PyCubed-Mini/OpenMV_Camera/Software/images/Calibration/Calibrated Pics/Space Shuttle.jpg

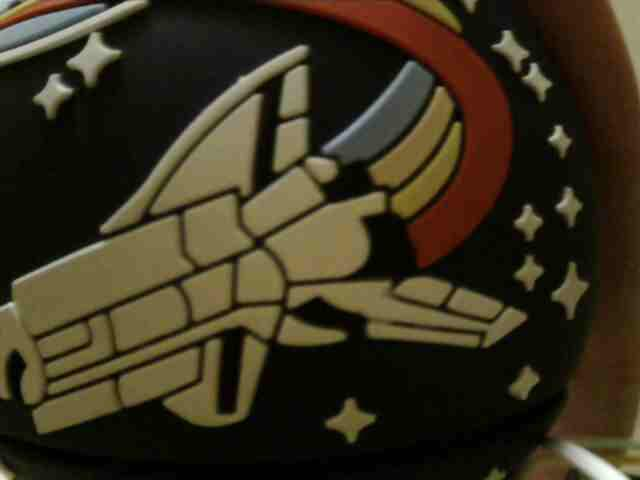
Software/images/Calibration/Calibrated Pics/Space Shuttle.jpg
