PyCubed-Mini/OpenMV_Camera/Software/images/Calibration/VGA Snapshots/True Calibration/+3.jpg

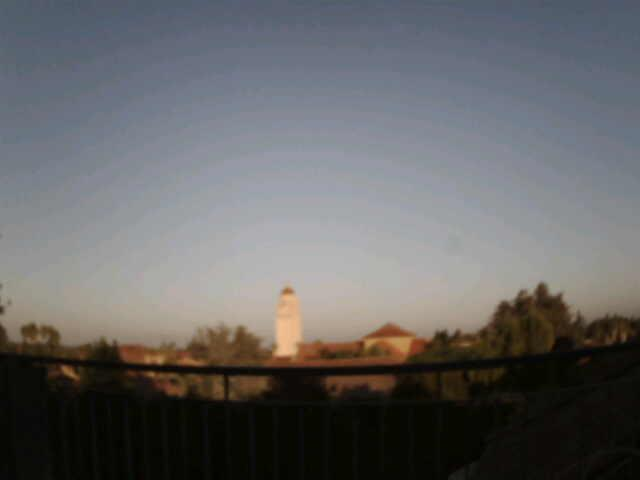
Software/images/Calibration/VGA Snapshots/True Calibration/+3.jpg
