PyCubed-Mini/OpenMV_Camera/README.md

# OpenMV_Camera
Modified version of the OpenMV camera module

The most recent board files are in [!OpenMV_Master_Design/openmv4_cam_v3](https://github.com/PyCubed-Mini/OpenMV_Camera/tree/master/!OpenMV_Master_Design/openmv4_cam_v3)
