PyCubed-Mini/OpenMV_Camera/Software/Electrical Configuration/README.txt

This folder contains images that should be helpful for replicating the electrical configuration used to connect the OpenMV camera, the Feather M4 Express MCU, and the mSD card breakout board.
