PyCubed-Mini/OpenMV_Camera/Software/trinket_m0_backup/README.txt

This is a backup of the default Trinket M0 software package,
to be used if the board needs to be reset.
