PyCubed-Mini/OpenMV_Camera/Software/images/Time Delay Trade/README.txt

The camera is one of the most power-hungry elements of the Qube.  In that regard, it would be ideal to minimize the amount of time for which it is active.  However, the camera requires time to prepare to take an image ("open its eyes") and to process the image.  Several trade studies must be conducted to find the optimal amount of time the camera should be on while still being able to take and process high-quality images.
