PyCubed-Mini/OpenMV_Camera/Software/images/Less Important Studies/Focus Play/README.txt

This folder contains some preliminary focus experiments.  In these, the camera focus is adjusted manually to extreme and average positions to help the user acquire a "feel" for the camera focus.
