PyCubed-Mini/OpenMV_Camera/MV3 vs MV4/MV3_diff.PNG

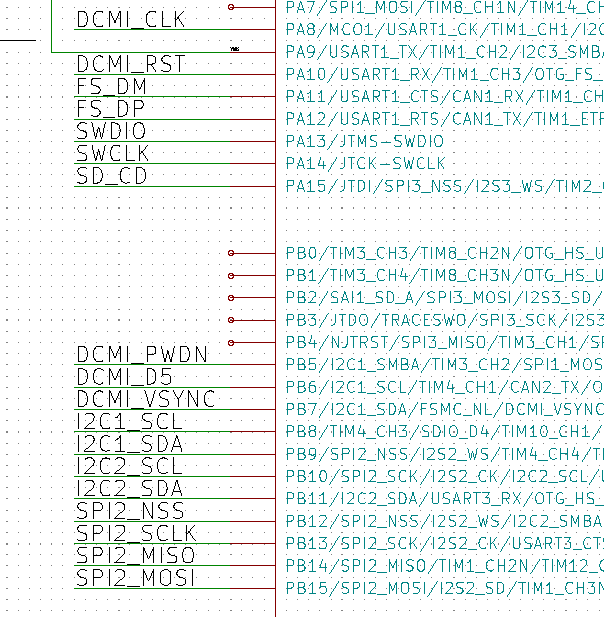
MV3 vs MV4/MV3_diff.PNG
