PyCubed-Mini/OpenMV_Camera/MV3 vs MV4/MV3_sensor_schem.PNG

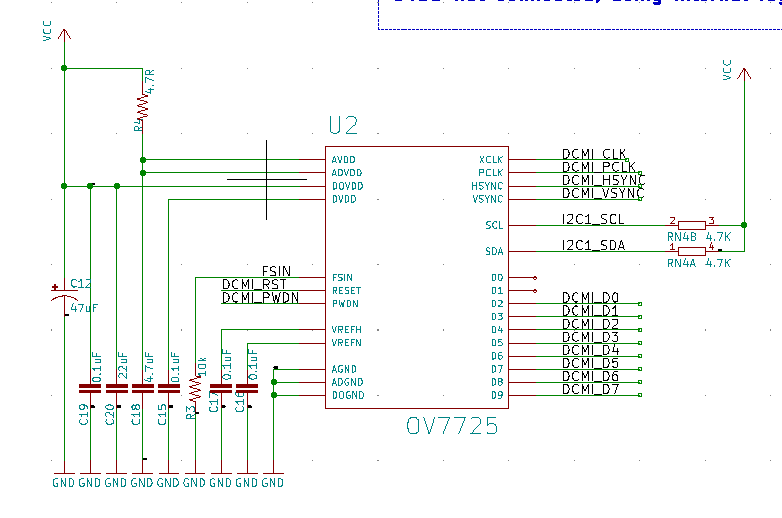
MV3 vs MV4/MV3_sensor_schem.PNG
