PyCubed-Mini/OpenMV_Camera/MV3 vs MV4/MV4_sensor_connector.PNG

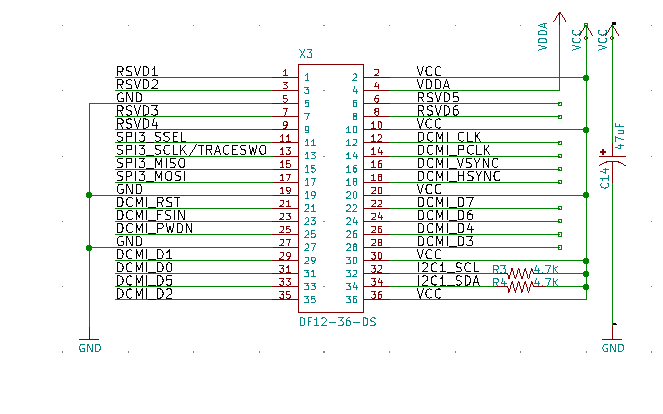
MV3 vs MV4/MV4_sensor_connector.PNG
