PyCubed-Mini/OpenMV_Camera/Software/Electrical Configuration/20191205_142945.jpg

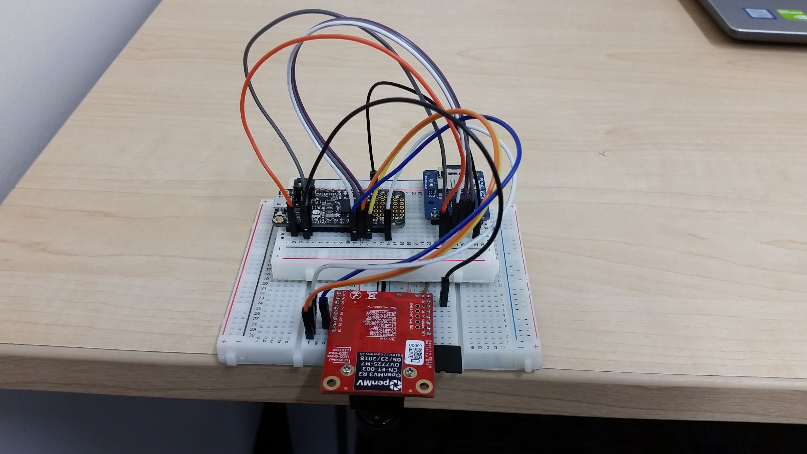
Software/Electrical Configuration/20191205_142945.jpg
