PyCubed-Mini/OpenMV_Camera/Software/Electrical Configuration/20191205_143001.jpg

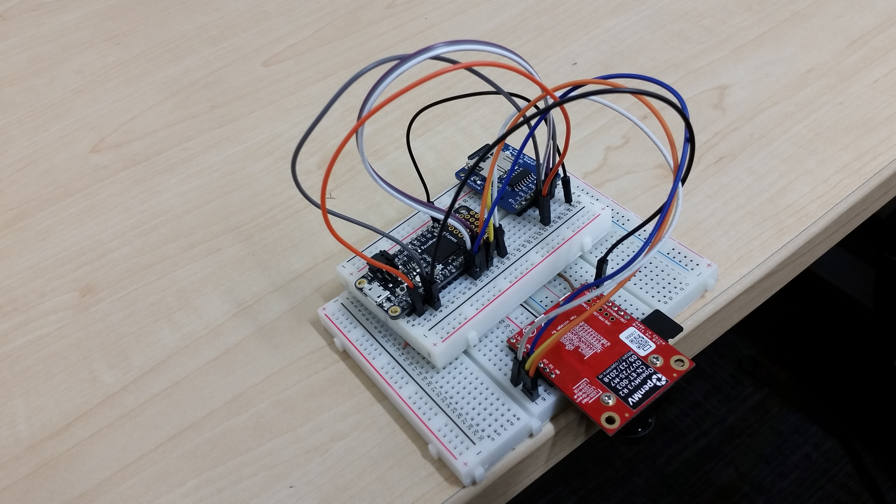
Software/Electrical Configuration/20191205_143001.jpg
