PyCubed-Mini/OpenMV_Camera/Software/Electrical Configuration/20191205_143034.jpg

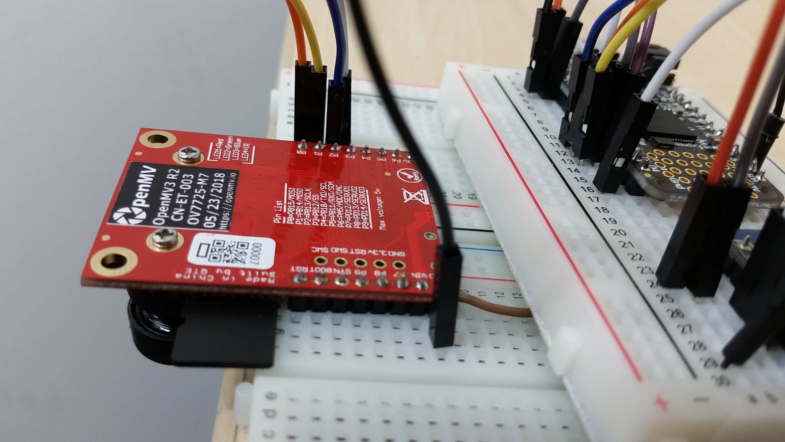
Software/Electrical Configuration/20191205_143034.jpg
