PyCubed-Mini/OpenMV_Camera/Software/Electrical Configuration/20191205_143103.jpg

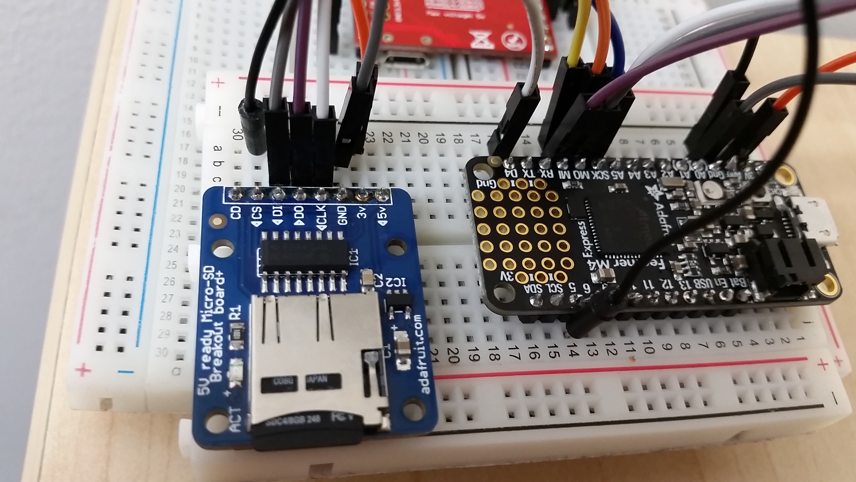
Software/Electrical Configuration/20191205_143103.jpg
