PyCubed-Mini/OpenMV_Camera/Software/image_compression_svd/picture_out_compression30_telephoto_1.jpeg

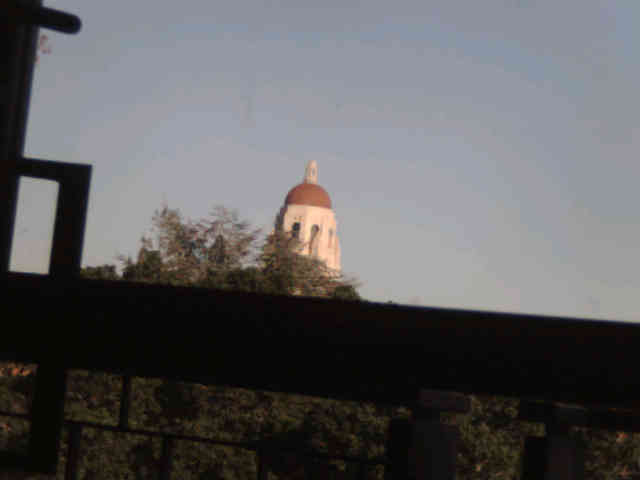
Software/image_compression_svd/picture_out_compression30_telephoto_1.jpeg
