PyCubed-Mini/OpenMV_Camera/Software/images/camera_lens_comparison/standard_lens/picture_out_compression30_standard_1.png

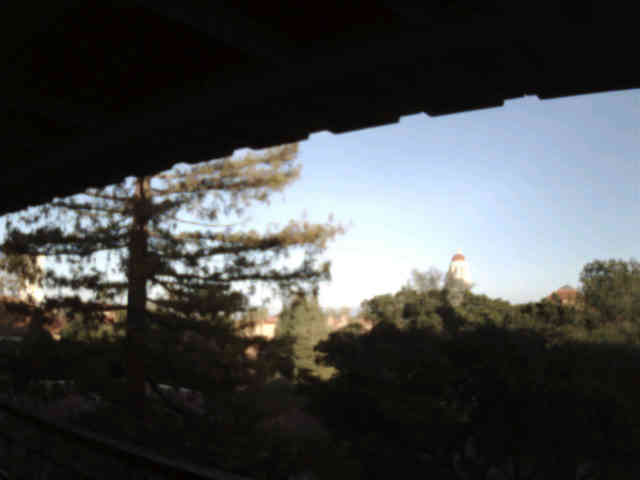
Software/images/camera_lens_comparison/standard_lens/picture_out_compression30_standard_1.png
