PyCubed-Mini/OpenMV_Camera/Software/images/camera_lens_comparison/telephoto_lens/picture_out_compression70_telephoto_2.png

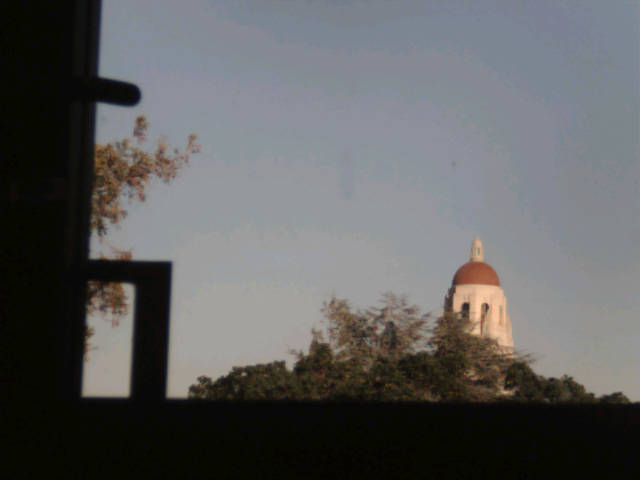
Software/images/camera_lens_comparison/telephoto_lens/picture_out_compression70_telephoto_2.png
