PyCubed-Mini/OpenMV_Camera/Software/images/Compression Trade/Compression Trade 3 (Main)/quality_90.jpg

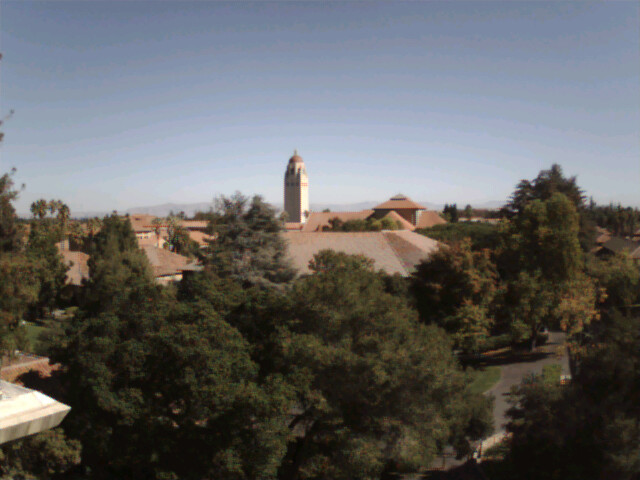
Software/images/Compression Trade/Compression Trade 3 (Main)/quality_90.jpg
