PyCubed-Mini/OpenMV_Camera/Software/images/Compression Trade/Compression Trade 4/quality_25.jpg

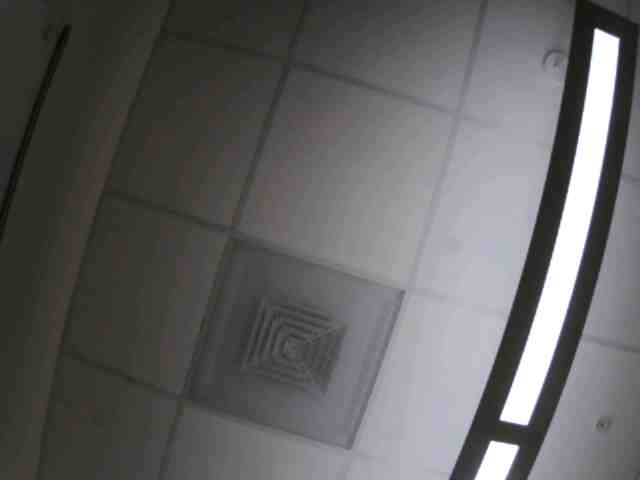
Software/images/Compression Trade/Compression Trade 4/quality_25.jpg
