PyCubed-Mini/OpenMV_Camera/Software/images/focustesting/picture_2.png

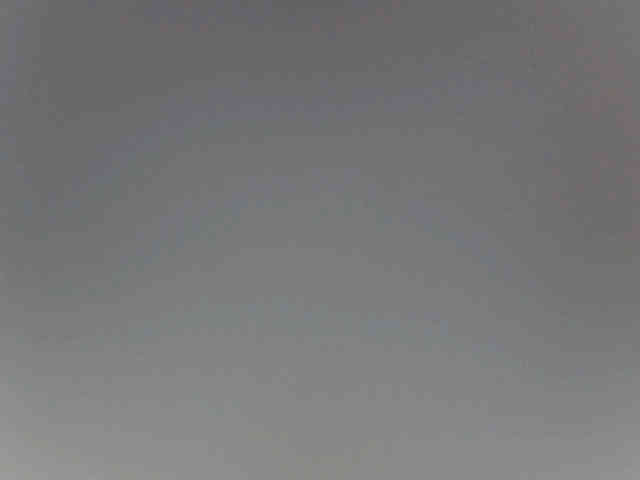
Software/images/focustesting/picture_2.png
