PyCubed-Mini/OpenMV_Camera/Software/images/focustesting/picture_3.png

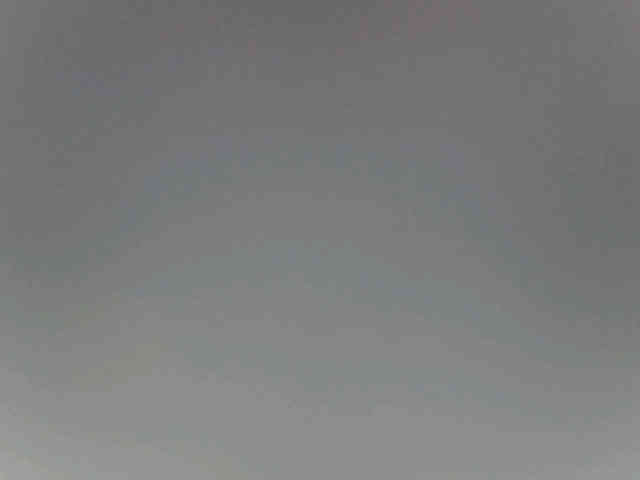
Software/images/focustesting/picture_3.png
