PyCubed-Mini/OpenMV_Camera/Software/images/focustesting/picture_4.png

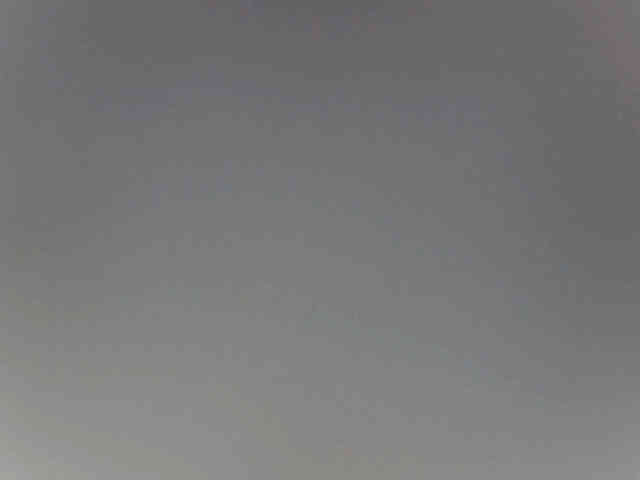
Software/images/focustesting/picture_4.png
