PyCubed-Mini/OpenMV_Camera/Software/images/focustesting/picture_5.png

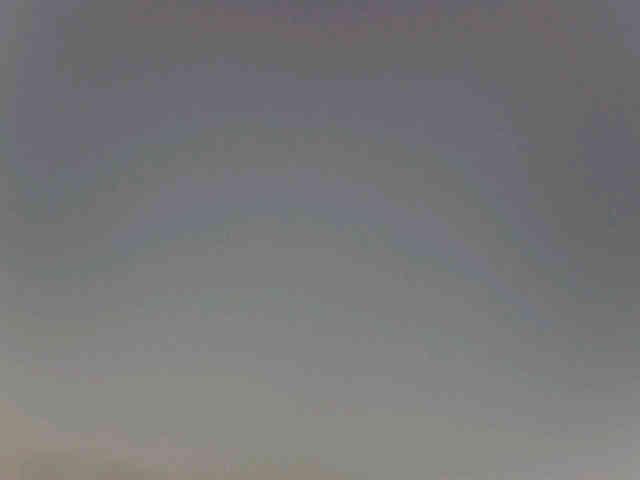
Software/images/focustesting/picture_5.png
