PyCubed-Mini/OpenMV_Camera/Software/images/focustesting/picture_6.png

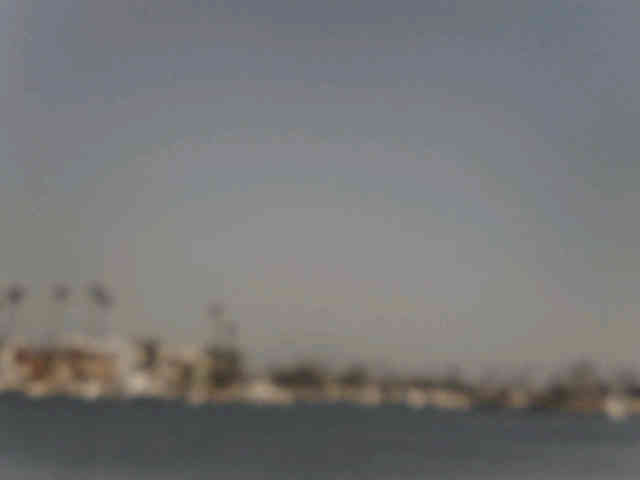
Software/images/focustesting/picture_6.png
