PyCubed-Mini/OpenMV_Camera/Software/images/focustesting/picture_7.png

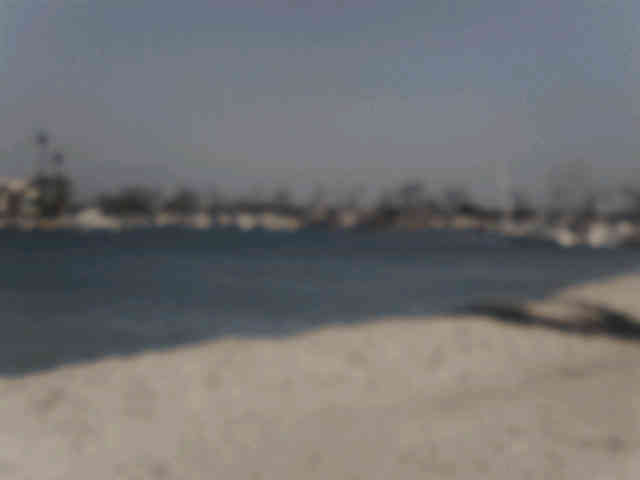
Software/images/focustesting/picture_7.png
