PyCubed-Mini/OpenMV_Camera/Software/images/focustesting/picture_9.png

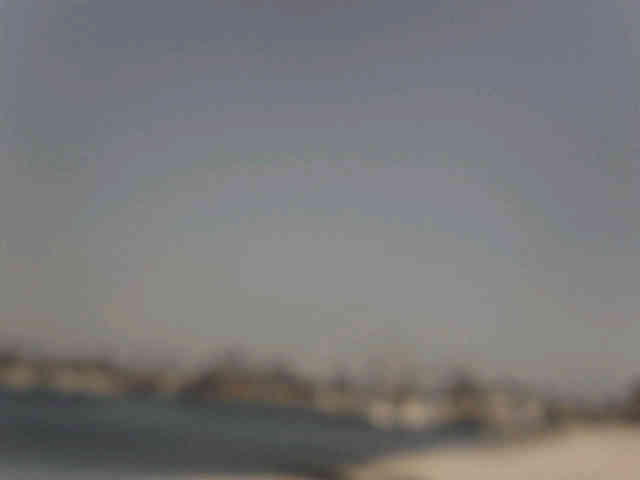
Software/images/focustesting/picture_9.png
