PyCubed-Mini/OpenMV_Camera/Software/images/focustesting/picture_10.png

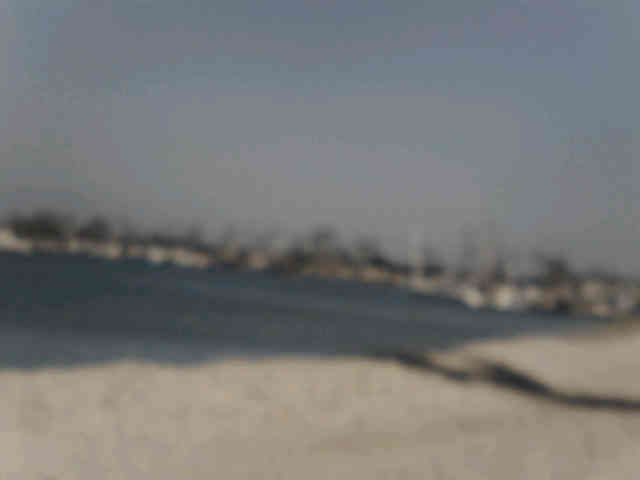
Software/images/focustesting/picture_10.png
