PyCubed-Mini/OpenMV_Camera/Software/images/focustesting/picture_11.png

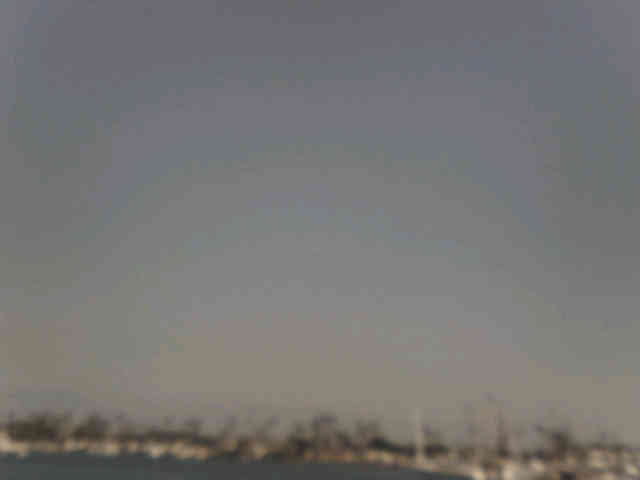
Software/images/focustesting/picture_11.png
