PyCubed-Mini/OpenMV_Camera/Software/images/focustesting/picture_13.png

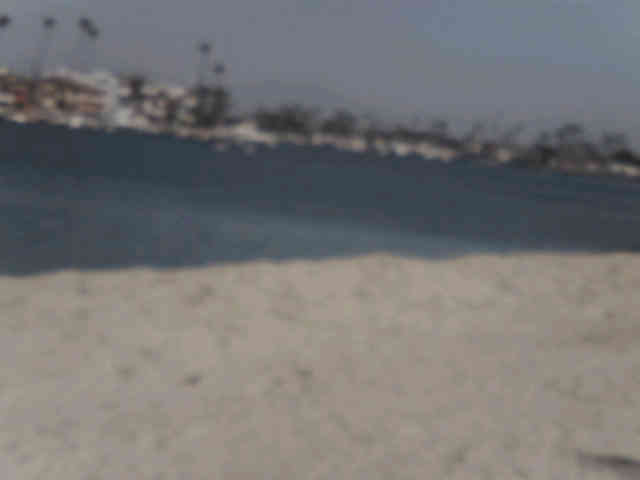
Software/images/focustesting/picture_13.png
