PyCubed-Mini/OpenMV_Camera/Software/images/focustesting/picture_14.png

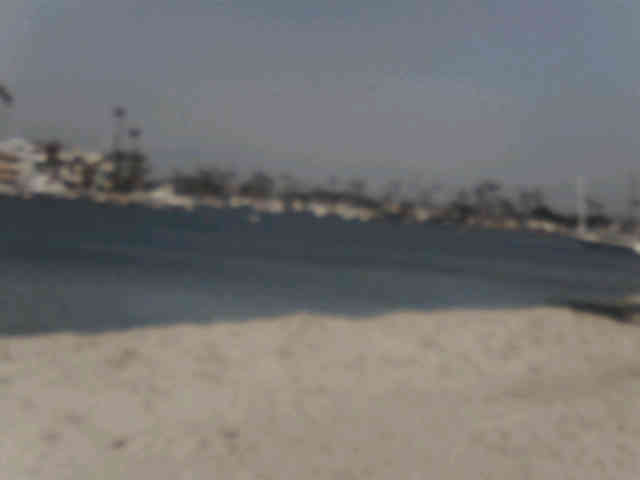
Software/images/focustesting/picture_14.png
