PyCubed-Mini/OpenMV_Camera/Software/images/focustesting/picture_15.png

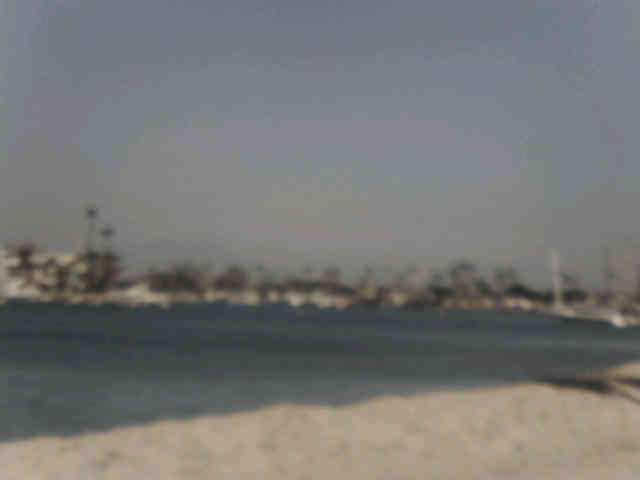
Software/images/focustesting/picture_15.png
