PyCubed-Mini/OpenMV_Camera/Software/images/focustesting/picture_16.png

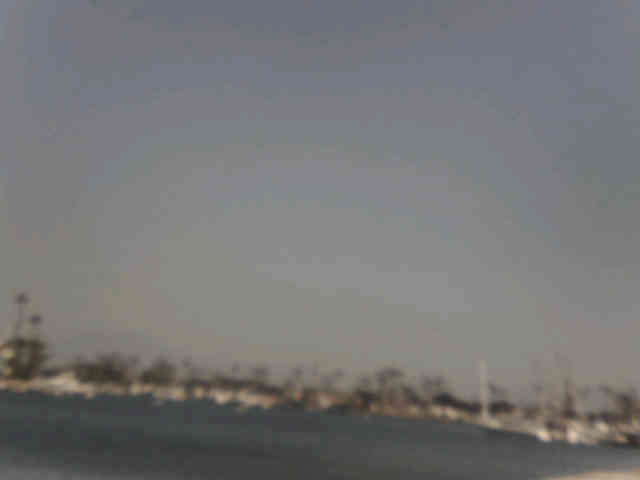
Software/images/focustesting/picture_16.png
