PyCubed-Mini/OpenMV_Camera/Software/images/focustesting/picture_17.png

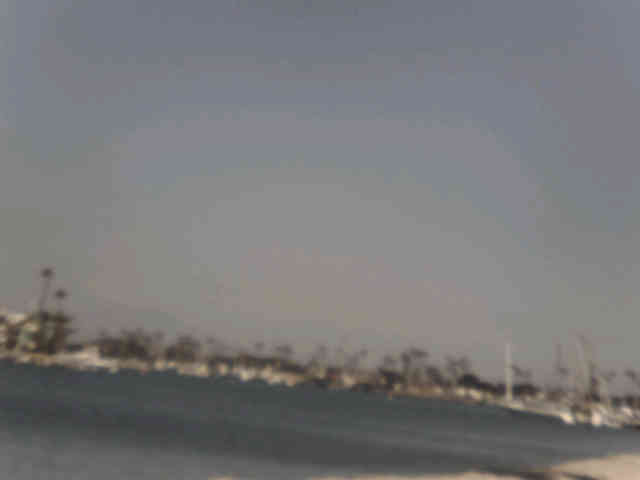
Software/images/focustesting/picture_17.png
