PyCubed-Mini/OpenMV_Camera/Software/images/focustesting/picture_18.png

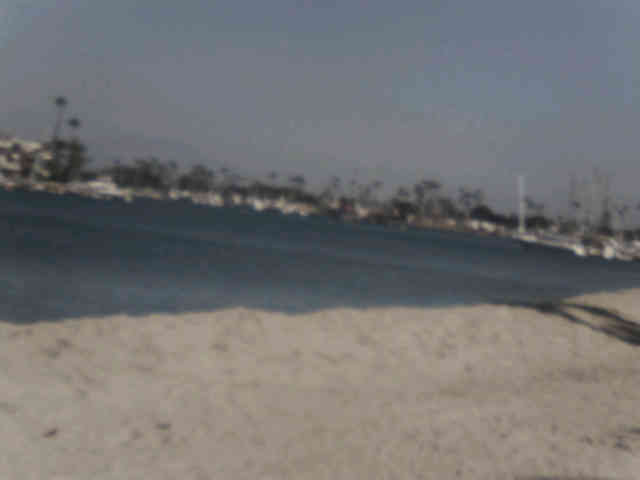
Software/images/focustesting/picture_18.png
