PyCubed-Mini/OpenMV_Camera/Software/images/focustesting/picture_19.png

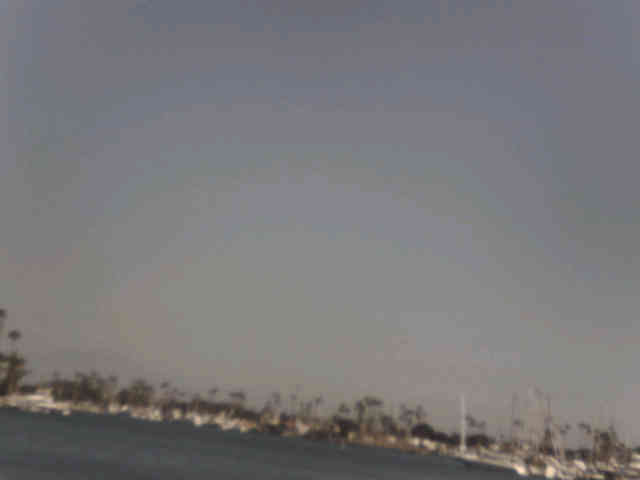
Software/images/focustesting/picture_19.png
