PyCubed-Mini/OpenMV_Camera/Software/images/focustesting/picture_20.png

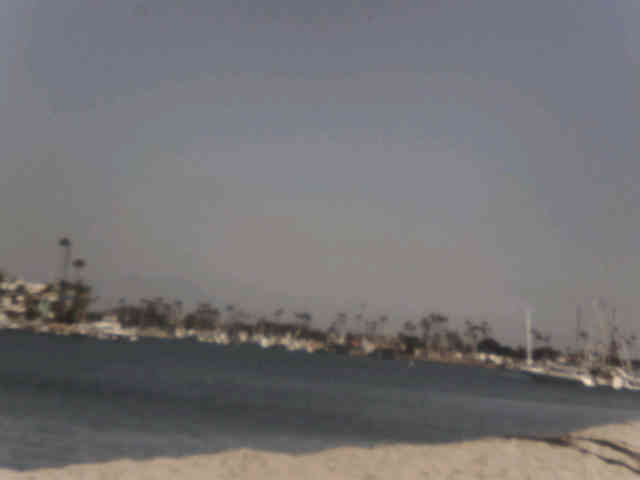
Software/images/focustesting/picture_20.png
