PyCubed-Mini/OpenMV_Camera/Software/images/focustesting/picture_21.png

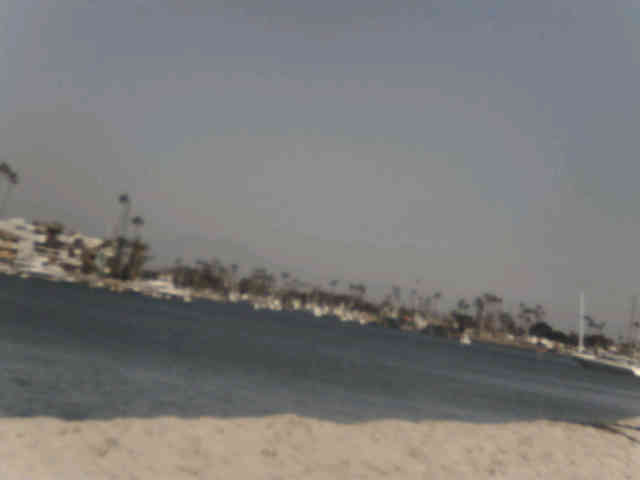
Software/images/focustesting/picture_21.png
