PyCubed-Mini/OpenMV_Camera/Software/images/focustesting/picture_22.png

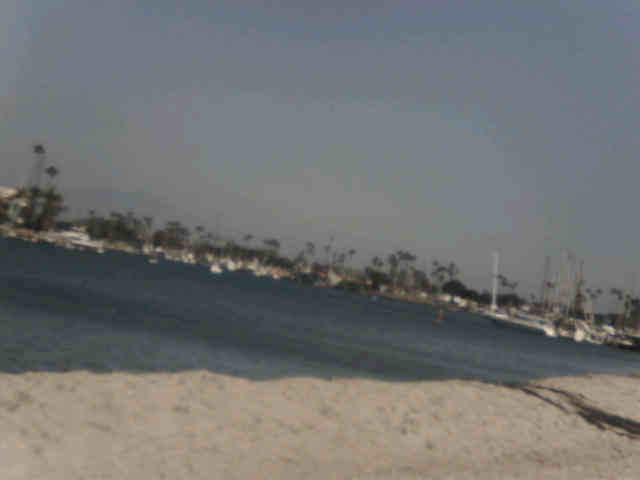
Software/images/focustesting/picture_22.png
