PyCubed-Mini/OpenMV_Camera/Software/images/focustesting/picture_23.png

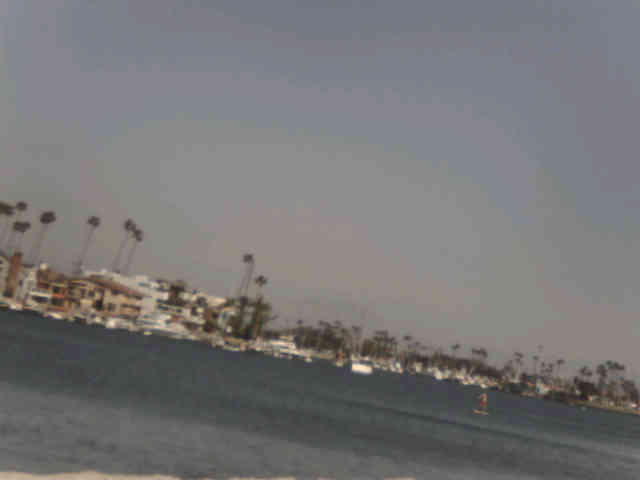
Software/images/focustesting/picture_23.png
