PyCubed-Mini/OpenMV_Camera/Software/images/focustesting/picture_24.png

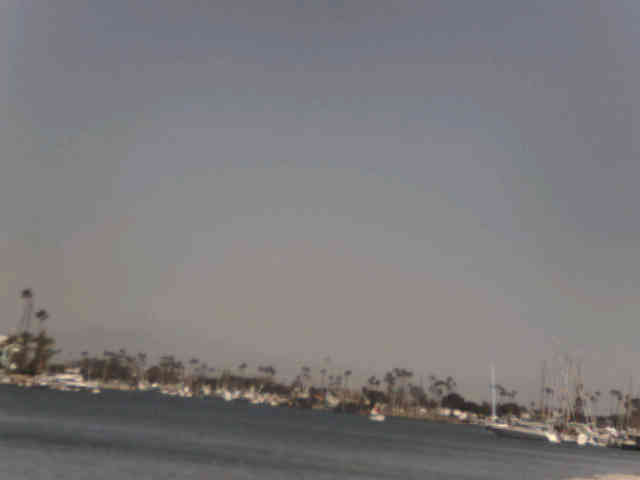
Software/images/focustesting/picture_24.png
