PyCubed-Mini/OpenMV_Camera/Software/images/focustesting/picture_25.png

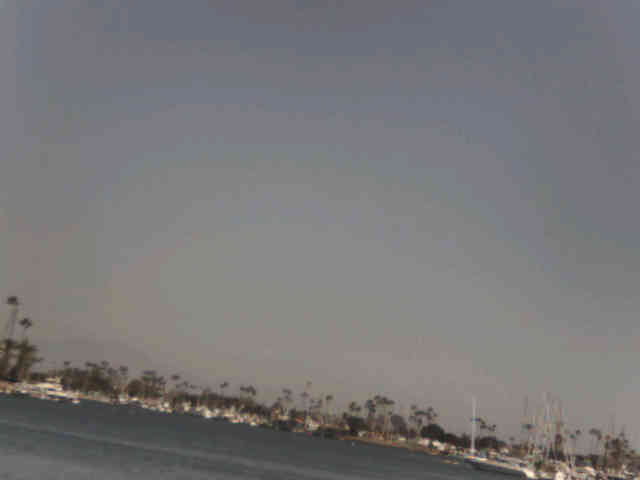
Software/images/focustesting/picture_25.png
