PyCubed-Mini/OpenMV_Camera/Software/images/focustesting/picture_26.png

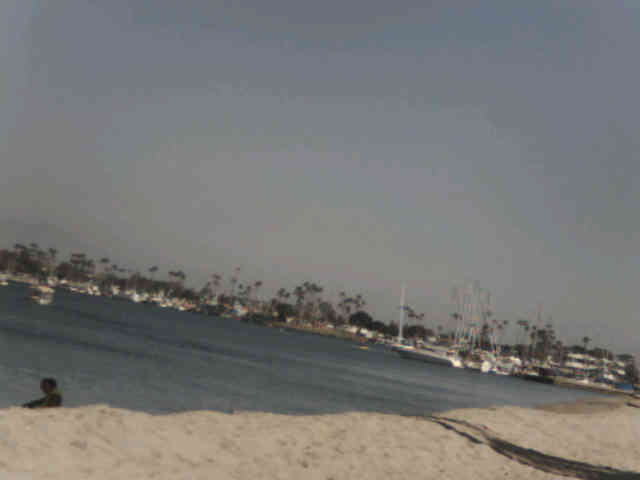
Software/images/focustesting/picture_26.png
