PyCubed-Mini/OpenMV_Camera/Software/images/focustesting/picture_27.png

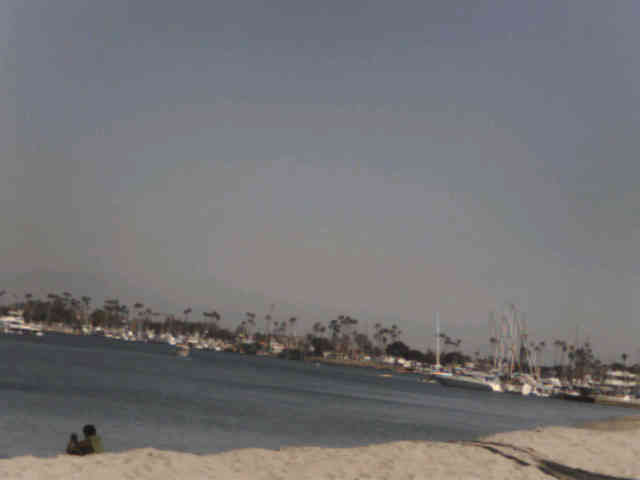
Software/images/focustesting/picture_27.png
