PyCubed-Mini/OpenMV_Camera/Software/images/focustesting/picture_28.png

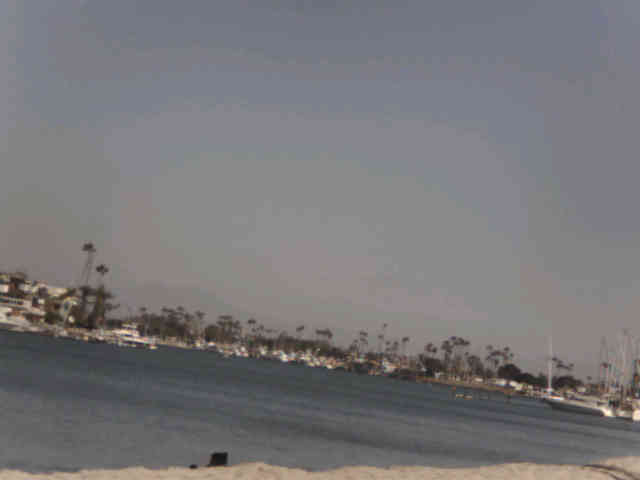
Software/images/focustesting/picture_28.png
