PyCubed-Mini/OpenMV_Camera/Software/images/focustesting/picture_29.png

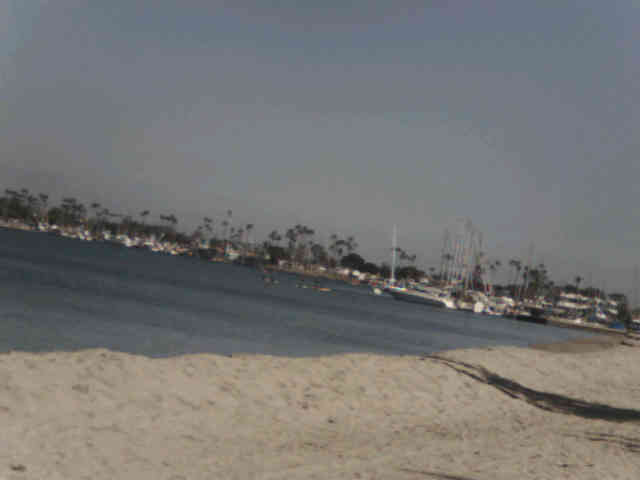
Software/images/focustesting/picture_29.png
