PyCubed-Mini/OpenMV_Camera/Software/images/focustesting/picture_30.png

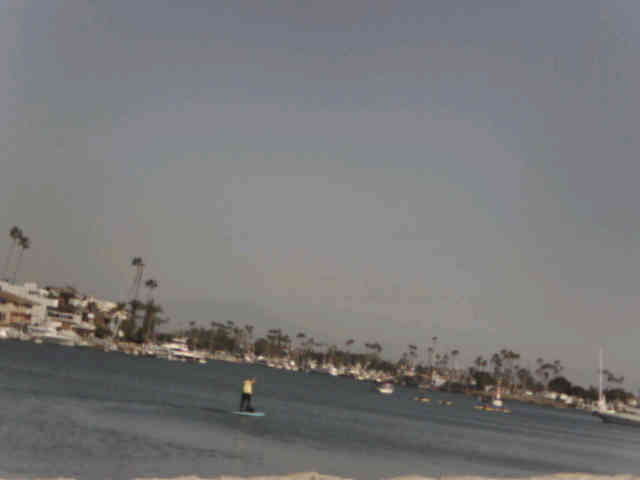
Software/images/focustesting/picture_30.png
