PyCubed-Mini/OpenMV_Camera/Software/images/focustesting/picture_31.png

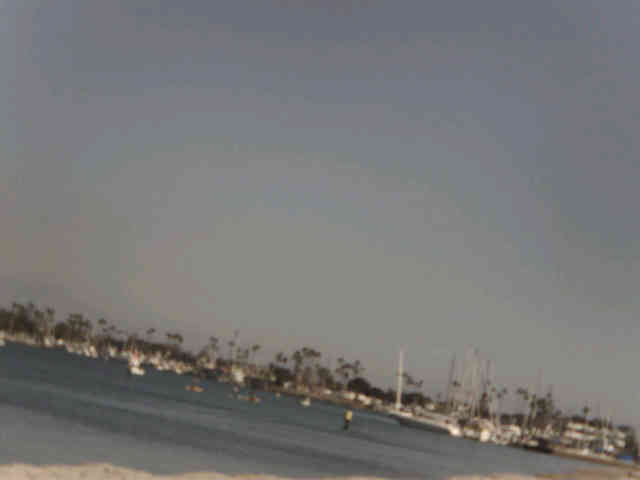
Software/images/focustesting/picture_31.png
