PyCubed-Mini/OpenMV_Camera/Software/images/Less Important Studies/Focus Play/All the way back.jpg

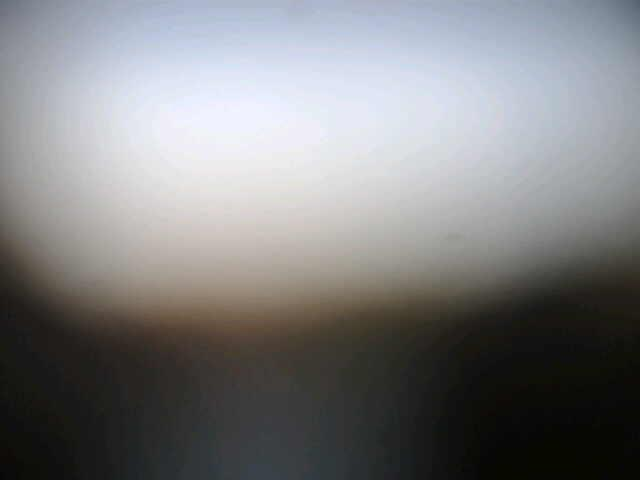
Software/images/Less Important Studies/Focus Play/All the way back.jpg
