PyCubed-Mini/OpenMV_Camera/Software/images/Less Important Studies/Focus Play/Max Focus.jpg

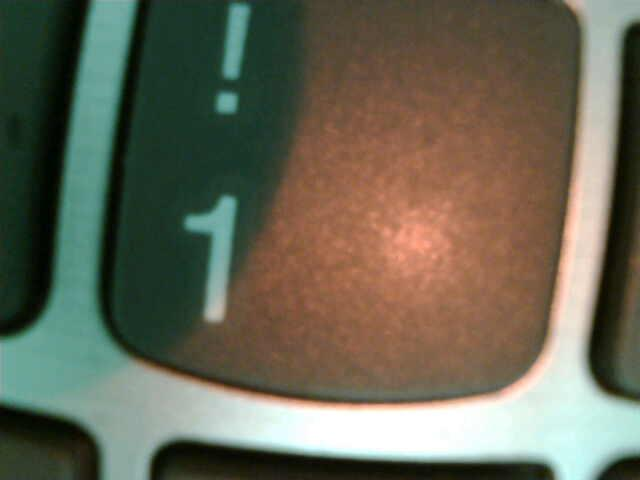
Software/images/Less Important Studies/Focus Play/Max Focus.jpg
