PyCubed-Mini/OpenMV_Camera/Software/images/Less Important Studies/Focus Play/Mid Focus.jpg

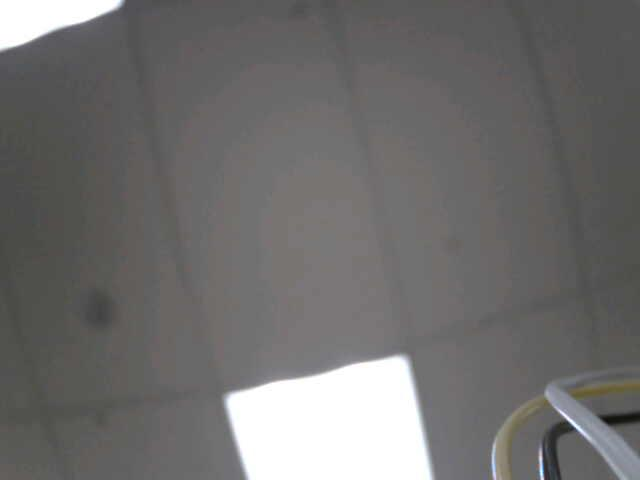
Software/images/Less Important Studies/Focus Play/Mid Focus.jpg
