PyCubed-Mini/OpenMV_Camera/Software/images/Less Important Studies/Focus Play/Min Focus.jpg

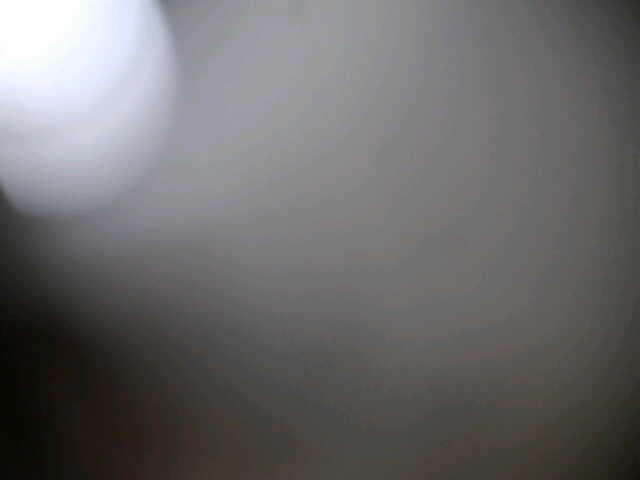
Software/images/Less Important Studies/Focus Play/Min Focus.jpg
