PyCubed-Mini/OpenMV_Camera/Software/images/Less Important Studies/QVGA Suffix Trade Study/QVGA_suffix.bmp

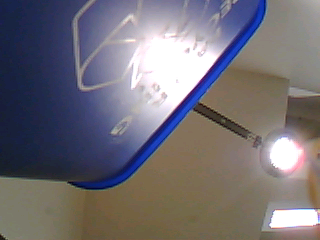
Software/images/Less Important Studies/QVGA Suffix Trade Study/QVGA_suffix.bmp
