PyCubed-Mini/OpenMV_Camera/Software/images/Time Delay Trade/Preparation Delay Trade/delay_0500_ms.jpg

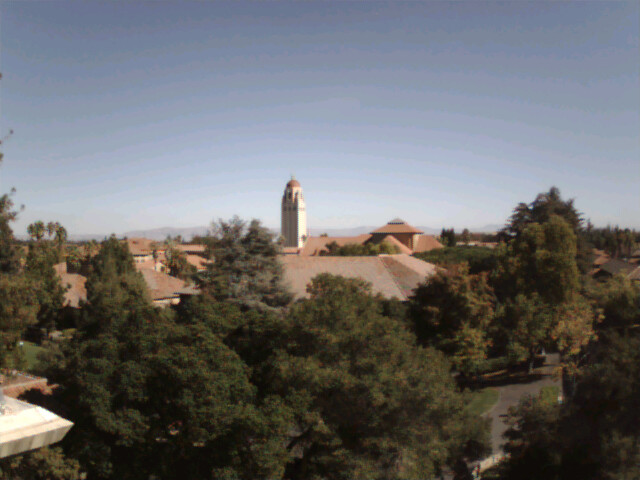
Software/images/Time Delay Trade/Preparation Delay Trade/delay_0500_ms.jpg
