PyCubed-Mini/OpenMV_Camera/Software/images/Time Delay Trade/Preparation Delay Trade/delay_3000_ms.jpg

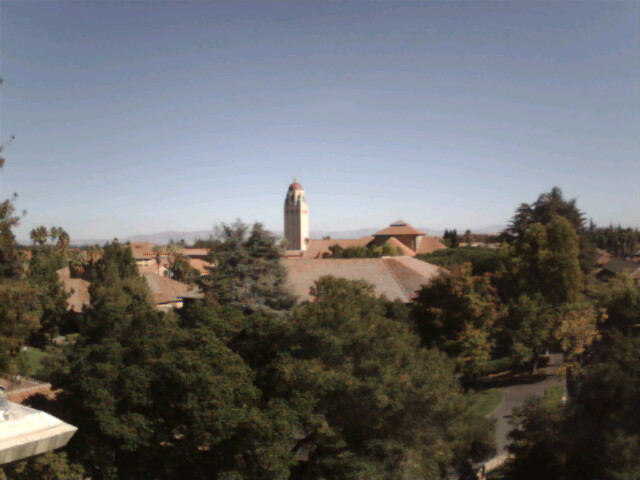
Software/images/Time Delay Trade/Preparation Delay Trade/delay_3000_ms.jpg
