PyCubed-Mini/OpenMV_Camera/Software/images/Time Delay Trade/Processing Delay Trade/process_0010_ms.jpg

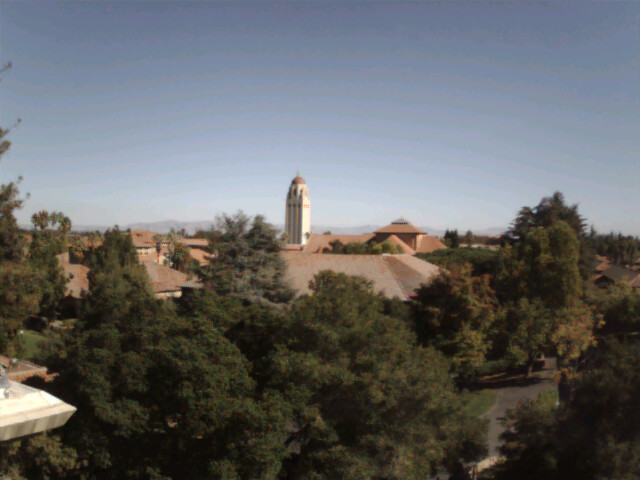
Software/images/Time Delay Trade/Processing Delay Trade/process_0010_ms.jpg
