PyCubed-Mini/OpenMV_Camera/Software/images/Time Delay Trade/Processing Delay Trade/process_4000_ms.jpg

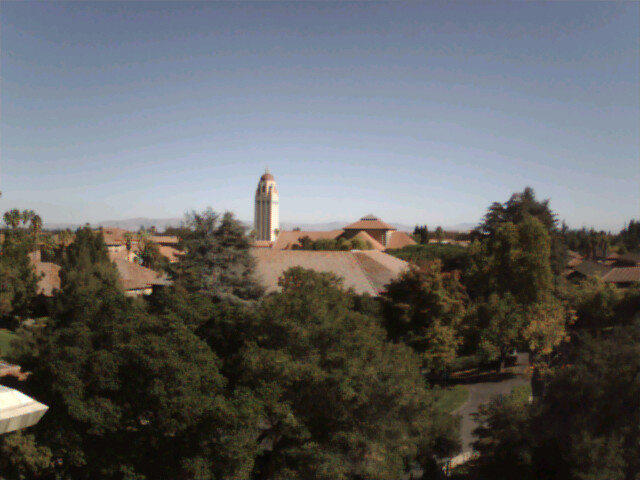
Software/images/Time Delay Trade/Processing Delay Trade/process_4000_ms.jpg
