PyCubed-Mini/OpenMV_Camera/openmv-official-repo-for-reference/openmv2/BOM.ods

Sheet: OMV
BOM
Part | Qty | PartNo | Notes/URLs
PCB | 1 | MacroFab
CAP CER 12PF 10V 5% 0603 | 2 | 1276-1254-1-ND
CAP CER 0.1UF 10V 10% X7R 0603 | 12 | 1276-1946-1-ND
CAP CER 1UF 10V 10% X7R 0603 | 1
CAP CER 2.2UF 10V 10% X5R 0603 | 2 | 311-1451-1-ND
CAP CER 4.7UF 10V 10% X5R 0603 | 5 | 311-1455-1-ND
CAP CER 22UF 10V 20% X7R 0805 | 2 | 1276-2910-2-ND | uSD cap 22uF-47uF
CAP TANT 47UF 6.3V 20% 1206 | 1 | 478-9046-1-ND | 10uF-47uF 60 mOhms to 1.5 Ohms
RES 10 OHM 1/10W 1% 0603 SMD | 1 | 311-10.0HRCT-ND
RES 10K OHM 1/10W 5% 0603 SMD | 2 | 311-10KGRCT-ND
RES ARRAY 10K OHM 4 RES 1206 | 2 | YC164J-10KCT-ND
RES ARRAY 10K OHM 2 RES 0606 | 1 | 742C043103JPCT-ND
RES ARRAY 220 OHM 4 RES 1206 | 1 | TC164J-220CT-ND | 220R-330R
FERRITE BEAD 180 OHM@100MHz 0603 | 3 | 445-5220-1-ND
DIODE SCHOTTKY 20V 500mA Dual | 1 | 568-6500-1-ND
USD W/DETECT | 1 | WM9731CT-ND
IC REG LDO 3.3V 500mA | 1 | BD33IA5WEFJ-E2CT-ND
IC REG LDO 2.8V 150mA TSOT23-5 | 1 | ADP121-AUJZ28R7CT-ND | MIN: 2.5v TYP: 2.8v
IC ARM 180MHz 1MB FLASH | 1 | 511-STM32F427VGT6 | STM32F427VIT6 (2MB Flash)
CONN USB MICRO B | 1 | 609-4613-1-ND
CRYSTAL 12MHz 12PF SMD 2.5x2.0 | 1 | 887-1831-1-ND | Load Cap CL1/CL2 10pF-15PF
LED RGB 4-PLCC | 1 | CLVBA-FKA-CAEDH8BBB7A363TR-ND
LED EMITTER IR 940NM | 2 | 475-2870-ND
MOSFET N-CH 50V 220MA SOT-23 | 1 | BSS138CT-ND
OV2640 BGA CSP2 | 1
LENS + MOUNT M12/20MM 16x16 | 1
Long 8-pin Headers | 2

Sheet: LCD
BOM
Part | Qty | PartNo | Notes/URLs
PCB | 1 | MacroFab
CAP CER 0.1UF 10V 10% X7R 0603 | 1 | 1276-1946-1-ND
RES 10K OHM 1/10W 5% 0603 SMD | 2 | 311-10KGRCT-ND
RES 2.2K OHM 1/10W 5% 0603 SMD | 1 | CRCW06032K20JNEA
RES 10 OHM 1/10W 1% 0603 SMD | 1 | 311-10.0HRCT-ND
CAP CER 10UF 10V 10% X7R 0805 | 1 | 445-6857-1-ND
MOSFET N-CH 50V 220MA SOT-23 | 1 | BSS138CT-ND
CONN FMALE 8POS .1" SMD GOLD | 2 | S5639-ND
FERRITE BEAD 180 OHM@100MHz 0603 | 1 | 445-5220-1-ND
LCD 1.8" Serial TFT (128x160) | 1 | JD-T1800 (http://www.ebay.com/itm/400815279295?_trksid=p2055119.m1438.l2649&ssPageName=STRK%3AMEBIDX%3AIT)
Long 8-pin Headers | 2

Sheet: Thermal
BOM
Part | Qty | PartNo | Notes/URLs
PCB | 1 | MacroFab
CAP CER 0.1UF 10V 10% X7R 0603 | 1 | 1276-1946-1-ND
RES 10K OHM 1/10W 5% 0603 SMD | 2 | 311-10KGRCT-ND
CAP CER 4.7UF 10V 10% X5R 0603 | 2 | 587-3416-1-ND
IC REG LDO 2.5V 150mA TSOT23-5 | 1 | ADP121-AUJZ25R7CT-ND | MIN: 2.5v TYP: 2.6v MAX:2.7v
IC IR ARRAY TEMP SENS TO-39 | 1 | MLX90621ESF-BAB-000-TU-ND
Long 8-pin Headers | 2
