PyCubed-Mini/OpenMV_Camera/!OpenMV_Master_Design/Board Outline.dxf

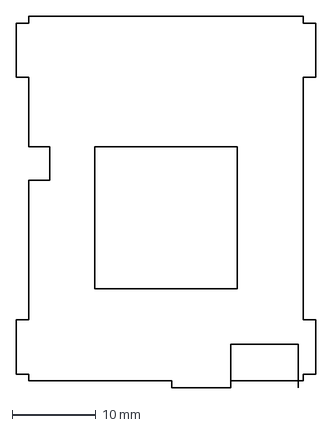
[picture p71: CAD file, 2019-11-17]
!OpenMV_Master_Design/Board Outline.dxf
35.8 x 44.4 mm
