PyCubed-Mini/OpenMV_Camera/!OpenMV_Master_Design/openmv4_cam_v3/base.step

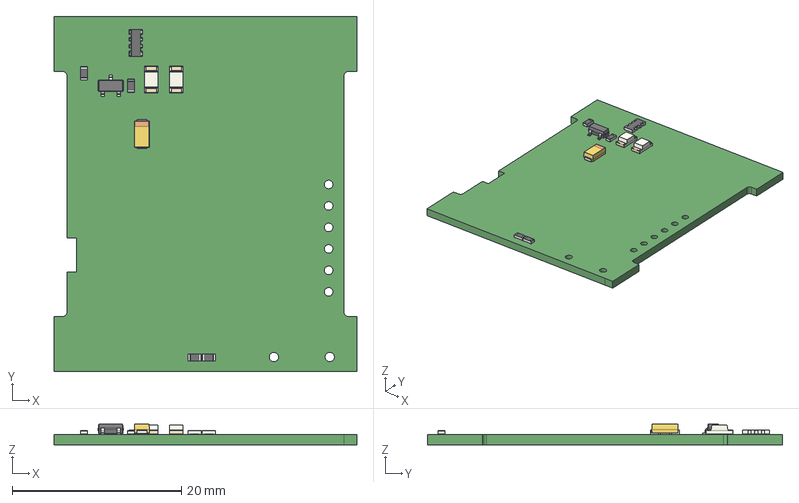
[picture p72: CAD file, 2019-12-12]
!OpenMV_Master_Design/openmv4_cam_v3/base.step
35.8 x 42.0 x 2.45 mm
