PyCubed-Mini/OpenMV_Camera/openmv-official-repo-for-reference/cad/case-r2.stl

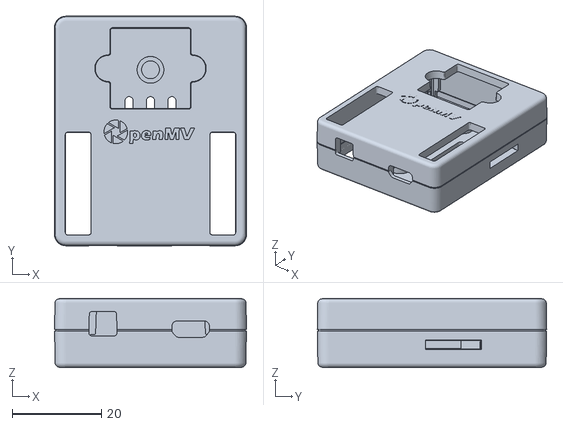
[picture p73: CAD file, 2019-10-06]
openmv-official-repo-for-reference/cad/case-r2.stl
43.0 x 51.4 x 15.5
