PyCubed-Mini/OpenMV_Camera/openmv-official-repo-for-reference/cad/case-r1.stl

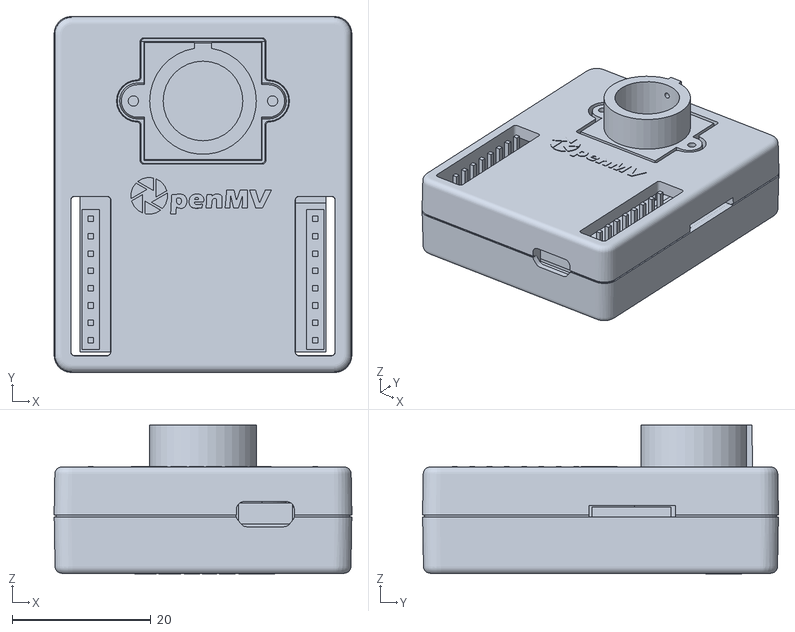
[picture p74: CAD file, 2019-10-06]
openmv-official-repo-for-reference/cad/case-r1.stl
43.0 x 51.4 x 21.5
