PyCubed-Mini/OpenMV_Camera/!OpenMV_Master_Design/Custom_CAD_Components/473521001_microSD.stp

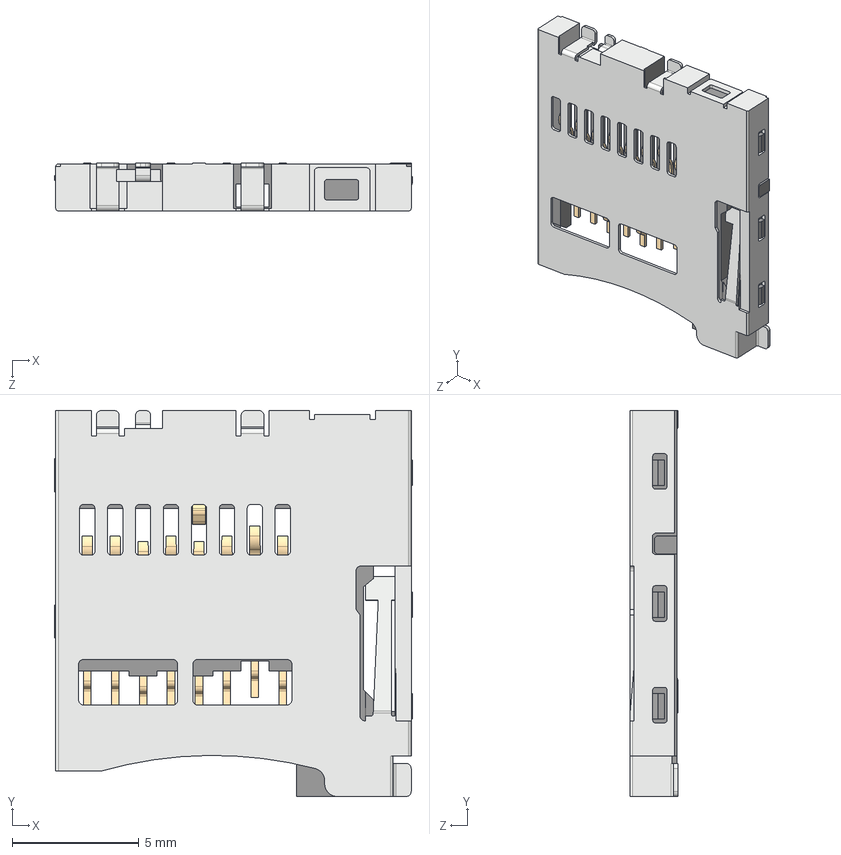
[picture p75: CAD file, 2019-11-01]
!OpenMV_Master_Design/Custom_CAD_Components/473521001_microSD.stp
14.1 x 15.2 x 1.88 mm
