PyCubed-Mini/OpenMV_Camera/Software/images/Time Delay Trade/Manual Blindness Trade/blindness_2500_ms.jpg

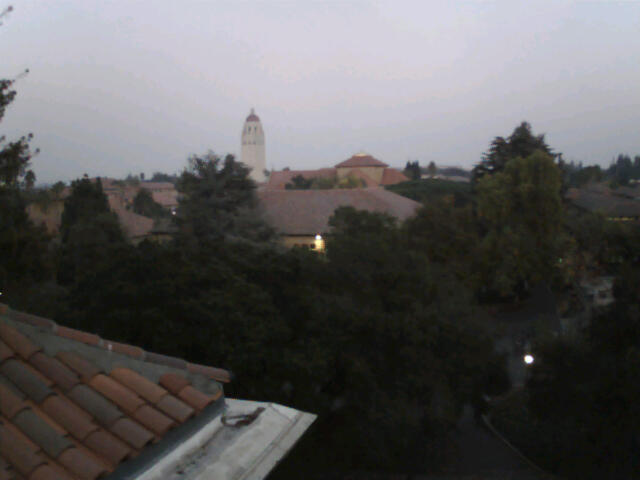
Software/images/Time Delay Trade/Manual Blindness Trade/blindness_2500_ms.jpg
