PyCubed-Mini/OpenMV_Camera/Software/images/Less Important Studies/Save to SD Experiments/README.txt

This chronicles each stage of the suffering process involved in getting the camera to take a picture and send it to the MCU so that the MCU could save it to the SD card.  Provided for reference.
