PyCubed-Mini/OpenMV_Camera/Software/images/Calibration/Calibrated Pics/Birds.jpg

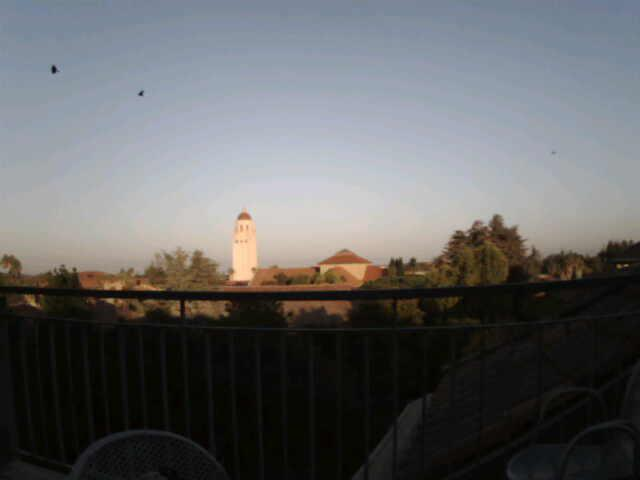
Software/images/Calibration/Calibrated Pics/Birds.jpg
