PyCubed-Mini/OpenMV_Camera/Software/images/Calibration/Calibrated Pics/Calibrated.jpg

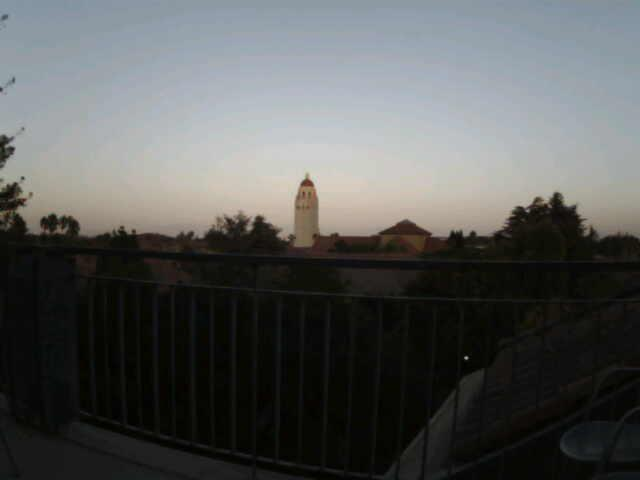
Software/images/Calibration/Calibrated Pics/Calibrated.jpg
