PyCubed-Mini/OpenMV_Camera/Software/images/Calibration/Calibrated Pics/Compare Against.jpg

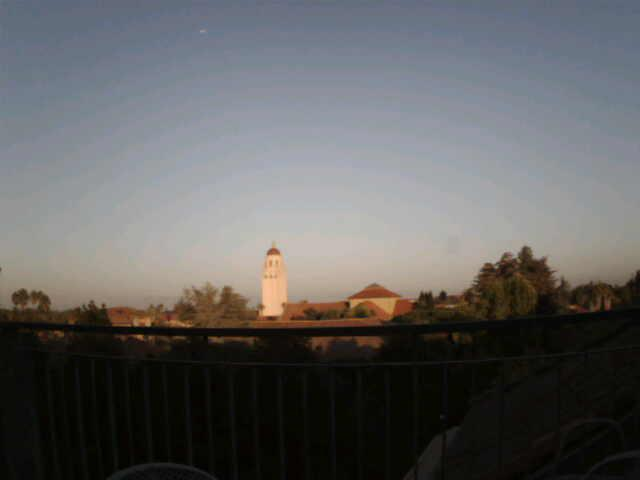
Software/images/Calibration/Calibrated Pics/Compare Against.jpg
