PyCubed-Mini/OpenMV_Camera/Software/images/Calibration/Calibrated Pics/Excellente.jpg

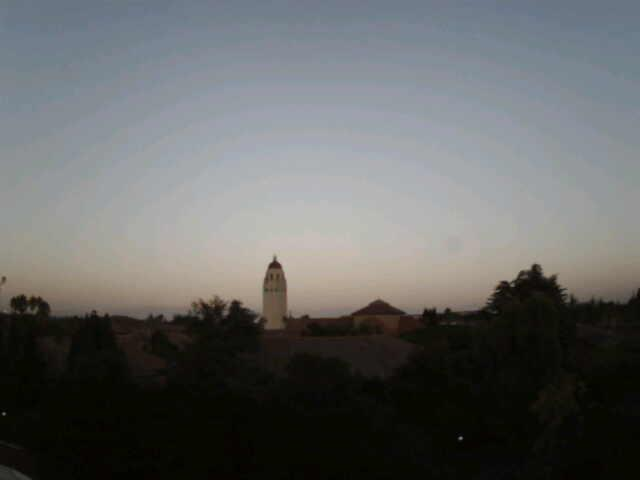
Software/images/Calibration/Calibrated Pics/Excellente.jpg
