PyCubed-Mini/OpenMV_Camera/Software/images/Calibration/Calibrated Pics/Good.jpg

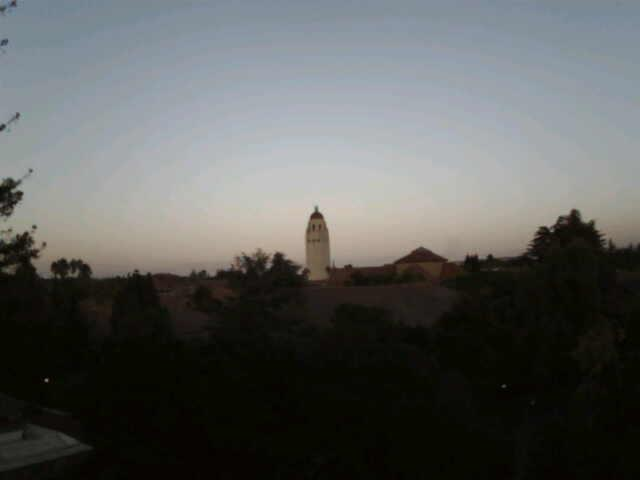
Software/images/Calibration/Calibrated Pics/Good.jpg
