PyCubed-Mini/OpenMV_Camera/Software/images/Calibration/Calibrated Pics/Great.jpg

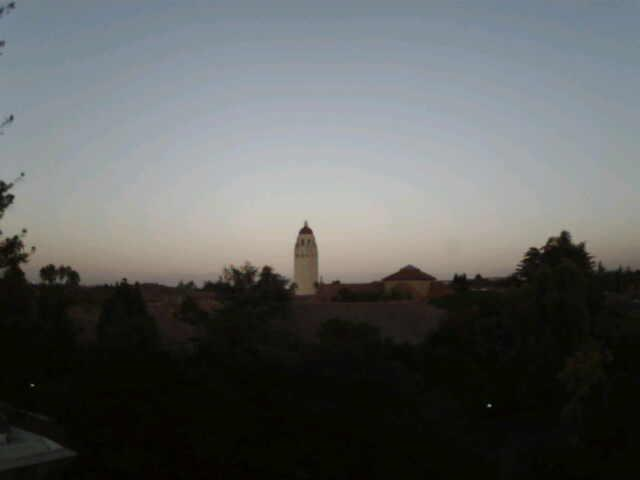
Software/images/Calibration/Calibrated Pics/Great.jpg
