PyCubed-Mini/OpenMV_Camera/Software/images/Calibration/Calibrated Pics/Picturesque.jpg

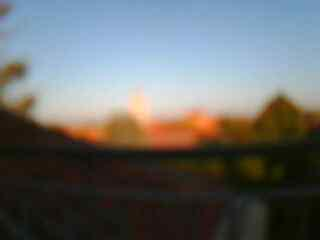
Software/images/Calibration/Calibrated Pics/Picturesque.jpg
