PyCubed-Mini/OpenMV_Camera/Software/images/Calibration/QVGA Video Stills/QVGA Video Still.jpg

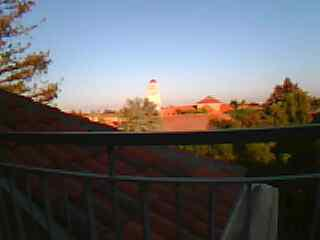
Software/images/Calibration/QVGA Video Stills/QVGA Video Still.jpg
