PyCubed-Mini/OpenMV_Camera/Software/images/Calibration/VGA Snapshots/Early Snapshots/VGA 1.jpg

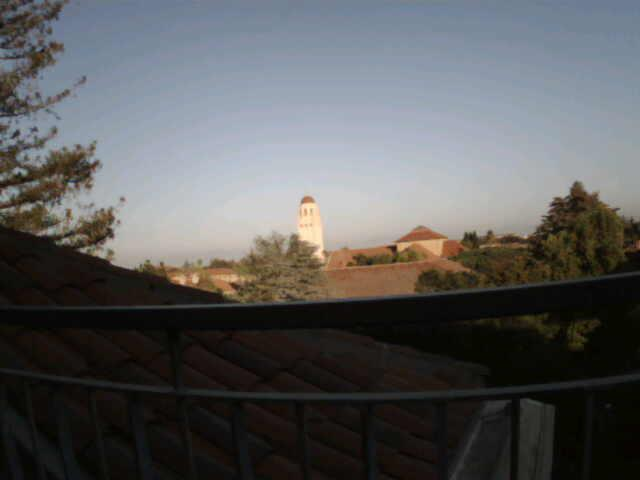
Software/images/Calibration/VGA Snapshots/Early Snapshots/VGA 1.jpg
