PyCubed-Mini/OpenMV_Camera/Software/images/Calibration/VGA Snapshots/True Calibration/+0.jpg

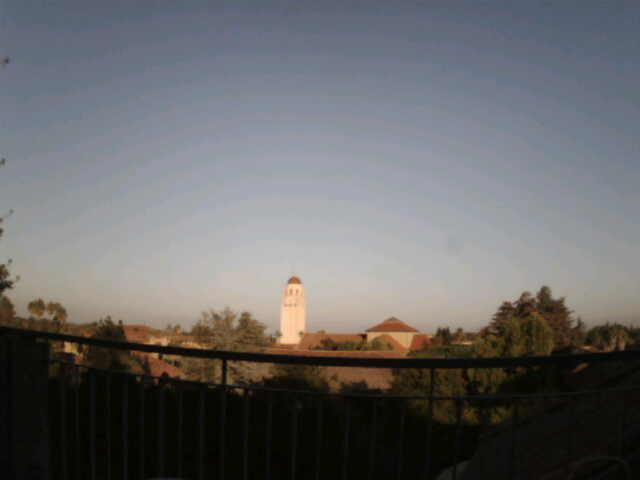
Software/images/Calibration/VGA Snapshots/True Calibration/+0.jpg
