PyCubed-Mini/OpenMV_Camera/Software/images/Calibration/VGA Snapshots/True Calibration/+2.jpg

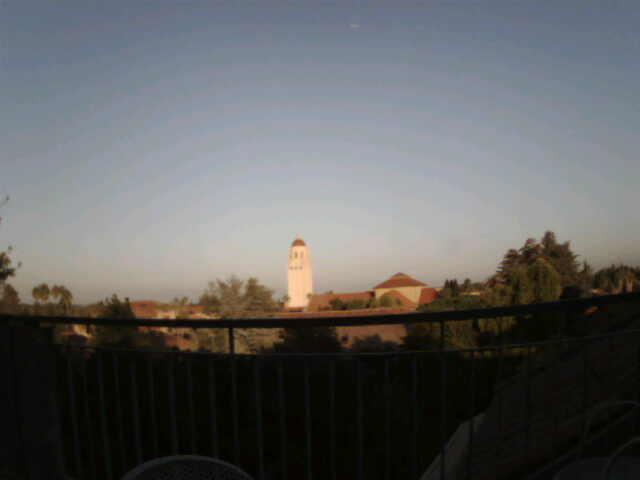
Software/images/Calibration/VGA Snapshots/True Calibration/+2.jpg
