PyCubed-Mini/OpenMV_Camera/Software/images/Calibration/VGA Snapshots/True Calibration/-1.jpg

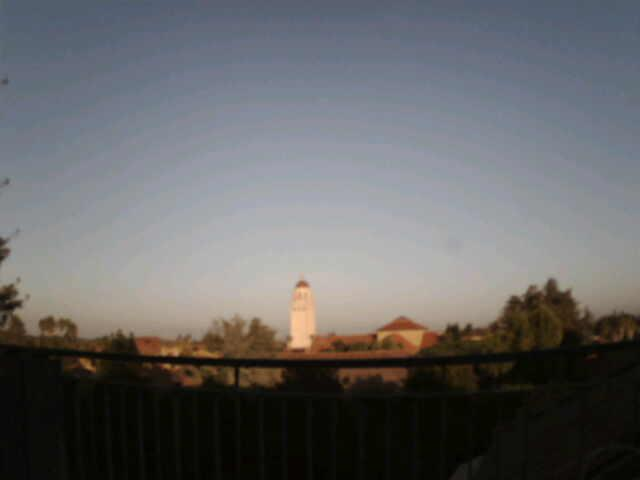
Software/images/Calibration/VGA Snapshots/True Calibration/-1.jpg
