PyCubed-Mini/OpenMV_Camera/Software/images/Calibration/VGA Video Stills/VGA Video Still 2 (Best, Used for Snapshot Calibration).jpg

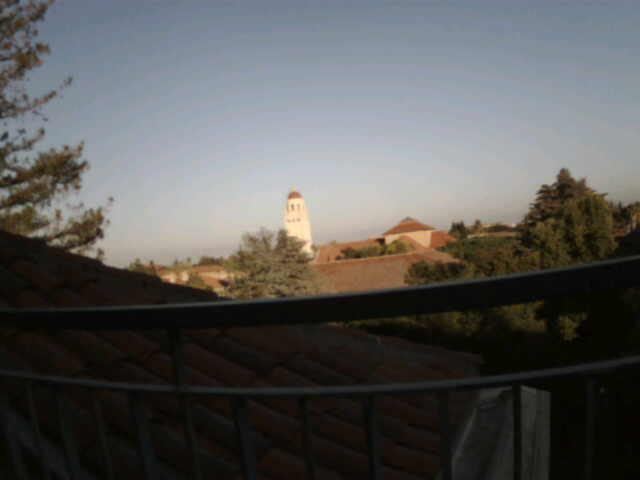
Software/images/Calibration/VGA Video Stills/VGA Video Still 2 (Best, Used for Snapshot Calibration).jpg
