PyCubed-Mini/OpenMV_Camera/Software/images/Calibration/VGA Video Stills/VGA Video Still 3.jpg

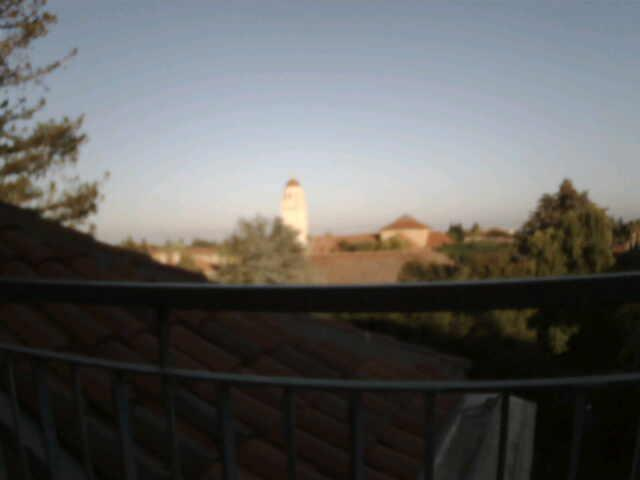
Software/images/Calibration/VGA Video Stills/VGA Video Still 3.jpg
