PyCubed-Mini/OpenMV_Camera/Software/images/Calibration/VGA Video Stills/VGA Video Still 4.jpg

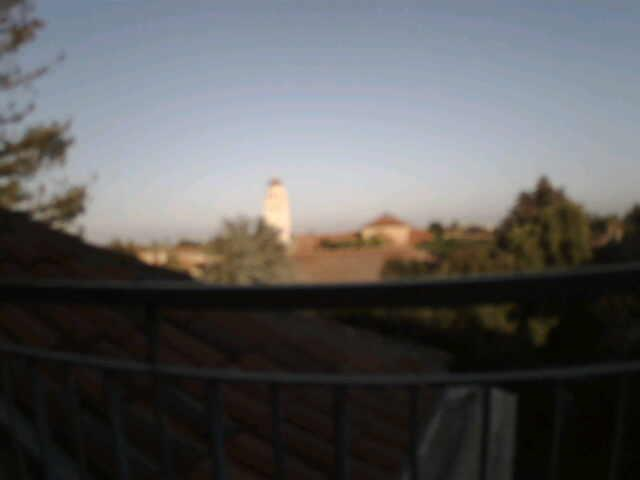
Software/images/Calibration/VGA Video Stills/VGA Video Still 4.jpg
