PyCubed-Mini/OpenMV_Camera/Software/images/Calibration/VGA Video Stills/VGA Video Still 5.jpg

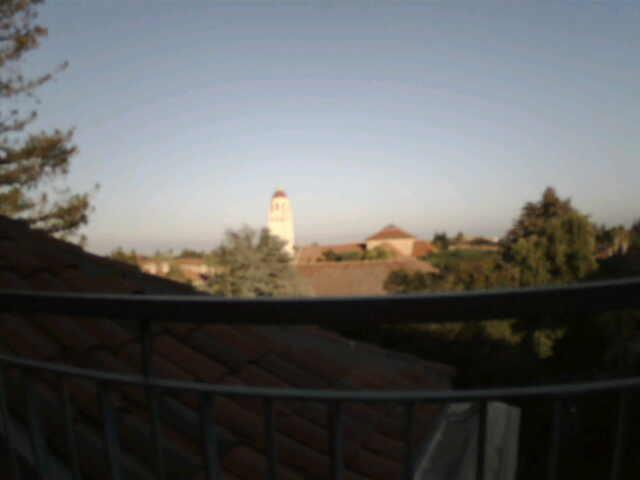
Software/images/Calibration/VGA Video Stills/VGA Video Still 5.jpg
