PyCubed-Mini/OpenMV_Camera/Software/images/Less Important Studies/Initial Compression Testing/Initial Compression Testing 1 (Chaotic)/default_compression_2.jpg

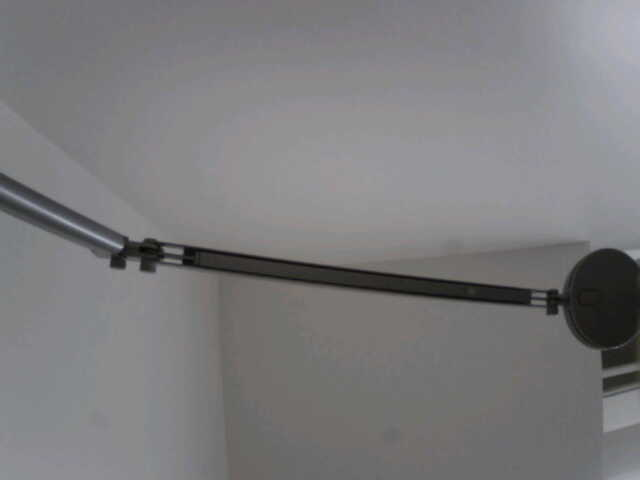
Software/images/Less Important Studies/Initial Compression Testing/Initial Compression Testing 1 (Chaotic)/default_compression_2.jpg
