PyCubed-Mini/OpenMV_Camera/Software/images/Less Important Studies/Initial Compression Testing/Initial Compression Testing 1 (Chaotic)/fully_compressed_1.jpg

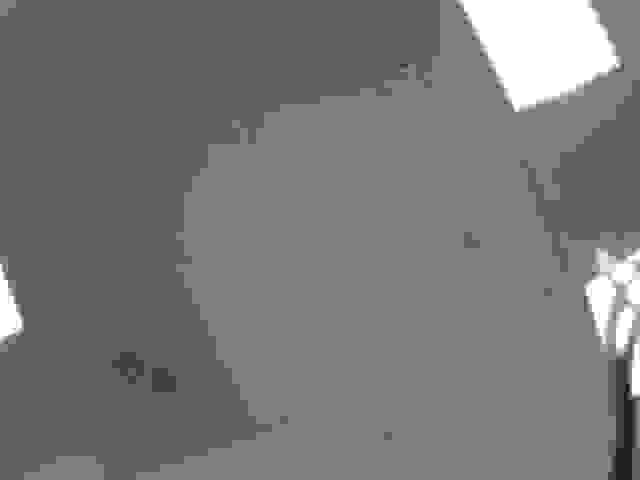
Software/images/Less Important Studies/Initial Compression Testing/Initial Compression Testing 1 (Chaotic)/fully_compressed_1.jpg
