PyCubed-Mini/OpenMV_Camera/Software/images/Less Important Studies/Initial Compression Testing/Initial Compression Testing 2 (Blue Light On)/quality_01.jpg

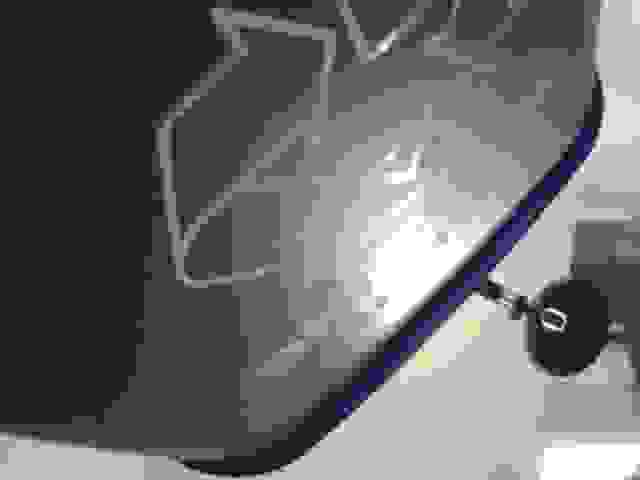
Software/images/Less Important Studies/Initial Compression Testing/Initial Compression Testing 2 (Blue Light On)/quality_01.jpg
