PyCubed-Mini/OpenMV_Camera/Software/images/Less Important Studies/Initial Compression Testing/Initial Compression Testing 3 (Blue light off)/default_quality_(50).jpg

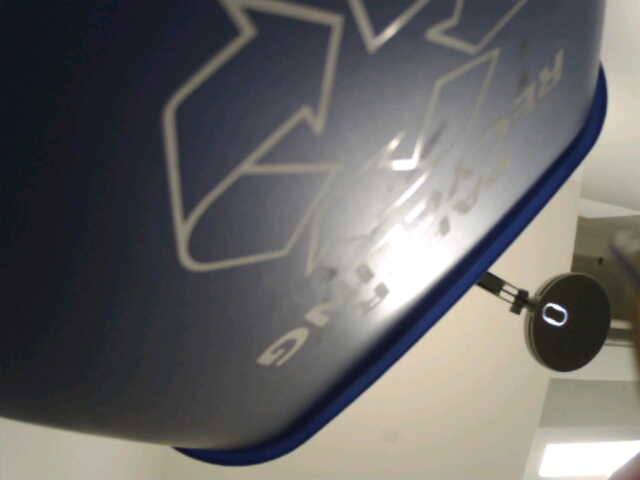
Software/images/Less Important Studies/Initial Compression Testing/Initial Compression Testing 3 (Blue light off)/default_quality_(50).jpg
