PyCubed-Mini/OpenMV_Camera/Software/images/Less Important Studies/Initial Compression Testing/Initial Compression Testing 3 (Blue light off)/quality_25.jpg

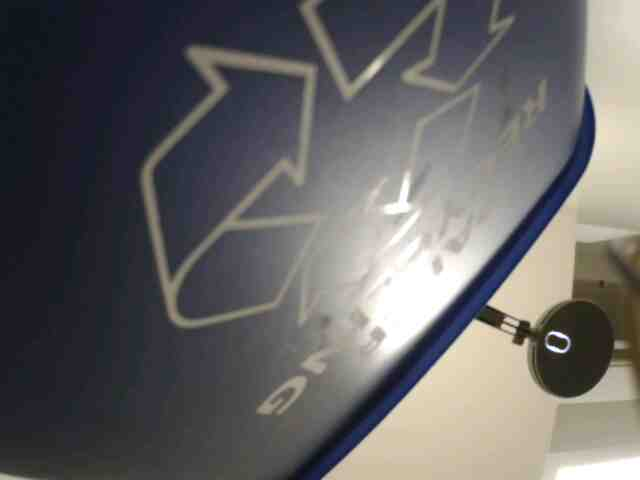
Software/images/Less Important Studies/Initial Compression Testing/Initial Compression Testing 3 (Blue light off)/quality_25.jpg
