PyCubed-Mini/OpenMV_Camera/Software/images/Less Important Studies/Initial Compression Testing/Initial Compression Testing 4 (Delay Added)/default_quality_(50).jpg

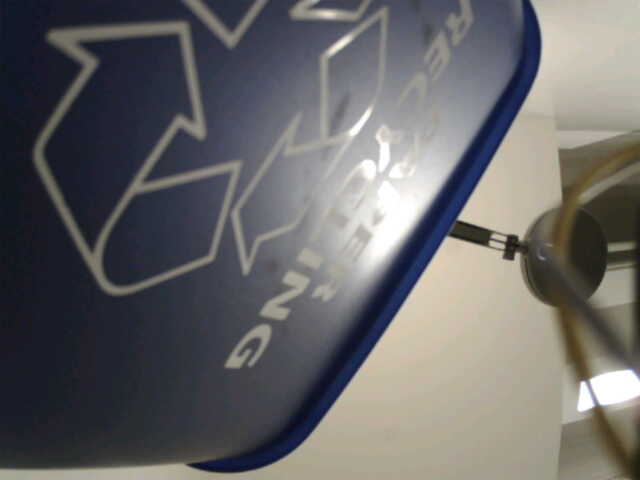
Software/images/Less Important Studies/Initial Compression Testing/Initial Compression Testing 4 (Delay Added)/default_quality_(50).jpg
