PyCubed-Mini/OpenMV_Camera/Software/images/Less Important Studies/Save to SD Experiments/Data Directly Extracted from Camera/img_bytestream.png

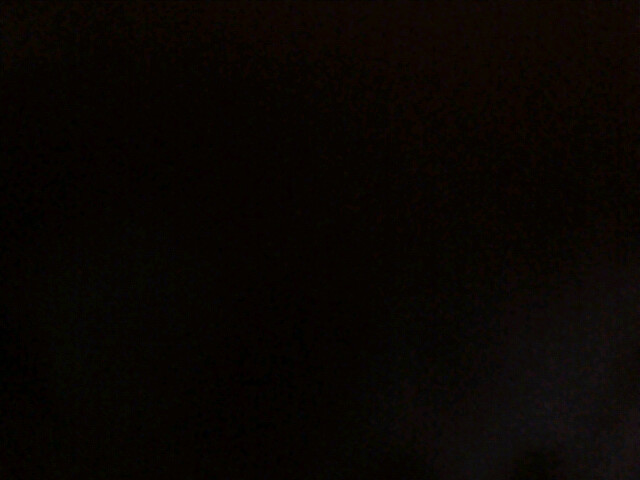
Software/images/Less Important Studies/Save to SD Experiments/Data Directly Extracted from Camera/img_bytestream.png
