PyCubed-Mini/OpenMV_Camera/Software/images/Less Important Studies/Save to SD Experiments/Data Directly Extracted from Camera/picture_write.png

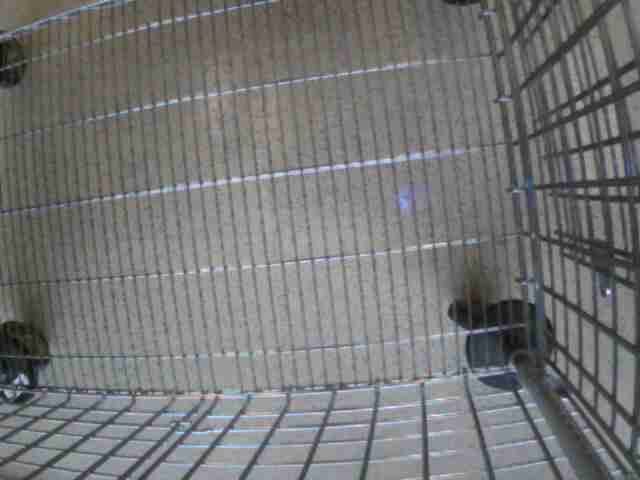
Software/images/Less Important Studies/Save to SD Experiments/Data Directly Extracted from Camera/picture_write.png
