PyCubed-Mini/OpenMV_Camera/Software/images/Less Important Studies/Save to SD Experiments/Data Saved To SD Card from MCU/successful_text2pic_conversion.png

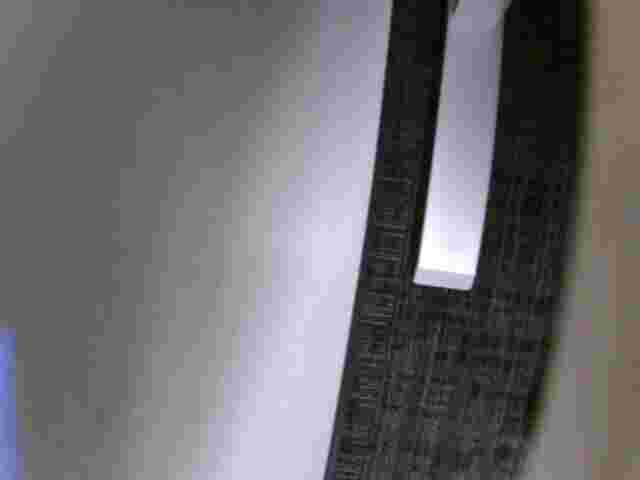
Software/images/Less Important Studies/Save to SD Experiments/Data Saved To SD Card from MCU/successful_text2pic_conversion.png
