PyCubed-Mini/OpenMV_Camera/Software/images/Less Important Studies/Save to SD Experiments/Manual Save to SD Tests/Bytes Copied/byte_w_test.png

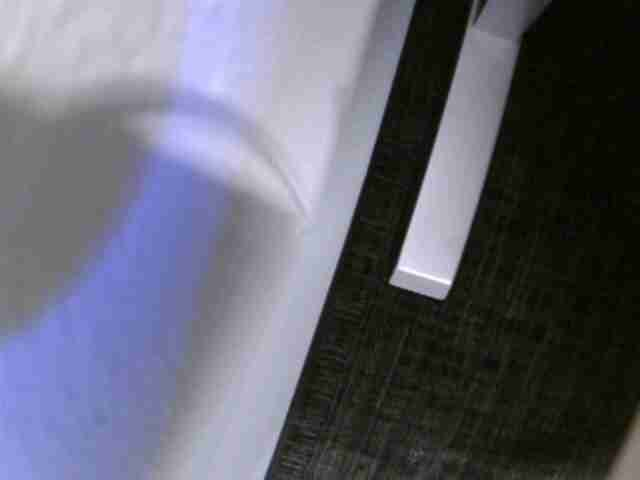
Software/images/Less Important Studies/Save to SD Experiments/Manual Save to SD Tests/Bytes Copied/byte_w_test.png
