PyCubed-Mini/OpenMV_Camera/Software/images/Less Important Studies/Save to SD Experiments/Successfully Saved Images/Read File, Write Image.jpg

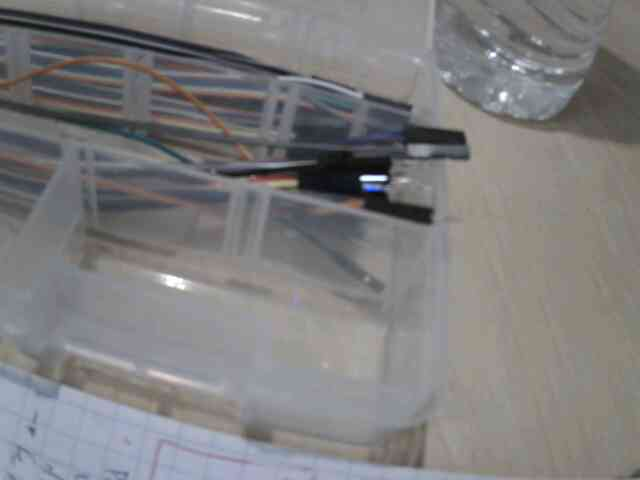
Software/images/Less Important Studies/Save to SD Experiments/Successfully Saved Images/Read File, Write Image.jpg
