PyCubed-Mini/OpenMV_Camera/Software/images/Less Important Studies/Save to SD Experiments/Successfully Saved Images/Taken with Camera NOT Plugged into Computer.jpg

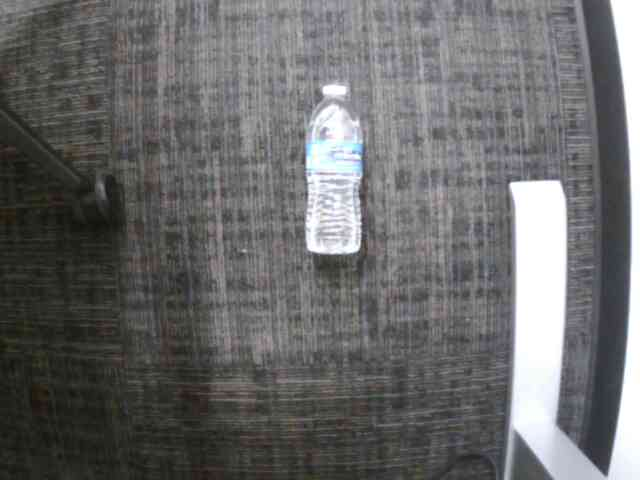
Software/images/Less Important Studies/Save to SD Experiments/Successfully Saved Images/Taken with Camera NOT Plugged into Computer.jpg
