PyCubed-Mini/OpenMV_Camera/(threads)

Thread 1 (2022-02-22):

Shift USB location to line up with hole in Z board

jbwillis, 2022-02-22:
USB connector location needs to be moved to line up with the access hole in the Z board. The USB connector also needs to protrude through the hole in order to properly attach a cable to it.

- [ ] Determine location of Z board hole with respect to camera board
- [ ] Move the connector to line up with the Z board hole horizontally
- [ ] Move the connector to protrude through the Z board hole
- [ ] Update 3D model and check clearances.

NeilKhera, 2022-02-28:
It is okay to change the board outline of the camera board to be exactly the same as the mainboard? This would ensure that the usb port is at exactly the same spot. At the moment the camera board is slightly shorter than the main board which places the connector further back from the Z board

jbwillis, 2022-02-28:
Yes, but I’d restrict the change to be only in the area around the USB port
to avoid potential interference with the Z Board.

On Mon, Feb 28, 2022 at 10:54 AM Neil Khera ***@***.***>
wrote:

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

Thread 2 (2022-02-22):

Exchange flat flex connector for stacking 1.25mm 2x5 header

jbwillis, 2022-02-22:
Connection between camera and mainboard will be a 1.25mm stacking header [](https://www.digikey.com/en/products/detail/amphenol-icc-fci/20021121-00010C1LF/4243096)

- [ ] Update footprint on Camera board
- [ ] Update footprint on main board
- [ ] ensure algnment between camera and main board is sufficient.
- [ ] update 3D model to match board-board spacing between mainboard and camera board
