PyCubed-Mini/OpenMV_Camera/(list of files, drawings)

Other design files:
openmv-official-repo-for-reference/shields/d1mini/d1mini-openmv.fz
