PyCubed-Mini/OpenMV_Camera/openmv3 - KiCAD/openmv3.kicad_pcb

## KiCad design openmv3 - KiCAD/openmv3.kicad_pcb (2019-11-17)

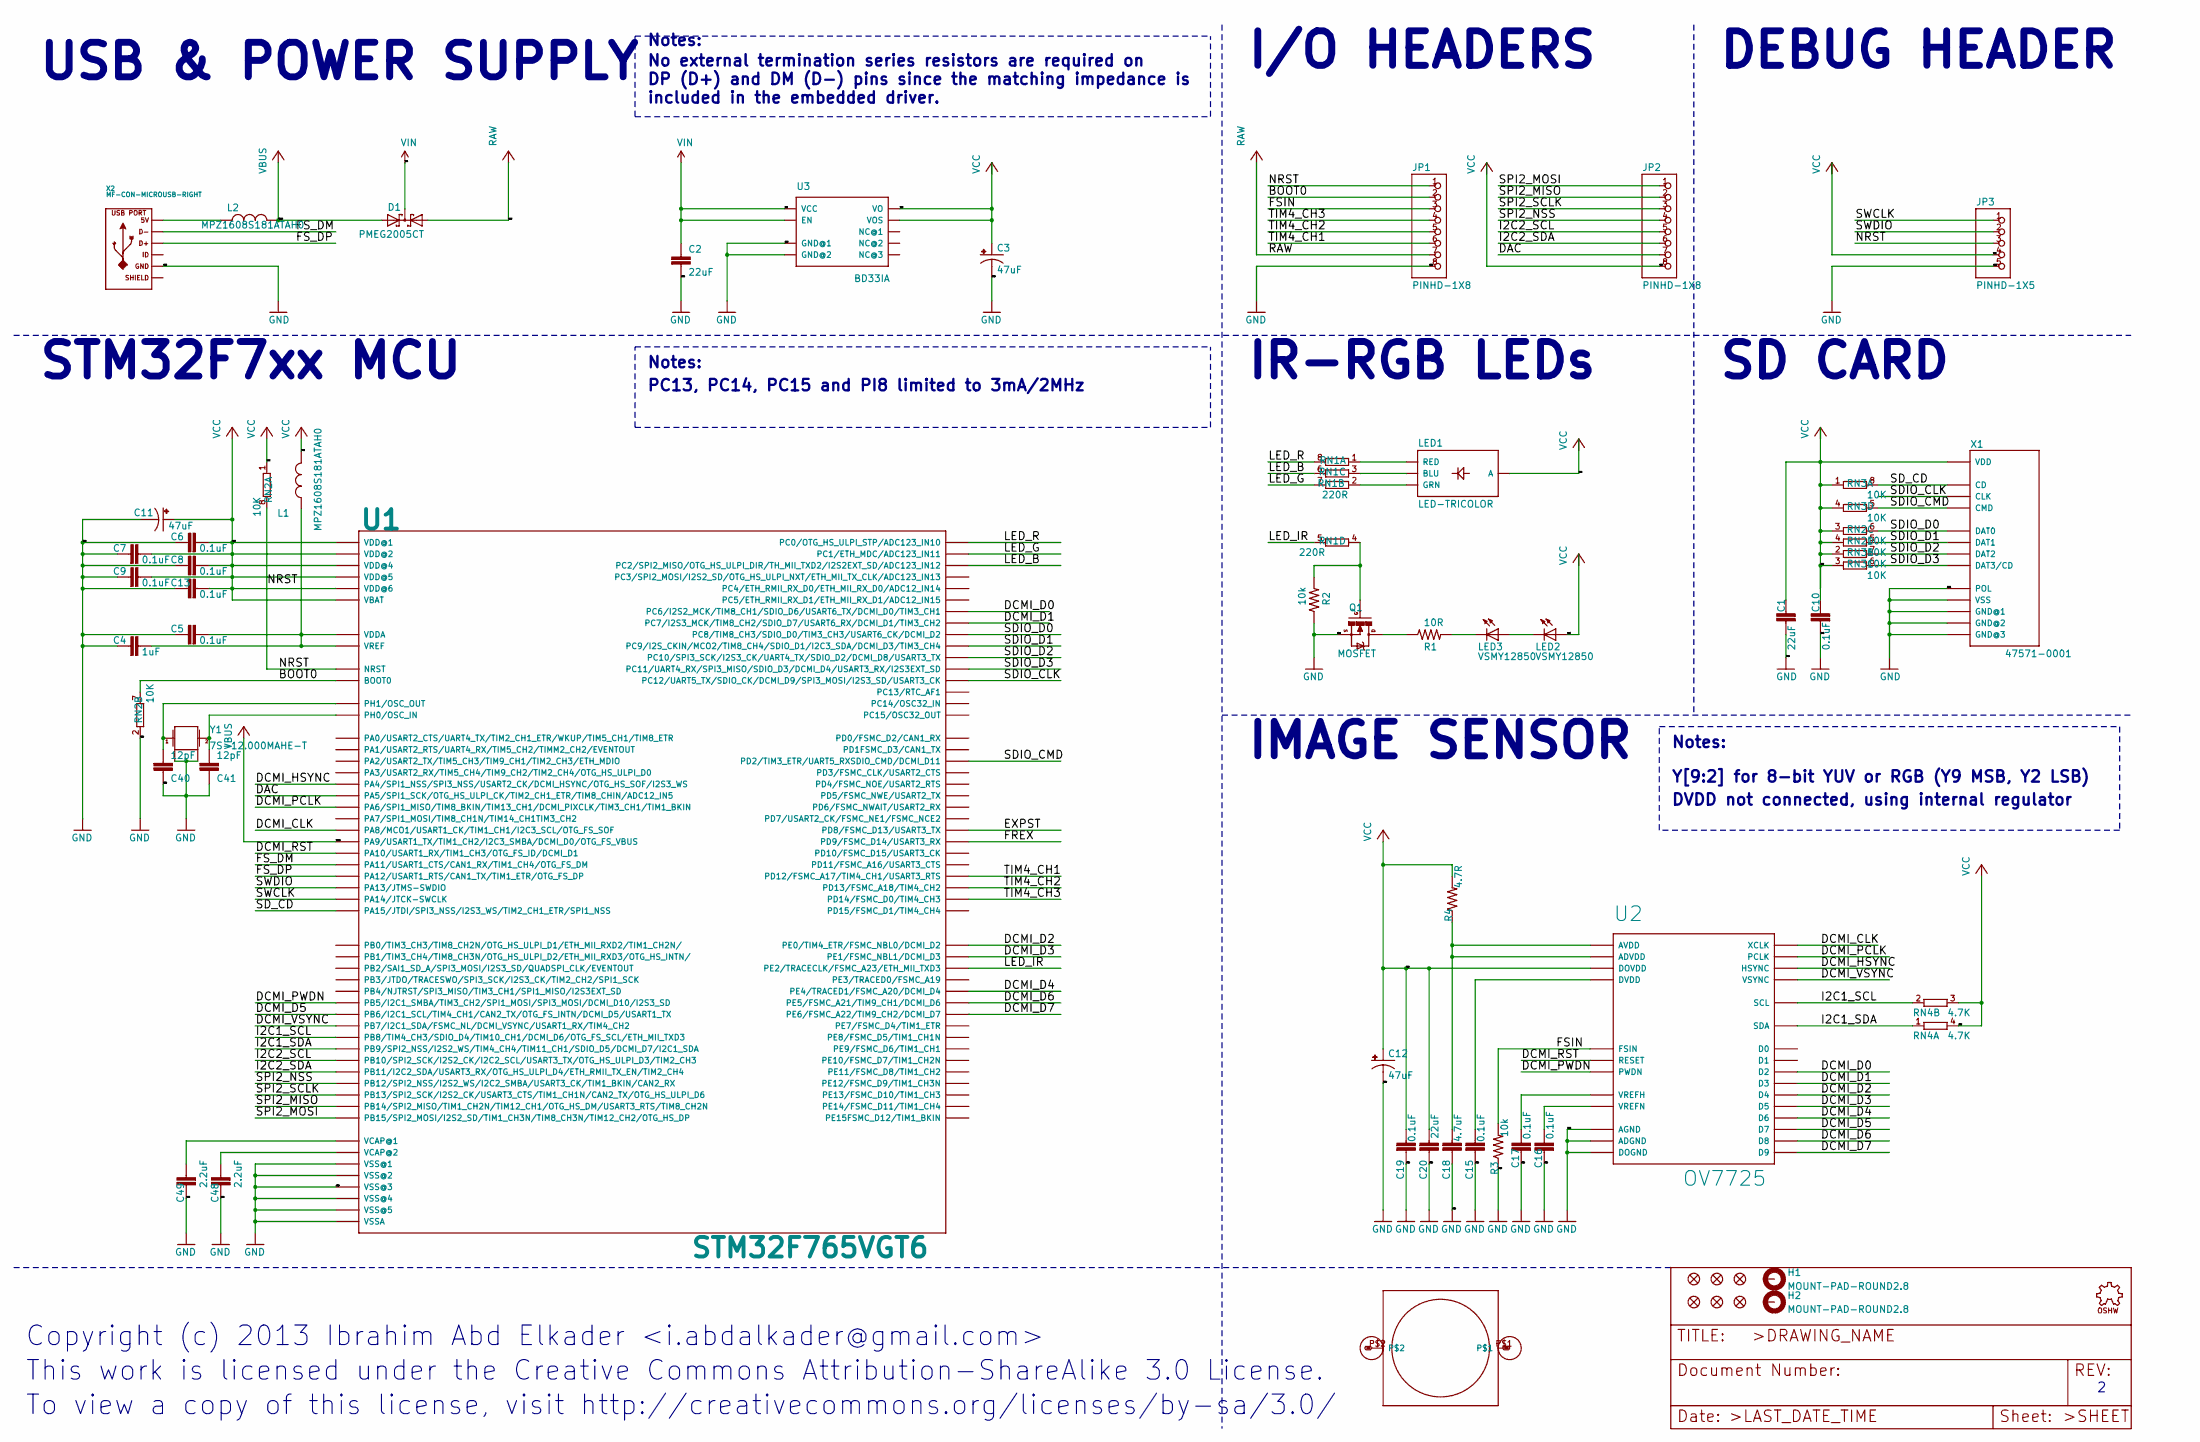
[picture p118: schematic openmv3.sch]

Parts:
C1, C2, C20: 22uF; 0805
C3, C11, C12: 47uF; EIA3216
C4: 1uF; 0603-CAP
C5, C6, C7, C8, C9, C10, C13, C15, C16, C17, C19: 0.1uF; 0603-CAP
C18: 4.7uF; 0603-CAP
C40, C41: 12pF; 0603-CAP
C48, C49: 2.2uF; 0603-CAP
D1: PMEG2005CT; SOT23
F1, F2, F3, F4, F5, F6: FIDUCIAL1X2; FIDUCIAL-1X2
H1, H2: MOUNT-PAD-ROUND2.8; 2,8-PAD
JP1, JP2: PINHD-1X8; 1X08
JP3: PINHD-1X5; 1X05
L1, L2: MPZ1608S181ATAH0; 0603
LED1: LED-TRICOLOR; LED-TRICOLOR-SMD-MF
LED2, LED3: VSMY12850; LED-1206
LM1: LENSMOUNT20MM; LENSMOUNT-20MM
LOGO1: OSHW_LOGO_FILLX0100-NT; OSHW_FILLX100_NOTEXT
Q1: MOSFET; SOT23-3
R1: 10R; 0603-RES
R2, R3: 10k; 0603-RES
R4: 4.7R; 0603-RES
RN1: 220R; EXBV8V
RN2, RN3: 10K; EXBV8V
RN4: 4.7K; EXBV4V
U1: STM32F765VGT6; LQFP100
U2: OV7725; CSP2-28
U3: BD33IA; HTSOP-J8
X1: 47571-0001; USD-47571
X2: MF-CON-MICROUSB-RIGHT; MICROUSB-RIGHT
Y1: 7S-12.000MAHE-T; CRYSTAL-2.5X2.0

Connections:
/BOOT0: JP1.2, RN2.7 (2), U1.94 (BOOT0)
/DAC: JP2.7, U1.29 (PA5/SPI1_SCK/OTG_HS_ULPI_CK/TIM2_CH1_ET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)
/DCMI_CLK: U1.67 (PA8/MCO1/USART1_CK/TIM1_CH1/I2C3_SCL/OT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), U2.F3 (XCLK)
/DCMI_D0: U1.63 (PC6/I2S2_MCK/TIM8_CH1/SDIO_D6/USART6_TX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), U2.F5 (D2)
/DCMI_D1: U1.64 (PC7/I2S3_MCK/TIM8_CH2/SDIO_D7/USART6_RX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), U2.F2 (D3)
/DCMI_D2: U1.97 (PE0/TIM4_ETR/FSMC_NBL0/DCMI_D2), U2.D6 (D4)
/DCMI_D3: U1.98 (PE1/FSMC_NBL1/DCMI_D3), U2.D1 (D5)
/DCMI_D4: U1.3 (PE4/TRACED1/FSMC_A20/DCMI_D4), U2.E6 (D6)
/DCMI_D5: U1.92 (PB6/I2C1_SCL/TIM4_CH1/CAN2_TX/OTG_FS_IN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), U2.E1 (D7)
/DCMI_D6: U1.4 (PE5/FSMC_A21/TIM9_CH1/DCMI_D6), U2.F6 (D8)
/DCMI_D7: U1.5 (PE6/FSMC_A22/TIM9_CH2/DCMI_D7), U2.F1 (D9)
/DCMI_HSYNC: U1.28 (PA4/SPI1_NSS/SPI3_NSS/USART2_CK/DCMI_HS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), U2.B6 (HSYNC)
/DCMI_PCLK: U1.30 (PA6/SPI1_MISO/TIM8_BKIN/TIM13_CH1/DCMI_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), U2.E4 (PCLK)
/DCMI_PWDN: U1.91 (PB5/I2C1_SMBA/TIM3_CH2/SPI1_MOSI/SPI3_M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), U2.C1 (PWDN)
/DCMI_RST: U1.69 (PA10/USART1_RX/TIM1_CH3/OTG_FS_ID/DCMI_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), U2.A2 (RESET)
/DCMI_VSYNC: U1.93 (PB7/I2C1_SDA/FSMC_NL/DCMI_VSYNC/USART1_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), U2.C6 (VSYNC)
/EXPST: U1.55 (PD8/FSMC_D13/USART3_TX)
/FREX: U1.56 (PD9/FSMC_D14/USART3_RX)
/FSIN: JP1.3, R3.2, U2.A4 (FSIN)
/FS_DM: U1.70 (PA11/USART1_CTS/CAN1_RX/TIM1_CH4/OTG_FS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), X2.2 (D-)
/FS_DP: U1.71 (PA12/USART1_RTS/CAN1_TX/TIM1_ETR/OTG_FS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), X2.3 (D+)
/I2C1_SCL: RN4.2 (1), U1.95 (PB8/TIM4_CH3/SDIO_D4/TIM10_CH1/DCMI_D6/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), U2.A5 (SCL)
/I2C1_SDA: RN4.1, U1.96 (PB9/SPI2_NSS/I2S2_WS/TIM4_CH4/TIM11_CH1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), U2.B5 (SDA)
/I2C2_SCL: JP2.5, U1.46 (PB10/SPI2_SCK/I2S2_CK/I2C2_SCL/USART3_T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)
/I2C2_SDA: JP2.6, U1.47 (PB11/I2C2_SDA/USART3_RX/OTG_HS_ULPI_D4/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)
/LED_B: RN1.6 (2), U1.17 (PC2/SPI2_MISO/OTG_HS_ULPI_DIR/TH_MII_TX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)
/LED_G: RN1.7 (2), U1.16 (PC1/ETH_MDC/ADC123_IN11)
/LED_IR: RN1.5 (2), U1.1 (PE2/TRACECLK/FSMC_A23/ETH_MII_TXD3)
/LED_R: RN1.8 (2), U1.15 (PC0/OTG_HS_ULPI_STP/ADC123_IN10)
/NRST: JP1.1, JP3.3, RN2.8 (2), U1.14 (NRST)
/SDIO_CLK: U1.80 (PC12/UART5_TX/SDIO_CK/DCMI_D9/SPI3_MOSI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), X1.P$5 (CLK)
/SDIO_CMD: RN3.5 (2), U1.83 (PD2/TIM3_ETR/UART5_RXSDIO_CMD/DCMI_D11), X1.P$3 (CMD)
/SDIO_D0: RN2.6 (2), U1.65 (PC8/TIM8_CH3/SDIO_D0/TIM3_CH3/USART6_CK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), X1.P$7 (DAT0)
/SDIO_D1: RN2.5 (2), U1.66 (PC9/I2S_CKIN/MCO2/TIM8_CH4/SDIO_D1/I2C3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), X1.P$8 (DAT1)
/SDIO_D2: RN3.7 (2), U1.78 (PC10/SPI3_SCK/I2S3_CK/UART4_TX/SDIO_D2/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), X1.P$1 (DAT2)
/SDIO_D3: RN3.6 (2), U1.79 (PC11/UART4_RX/SPI3_MISO/SDIO_D3/DCMI_D4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), X1.P$2 (DAT3/CD)
/SD_CD: RN3.8 (2), U1.77 (PA15/JTDI/SPI3_NSS/I2S3_WS/TIM2_CH1_ETR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), X1.G$5 (CD)
/SPI2_MISO: JP2.2, U1.53 (PB14/SPI2_MISO/TIM1_CH2N/TIM12_CH1/OTG_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)
/SPI2_MOSI: JP2.1, U1.54 (PB15/SPI2_MOSI/I2S2_SD/TIM1_CH3N/TIM8_C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)
/SPI2_NSS: JP2.4, U1.51 (PB12/SPI2_NSS/I2S2_WS/I2C2_SMBA/USART3_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)
/SPI2_SCLK: JP2.3, U1.52 (PB13/SPI2_SCK/I2S2_CK/USART3_CTS/TIM1_C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)
/SWCLK: JP3.1, U1.76 (PA14/JTCK-SWCLK)
/SWDIO: JP3.2, U1.72 (PA13/JTMS-SWDIO)
/TIM4_CH1: JP1.6, U1.59 (PD12/FSMC_A17/TIM4_CH1/USART3_RTS)
/TIM4_CH2: JP1.5, U1.60 (PD13/FSMC_A18/TIM4_CH2)
/TIM4_CH3: JP1.4, U1.61 (PD14/FSMC_D0/TIM4_CH3)
GND: C1.2, C2.2, C3.C (-), C4.2, C5.2, C6.2, C7.2, C8.2, C9.2, C10.2, C11.C (-), C12.C (-), C13.2, C15.2, C16.2, C17.2, C18.2, C19.2, C20.2, C40.1, C41.1, C48.2, C49.2, JP1.8, JP3.5, Q1.2 (S), R2.1, R3.1, RN2.2 (1), U1.10 (VSS@1), U1.19 (VSSA), U1.26 (VSS@2), U1.49 (VSS@5), U1.74 (VSS@3), U1.99 (VSS@4), U2.B1 (ADGND), U2.B4 (AGND), U2.F4 (DOGND), U3.3 (GND@1), U3.P$1 (GND@2), X1.G$1 (GND@3), X1.G$2 (GND@2), X1.G$3 (GND@1), X1.G$4 (POL), X1.P$6 (VSS), X2.5 (GND), Y1.2, Y1.4
unnamed: C4.1, C5.1, L1.1, U1.20 (VREF), U1.21 (VDDA)
unnamed: C15.1, U2.E3 (DVDD)
unnamed: C16.1, U2.B2 (VREFN)
unnamed: C17.1, U2.A3 (VREFH)
unnamed: C18.1, R4.1, U2.A1 (ADVDD), U2.B3 (AVDD)
unnamed: C40.2, U1.13 (PH1/OSC_OUT), Y1.3 (2)
unnamed: C41.2, U1.12 (PH0/OSC_IN), Y1.1
unnamed: C48.1, U1.73 (VCAP@2)
unnamed: C49.1, U1.48 (VCAP@1)
unnamed: L2.1, X2.1 (5V)
unnamed: LED1.B (BLU), RN1.3 (1)
unnamed: LED1.G (GRN), RN1.2 (1)
unnamed: LED1.R (RED), RN1.1
unnamed: LED2.C, LED3.A
unnamed: LED3.C, R1.2
unnamed: Q1.1 (G), R2.2, RN1.4 (1)
unnamed: Q1.3 (D), R1.1
unnamed: X2.S1 (SLD), X2.S2 (SLD), X2.S3 (SLD), X2.S4 (SLD), X2.S5 (SLD), X2.S6 (SLD)
P$1: LM1.P$1
P$2: LM1.P$2
RAW: D1.1 (A1), JP1.7
VBUS: D1.2 (A2), L2.2, U1.68 (PA9/USART1_TX/TIM1_CH2/I2C3_SMBA/DCMI_D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)
VCC: C1.1, C3.A (+), C6.1, C7.1, C8.1, C9.1, C10.1, C11.A (+), C12.A (+), C13.1, C19.1, C20.1, JP2.8, JP3.4, L1.2, LED1.A, LED2.A, R4.2, RN2.1, RN2.3 (1), RN2.4 (1), RN3.1, RN3.2 (1), RN3.3 (1), RN3.4 (1), RN4.3 (2), RN4.4 (2), U1.6 (VBAT), U1.11 (VDD@1), U1.27 (VDD@2), U1.50 (VDD@4), U1.75 (VDD@5), U1.100 (VDD@6), U2.E5 (DOVDD), U3.1 (VO), U3.2 (VOS), X1.P$4 (VDD)
VIN: C2.1, D1.3 (CC), U3.5 (EN), U3.8 (VCC)

Notes on the sheet:
PC13, PC14, PC15 and PI8 limited to 3mA/2MHz
Copyright (c) 2013 Ibrahim Abd Elkader <i.abdalkader@gmail.com>
This work is licensed under the Creative Commons Attribution-ShareAlike 3.0 License.
To view a copy of this license, visit http://creativecommons.org/licenses/by-sa/3.0/
SD CARD
Y[9:2] for 8-bit YUV or RGB (Y9 MSB, Y2 LSB)
Notes:
IMAGE SENSOR
STM32F7xx MCU
IR-RGB LEDs
USB & POWER SUPPLY
DEBUG HEADER
I/O HEADERS
No external termination series resistors are required on DP (D+) and DM (D-) pins since the matching impedance is included in the embedded driver.
DVDD not connected, using internal regulator

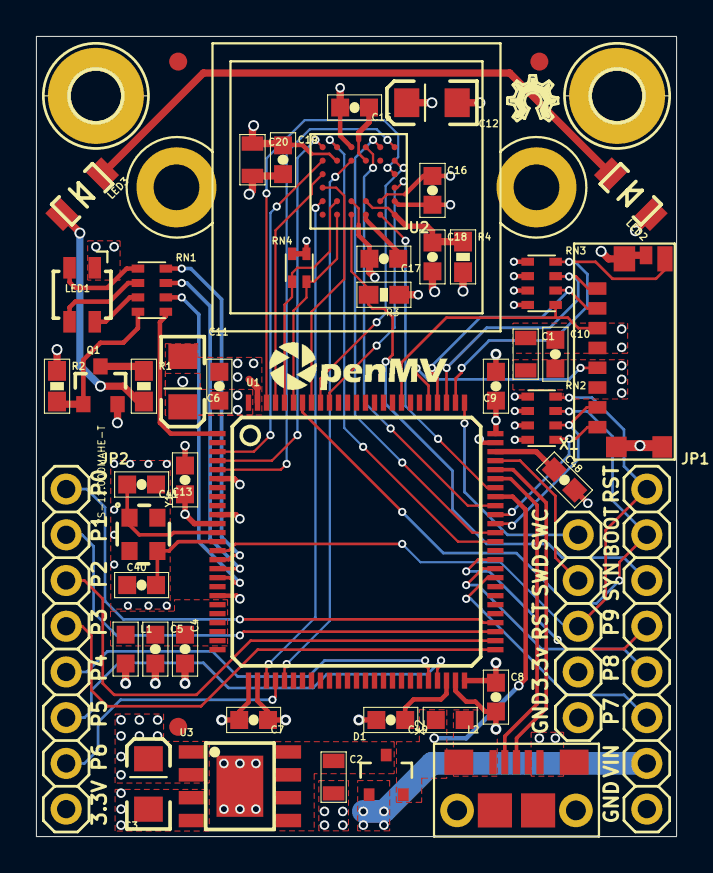
[picture p119: board openmv3.kicad_pcb from above]

Board: 4 copper layers, 35.6 x 44.5 mm, 61 parts (0 on the bottom side), 67 nets.

Other parts of the board:
U$1: WEEE
U$2: ROHS
U$3: OMV-LOGO
U$4: OMV-LOGO-SMALL
