PyCubed-Mini/OpenMV_Camera/openmv-official-repo-for-reference/openmv4/base/base.brd

## EAGLE design openmv-official-repo-for-reference/openmv4/base/base.brd (2019-10-06)

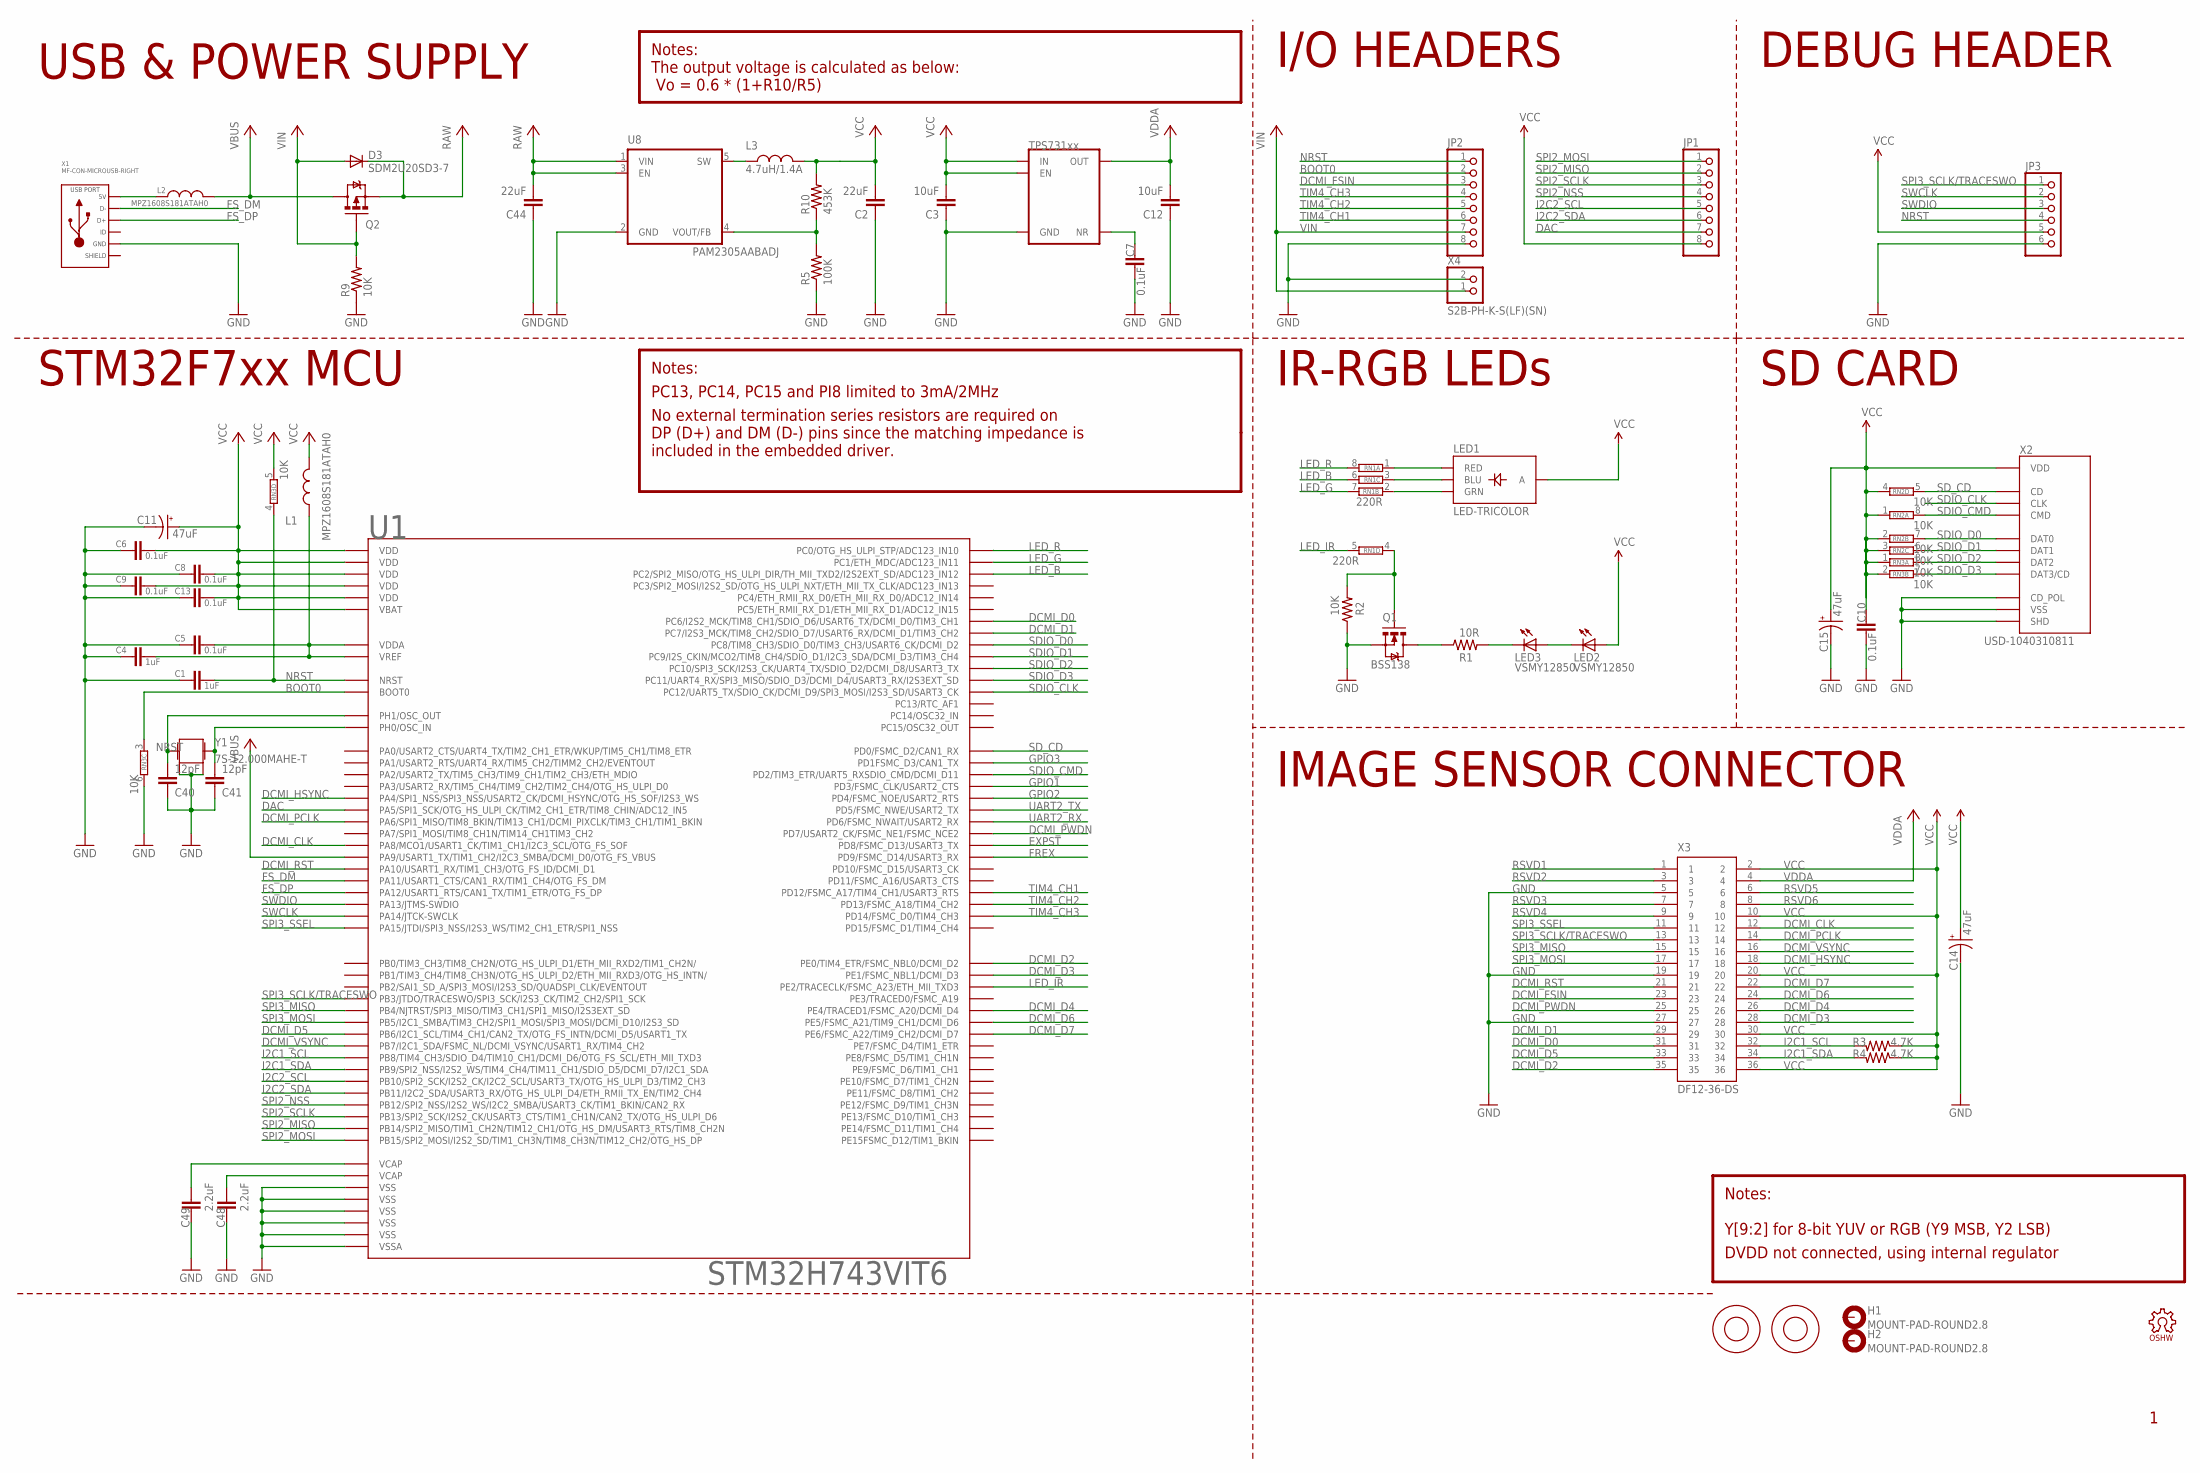
[picture p120: schematic base.sch]

Parts:
C1, C4: 1uF; 0603-CAP
C2, C44: 22uF; 0805
C3, C12: 10uF; 0805
C5, C6, C7, C8, C9, C10, C13: 0.1uF; 0603-CAP
C11, C14, C15: 47uF; EIA3216
C40, C41: 12pF; 0603-CAP
C48, C49: 2.2uF; 0603-CAP
D3: SDM2U20SD3-7; SOD-323
H1, H2: MOUNT-PAD-ROUND2.8; 2,8-PAD
JP1, JP2: PINHD-1X8; 1X08
JP3: PINHD-1X6; 1X06
L1, L2: MPZ1608S181ATAH0; 0603
L3: 4.7uH/1.4A; 1007
LED1: LED-TRICOLOR; LED-TRICOLOR-SMD-MF
LED2, LED3: VSMY12850; LED-1206
LOGO1: OSHW_LOGO_FILLX0100-NT; OSHW_FILLX100_NOTEXT
M1, M2: 9774030243R; 9774030151R
Q1: BSS138; SOT23-3
Q2: Si2301BDS; SOT23-3
R1: 10R; 0603-RES
R2, R9: 10K; 0603-RES
R3, R4: 4.7K; 0603-RES
R5: 100K; 0603-RES
R10: 453K; 0603-RES
RN1: 220R; EXBV8V
RN2, RN3: 10K; EXBV8V
U1: STM32H743VIT6; LQFP100
U5: TPS731XX; SOT23-5
U8: PAM2305AABADJ; TSOT25
X1: MF-CON-MICROUSB-RIGHT; MICROUSB-RIGHT
X2: USD-1040310811; 1040310811
X3: DF12-36-DS
X4: S2B-PH-K-S(LF)(SN); JST-PH-2-THM-RA
Y1: 7S-12.000MAHE-T; CRYSTAL-2.5X2.0

Connections:
BOOT0: JP2.2, RN3.3 (1), U1.94 (BOOT0)
DAC: JP1.7, U1.29 (PA5/SPI1_SCK/OTG_HS_ULPI_CK/TIM2_CH1_ET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)
DCMI_CLK: U1.67 (PA8/MCO1/USART1_CK/TIM1_CH1/I2C3_SCL/OT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), X3.12
DCMI_D0: U1.63 (PC6/I2S2_MCK/TIM8_CH1/SDIO_D6/USART6_TX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), X3.31
DCMI_D1: U1.64 (PC7/I2S3_MCK/TIM8_CH2/SDIO_D7/USART6_RX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), X3.29
DCMI_D2: U1.97 (PE0/TIM4_ETR/FSMC_NBL0/DCMI_D2), X3.35
DCMI_D3: U1.98 (PE1/FSMC_NBL1/DCMI_D3), X3.28
DCMI_D4: U1.3 (PE4/TRACED1/FSMC_A20/DCMI_D4), X3.26
DCMI_D5: U1.92 (PB6/I2C1_SCL/TIM4_CH1/CAN2_TX/OTG_FS_IN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), X3.33
DCMI_D6: U1.4 (PE5/FSMC_A21/TIM9_CH1/DCMI_D6), X3.24
DCMI_D7: U1.5 (PE6/FSMC_A22/TIM9_CH2/DCMI_D7), X3.22
DCMI_FSIN: JP2.3, X3.23
DCMI_HSYNC: U1.28 (PA4/SPI1_NSS/SPI3_NSS/USART2_CK/DCMI_HS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), X3.18
DCMI_PCLK: U1.30 (PA6/SPI1_MISO/TIM8_BKIN/TIM13_CH1/DCMI_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), X3.14
DCMI_PWDN: U1.88 (PD7/USART2_CK/FSMC_NE1/FSMC_NCE2), X3.25
DCMI_RST: U1.69 (PA10/USART1_RX/TIM1_CH3/OTG_FS_ID/DCMI_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), X3.21
DCMI_VSYNC: U1.93 (PB7/I2C1_SDA/FSMC_NL/DCMI_VSYNC/USART1_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), X3.16
EXPST: U1.55 (PD8/FSMC_D13/USART3_TX)
FREX: U1.56 (PD9/FSMC_D14/USART3_RX)
FS_DM: U1.70 (PA11/USART1_CTS/CAN1_RX/TIM1_CH4/OTG_FS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), X1.2 (D-)
FS_DP: U1.71 (PA12/USART1_RTS/CAN1_TX/TIM1_ETR/OTG_FS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), X1.3 (D+)
GND: C1.2, C2.1, C3.1, C4.2, C5.2, C6.2, C7.2, C8.2, C9.2, C10.2, C11.C (-), C12.1, C13.2, C14.C (-), C15.C (-), C40.1, C41.1, C44.1, C48.2, C49.2, JP2.8, JP3.6, Q1.2 (S), R2.1, R5.1, R9.1, RN3.6 (2), U1.10 (VSS), U1.19 (VSSA), U1.26 (VSS), U1.49 (VSS), U1.74 (VSS), U1.99 (VSS), U5.2 (GND), U8.2 (GND), X1.5 (GND), X2.CD$2 (CD_POL), X2.G$1 (SHD), X2.G$2 (SHD), X2.G$3 (SHD), X2.G$4 (SHD), X2.P$6 (VSS), X3.5, X3.19, X3.27, X4.2 (1), Y1.2, Y1.4
GPIO1: U1.84 (PD3/FSMC_CLK/USART2_CTS)
GPIO2: U1.85 (PD4/FSMC_NOE/USART2_RTS)
GPIO3: U1.82 (PD1FSMC_D3/CAN1_TX)
I2C1_SCL: R3.2, U1.95 (PB8/TIM4_CH3/SDIO_D4/TIM10_CH1/DCMI_D6/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), X3.32
I2C1_SDA: R4.2, U1.96 (PB9/SPI2_NSS/I2S2_WS/TIM4_CH4/TIM11_CH1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), X3.34
I2C2_SCL: JP1.5, U1.46 (PB10/SPI2_SCK/I2S2_CK/I2C2_SCL/USART3_T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)
I2C2_SDA: JP1.6, U1.47 (PB11/I2C2_SDA/USART3_RX/OTG_HS_ULPI_D4/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)
LED_B: RN1.6 (2), U1.17 (PC2/SPI2_MISO/OTG_HS_ULPI_DIR/TH_MII_TX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)
LED_G: RN1.7 (2), U1.16 (PC1/ETH_MDC/ADC123_IN11)
LED_IR: RN1.5 (2), U1.1 (PE2/TRACECLK/FSMC_A23/ETH_MII_TXD3)
LED_R: RN1.8 (2), U1.15 (PC0/OTG_HS_ULPI_STP/ADC123_IN10)
unnamed: C40.2, U1.13 (PH1/OSC_OUT), Y1.3 (2)
unnamed: C41.2, U1.12 (PH0/OSC_IN), Y1.1
unnamed: Q1.1 (G), R2.2, RN1.4 (1)
unnamed: LED1.B (BLU), RN1.3 (1)
unnamed: L2.1, X1.1 (5V)
unnamed: LED1.R (RED), RN1.1
unnamed: LED1.G (GRN), RN1.2 (1)
unnamed: LED3.C, R1.2
unnamed: C7.1, U5.4 (NR)
unnamed: C4.1, C5.1, L1.1, U1.20 (VREF), U1.21 (VDDA)
unnamed: R5.2, R10.1, U8.4 (VOUT/FB)
unnamed: Q1.3 (D), R1.1
unnamed: LED2.C, LED3.A
NRST: C1.1, JP2.1, JP3.4, RN3.4 (1), U1.14 (NRST)
RAW: C44.2, D3.1 (C), Q2.2 (S), U8.1 (VIN), U8.3 (EN)
RSVD1: X3.1
RSVD2: X3.3
RSVD3: X3.7
RSVD4: X3.9
RSVD5: X3.6
RSVD6: X3.8
SDIO_CLK: U1.80 (PC12/UART5_TX/SDIO_CK/DCMI_D9/SPI3_MOSI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), X2.P$5 (CLK)
SDIO_CMD: RN2.8 (2), U1.83 (PD2/TIM3_ETR/UART5_RXSDIO_CMD/DCMI_D11), X2.P$3 (CMD)
SDIO_D0: RN2.7 (2), U1.65 (PC8/TIM8_CH3/SDIO_D0/TIM3_CH3/USART6_CK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), X2.P$7 (DAT0)
SDIO_D1: RN2.6 (2), U1.66 (PC9/I2S_CKIN/MCO2/TIM8_CH4/SDIO_D1/I2C3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), X2.P$8 (DAT1)
SDIO_D2: RN3.8 (2), U1.78 (PC10/SPI3_SCK/I2S3_CK/UART4_TX/SDIO_D2/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), X2.P$1 (DAT2)
SDIO_D3: RN3.7 (2), U1.79 (PC11/UART4_RX/SPI3_MISO/SDIO_D3/DCMI_D4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), X2.P$2 (DAT3/CD)
SD_CD: RN2.5 (2), U1.81 (PD0/FSMC_D2/CAN1_RX), X2.CD$1 (CD)
SPI2_MISO: JP1.2, U1.53 (PB14/SPI2_MISO/TIM1_CH2N/TIM12_CH1/OTG_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)
SPI2_MOSI: JP1.1, U1.54 (PB15/SPI2_MOSI/I2S2_SD/TIM1_CH3N/TIM8_C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)
SPI2_NSS: JP1.4, U1.51 (PB12/SPI2_NSS/I2S2_WS/I2C2_SMBA/USART3_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)
SPI2_SCLK: JP1.3, U1.52 (PB13/SPI2_SCK/I2S2_CK/USART3_CTS/TIM1_C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)
SPI3_MISO: U1.90 (PB4/NJTRST/SPI3_MISO/TIM3_CH1/SPI1_MISO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), X3.15
SPI3_MOSI: U1.91 (PB5/I2C1_SMBA/TIM3_CH2/SPI1_MOSI/SPI3_M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), X3.17
SPI3_SCLK/TRACESWO: JP3.1, U1.89 (PB3/JTDO/TRACESWO/SPI3_SCK/I2S3_CK/TIM2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), X3.13
SPI3_SSEL: U1.77 (PA15/JTDI/SPI3_NSS/I2S3_WS/TIM2_CH1_ETR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), X3.11
SW: L3.1, U8.5 (SW)
SWCLK: JP3.2, U1.76 (PA14/JTCK-SWCLK)
SWDIO: JP3.3, U1.72 (PA13/JTMS-SWDIO)
TIM4_CH1: JP2.6, U1.59 (PD12/FSMC_A17/TIM4_CH1/USART3_RTS)
TIM4_CH2: JP2.5, U1.60 (PD13/FSMC_A18/TIM4_CH2)
TIM4_CH3: JP2.4, U1.61 (PD14/FSMC_D0/TIM4_CH3)
UART2_RX: U1.87 (PD6/FSMC_NWAIT/USART2_RX)
UART2_TX: U1.86 (PD5/FSMC_NWE/USART2_TX)
VBUS: L2.2, Q2.3 (D), U1.68 (PA9/USART1_TX/TIM1_CH2/I2C3_SMBA/DCMI_D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)
VCAP1: C49.1, U1.48 (VCAP)
VCAP2: C48.1, U1.73 (VCAP)
VCC: C2.2, C3.2, C6.1, C8.1, C9.1, C10.1, C11.A (+), C13.1, C14.A (+), C15.A (+), JP1.8, JP3.5, L1.2, L3.2, LED1.A, LED2.A, R3.1, R4.1, R10.2, RN2.1, RN2.2 (1), RN2.3 (1), RN2.4 (1), RN3.1, RN3.2 (1), RN3.5 (2), U1.6 (VBAT), U1.11 (VDD), U1.27 (VDD), U1.50 (VDD), U1.75 (VDD), U1.100 (VDD), U5.1 (IN), U5.3 (EN), X2.P$4 (VDD), X3.2, X3.10, X3.20, X3.30, X3.36
VDDA: C12.2, U5.5 (OUT), X3.4
VIN: D3.2 (A), JP2.7, Q2.1 (G), R9.2, X4.1 (2)

Notes on the sheet:
PC13, PC14, PC15 and PI8 limited to 3mA/2MHz
SD CARD
Y[9:2] for 8-bit YUV or RGB (Y9 MSB, Y2 LSB)
DVDD not connected, using internal regulator
Notes:
IMAGE SENSOR CONNECTOR
STM32F7xx MCU
IR-RGB LEDs
USB & POWER SUPPLY
DEBUG HEADER
I/O HEADERS
No external termination series resistors are required on DP (D+) and DM (D-) pins since the matching impedance is included in the embedded driver.
The output voltage is calculated as below: Vo = 0.6 * (1+R10/R5)

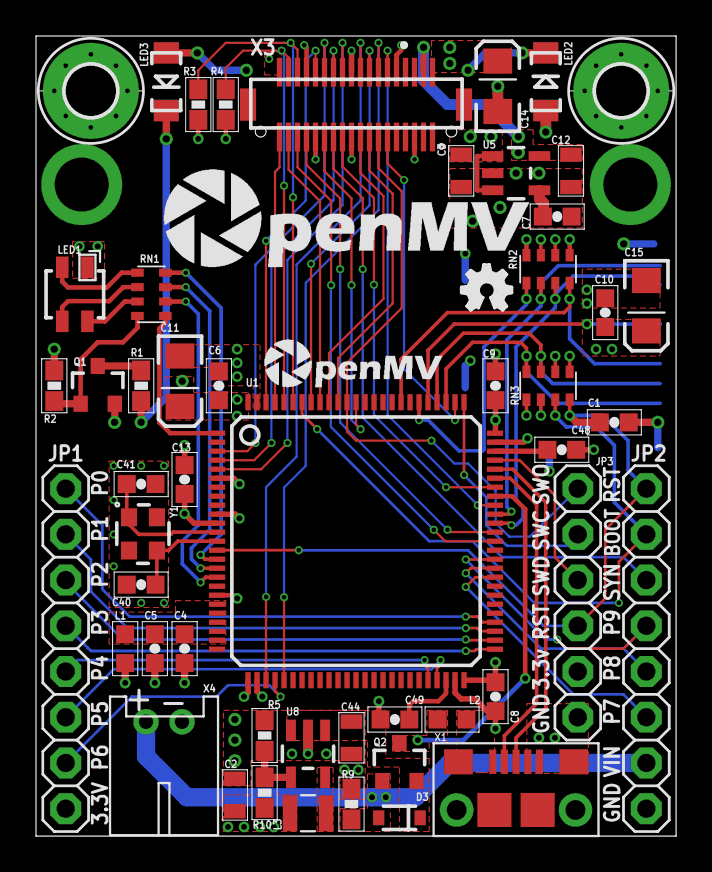
[picture p121: board base.brd from above]

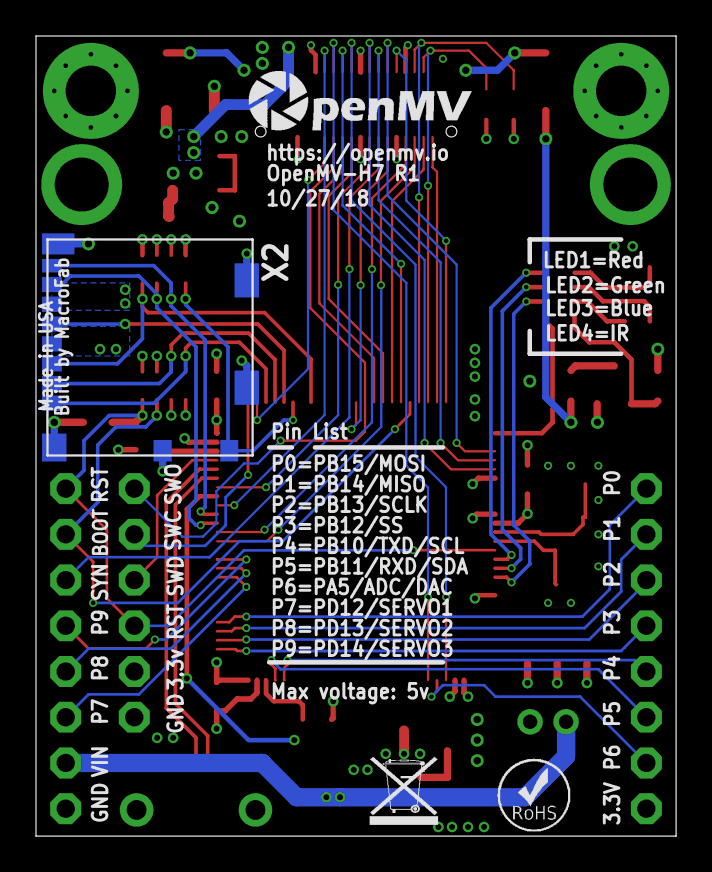
[picture p122: board base.brd from below]

Board: 4 copper layers, 35.6 x 44.5 mm, 60 parts (4 on the bottom side), 70 nets.

Other parts of the board:
U$1: WEEE
U$2: ROHS
U$3: OMV-LOGO
U$4: OMV-LOGO-SMALL
U$6: OMV-LOGO-BIG
