PyCubed-Mini/OpenMV_Camera/openmv-official-repo-for-reference/shields/tv/tv.brd

## EAGLE design openmv-official-repo-for-reference/shields/tv/tv.brd (2019-10-06)

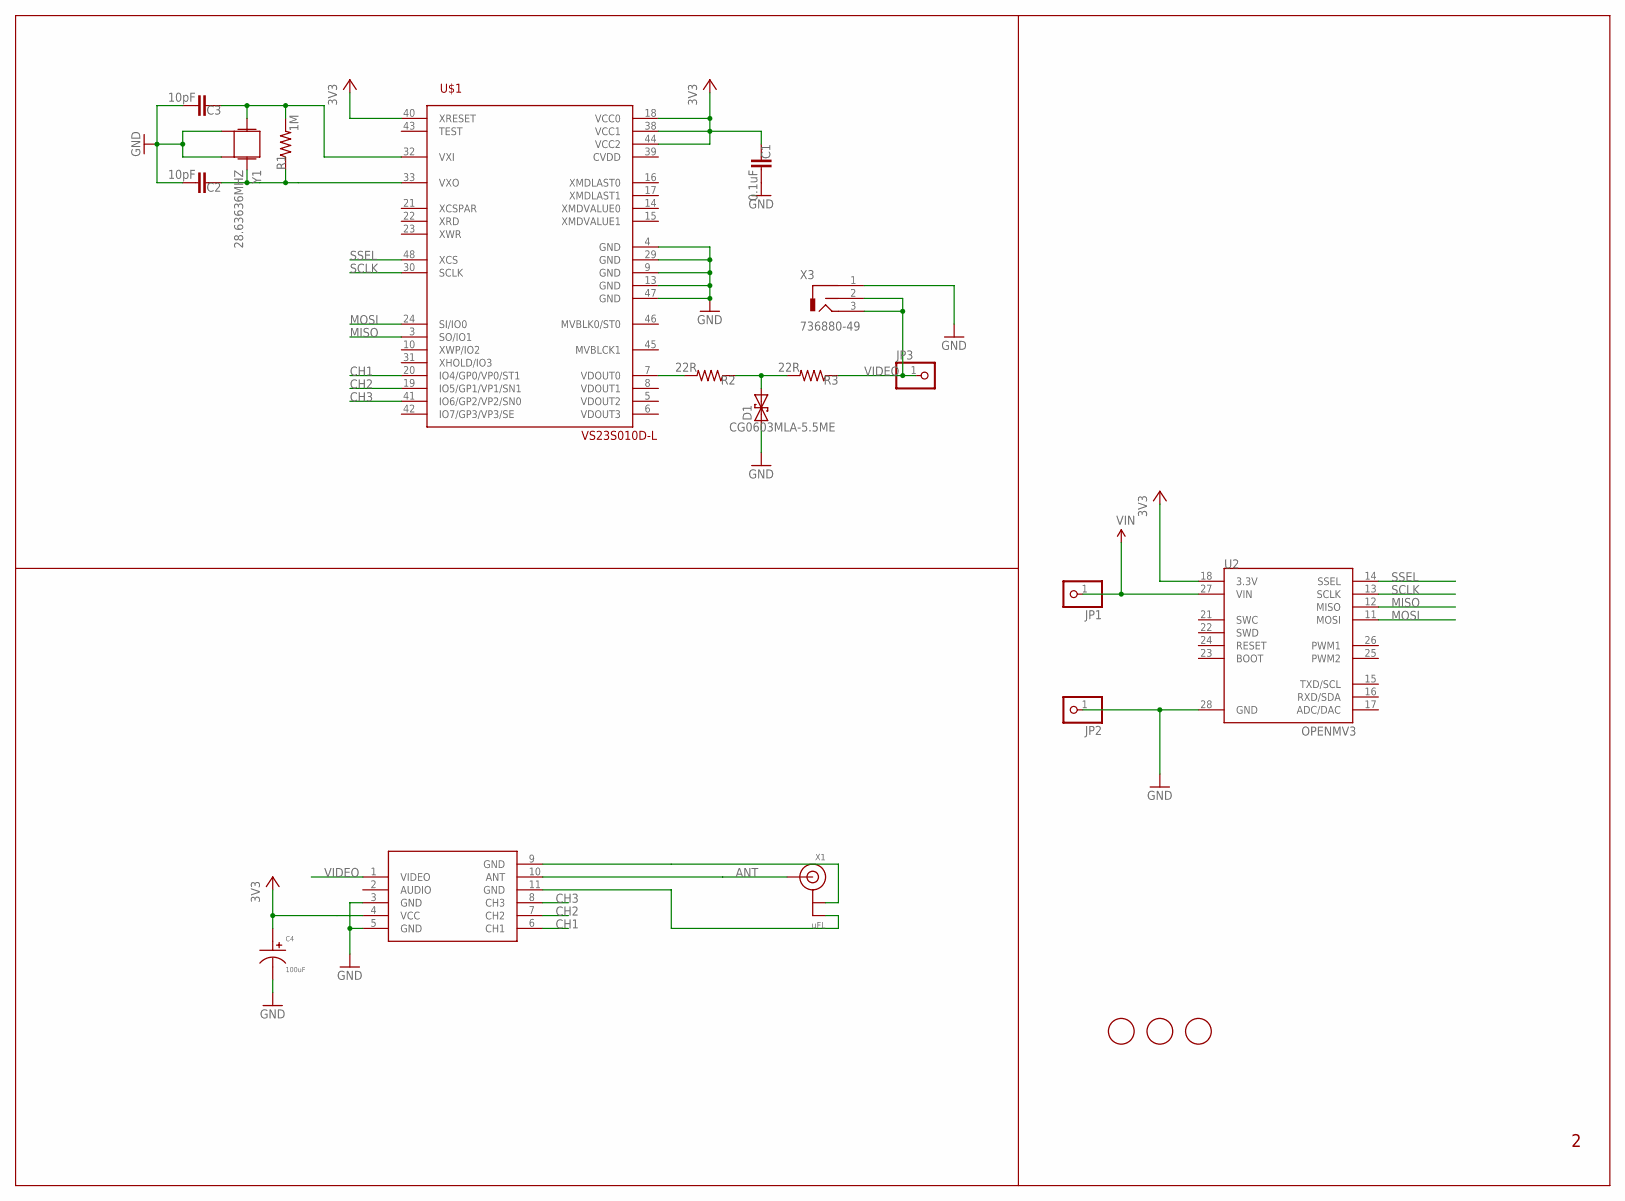
[picture p123: schematic tv.sch]

Parts:
C1: 0.1uF; 0603-CAP
C2, C3: 10pF; 0603-CAP
C4: 100uF; CP6.3MM
D1: CG0603MLA-5.5ME; C0603K
JP1, JP2, JP3: PINHD-1X1; 1X01
R1: 1M; 0603-RES
R2, R3: 22R; 0603-RES
U1: VS23S010D-L; LQFP48
U2: OPENMV3
U3: TX5813
U$1, U$2, U$4: FIDUCIAL; FIDUCIAL_1MM
X1: uFL; U.FL
X3: 736880-49
Y1: 28.63636MHZ; CRYSTAL-3.2X2.5-CTX851CT

Connections:
3V3: C1.1, C4.P$1, U1.18 (VCC0), U1.38 (VCC1), U1.40 (XRESET), U1.44 (VCC2), U2.18 (3.3V), U3.4 (VCC)
ANT: U3.10 (ANT), X1.3 (SIGNAL)
CH1: U1.20 (IO4/GP0/VP0/ST1), U3.6 (CH1)
CH2: U1.19 (IO5/GP1/VP1/SN1), U3.7 (CH2)
CH3: U1.41 (IO6/GP2/VP2/SN0), U3.8 (CH3)
GND: C1.2, C2.2, C3.2, C4.P$2, D1.1, JP2.1, U1.4 (GND), U1.9 (GND), U1.13 (GND), U1.29 (GND), U1.47 (GND), U2.28 (GND), U3.3 (GND), U3.5 (GND), X3.1 (GND), Y1.2, Y1.4
MISO: U1.3 (SO/IO1), U2.12 (MISO)
MOSI: U1.24 (SI/IO0), U2.11 (MOSI)
unnamed: D1.2, R2.1, R3.2
unnamed: R2.2, U1.7 (VDOUT0)
unnamed: U3.11 (GND), X1.2 (GND)
unnamed: U3.9 (GND), X1.1 (GND)
unnamed: C3.1, R1.2, U1.32 (VXI), Y1.3 (2)
unnamed: C2.1, R1.1, U1.33 (VXO), Y1.1
SCLK: U1.30 (SCLK), U2.13 (SCLK)
SSEL: U1.48 (XCS), U2.14 (SSEL)
VIDEO: JP3.1, R3.1, U3.1 (VIDEO), X3.2 (COT), X3.3 (SIGNAL)
VIN: JP1.1, U2.27 (VIN)

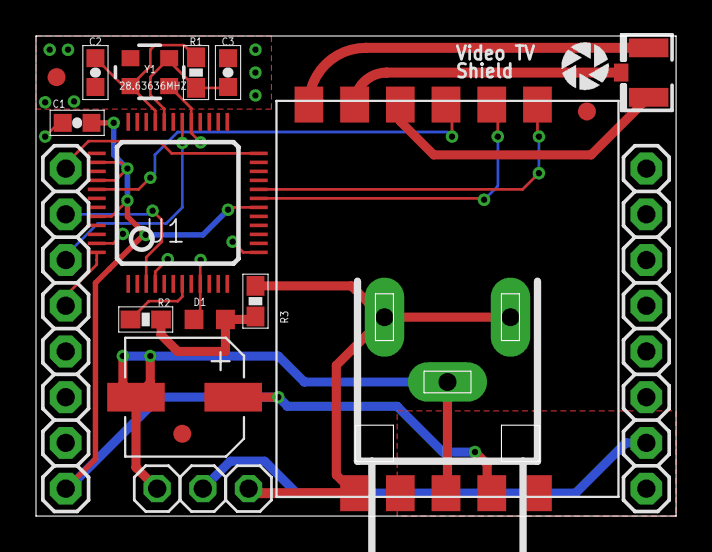
[picture p124: board tv.brd from above]

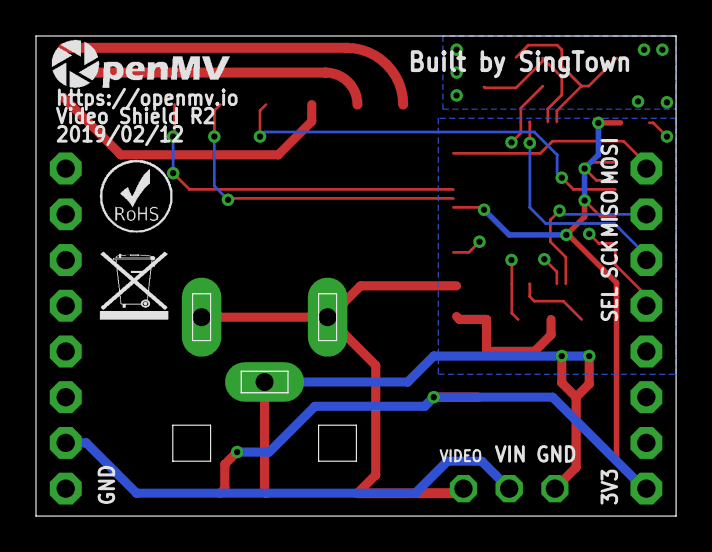
[picture p125: board tv.brd from below]

Board: 2 copper layers, 35.6 x 26.7 mm, 24 parts (3 on the bottom side), 18 nets.

Other parts of the board:
U$3: OMV-LOGO-SMALL
U$5: ROHS
U$6: WEEE
U$9: OPENMV-LOGO
