PyCubed-Mini/OpenMV_Camera/openmv-official-repo-for-reference/shields/sensor/sensor.brd

## EAGLE design openmv-official-repo-for-reference/shields/sensor/sensor.brd (2019-10-06)

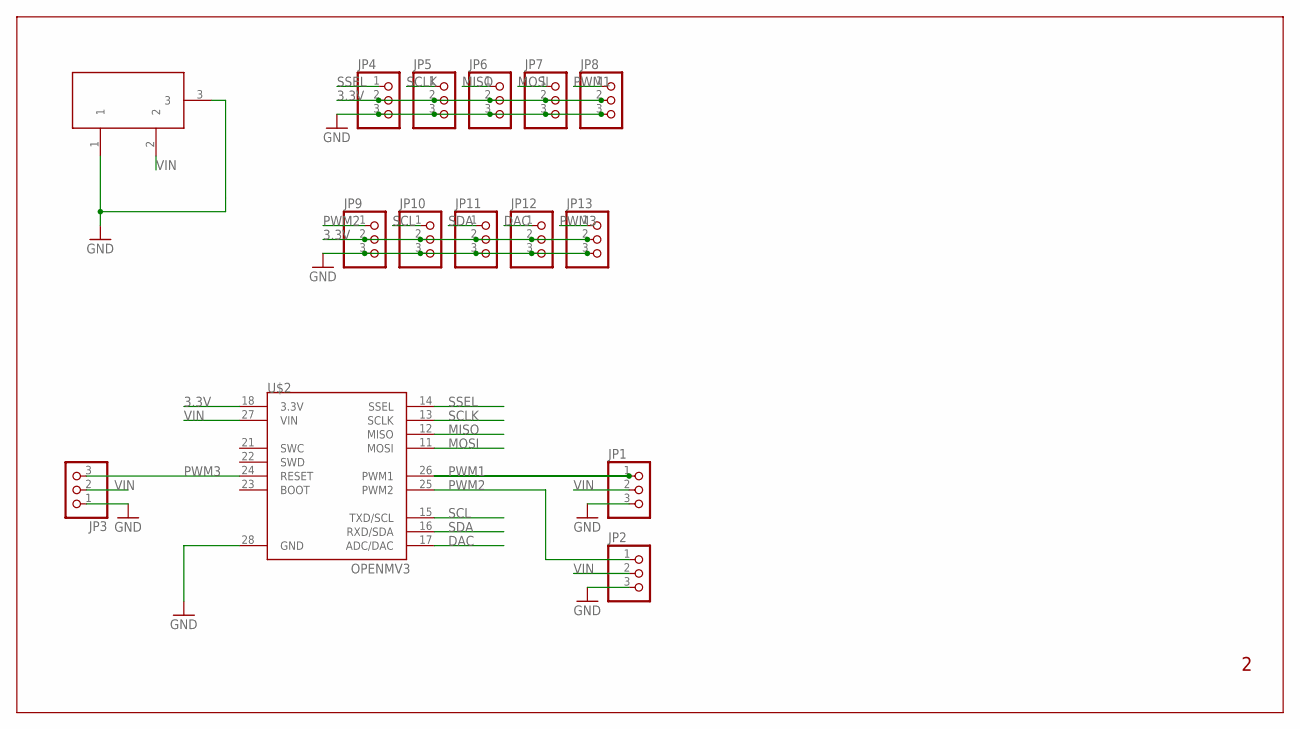
[picture p126: schematic sensor.sch]

Parts:
JP1, JP2, JP3, JP4, JP5, JP6, JP7, JP8, JP9, JP10, JP11, JP12, JP13: PINHEAD_PINHD-1X3; PINHEAD_1X03
U$2: OPENMV3
X1: DC21MMX; DC-21MM

Connections:
3.3V: JP4.2, JP5.2, JP6.2, JP7.2, JP8.2, JP9.2, JP10.2, JP11.2, JP12.2, JP13.2, U$2.18 (3.3V)
DAC: JP12.1, U$2.17 (ADC/DAC)
GND: JP1.3, JP2.3, JP3.1, JP4.3, JP5.3, JP6.3, JP7.3, JP8.3, JP9.3, JP10.3, JP11.3, JP12.3, JP13.3, U$2.28 (GND), X1.1, X1.3
MISO: JP6.1, U$2.12 (MISO)
MOSI: JP7.1, U$2.11 (MOSI)
PWM1: JP1.1, JP8.1, U$2.26 (PWM1)
PWM2: JP2.1, JP9.1, U$2.25 (PWM2)
PWM3: JP3.3, JP13.1, U$2.24 (RESET)
SCL: JP10.1, U$2.15 (TXD/SCL)
SCLK: JP5.1, U$2.13 (SCLK)
SDA: JP11.1, U$2.16 (RXD/SDA)
SSEL: JP4.1, U$2.14 (SSEL)
VIN: JP1.2, JP2.2, JP3.2, U$2.27 (VIN), X1.2

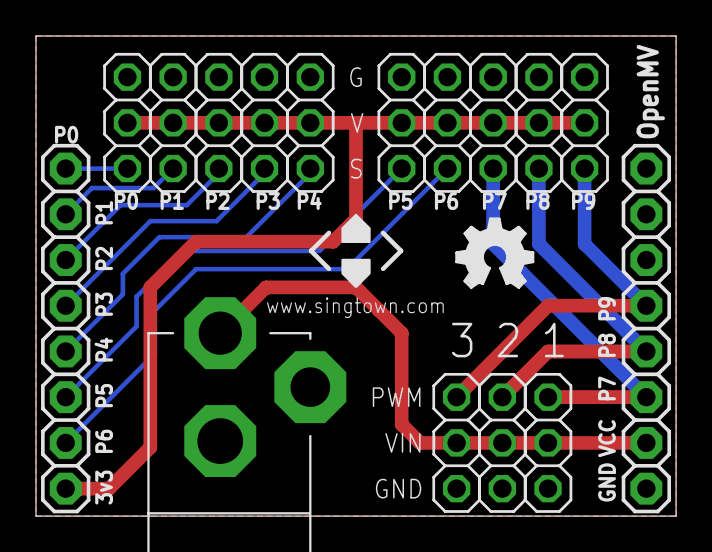
[picture p127: board sensor.brd from above]

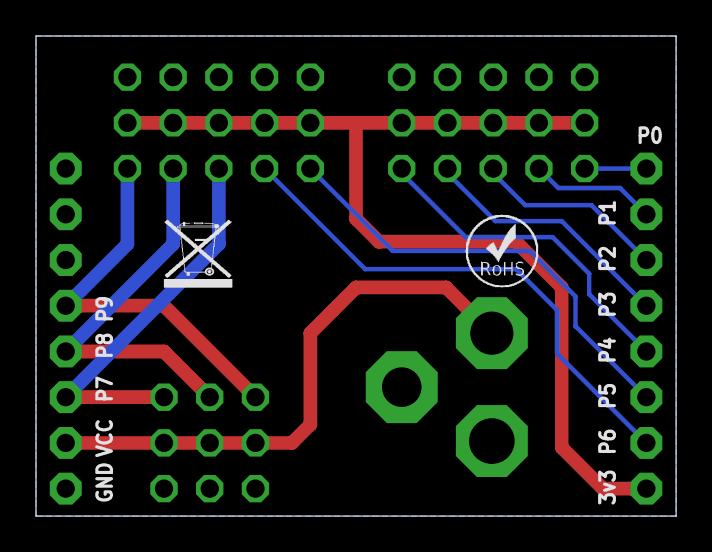
[picture p128: board sensor.brd from below]

Board: 2 copper layers, 35.6 x 26.7 mm, 19 parts (2 on the bottom side), 13 nets.

Other parts of the board:
U$1: OSHW_FILLX150_NOTEXT
U$3: ROHS
U$4: WEEE
U$8: SINGTOWN_LOGO; SINGTOWN_5MM
