PyCubed-Mini/OpenMV_Camera/openmv-official-repo-for-reference/openmv4/sensors/OV7725/OV7725.brd

## EAGLE design openmv-official-repo-for-reference/openmv4/sensors/OV7725/OV7725.brd (2019-10-06)

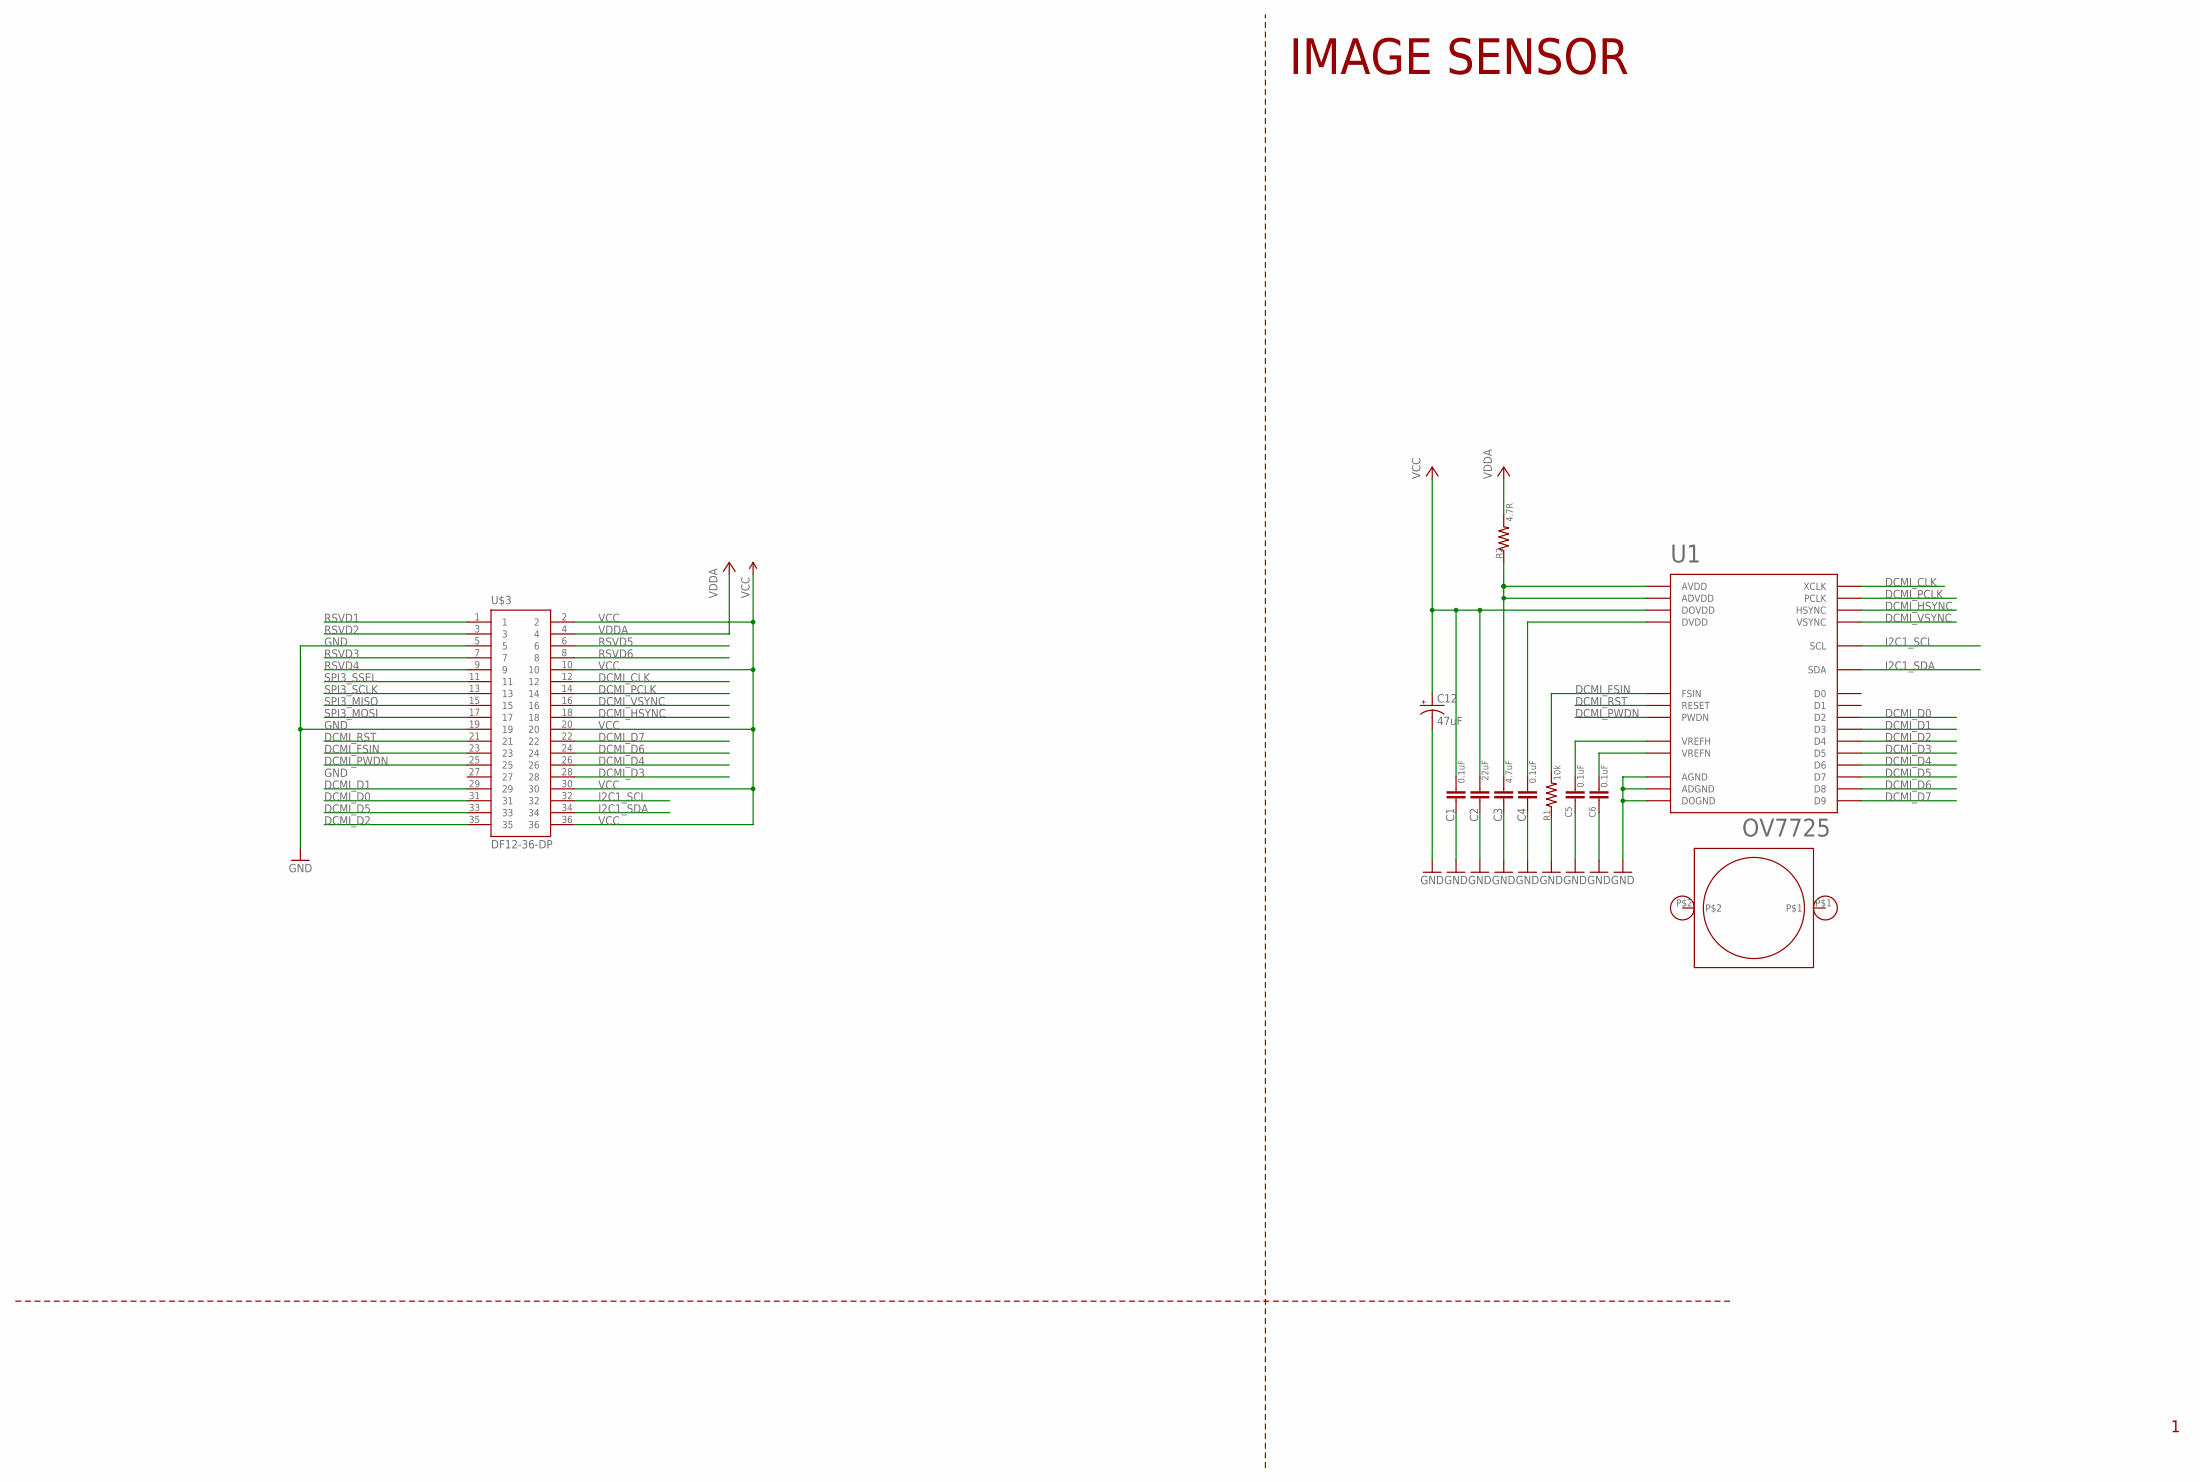
[picture p129: schematic OV7725.sch]

Parts:
C1, C4, C5, C6: 0.1uF; 0603-CAP
C2: 22uF; 0805
C3: 4.7uF; 0603-CAP
C12: 47uF; EIA3216
LM1: LENSMOUNT20MM; LENSMOUNT-20MM
R1: 10k; 0603-RES
R2: 4.7R; 0603-RES
U1: OV7725; CSP2-28
U$3: DF12-36-DP

Connections:
AVDD: C3.1, R2.1, U1.A1 (ADVDD), U1.B3 (AVDD)
DCMI_CLK: U1.F3 (XCLK), U$3.12
DCMI_D0: U1.F5 (D2), U$3.31
DCMI_D1: U1.F2 (D3), U$3.29
DCMI_D2: U1.D6 (D4), U$3.35
DCMI_D3: U1.D1 (D5), U$3.28
DCMI_D4: U1.E6 (D6), U$3.26
DCMI_D5: U1.E1 (D7), U$3.33
DCMI_D6: U1.F6 (D8), U$3.24
DCMI_D7: U1.F1 (D9), U$3.22
DCMI_FSIN: R1.2, U1.A4 (FSIN), U$3.23
DCMI_HSYNC: U1.B6 (HSYNC), U$3.18
DCMI_PCLK: U1.E4 (PCLK), U$3.14
DCMI_PWDN: U1.C1 (PWDN), U$3.25
DCMI_RST: U1.A2 (RESET), U$3.21
DCMI_VSYNC: U1.C6 (VSYNC), U$3.16
GND: C1.2, C2.2, C3.2, C4.2, C5.2, C6.2, C12.C (-), R1.1, U1.B1 (ADGND), U1.B4 (AGND), U1.F4 (DOGND), U$3.5, U$3.19
I2C1_SCL: U1.A5 (SCL), U$3.32
I2C1_SDA: U1.B5 (SDA), U$3.34
unnamed: C5.1, U1.A3 (VREFH)
unnamed: C6.1, U1.B2 (VREFN)
unnamed: C4.1, U1.E3 (DVDD)
RSVD1: U$3.1
RSVD2: U$3.3
RSVD3: U$3.7
RSVD4: U$3.9
RSVD5: U$3.6
RSVD6: U$3.8
SPI3_MISO: U$3.15
SPI3_MOSI: U$3.17
SPI3_SCLK: U$3.13
SPI3_SSEL: U$3.11
VCC: C1.1, C2.1, C12.A (+), U1.E5 (DOVDD), U$3.2, U$3.10, U$3.20, U$3.30, U$3.36
VDDA: R2.2, U$3.4

Notes on the sheet:
IMAGE SENSOR

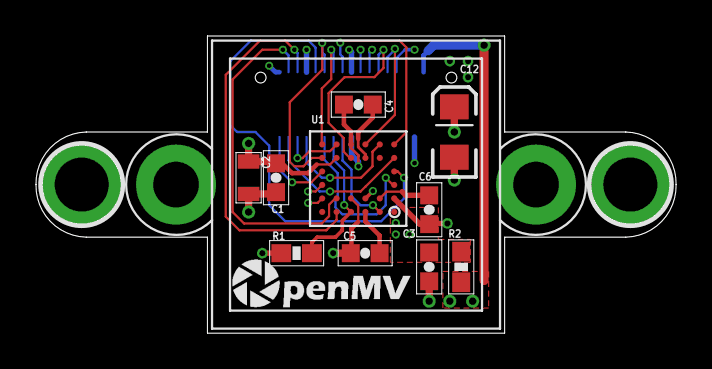
[picture p130: board OV7725.brd from above]

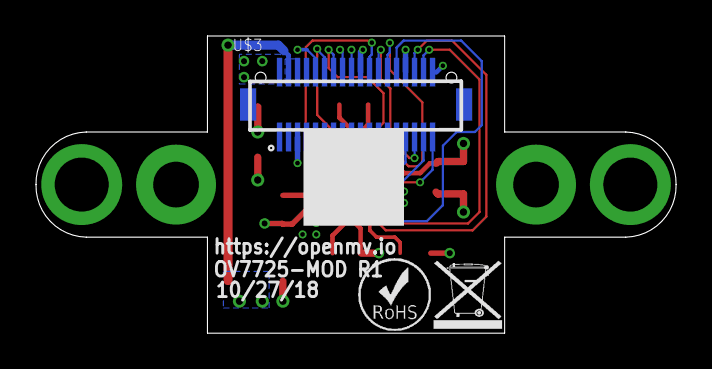
[picture p131: board OV7725.brd from below]

Board: 4 copper layers, 35.6 x 16.5 mm, 15 parts (3 on the bottom side), 24 nets.

Other parts of the board:
U$1: WEEE
U$2: ROHS
U$4: OMV-LOGO-SMALL
