PyCubed-Mini/OpenMV_Camera/openmv-official-repo-for-reference/openmv4/sensors/LEPTON/LEPTON.brd

## EAGLE design openmv-official-repo-for-reference/openmv4/sensors/LEPTON/LEPTON.brd (2019-10-06)

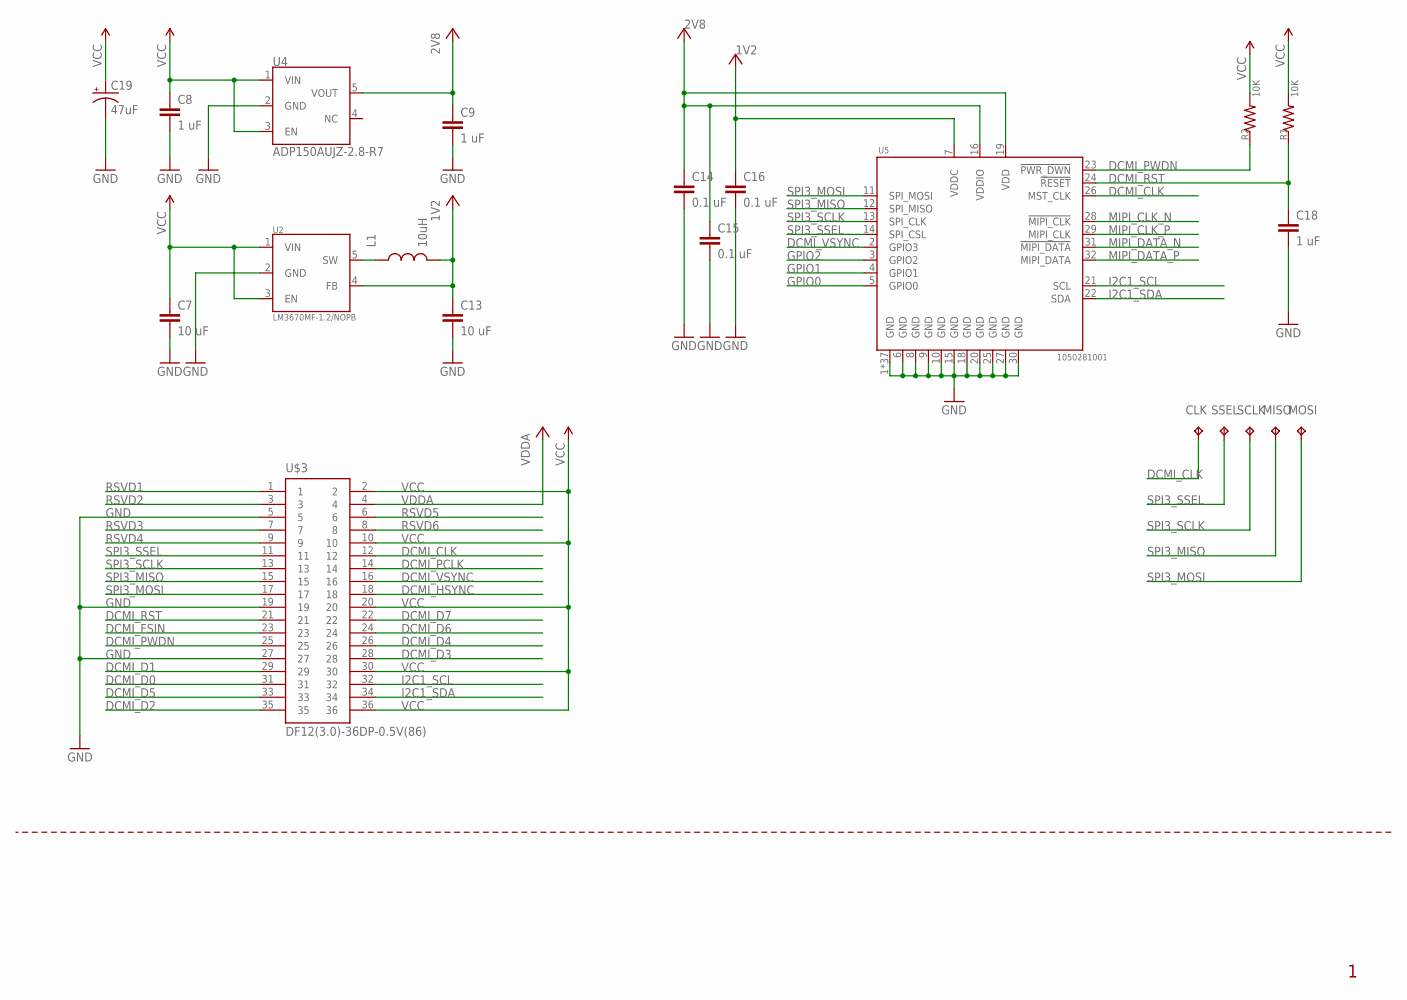
[picture p132: schematic LEPTON.sch]

Parts:
C7, C13: 10 uF; 0805
C8, C9, C18: 1 uF; 0402-CAP
C14, C15, C16: 0.1 uF; 0402-CAP
C19: 47uF; EIA3216
CLK: TPTP16R; TP16R
L1: 10uH; 1210
MISO: TPTP16R; TP16R
MOSI: TPTP16R; TP16R
R1, R2: 10K; 0402-RES
SCLK: TPTP16R; TP16R
SSEL: TPTP16R; TP16R
U2: LM3670MF-1.2/NOPB; SOT23-5
U4: ADP150AUJZ-2.8-R7; SOT23-5
U5: 1050281001; CAM-SOCKET
U$3: DF12(3.0)-36DP-0.5V(86); DF12-36-DP

Connections:
1V2: C13.1, C16.1, L1.2, U2.4 (FB), U5.7 (VDDC)
2V8: C9.1, C14.1, C15.1, U4.5 (VOUT), U5.16 (VDDIO), U5.19 (VDD)
DCMI_CLK: CLK.TP, U5.26 (MST_CLK), U$3.12
DCMI_D0: U$3.31
DCMI_D1: U$3.29
DCMI_D2: U$3.35
DCMI_D3: U$3.28
DCMI_D4: U$3.26
DCMI_D5: U$3.33
DCMI_D6: U$3.24
DCMI_D7: U$3.22
DCMI_FSIN: U$3.23
DCMI_HSYNC: U$3.18
DCMI_PCLK: U$3.14
DCMI_PWDN: R2.1, U5.23 (!PWR_DWN), U$3.25
DCMI_RST: C18.1, R1.1, U5.24 (!RESET), U$3.21
DCMI_VSYNC: U5.2 (GPIO3), U$3.16
GND: C7.2, C8.2, C9.2, C13.2, C14.2, C15.2, C16.2, C18.2, C19.C (-), U2.2 (GND), U4.2 (GND), U5.1 (GND), U5.6 (GND), U5.8 (GND), U5.9 (GND), U5.10 (GND), U5.15 (GND), U5.18 (GND), U5.20 (GND), U5.25 (GND), U5.27 (GND), U5.30 (GND), U5.P$1 (GND), U5.P$2 (GND), U5.P$3 (GND), U5.P$4 (GND), U5.P$5 (GND), U5.P$6 (GND), U5.P$7 (GND), U5.P$8 (GND), U5.P$9 (GND), U5.P$10 (GND), U5.P$11 (GND), U5.P$12 (GND), U5.P$13 (GND), U5.P$14 (GND), U5.P$15 (GND), U5.P$16 (GND), U5.P$17 (GND), U5.P$18 (GND), U5.P$19 (GND), U5.P$20 (GND), U5.P$21 (GND), U5.P$22 (GND), U5.P$23 (GND), U5.P$24 (GND), U5.P$25 (GND), U5.P$26 (GND), U5.P$27 (GND), U5.P$28 (GND), U5.P$29 (GND), U5.P$30 (GND), U5.P$31 (GND), U5.P$32 (GND), U5.P$33 (GND), U5.P$34 (GND), U5.P$35 (GND), U5.P$36 (GND), U$3.5, U$3.19, U$3.27
GPIO0: U5.5 (GPIO0)
GPIO1: U5.4 (GPIO1)
GPIO2: U5.3 (GPIO2)
I2C1_SCL: U5.21 (SCL), U$3.32
I2C1_SDA: U5.22 (SDA), U$3.34
MIPI_CLK_N: U5.28 (!MIPI_CLK)
MIPI_CLK_P: U5.29 (MIPI_CLK)
MIPI_DATA_N: U5.31 (!MIPI_DATA)
MIPI_DATA_P: U5.32 (MIPI_DATA)
unnamed: L1.1, U2.5 (SW)
RSVD1: U$3.1
RSVD2: U$3.3
RSVD3: U$3.7
RSVD4: U$3.9
RSVD5: U$3.6
RSVD6: U$3.8
SPI3_MISO: MISO.TP, U5.12 (SPI_MISO), U$3.15
SPI3_MOSI: MOSI.TP, U5.11 (SPI_MOSI), U$3.17
SPI3_SCLK: SCLK.TP, U5.13 (SPI_CLK), U$3.13
SPI3_SSEL: SSEL.TP, U5.14 (SPI_CSL), U$3.11
VCC: C7.1, C8.1, C19.A (+), R1.2, R2.2, U2.1 (VIN), U2.3 (EN), U4.1 (VIN), U4.3 (EN), U$3.2, U$3.10, U$3.20, U$3.30, U$3.36
VDDA: U$3.4

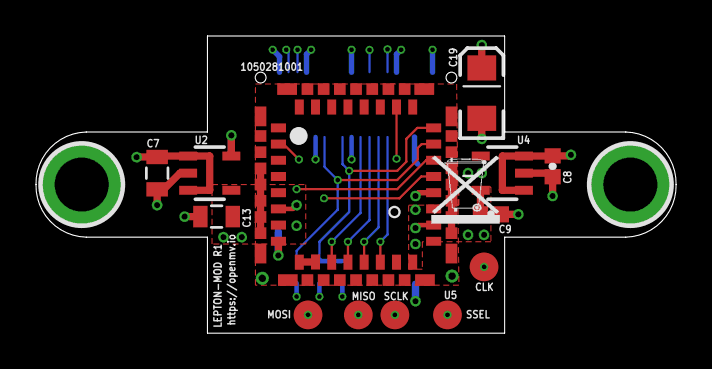
[picture p133: board LEPTON.brd from above]

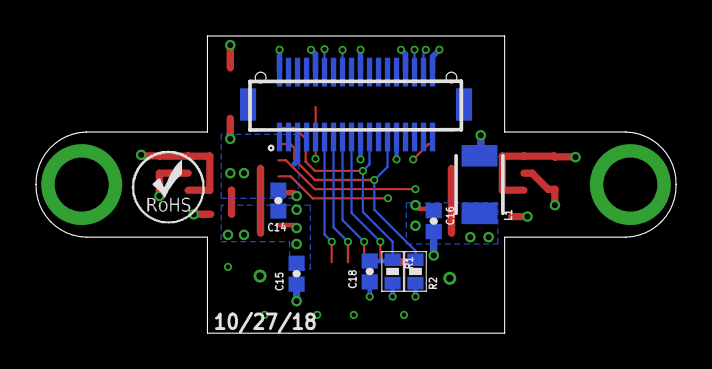
[picture p134: board LEPTON.brd from below]

Board: 4 copper layers, 35.6 x 16.5 mm, 23 parts (9 on the bottom side), 15 nets.

Other parts of the board:
U$4: WEEE
U$5: ROHS
