PyCubed-Mini/OpenMV_Camera/openmv-official-repo-for-reference/shields/panandtilt/panandtilt.brd

## EAGLE design openmv-official-repo-for-reference/shields/panandtilt/panandtilt.brd (2019-10-06)

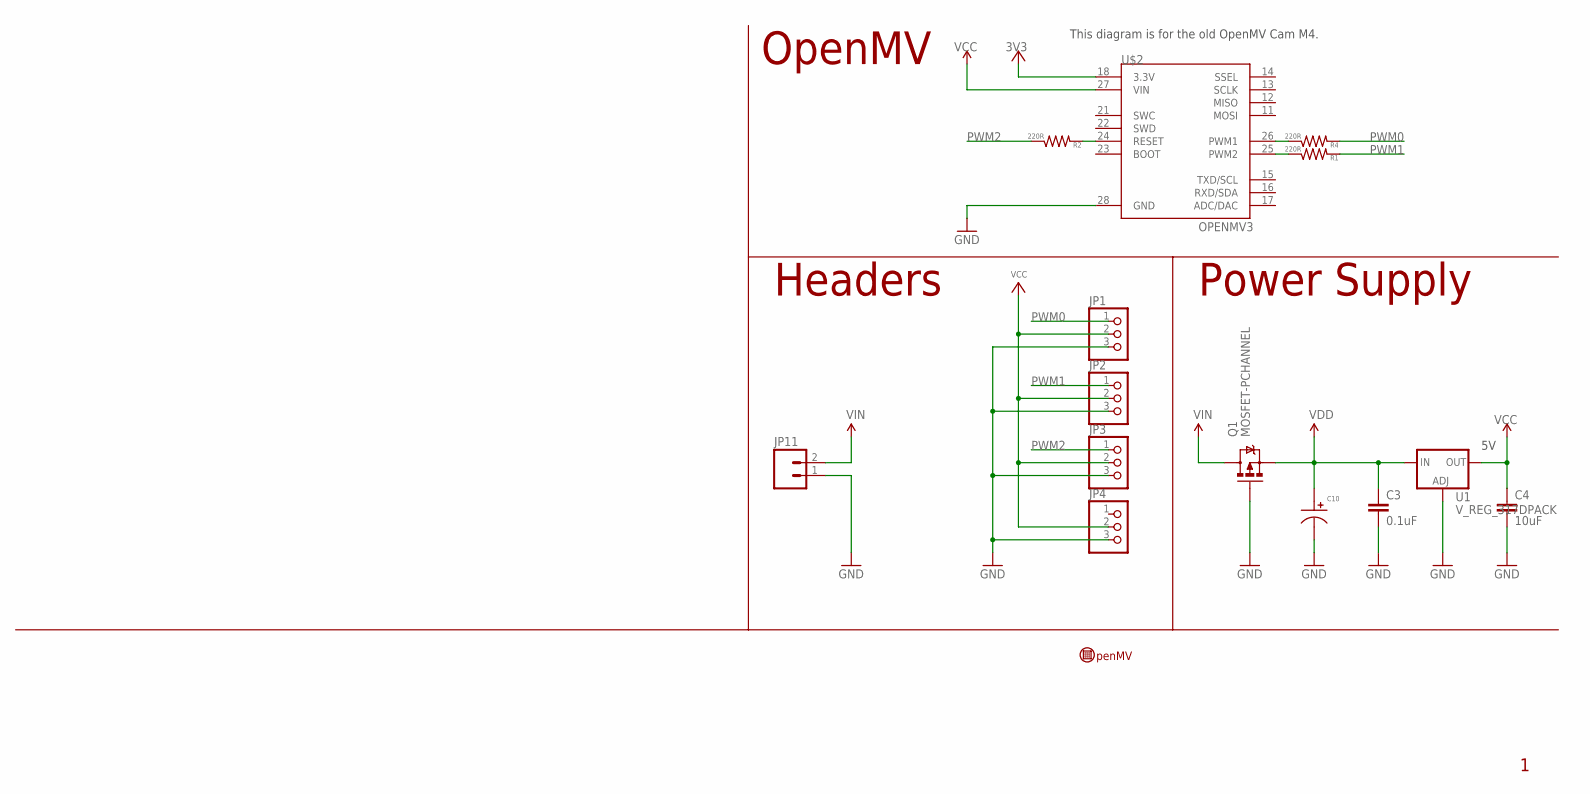
[picture p135: schematic panandtilt.sch]

Parts:
C3: 0.1uF; 0603-CAP
C4: 10uF; 0805
C10: CAPACITOR_P_10MM; CP10MM
JP1, JP2, JP3, JP4: PINHD-1X3; 1X03
JP11: M023.5MM; SCREWTERMINAL-3.5MM-2
Q1: MOSFET-PCHANNEL; SOT23-3
R1, R2, R4: 220R; 0603-RES
U1: V_REG_317DPACK; V-REG_DPACK
U$2: OPENMV3
U$9: OPENMV-LOGO

Connections:
3V3: U$2.18 (3.3V)
GND: C3.2, C4.2, C10.P$2, JP1.3, JP2.3, JP3.3, JP4.3, JP11.1, Q1.1 (G), U1.1 (ADJ), U$2.28 (GND)
unnamed: R4.1, U$2.26 (PWM1)
unnamed: R1.1, U$2.25 (PWM2)
unnamed: R2.2, U$2.24 (RESET)
PWM0: JP1.1, R4.2
PWM1: JP2.1, R1.2
PWM2: JP3.1, R2.1
VCC: C4.1, JP1.2, JP2.2, JP3.2, JP4.2, U1.4 (OUT), U$2.27 (VIN)
VDD: C3.1, C10.P$1, Q1.2 (S), U1.3 (IN)
VIN: JP11.2, Q1.3 (D)

Notes on the sheet:
Headers
OpenMV
Power Supply
This diagram is for the old OpenMV Cam M4.

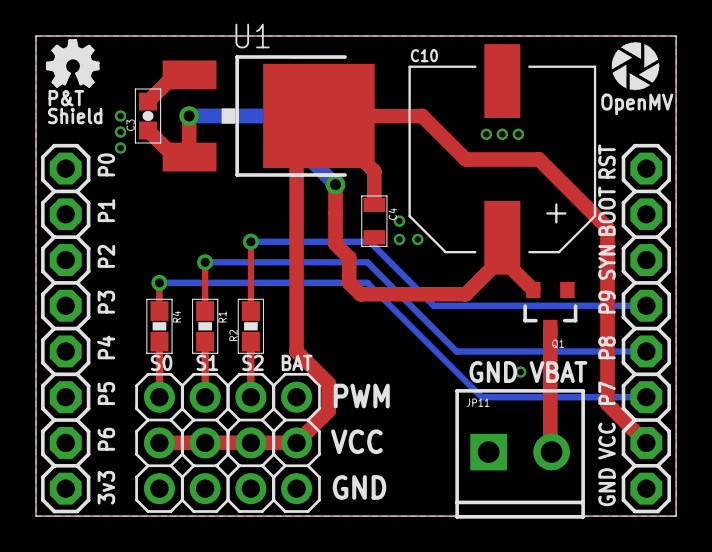
[picture p136: board panandtilt.brd from above]

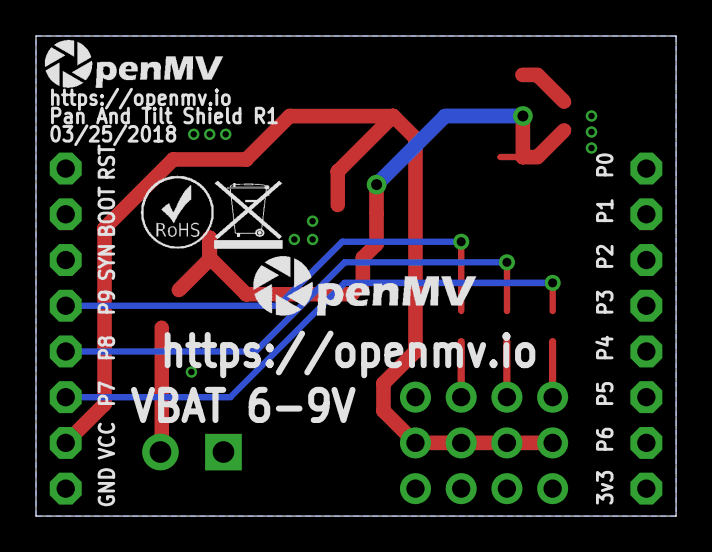
[picture p137: board panandtilt.brd from below]

Board: 2 copper layers, 35.6 x 26.7 mm, 20 parts (4 on the bottom side), 10 nets.

Other parts of the board:
U$3: OMV-LOGO
U$5: ROHS
U$6: WEEE
U$10: OMV-LOGO-SMALL
U$11: OSHW_FILLX100_NOTEXT
