PyCubed-Mini/OpenMV_Camera/openmv-official-repo-for-reference/shields/can/can.brd

## EAGLE design openmv-official-repo-for-reference/shields/can/can.brd (2019-10-06)

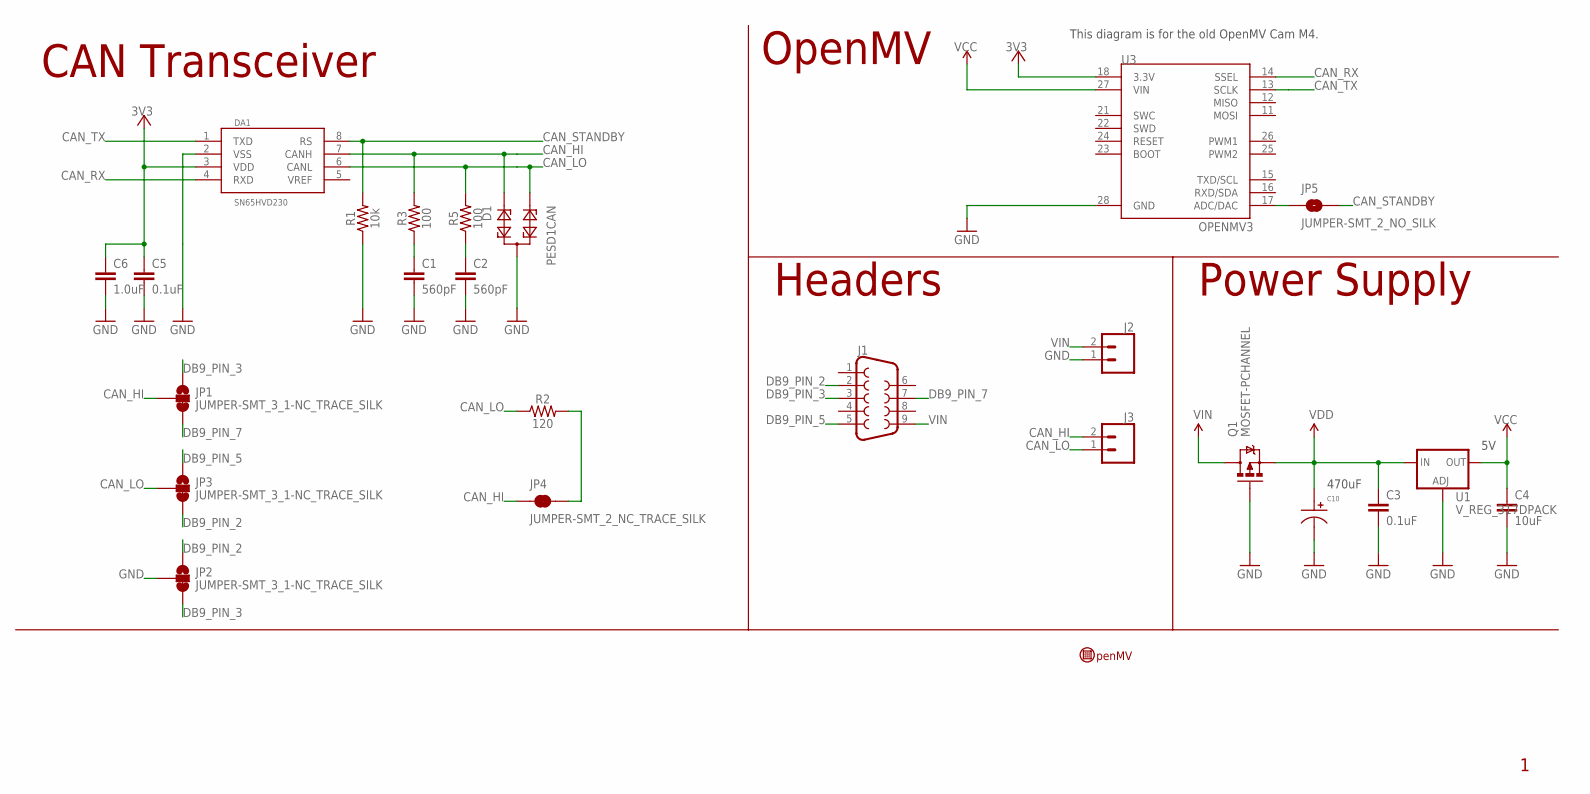
[picture p138: schematic can.sch]

Parts:
C1, C2: 560pF; 0603
C3: 0.1uF; 0603-CAP
C4: 10uF; 0805
C5: 0.1uF; 0603
C6: 1.0uF; 0603
C10: CAPACITOR_P_10MM; CP10MM
D1: PESD1CAN; SOT23
DA1: SN65HVD230; SO08
J1: DB9MALE; DB9_MALE
J2, J3: CONN_02; 1X02
JP1, JP2, JP3: JUMPER-SMT_3_1-NC_TRACE_SILK; SMT-JUMPER_3_1-NC_TRACE_SILK
JP4: JUMPER-SMT_2_NC_TRACE_SILK; SMT-JUMPER_2_NC_TRACE_SILK
JP5: JUMPER-SMT_2_NO_SILK; SMT-JUMPER_2_NO_SILK
Q1: MOSFET-PCHANNEL; SOT23-3
R1: 10k; 0603
R2: 120; 0603
R3, R5: 100; 0603
U1: V_REG_317DPACK; V-REG_DPACK
U3: OPENMV3
U$9: OPENMV-LOGO

Connections:
3V3: C5.1, C6.1, DA1.3 (VDD), U3.18 (3.3V)
CAN_HI: D1.1, DA1.7 (CANH), J3.2, JP1.2, JP4.1, R3.2
CAN_HI_BALANCE: C1.1, R3.1
CAN_LO: D1.2, DA1.6 (CANL), J3.1, JP3.2, R2.1, R5.2
CAN_LO_BALANCE: C2.1, R5.1
CAN_RX: DA1.4 (RXD), U3.14 (SSEL)
CAN_STANDBY: DA1.8 (RS), JP5.2, R1.2
CAN_TX: DA1.1 (TXD), U3.13 (SCLK)
DB9_PIN_2: J1.2, JP2.1, JP3.3
DB9_PIN_3: J1.3, JP1.1, JP2.3
DB9_PIN_5: J1.5, JP3.1
DB9_PIN_7: J1.7, JP1.3
GND: C1.2, C2.2, C3.2, C4.2, C5.2, C6.2, C10.P$2, D1.3, DA1.2 (VSS), J2.1, JP2.2, Q1.1 (G), R1.1, U1.1 (ADJ), U3.28 (GND)
OPENMV_STANDBY: JP5.1, U3.17 (ADC/DAC)
TERM: JP4.2, R2.2
VCC: C4.1, U1.4 (OUT), U3.27 (VIN)
VDD: C3.1, C10.P$1, Q1.2 (S), U1.3 (IN)
VIN: J1.9, J2.2, Q1.3 (D)

Notes on the sheet:
Headers
OpenMV
Power Supply
This diagram is for the old OpenMV Cam M4.
470uF
CAN Transceiver

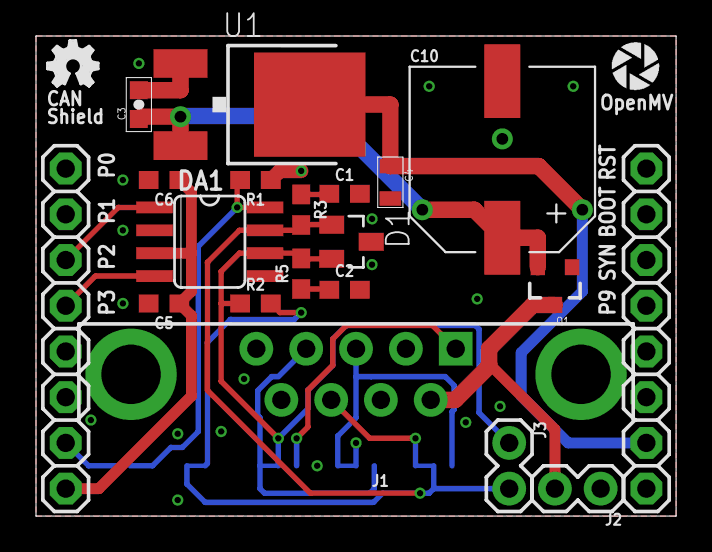
[picture p139: board can.brd from above]

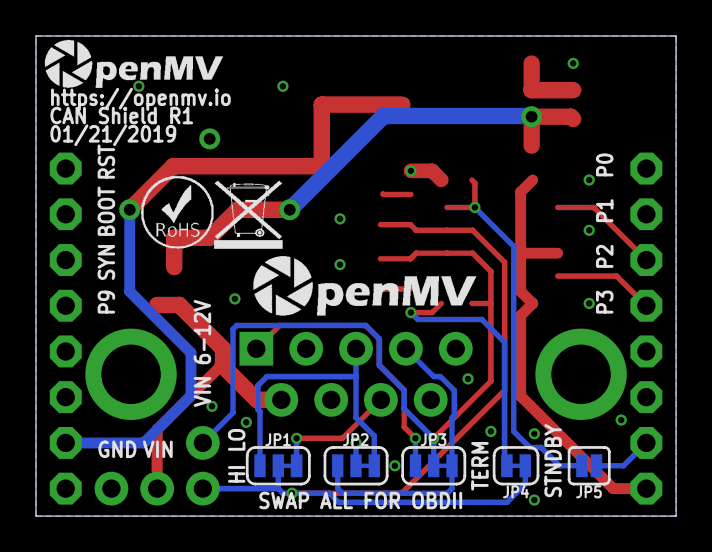
[picture p140: board can.brd from below]

Board: 2 copper layers, 35.6 x 26.7 mm, 30 parts (9 on the bottom side), 18 nets.

Other parts of the board:
U$3: OMV-LOGO
U$5: ROHS
U$6: WEEE
U$10: OMV-LOGO-SMALL
U$11: OSHW_FILLX100_NOTEXT
