PyCubed-Mini/OpenMV_Camera/openmv-official-repo-for-reference/shields/motor/motor.brd

## EAGLE design openmv-official-repo-for-reference/shields/motor/motor.brd (2019-10-06)

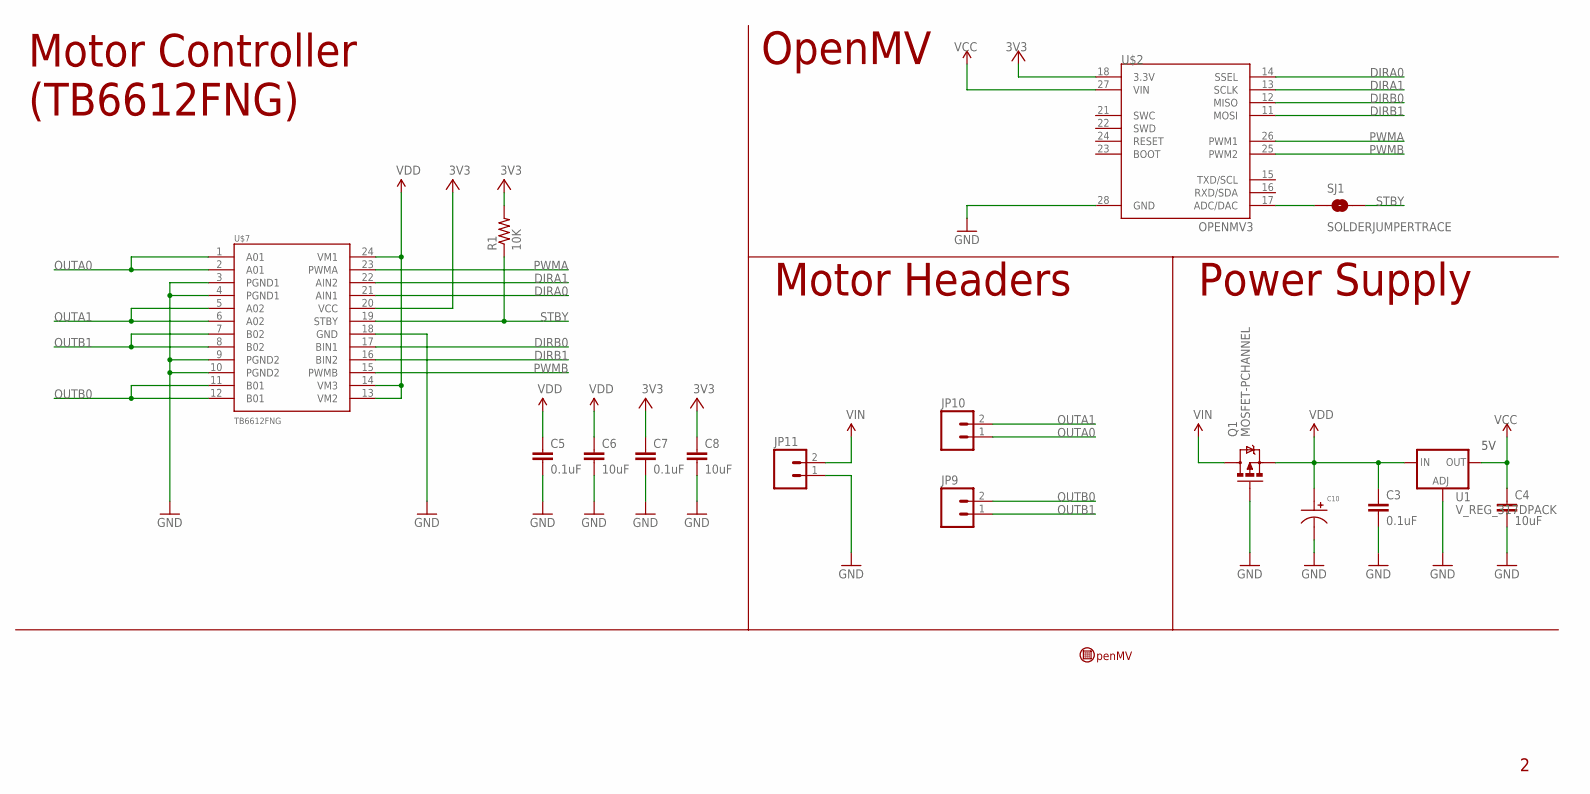
[picture p141: schematic motor.sch]

Parts:
C3, C5, C7: 0.1uF; 0603-CAP
C4, C6, C8: 10uF; 0805
C10: CAPACITOR_P_10MM; CP10MM
JP9, JP10, JP11: M023.5MM; SCREWTERMINAL-3.5MM-2
Q1: MOSFET-PCHANNEL; SOT23-3
R1: 10K; 0603-RES
SJ1: SOLDERJUMPERTRACE; SJ_2S-TRACE
U1: V_REG_317DPACK; V-REG_DPACK
U$2: OPENMV3
U$7: TB6612FNG; SSOP24
U$9: OPENMV-LOGO

Connections:
3V3: C7.1, C8.1, R1.2, U$2.18 (3.3V), U$7.20 (VCC)
DIRA0: U$2.14 (SSEL), U$7.21 (AIN1)
DIRA1: U$2.13 (SCLK), U$7.22 (AIN2)
DIRB0: U$2.12 (MISO), U$7.17 (BIN1)
DIRB1: U$2.11 (MOSI), U$7.16 (BIN2)
GND: C3.2, C4.2, C5.2, C6.2, C7.2, C8.2, C10.P$2, JP11.1, Q1.1 (G), U1.1 (ADJ), U$2.28 (GND), U$7.3 (PGND1), U$7.4 (PGND1), U$7.9 (PGND2), U$7.10 (PGND2), U$7.18 (GND)
OUTA0: JP10.1, U$7.1 (A01), U$7.2 (A01)
OUTA1: JP10.2, U$7.5 (A02), U$7.6 (A02)
OUTB0: JP9.2, U$7.11 (B01), U$7.12 (B01)
OUTB1: JP9.1, U$7.7 (B02), U$7.8 (B02)
PWMA: U$2.26 (PWM1), U$7.23 (PWMA)
PWMB: U$2.25 (PWM2), U$7.15 (PWMB)
STBY: R1.1, SJ1.2, U$7.19 (STBY)
STBY_TRACE: SJ1.1, U$2.17 (ADC/DAC)
VCC: C4.1, U1.4 (OUT), U$2.27 (VIN)
VDD: C3.1, C5.1, C6.1, C10.P$1, Q1.2 (S), U1.3 (IN), U$7.13 (VM2), U$7.14 (VM3), U$7.24 (VM1)
VIN: JP11.2, Q1.3 (D)

Notes on the sheet:
Motor Controller (TB6612FNG)
Motor Headers
OpenMV
Power Supply

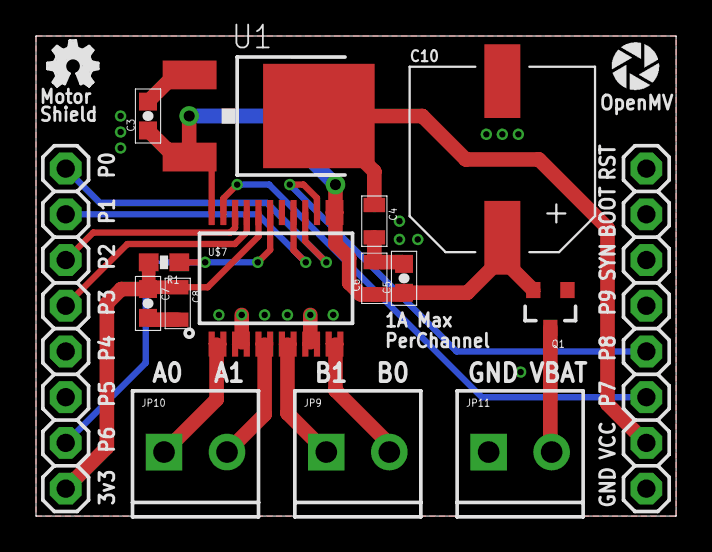
[picture p142: board motor.brd from above]

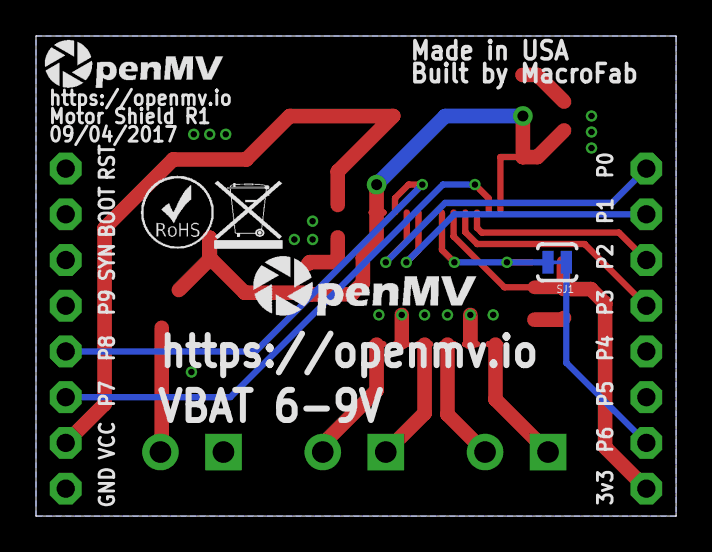
[picture p143: board motor.brd from below]

Board: 2 copper layers, 35.6 x 26.7 mm, 22 parts (5 on the bottom side), 17 nets.

Other parts of the board:
U$3: OMV-LOGO
U$5: ROHS
U$6: WEEE
U$10: OMV-LOGO-SMALL
U$11: OSHW_FILLX100_NOTEXT
