PyCubed-Mini/OpenMV_Camera/openmv-official-repo-for-reference/shields/rs232/rs232.brd

## EAGLE design openmv-official-repo-for-reference/shields/rs232/rs232.brd (2019-10-06)

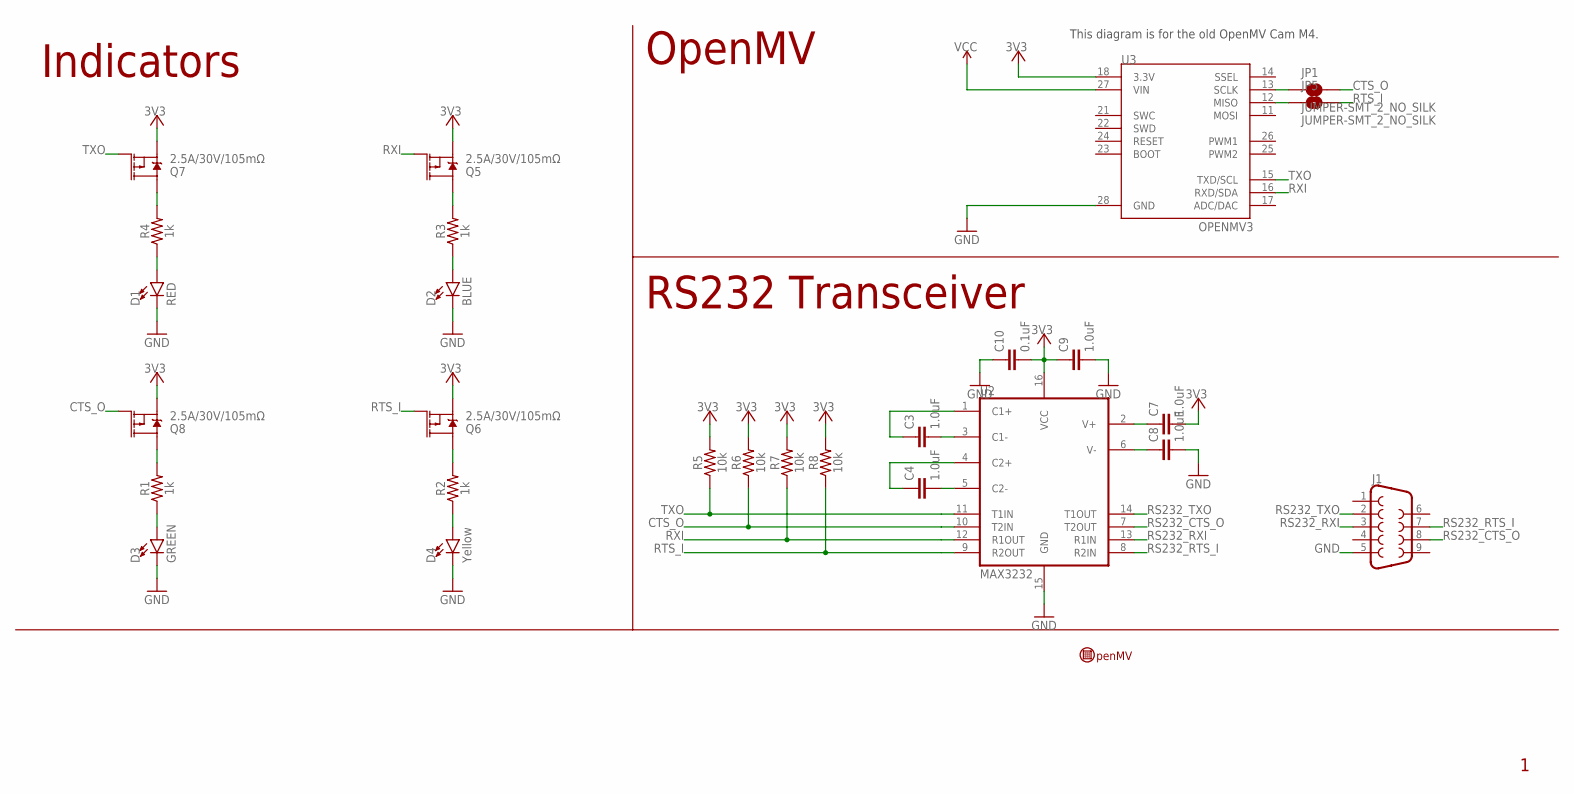
[picture p144: schematic rs232.sch]

Parts:
C3, C4, C7, C8, C9: 1.0uF; 0603
C10: 0.1uF; 0603
D1: RED; LED-0603
D2: BLUE; LED-0603
D3: GREEN; LED-0603
D4: Yellow; LED-0603
J1: DB9FEMALE; DB9
JP1, JP5: JUMPER-SMT_2_NO_SILK; SMT-JUMPER_2_NO_SILK
Q5, Q6, Q7, Q8: 2.5A/30V/105mΩ; SOT23-3
R1, R2, R3, R4: 1k; 0603
R5, R6, R7, R8: 10k; 0603
U2: MAX3232; SO16
U3: OPENMV3
U$9: OPENMV-LOGO

Connections:
3V3: C7.2, C9.1, C10.2, Q5.2 (S), Q6.2 (S), Q7.2 (S), Q8.2 (S), R5.2, R6.2, R7.2, R8.2, U2.16 (VCC), U3.18 (3.3V)
CTS_O: JP1.2, Q8.1 (G), R6.1, U2.10 (T2IN)
GND: C8.2, C9.2, C10.1, D1.C, D2.C, D3.C, D4.C, J1.5, U2.15 (GND), U3.28 (GND)
INT_CTS_O: JP1.1, U3.13 (SCLK)
INT_RTS_I: JP5.1, U3.12 (MISO)
unnamed: C4.2, U2.5 (C2-)
unnamed: C4.1, U2.4 (C2+)
unnamed: C3.2, U2.3 (C1-)
unnamed: C3.1, U2.1 (C1+)
unnamed: C8.1, U2.6 (V-)
unnamed: Q7.3 (D), R4.2
unnamed: Q5.3 (D), R3.2
unnamed: Q6.3 (D), R2.2
unnamed: C7.1, U2.2 (V+)
unnamed: Q8.3 (D), R1.2
unnamed: D4.A, R2.1
unnamed: D3.A, R1.1
unnamed: D2.A, R3.1
unnamed: D1.A, R4.1
RS232_CTS_O: J1.8, U2.7 (T2OUT)
RS232_RTS_I: J1.7, U2.8 (R2IN)
RS232_RXI: J1.3, U2.13 (R1IN)
RS232_TXO: J1.2, U2.14 (T1OUT)
RTS_I: JP5.2, Q6.1 (G), R8.1, U2.9 (R2OUT)
RXI: Q5.1 (G), R7.1, U2.12 (R1OUT), U3.16 (RXD/SDA)
TXO: Q7.1 (G), R5.1, U2.11 (T1IN), U3.15 (TXD/SCL)
VCC: U3.27 (VIN)

Notes on the sheet:
RS232 Transceiver
OpenMV
This diagram is for the old OpenMV Cam M4.
Indicators

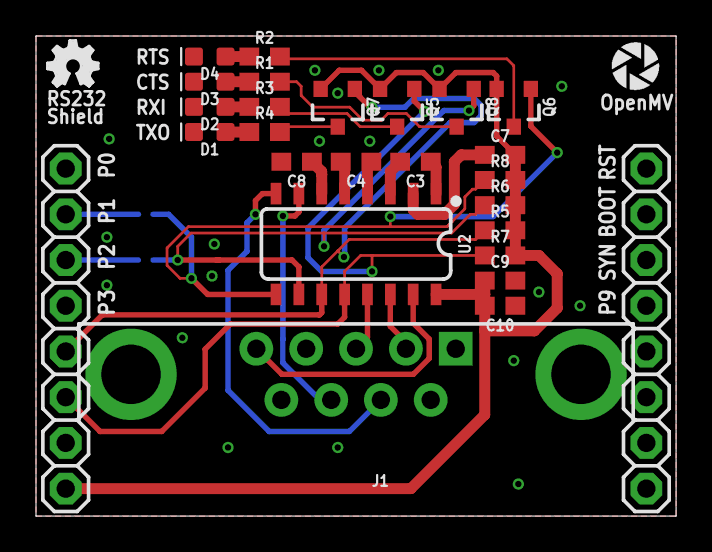
[picture p145: board rs232.brd from above]

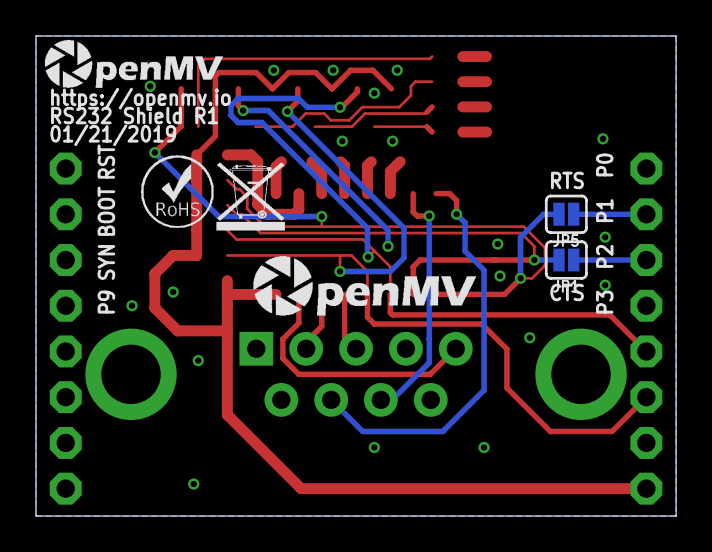
[picture p146: board rs232.brd from below]

Board: 2 copper layers, 35.6 x 26.7 mm, 33 parts (6 on the bottom side), 26 nets.

Other parts of the board:
U$3: OMV-LOGO
U$5: ROHS
U$6: WEEE
U$10: OMV-LOGO-SMALL
U$11: OSHW_FILLX100_NOTEXT
