PyCubed-Mini/OpenMV_Camera/openmv-official-repo-for-reference/openmv4/sensors/MT9V034/MT9V034.brd

## EAGLE design openmv-official-repo-for-reference/openmv4/sensors/MT9V034/MT9V034.brd (2019-10-06)

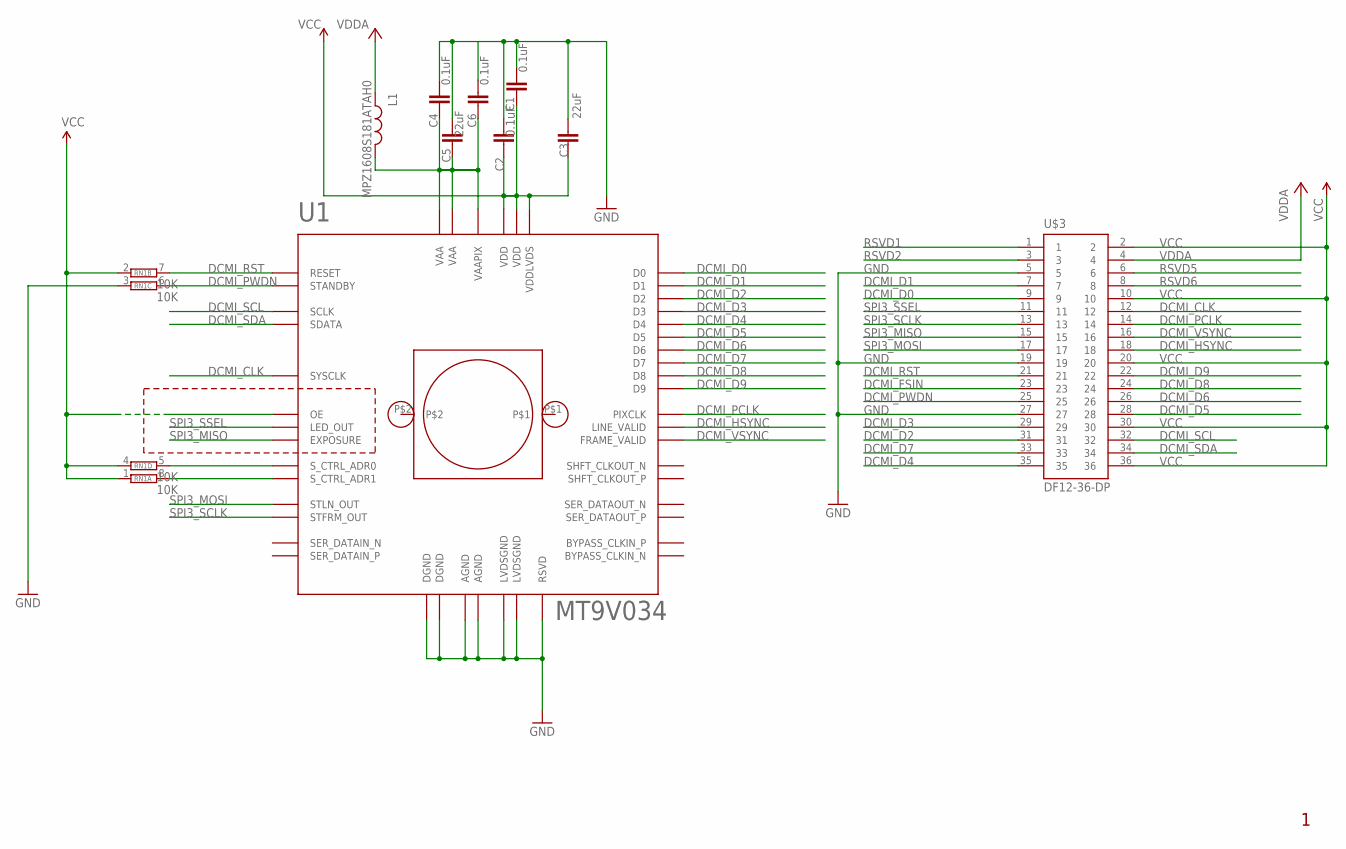
[picture p147: schematic MT9V034.sch]

Parts:
C1, C2, C4, C6: 0.1uF; 0402-CAP
C3, C5: 22uF; 0805
L1: MPZ1608S181ATAH0; 0603
LM1: LENSMOUNT20MM; LENSMOUNT-20MM
RN1: 10K; EXBV8V
U1: MT9V034; CLCC-48
U$3: DF12-36-DP

Connections:
DCMI_CLK: U1.P$47 (SYSCLK), U$3.12
DCMI_D0: U1.P$45 (D0), U$3.9
DCMI_D1: U1.P$44 (D1), U$3.7
DCMI_D2: U1.P$43 (D2), U$3.31
DCMI_D3: U1.P$42 (D3), U$3.29
DCMI_D4: U1.P$41 (D4), U$3.35
DCMI_D5: U1.P$15 (D5), U$3.28
DCMI_D6: U1.P$16 (D6), U$3.26
DCMI_D7: U1.P$17 (D7), U$3.33
DCMI_D8: U1.P$18 (D8), U$3.24
DCMI_D9: U1.P$19 (D9), U$3.22
DCMI_FSIN: U$3.23
DCMI_HSYNC: U1.P$20 (LINE_VALID), U$3.18
DCMI_PCLK: U1.P$46 (PIXCLK), U$3.14
DCMI_PWDN: RN1.6 (2), U1.P$33 (STANDBY), U$3.25
DCMI_RST: RN1.7 (2), U1.P$32 (RESET), U$3.21
DCMI_SCL: U1.P$25 (SCLK), U$3.32
DCMI_SDA: U1.P$24 (SDATA), U$3.34
DCMI_VSYNC: U1.P$21 (FRAME_VALID), U$3.16
GND: C1.2, C2.2, C3.1, C4.2, C5.1, C6.2, RN1.3 (1), U1.P$7 (LVDSGND), U1.P$12 (LVDSGND), U1.P$13 (DGND), U1.P$29 (RSVD), U1.P$34 (AGND), U1.P$38 (AGND), U1.P$48 (DGND), U$3.5, U$3.19, U$3.27
unnamed: RN1.5 (2), U1.P$30 (S_CTRL_ADR0)
unnamed: RN1.8 (2), U1.P$31 (S_CTRL_ADR1)
RSVD1: U$3.1
RSVD2: U$3.3
RSVD5: U$3.6
RSVD6: U$3.8
SPI3_MISO: U1.P$23 (EXPOSURE), U$3.15
SPI3_MOSI: U1.P$22 (STLN_OUT), U$3.17
SPI3_SCLK: U1.P$26 (STFRM_OUT), U$3.13
SPI3_SSEL: U1.P$27 (LED_OUT), U$3.11
VAA: C4.1, C5.2, C6.1, L1.2, U1.P$35 (VAA), U1.P$39 (VAA), U1.P$40 (VAAPIX)
VCC: C1.1, C2.1, C3.2, RN1.1, RN1.2 (1), RN1.4 (1), U1.P$1 (VDD), U1.P$6 (VDDLVDS), U1.P$14 (VDD), U1.P$28 (OE), U$3.2, U$3.10, U$3.20, U$3.30, U$3.36
VDDA: L1.1, U$3.4

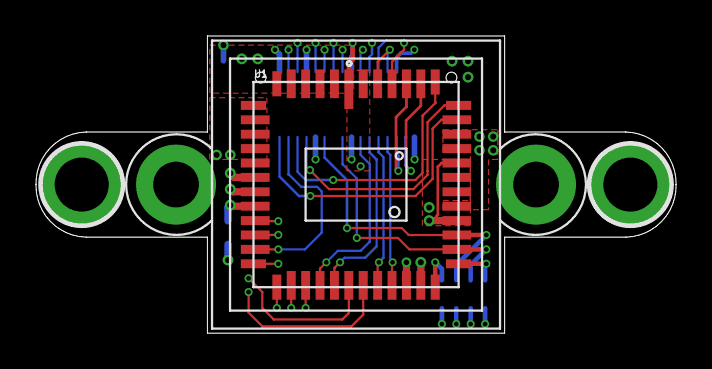
[picture p148: board MT9V034.brd from above]

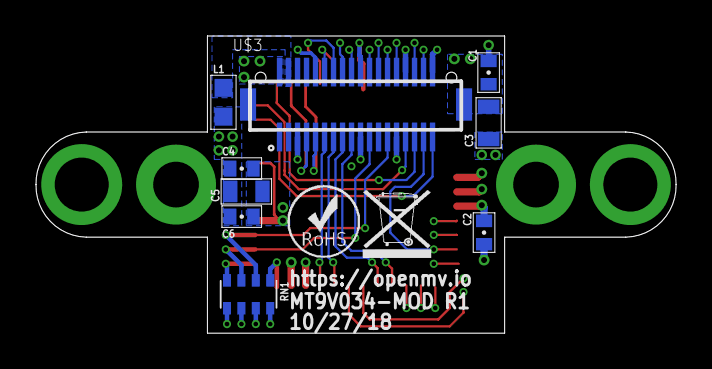
[picture p149: board MT9V034.brd from below]

Board: 4 copper layers, 35.6 x 16.5 mm, 13 parts (11 on the bottom side), 28 nets.

Other parts of the board:
U$1: WEEE
U$2: ROHS
