PyCubed-Mini/OpenMV_Camera/openmv-official-repo-for-reference/shields/uart/uart.brd

## EAGLE design openmv-official-repo-for-reference/shields/uart/uart.brd (2019-10-06)

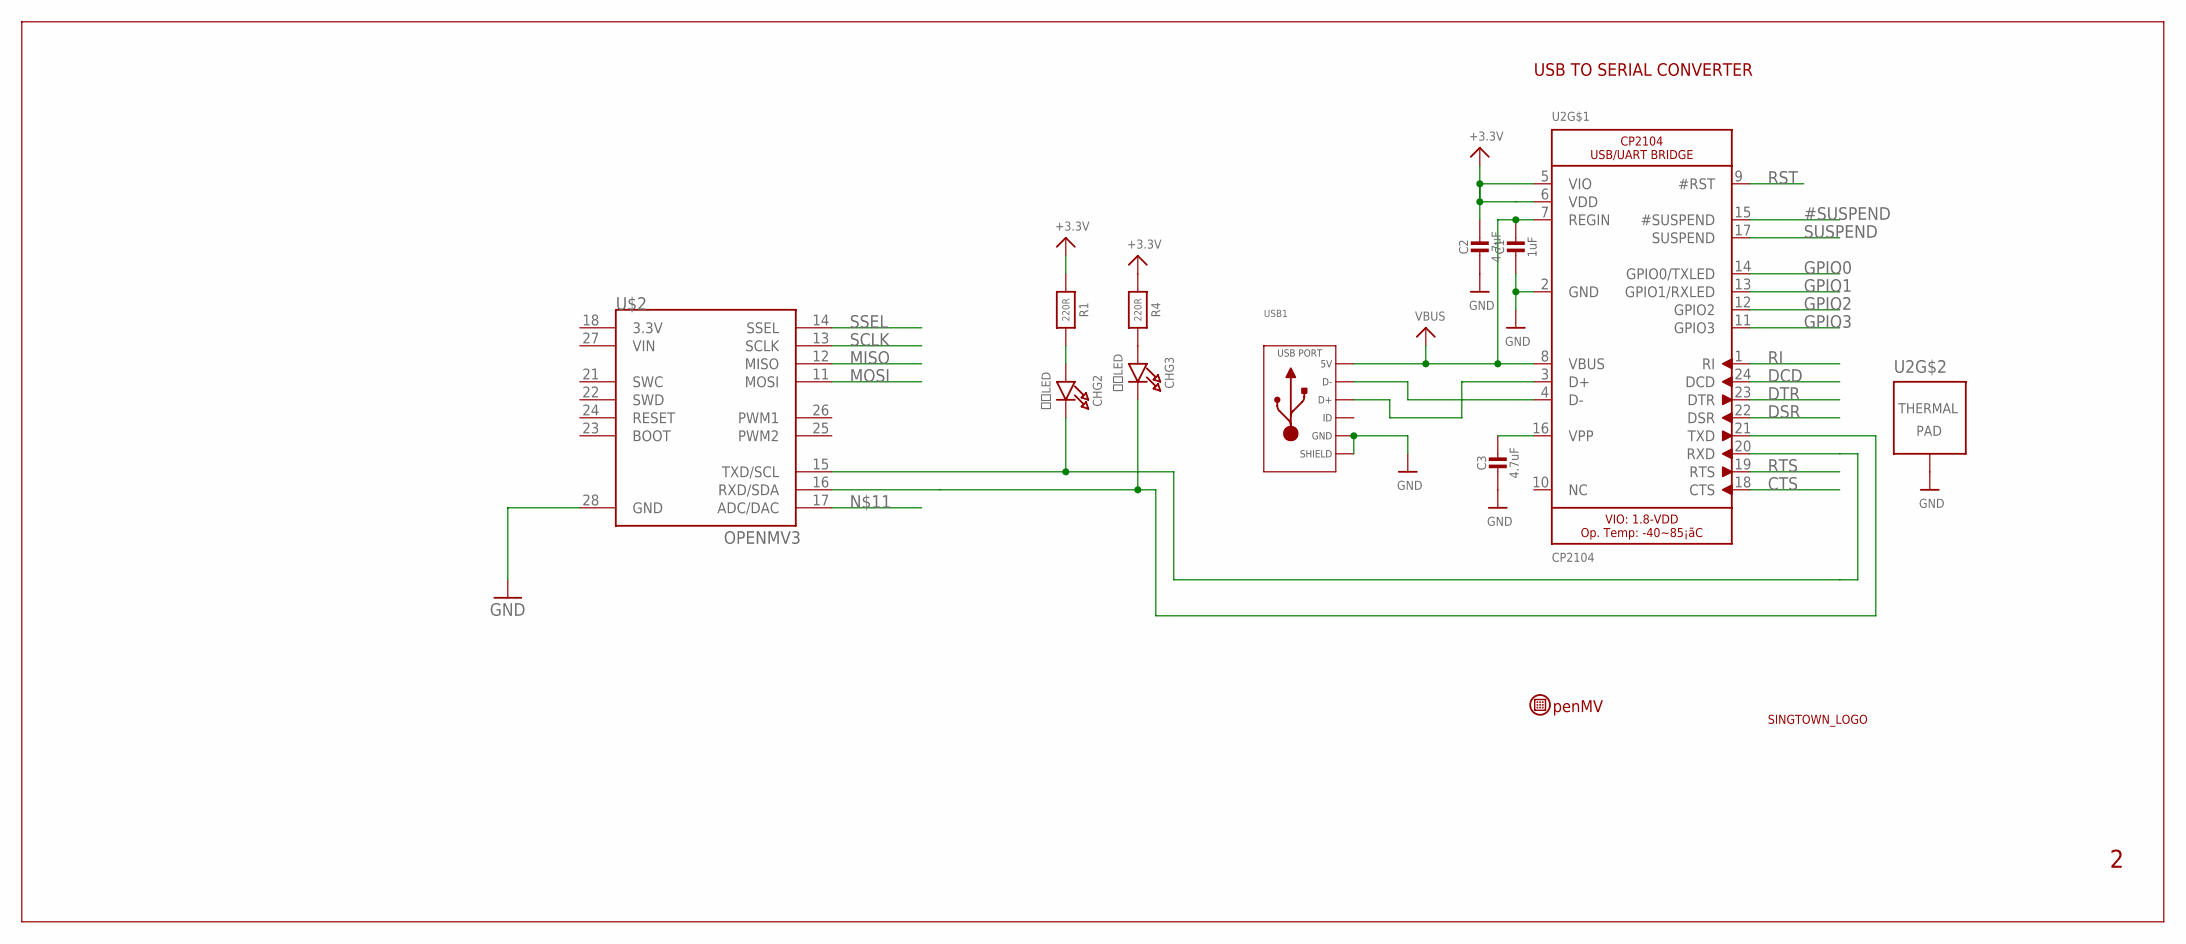
[picture p150: schematic uart.sch]

Parts:
C1: 1uF; _0603MP
C2, C3: 4.7uF; _0603MP
CHG2, CHG3: 蓝色LED; CHIPLED_0603_NOOUTLINE
R1, R4: 220R; _0603MP
U2: CP2104; QFN24_4MM_SMSC
U$2: OPENMV3
U$7: OPENMV-LOGO
U$8: SINGTOWN_LOGO; SINGTOWN_5MM
USB1: USB_MICRO_RIGHT; MICROUSB-RIGHT

Connections:
3.3V: C2.1, R1.1, R4.1, U2.5 (VIO), U2.6 (VDD)
#SUSPEND: U2.15 (#SUSPEND)
CTS: U2.18 (CTS)
DCD: U2.24 (DCD)
DSR: U2.22 (DSR)
DTR: U2.23 (DTR)
GND: C1.2, C2.2, C3.2, U2.2 (GND), U2.THERM (TP), U$2.28 (GND), USB1.5 (GND), USB1.S1 (SLD), USB1.S2 (SLD), USB1.S3 (SLD), USB1.S4 (SLD), USB1.S5 (SLD), USB1.S6 (SLD)
GPIO0: U2.14 (GPIO0/TXLED)
GPIO1: U2.13 (GPIO1/RXLED)
GPIO2: U2.12 (GPIO2)
GPIO3: U2.11 (GPIO3)
MISO: U$2.12 (MISO)
MOSI: U$2.11 (MOSI)
unnamed: U2.4 (D-), USB1.2 (D-)
unnamed: U2.3 (D+), USB1.3 (D+)
unnamed: C3.1, U2.16 (VPP)
unnamed: CHG3.C, U2.21 (TXD), U$2.16 (RXD/SDA)
unnamed: CHG2.A, R1.2
unnamed: CHG3.A, R4.2
unnamed: CHG2.C, U2.20 (RXD), U$2.15 (TXD/SCL)
RI: U2.1 (RI)
RST: U2.9 (#RST)
RTS: U2.19 (RTS)
SCLK: U$2.13 (SCLK)
SSEL: U$2.14 (SSEL)
SUSPEND: U2.17 (SUSPEND)
VBUS: C1.1, U2.7 (REGIN), U2.8 (VBUS), USB1.1 (5V)

Notes on the sheet:
USB TO SERIAL CONVERTER

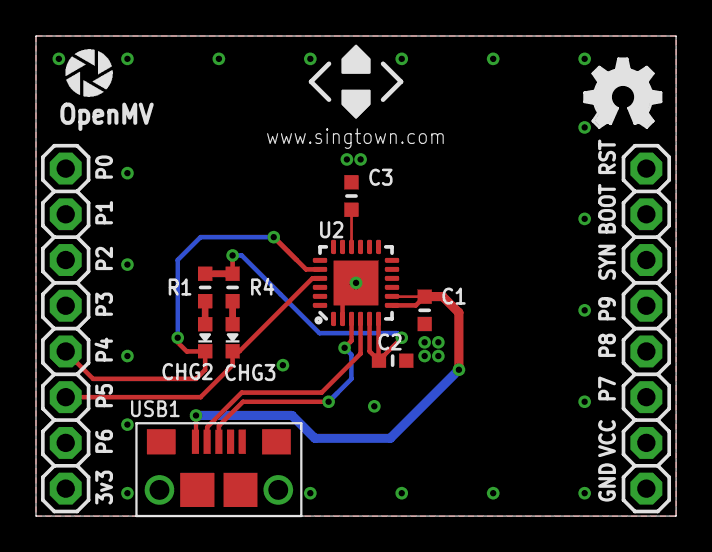
[picture p151: board uart.brd from above]

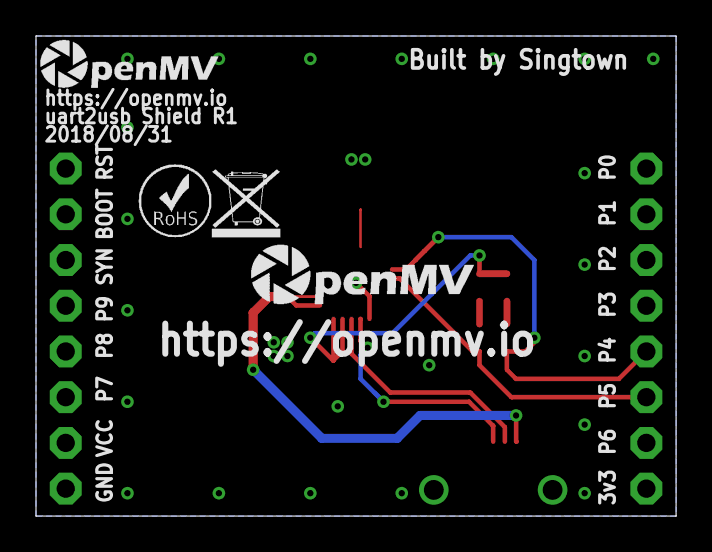
[picture p152: board uart.brd from below]

Board: 2 copper layers, 35.6 x 26.7 mm, 17 parts (4 on the bottom side), 10 nets.

Other parts of the board:
U$1: OSHW_FILLX150_NOTEXT
U$13: OMV-LOGO-SMALL
U$14: ROHS
U$15: WEEE
U$16: OMV-LOGO
