PyCubed-Mini/OpenMV_Camera/openmv-official-repo-for-reference/shields/swd/swd.brd

## EAGLE design openmv-official-repo-for-reference/shields/swd/swd.brd (2019-10-06)

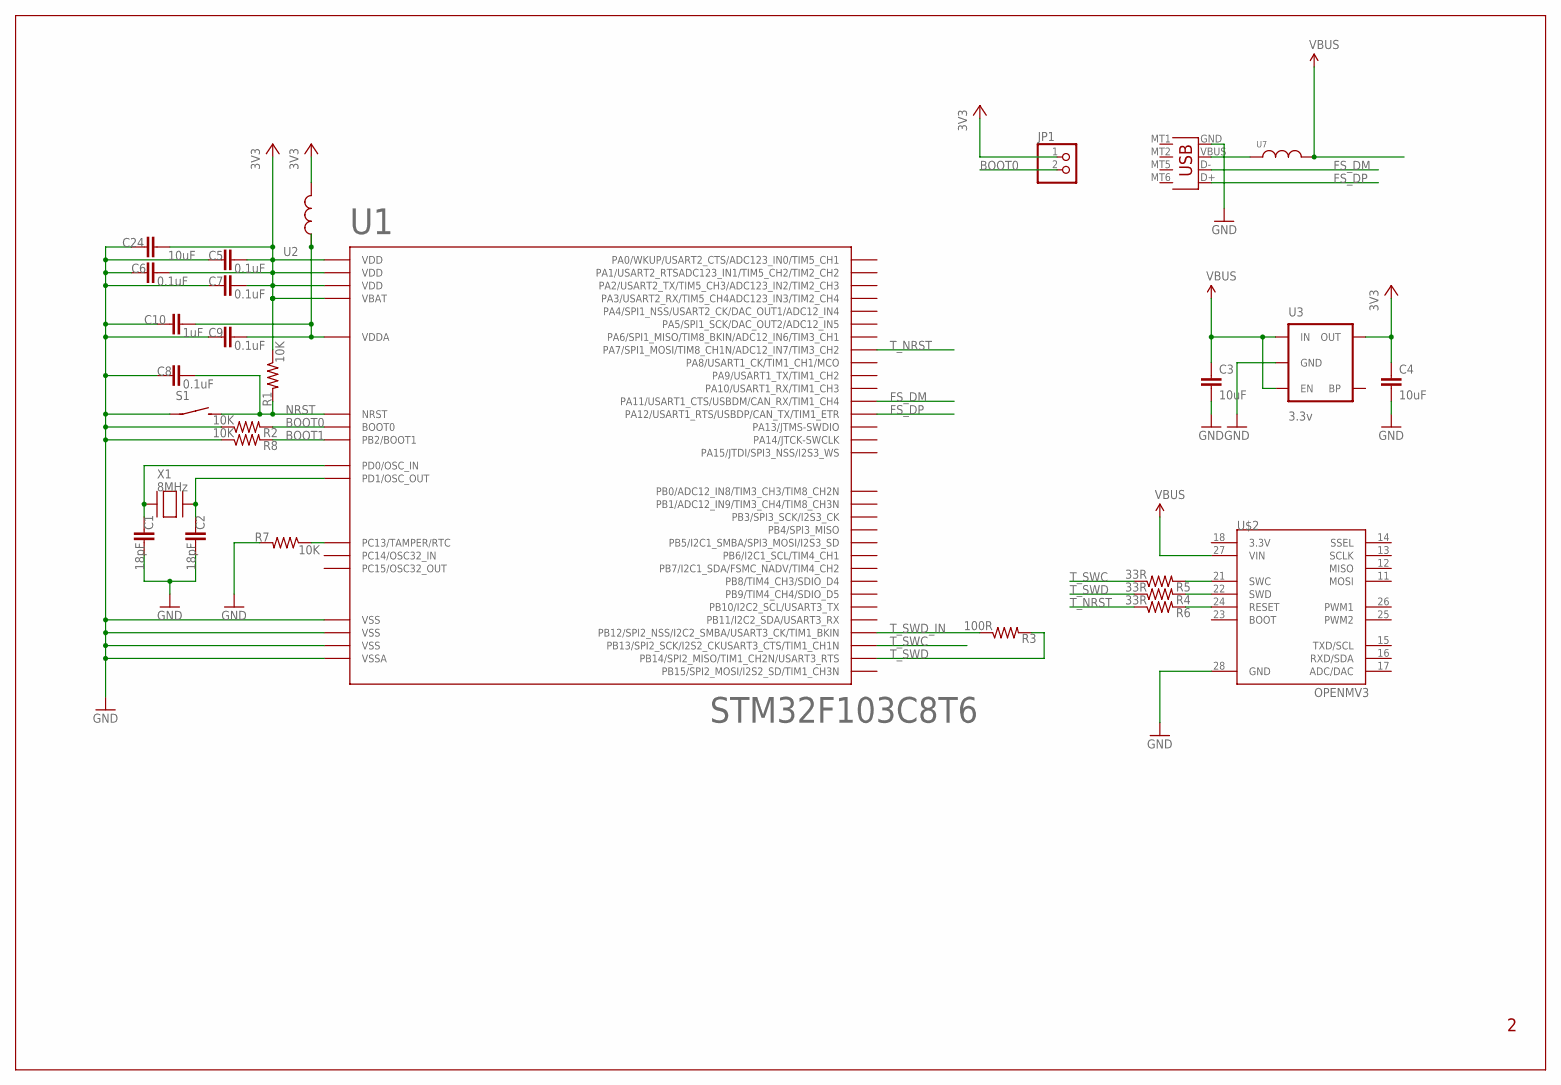
[picture p153: schematic swd.sch]

Parts:
C1, C2: 18pF; 0603-CAP
C3, C4, C24: 10uF; 0805
C5, C6, C7, C8, C9: 0.1uF; 0603-CAP
C10: 1uF; 0603-CAP
JP1: PINHD-1X2; 1X02
R1, R2, R7, R8: 10K; 0603-RES
R3: 100R; 0603-RES
R4, R5, R6: 33R; 0603-RES
S1: SPST_3X4X2; 3X4X2TACT
U1: STM32F103C8T6; LQFP48
U2, U7: INDUCTOR0603; 0603
U3: 3.3v; SOT23-5
U$2: OPENMV3
X1: 8MHz; NX5032
X2: USB-MICROB

Connections:
3V3: C4.1, C5.2, C6.2, C7.2, C24.2, JP1.1, R1.1, U1.1 (VBAT), U1.24 (VDD), U1.36 (VDD), U1.48 (VDD), U2.2, U3.5 (OUT)
BOOT0: JP1.2, R2.2, U1.44 (BOOT0)
BOOT1: R8.2, U1.20 (PB2/BOOT1)
FS_DM: U1.32 (PA11/USART1_CTS/USBDM/CAN_RX/TIM1_CH4), X2.D-
FS_DP: U1.33 (PA12/USART1_RTS/USBDP/CAN_TX/TIM1_ETR), X2.D+
GND: C1.1, C2.1, C3.2, C4.2, C5.1, C6.1, C7.1, C8.1, C9.1, C10.1, C24.1, R2.1, R7.2, R8.1, S1.P$1, U1.8 (VSSA), U1.23 (VSS), U1.35 (VSS), U1.47 (VSS), U3.2 (GND), U$2.28 (GND), X2.GND
unnamed: R5.2, U$2.21 (SWC)
unnamed: R7.1, U1.2 (PC13/TAMPER/RTC)
unnamed: R4.2, U$2.22 (SWD)
unnamed: R6.2, U$2.24 (RESET)
unnamed: C1.2, U1.5 (PD0/OSC_IN), X1.P$1
unnamed: U7.1, X2.VBUS
unnamed: C2.2, U1.6 (PD1/OSC_OUT), X1.P$2
NRST: C8.2, R1.2, S1.P$2 (S), U1.7 (NRST)
T_NRST: R6.1, U1.17 (PA7/SPI1_MOSI/TIM8_CH1N/ADC12_IN7/TIM3_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)
T_SWC: R5.1, U1.26 (PB13/SPI2_SCK/I2S2_CKUSART3_CTS/TIM1_CH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)
T_SWD: R3.2, R4.1, U1.27 (PB14/SPI2_MISO/TIM1_CH2N/USART3_RTS)
T_SWD_IN: R3.1, U1.25 (PB12/SPI2_NSS/I2C2_SMBA/USART3_CK/TIM1_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)
VBUS: C3.1, U3.1 (IN), U3.3 (EN), U7.2, U$2.27 (VIN)
VDDA: C9.2, C10.2, U1.9 (VDDA), U2.1

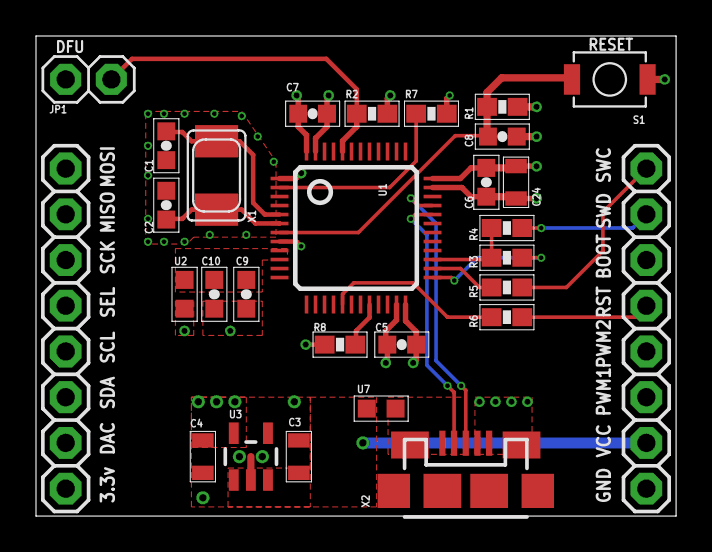
[picture p154: board swd.brd from above]

Board: 4 copper layers, 35.6 x 26.7 mm, 28 parts (0 on the bottom side), 20 nets.
