PyCubed-Mini/OpenMV_Camera/openmv-official-repo-for-reference/shields/lcd/lcd.brd

## EAGLE design openmv-official-repo-for-reference/shields/lcd/lcd.brd (2019-10-06)

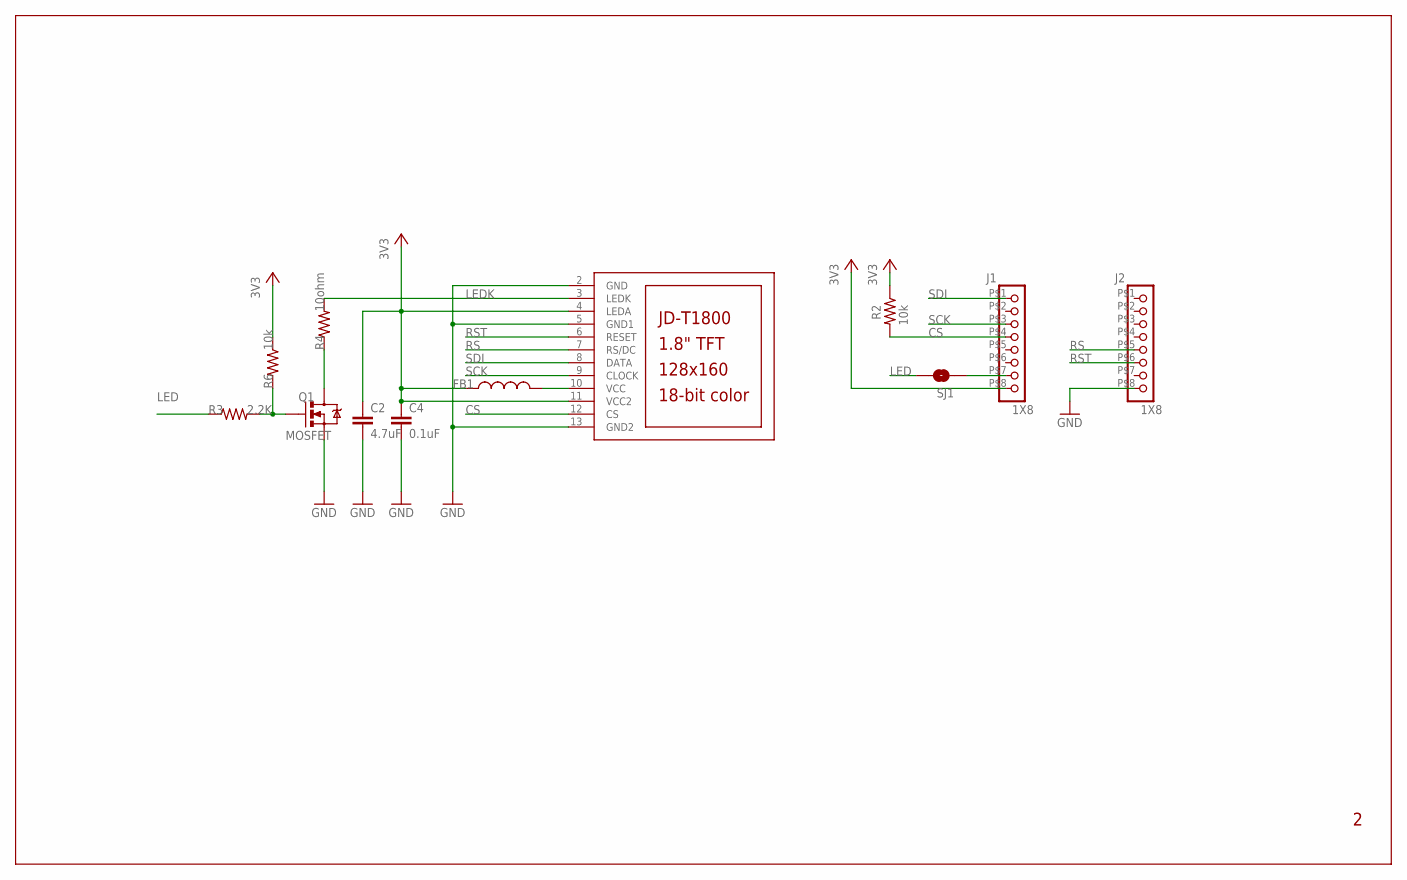
[picture p155: schematic lcd.sch]

Parts:
C2: 4.7uF; 0603-CAP
C4: 0.1uF; 0603-CAP
FB1: INDUCTOR0603; 0603
J1, J2: 1X8
LCD1: JD-T1800
Q1: MOSFET; SOT23-3
R2, R6: 10k; 0603-RES
R3: 2.2K; 0603-RES
R4: 10ohm; 0603-RES
SJ1: SOLDERJUMPERTRACE; SJ_2S-TRACE

Connections:
3V3: C2.1, C4.1, FB1.1, J1.P$8 (8), LCD1.4 (LEDA), LCD1.11 (VCC2), R2.1, R6.1
CS: J1.P$4 (4), LCD1.12 (CS), R2.2
GND: C2.2, C4.2, J2.P$8 (8), LCD1.2 (GND), LCD1.5 (GND1), LCD1.13 (GND2), Q1.2 (S)
LED: R3.1, SJ1.2
LEDK: LCD1.3 (LEDK), R4.2
unnamed: J1.P$7 (7), SJ1.1
unnamed: Q1.1 (G), R3.2, R6.2
unnamed: Q1.3 (D), R4.1
RS: J2.P$5 (5), LCD1.7 (RS/DC)
RST: J2.P$6 (6), LCD1.6 (RESET)
SCK: J1.P$3 (3), LCD1.9 (CLOCK)
SDI: J1.P$1 (1), LCD1.8 (DATA)
VDDA: FB1.2, LCD1.10 (VCC)

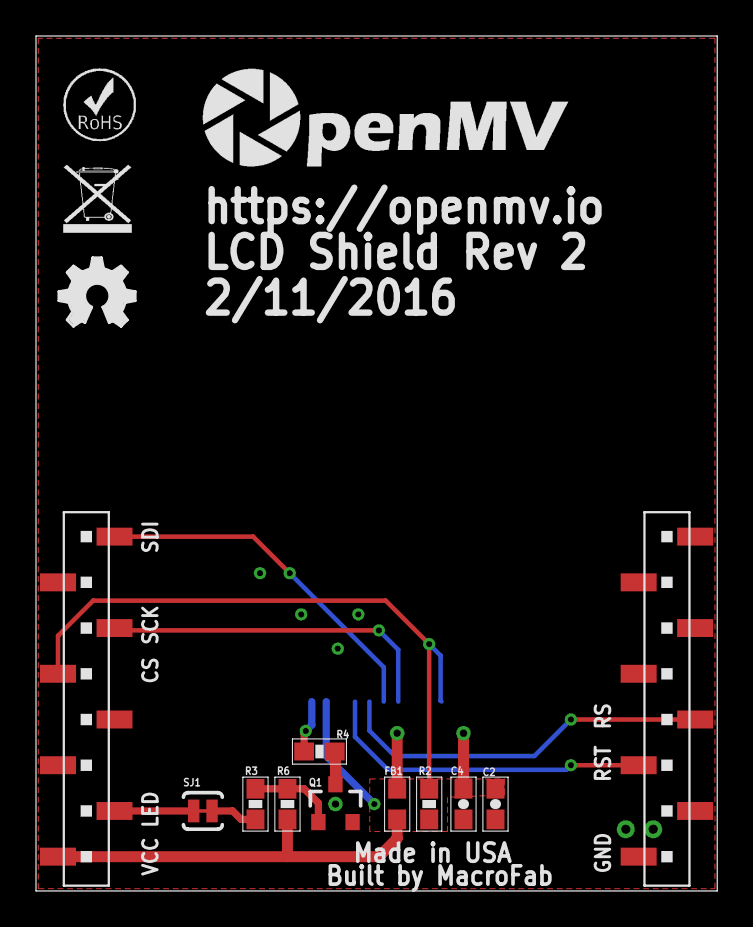
[picture p156: board lcd.brd from above]

Board: 2 copper layers, 37.8 x 47.5 mm, 16 parts (1 on the bottom side), 13 nets.

Other parts of the board:
U$2: ROHS
U$3: WEEE
U$4: OMV-LOGO-BIG
U$5: OSHW_FILLX150_NOTEXT
