PyCubed-Mini/OpenMV_Camera/openmv-official-repo-for-reference/shields/wifi/wifi.brd

## EAGLE design openmv-official-repo-for-reference/shields/wifi/wifi.brd (2019-10-06)

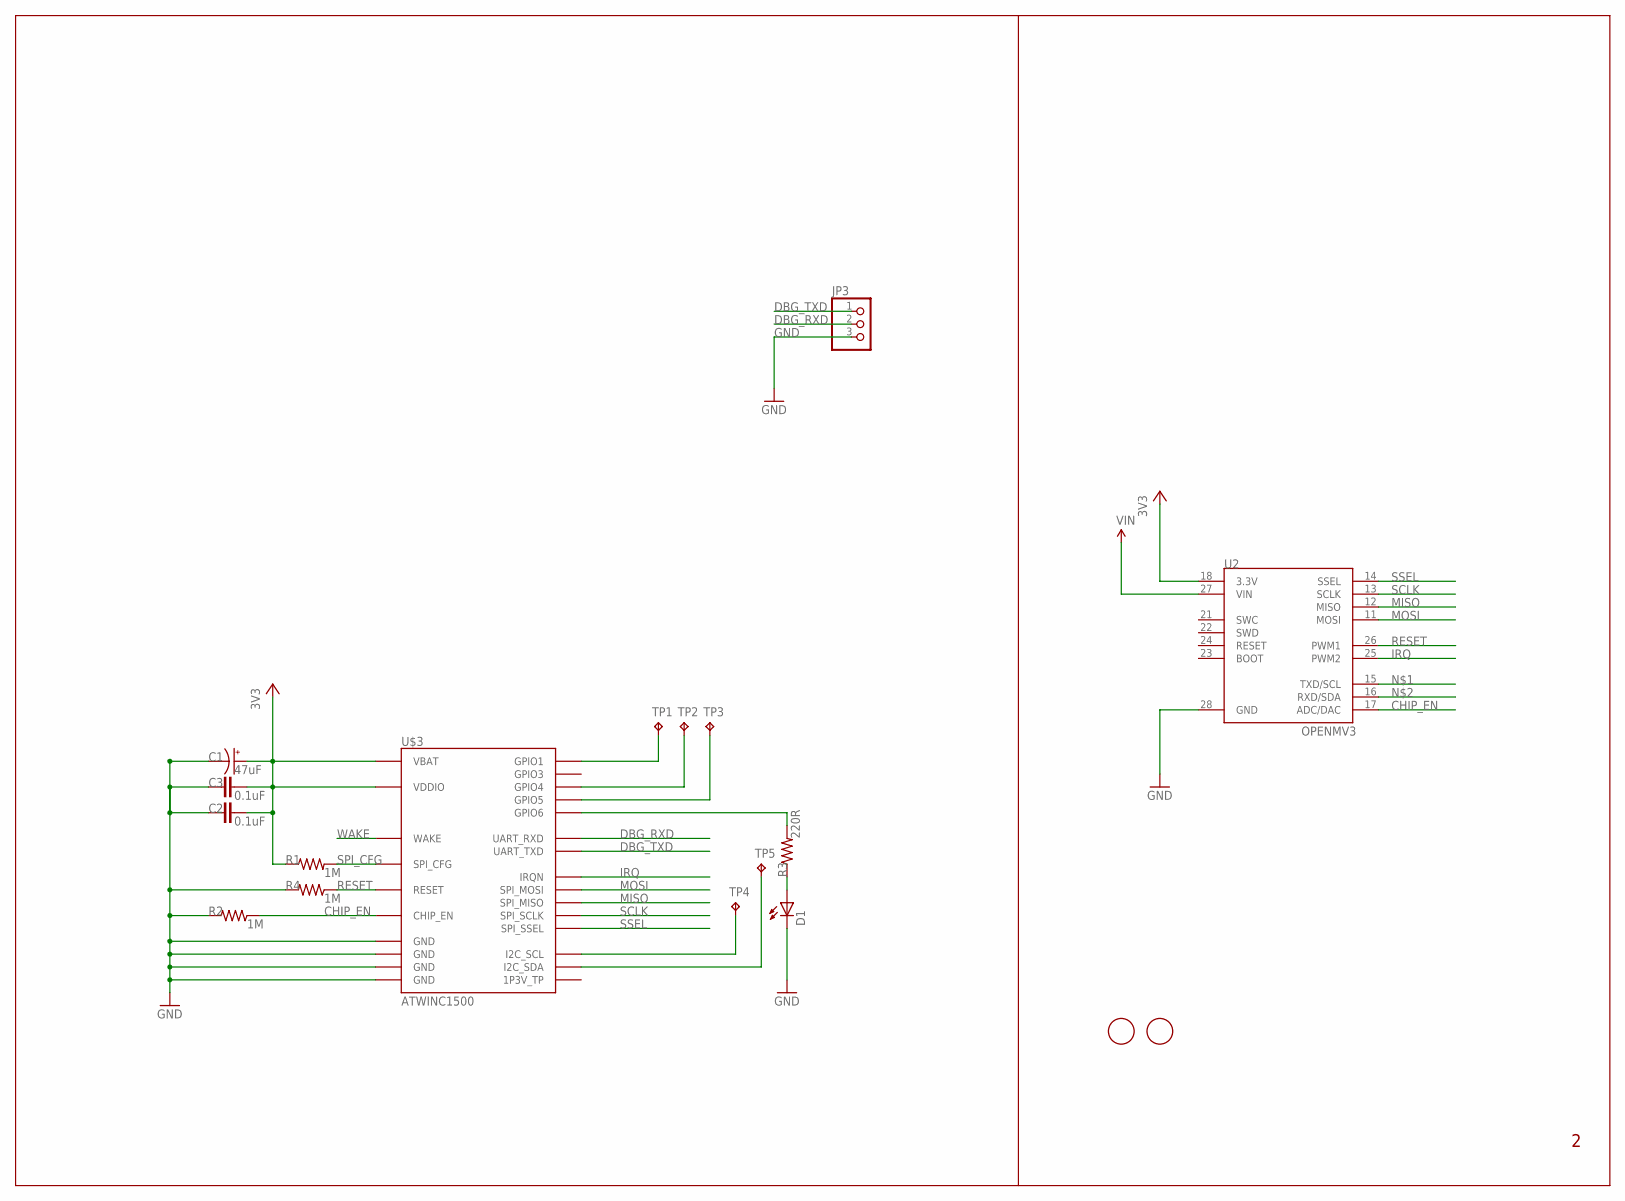
[picture p157: schematic wifi.sch]

Parts:
C1: 47uF; EIA3216
C2, C3: 0.1uF; 0603-CAP
D1: LED0603; LED-0603
JP3: PINHD-1X3; 1X03
R1, R2, R4: 1M; 0603-RES
R3: 220R; 0603-RES
TP1, TP4, TP5: TPTP12R; TP12R
TP2, TP3: TPTP11R; TP11R
U2: OPENMV3
U$1, U$2: FIDUCIAL; FIDUCIAL_1MM
U$3: ATWINC1500

Connections:
3V3: C1.A (+), C2.2, C3.2, R1.1, U2.18 (3.3V), U$3.P$20 (VBAT), U$3.P$23 (VDDIO)
CHIP_EN: R2.1, U2.17 (ADC/DAC), U$3.P$22 (CHIP_EN)
DBG_RXD: JP3.2, U$3.P$19 (UART_RXD)
DBG_TXD: JP3.1, U$3.P$14 (UART_TXD)
GND: C1.C (-), C2.1, C3.1, D1.C, JP3.3, R2.2, R4.2, U2.28 (GND), U$3.P$9 (GND), U$3.P$12 (GND), U$3.P$28 (GND), U$3.P$29 (GND)
IRQ: U2.25 (PWM2), U$3.P$13 (IRQN)
MISO: U2.12 (MISO), U$3.P$17 (SPI_MISO)
MOSI: U2.11 (MOSI), U$3.P$15 (SPI_MOSI)
unnamed: TP1.TP, U$3.P$21 (GPIO1)
unnamed: TP4.TP, U$3.P$2 (I2C_SCL)
unnamed: TP5.TP, U$3.P$3 (I2C_SDA)
unnamed: D1.A, R3.1
unnamed: TP2.TP, U$3.P$26 (GPIO4)
unnamed: TP3.TP, U$3.P$27 (GPIO5)
unnamed: R3.2, U$3.P$1 (GPIO6)
RESET: R4.1, U2.26 (PWM1), U$3.P$4 (RESET)
SCLK: U2.13 (SCLK), U$3.P$18 (SPI_SCLK)
SPI_CFG: R1.2, U$3.P$10 (SPI_CFG)
SSEL: U2.14 (SSEL), U$3.P$16 (SPI_SSEL)
VIN: U2.27 (VIN)
WAKE: U$3.P$11 (WAKE)

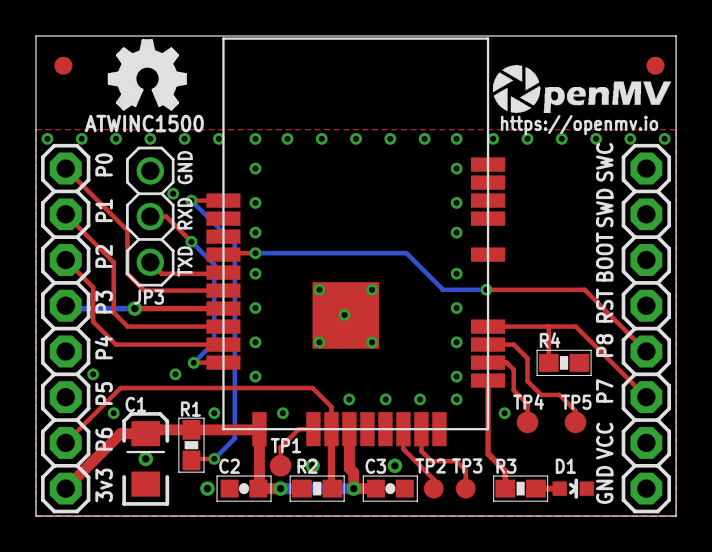
[picture p158: board wifi.brd from above]

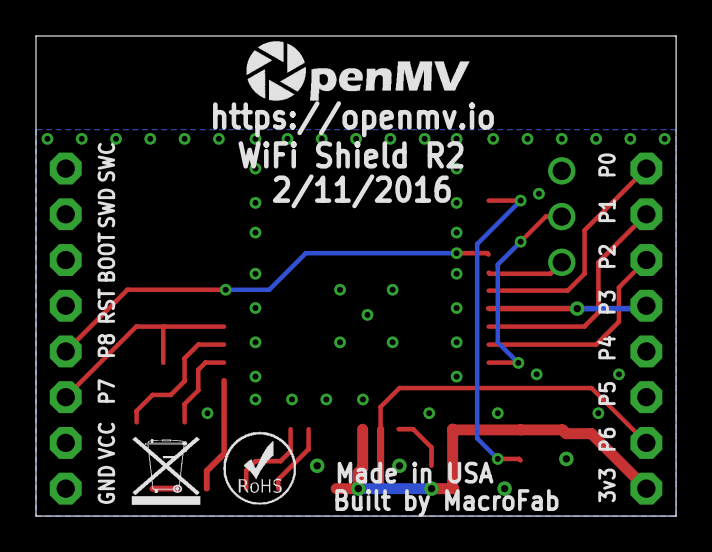
[picture p159: board wifi.brd from below]

Board: 2 copper layers, 35.6 x 26.7 mm, 23 parts (3 on the bottom side), 19 nets.

Other parts of the board:
U$4: OMV-LOGO
U$5: ROHS
U$6: WEEE
U$7: OSHW_FILLX150_NOTEXT
U$10: OMV-LOGO-SMALL
