PyCubed-Mini/OpenMV_Camera/openmv-official-repo-for-reference/openmv1/shields/cc3k/openmv-cc.brd

## EAGLE design openmv-official-repo-for-reference/openmv1/shields/cc3k/openmv-cc.brd (2019-10-06)

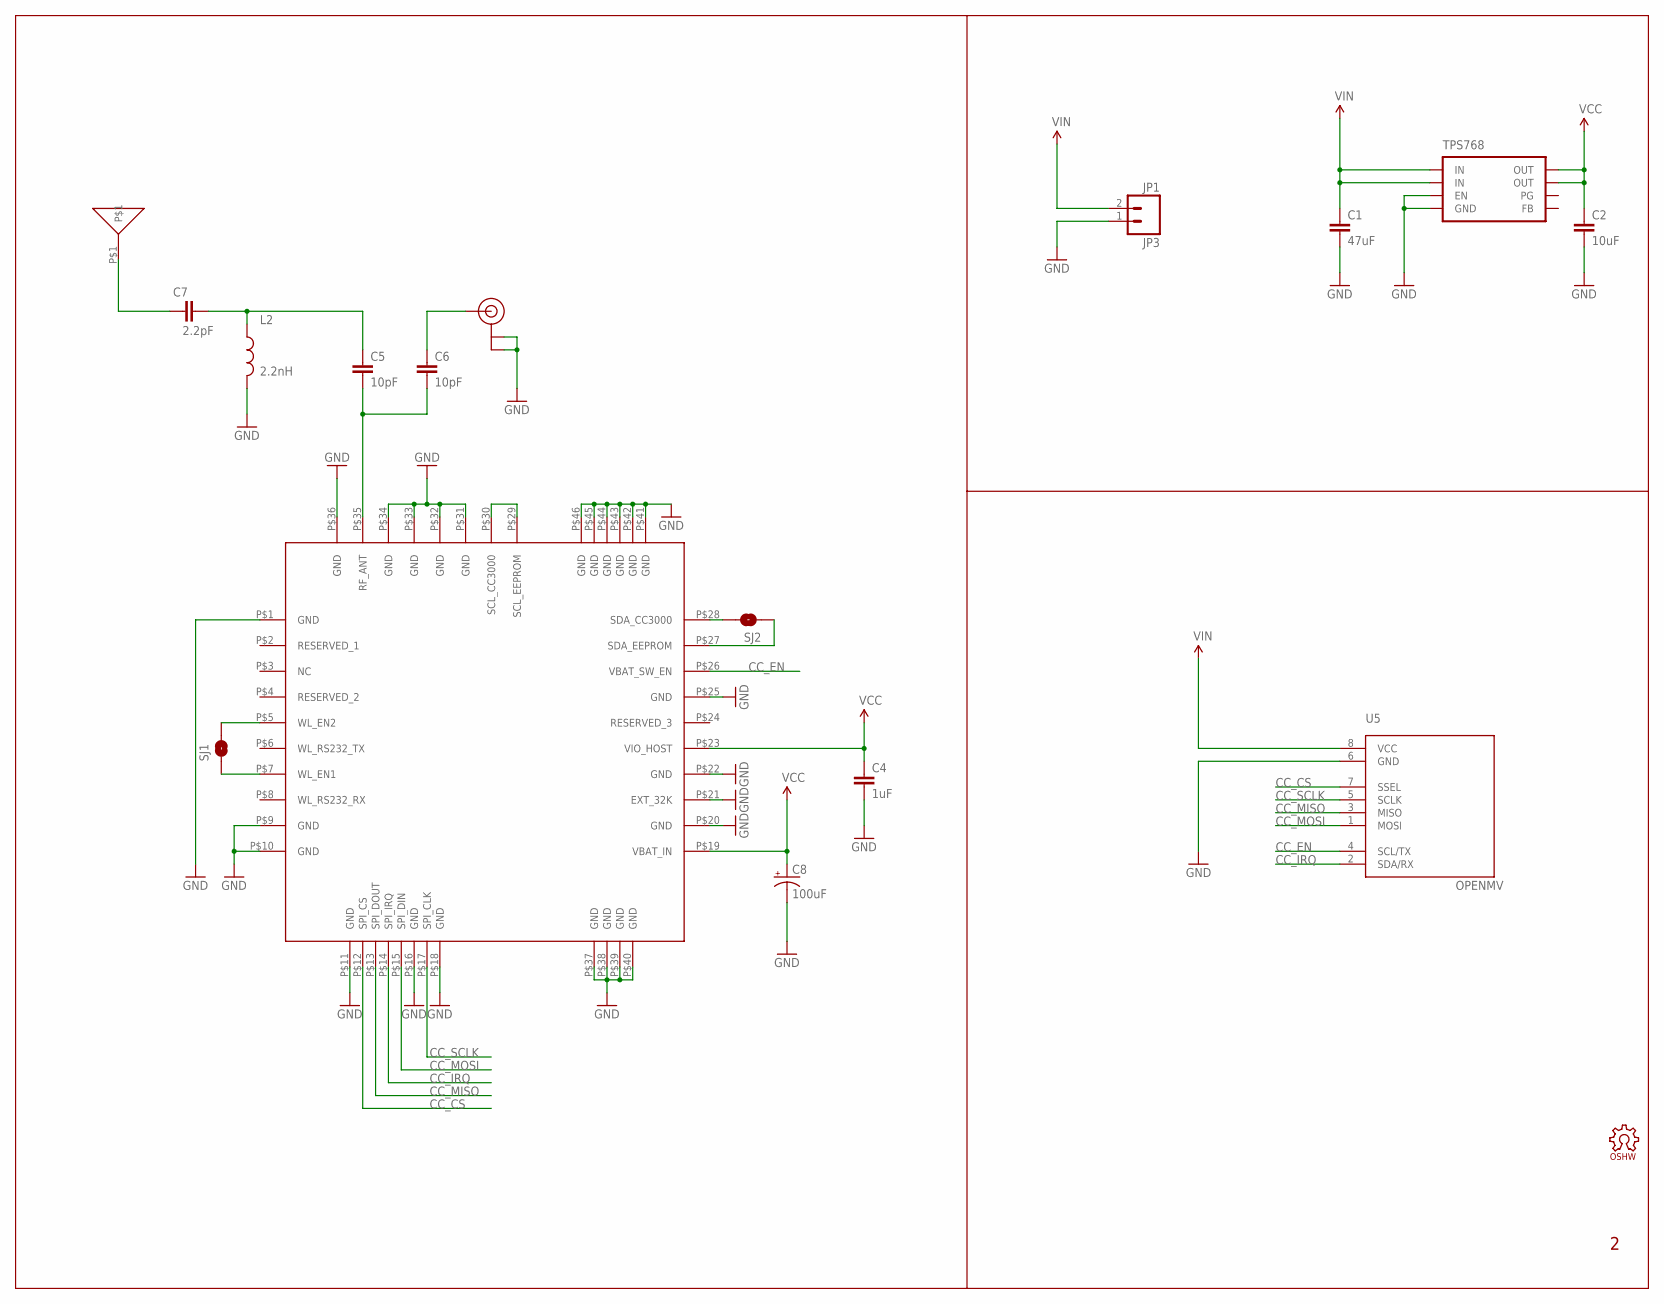
[picture p163: schematic openmv-cc.sch]

Parts:
C1: 47uF; 1210
C2: 10uF; 0805
C4: 1uF; 0402-CAP
C5, C6: 10pF; 0402-CAP
C7: 2.2pF; 0402-CAP
C8: 100uF; EIA3528
JP1: JP3; JST-2-PTH
L2: 2.2nH; C0402
LOGO1: OSHW_LOGO_FILLX0100-NT; OSHW_FILLX100_NOTEXT
SJ1, SJ2: SOLDERJUMPERTRACE; SJ_2S-TRACE
U1: CC3000
U2: ANT-YAGEO; ANTENNA
U3: U.FL
U4: TPS768; SOIC8
U5: OPENMV

Connections:
CC_CS: U1.P$12 (SPI_CS), U5.7 (SSEL)
CC_EN: U1.P$26 (VBAT_SW_EN), U5.4 (SCL/TX)
CC_IRQ: U1.P$14 (SPI_IRQ), U5.2 (SDA/RX)
CC_MISO: U1.P$13 (SPI_DOUT), U5.3 (MISO)
CC_MOSI: U1.P$15 (SPI_DIN), U5.1 (MOSI)
CC_SCLK: U1.P$17 (SPI_CLK), U5.5 (SCLK)
GND: C1.2, C2.2, C4.2, C8.C (-), JP1.1 (2), L2.2, U1.P$1 (GND), U1.P$9 (GND), U1.P$10 (GND), U1.P$11 (GND), U1.P$16 (GND), U1.P$18 (GND), U1.P$20 (GND), U1.P$21 (EXT_32K), U1.P$22 (GND), U1.P$25 (GND), U1.P$31 (GND), U1.P$32 (GND), U1.P$33 (GND), U1.P$34 (GND), U1.P$36 (GND), U1.P$37 (GND), U1.P$38 (GND), U1.P$39 (GND), U1.P$40 (GND), U1.P$41 (GND), U1.P$42 (GND), U1.P$43 (GND), U1.P$44 (GND), U1.P$45 (GND), U1.P$46 (GND), U3.P$1 (GND), U3.P$2 (GND), U4.1 (GND), U4.2 (EN), U5.6 (GND)
unnamed: C5.1, C7.2, L2.1
unnamed: SJ1.2, U1.P$5 (WL_EN2)
unnamed: SJ2.2, U1.P$28 (SDA_CC3000)
unnamed: SJ1.1, U1.P$7 (WL_EN1)
unnamed: SJ2.1, U1.P$27 (SDA_EEPROM)
unnamed: C5.2, C6.2, U1.P$35 (RF_ANT)
unnamed: U1.P$29 (SCL_EEPROM), U1.P$30 (SCL_CC3000)
unnamed: C7.1, U2.P$1
unnamed: C6.1, U3.P$3 (SIGNAL)
VCC: C2.1, C4.1, C8.A (+), U1.P$19 (VBAT_IN), U1.P$23 (VIO_HOST), U4.5 (OUT), U4.6 (OUT)
VIN: C1.1, JP1.2 (1), U4.3 (IN), U4.4 (IN), U5.8 (VCC)

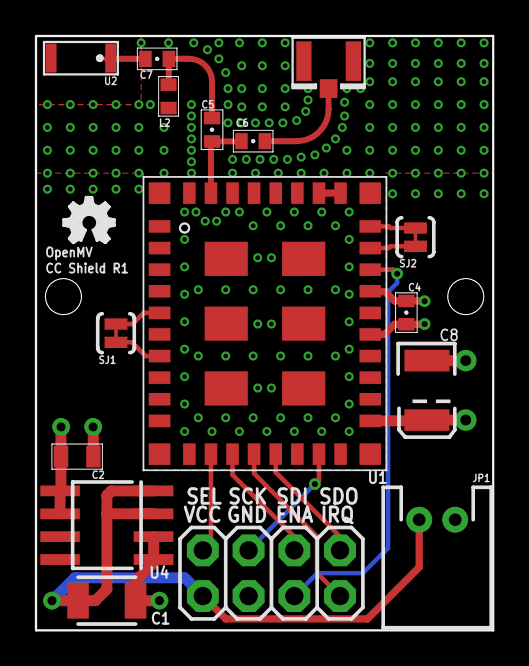
[picture p164: board openmv-cc.brd from above]

Board: 4 copper layers, 25.4 x 33.0 mm, 17 parts (0 on the bottom side), 18 nets.
