PyCubed-Mini/OpenMV_Camera/openmv-official-repo-for-reference/openmv1/shields/ble/openmv-ble.brd

## EAGLE design openmv-official-repo-for-reference/openmv1/shields/ble/openmv-ble.brd (2019-10-06)

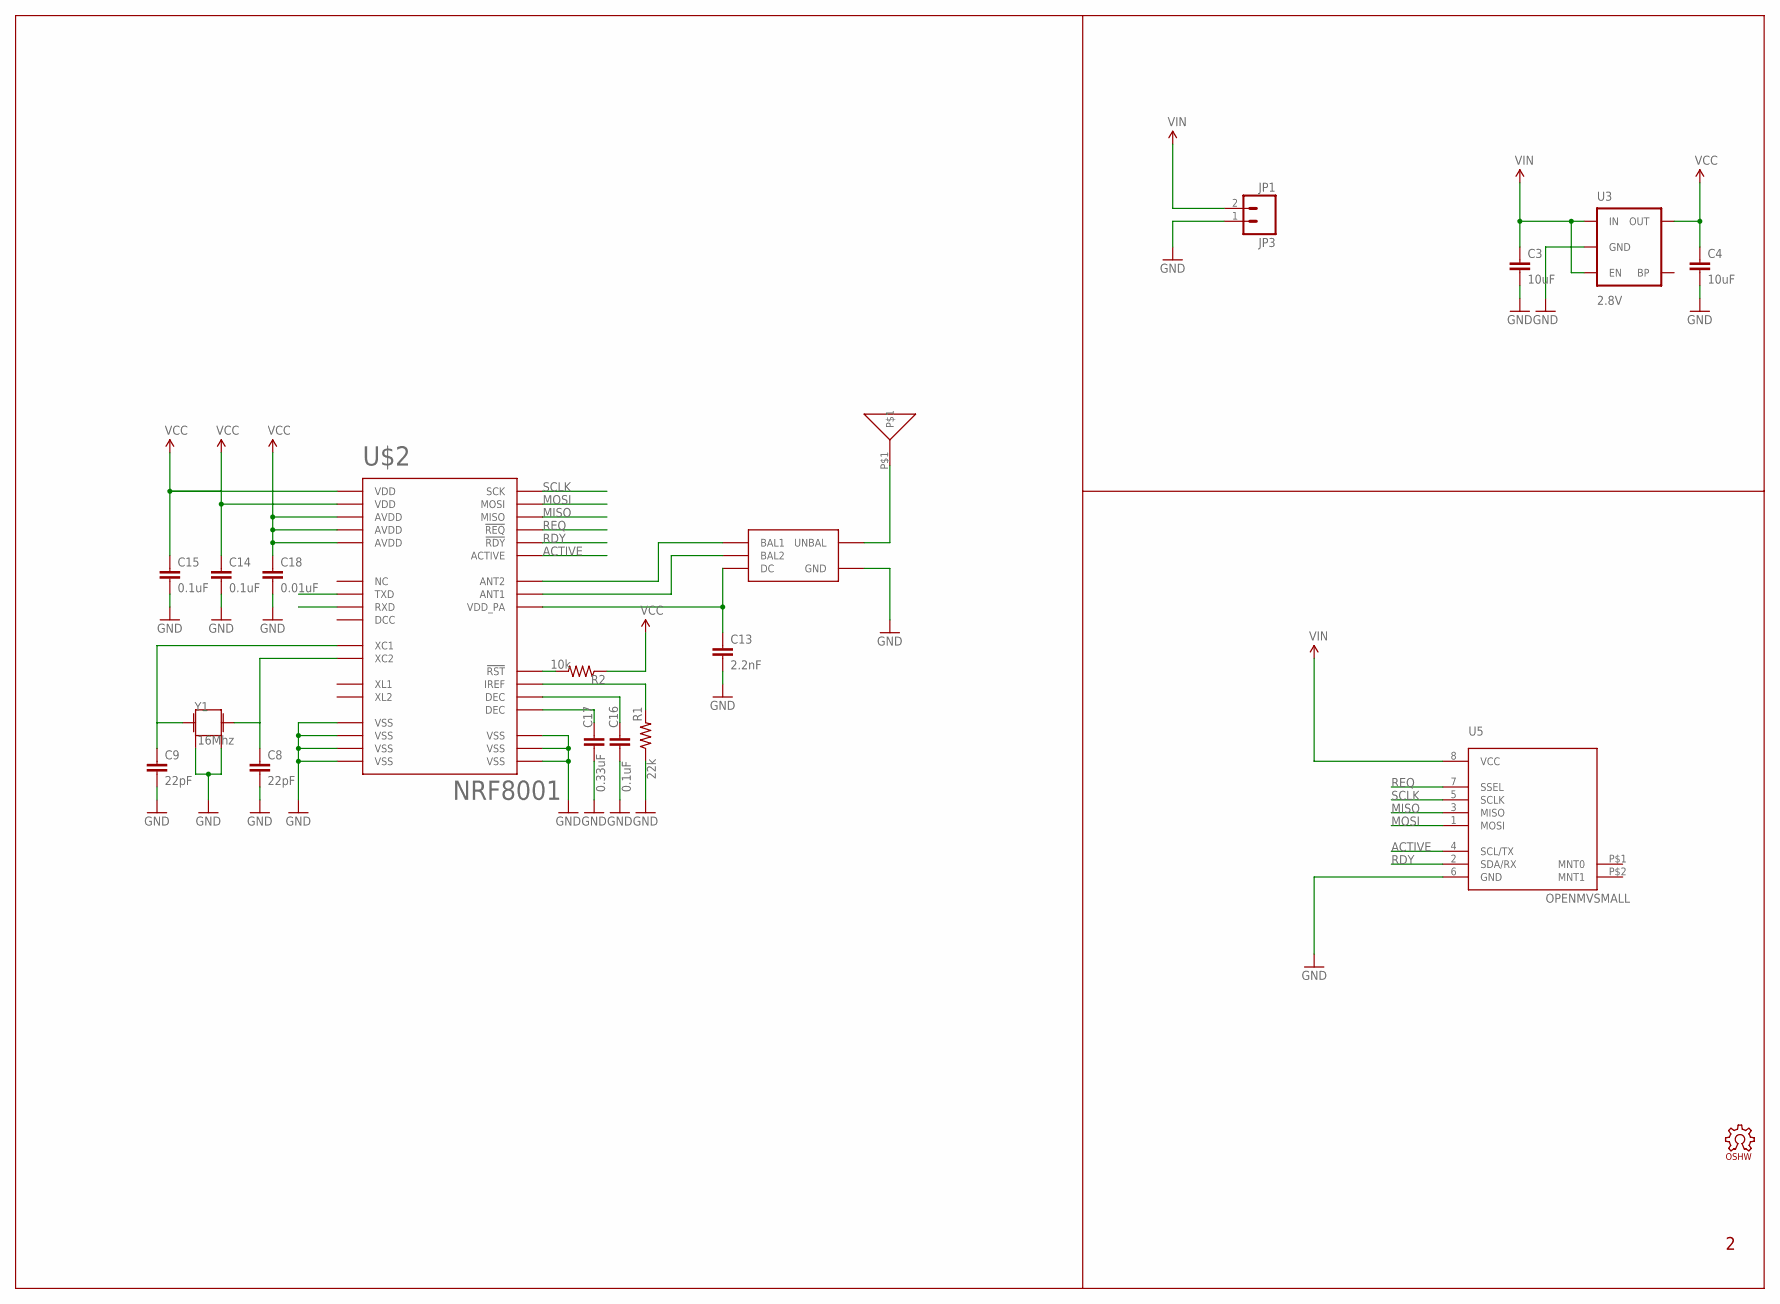
[picture p165: schematic openmv-ble.sch]

Parts:
C3, C4: 10uF; 0805
C8, C9: 22pF; 0402-CAP
C13: 2.2nF; 0402-CAP
C14, C15, C16: 0.1uF; 0402-CAP
C17: 0.33uF; 0402-CAP
C18: 0.01uF; 0402-CAP
JP1: JP3; JST-2-PTH
LOGO1: OSHW_LOGO_FILLX0100-NT; OSHW_FILLX100_NOTEXT
R1: 22k; 0402-RES
R2: 10k; 0402-RES
U1: 2450BM14A0002
U2: ANT-YAGEO; ANTENNA
U3: 2.8V; SOT23-5
U5: OPENMVSMALL; OPENMV-SMALL
U$2: NRF8001; QFN-32
Y1: 16Mhz; CRYSTAL3.2X2.5

Connections:
ACTIVE: U5.4 (SCL/TX), U$2.P$6 (ACTIVE)
DCC: U$2.P$32 (DCC)
GND: C3.2, C4.2, C8.2, C9.2, C13.2, C14.2, C15.2, C16.2, C17.2, C18.2, JP1.1 (2), R1.1, U1.P$2 (GND), U3.2 (GND), U5.6 (GND), U$2.P$8 (VSS), U$2.P$17 (VSS), U$2.P$18 (VSS), U$2.P$23 (VSS), U$2.P$30 (VSS), U$2.P$31 (VSS), U$2.P$33 (VSS), Y1.2, Y1.4
MISO: U5.3 (MISO), U$2.P$14 (MISO)
MOSI: U5.1 (MOSI), U$2.P$13 (MOSI)
unnamed: C9.1, U$2.P$28 (XC1), Y1.3 (2)
unnamed: C8.1, U$2.P$27 (XC2), Y1.1
unnamed: U1.P$3 (BAL1), U$2.P$22 (ANT2)
unnamed: U1.P$1 (UNBAL), U2.P$1
unnamed: U1.P$4 (BAL2), U$2.P$21 (ANT1)
unnamed: C13.1, U1.P$5 (DC), U$2.P$20 (VDD_PA)
unnamed: C17.1, U$2.P$2 (DEC)
unnamed: C16.1, U$2.P$3 (DEC)
unnamed: R1.2, U$2.P$25 (IREF)
unnamed: R2.2, U$2.P$19 (!RST)
RDY: U5.2 (SDA/RX), U$2.P$16 (!RDY)
REQ: U5.7 (SSEL), U$2.P$12 (!REQ)
SCLK: U5.5 (SCLK), U$2.P$11 (SCK)
VCC: C4.1, C14.1, C15.1, C18.1, R2.1, U3.5 (OUT), U$2.P$1 (VDD), U$2.P$9 (VDD), U$2.P$24 (AVDD), U$2.P$26 (AVDD), U$2.P$29 (AVDD)
VIN: C3.1, JP1.2 (1), U3.1 (IN), U3.3 (EN), U5.8 (VCC)

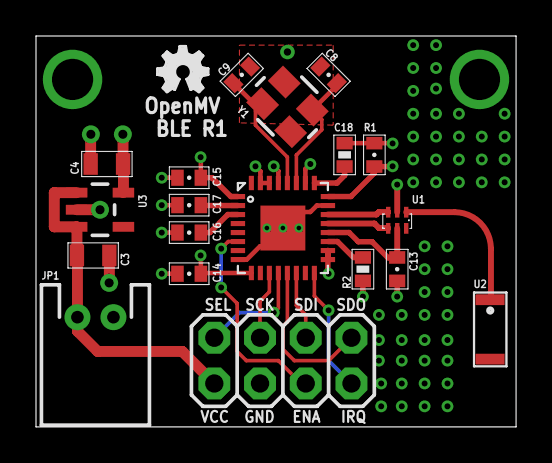
[picture p166: board openmv-ble.brd from above]

Board: 4 copper layers, 26.7 x 21.7 mm, 20 parts (0 on the bottom side), 19 nets.
