PyCubed-Mini/OpenMV_Camera/openmv-official-repo-for-reference/openmv2/openmv2.brd

## EAGLE design openmv-official-repo-for-reference/openmv2/openmv2.brd (2019-10-06)

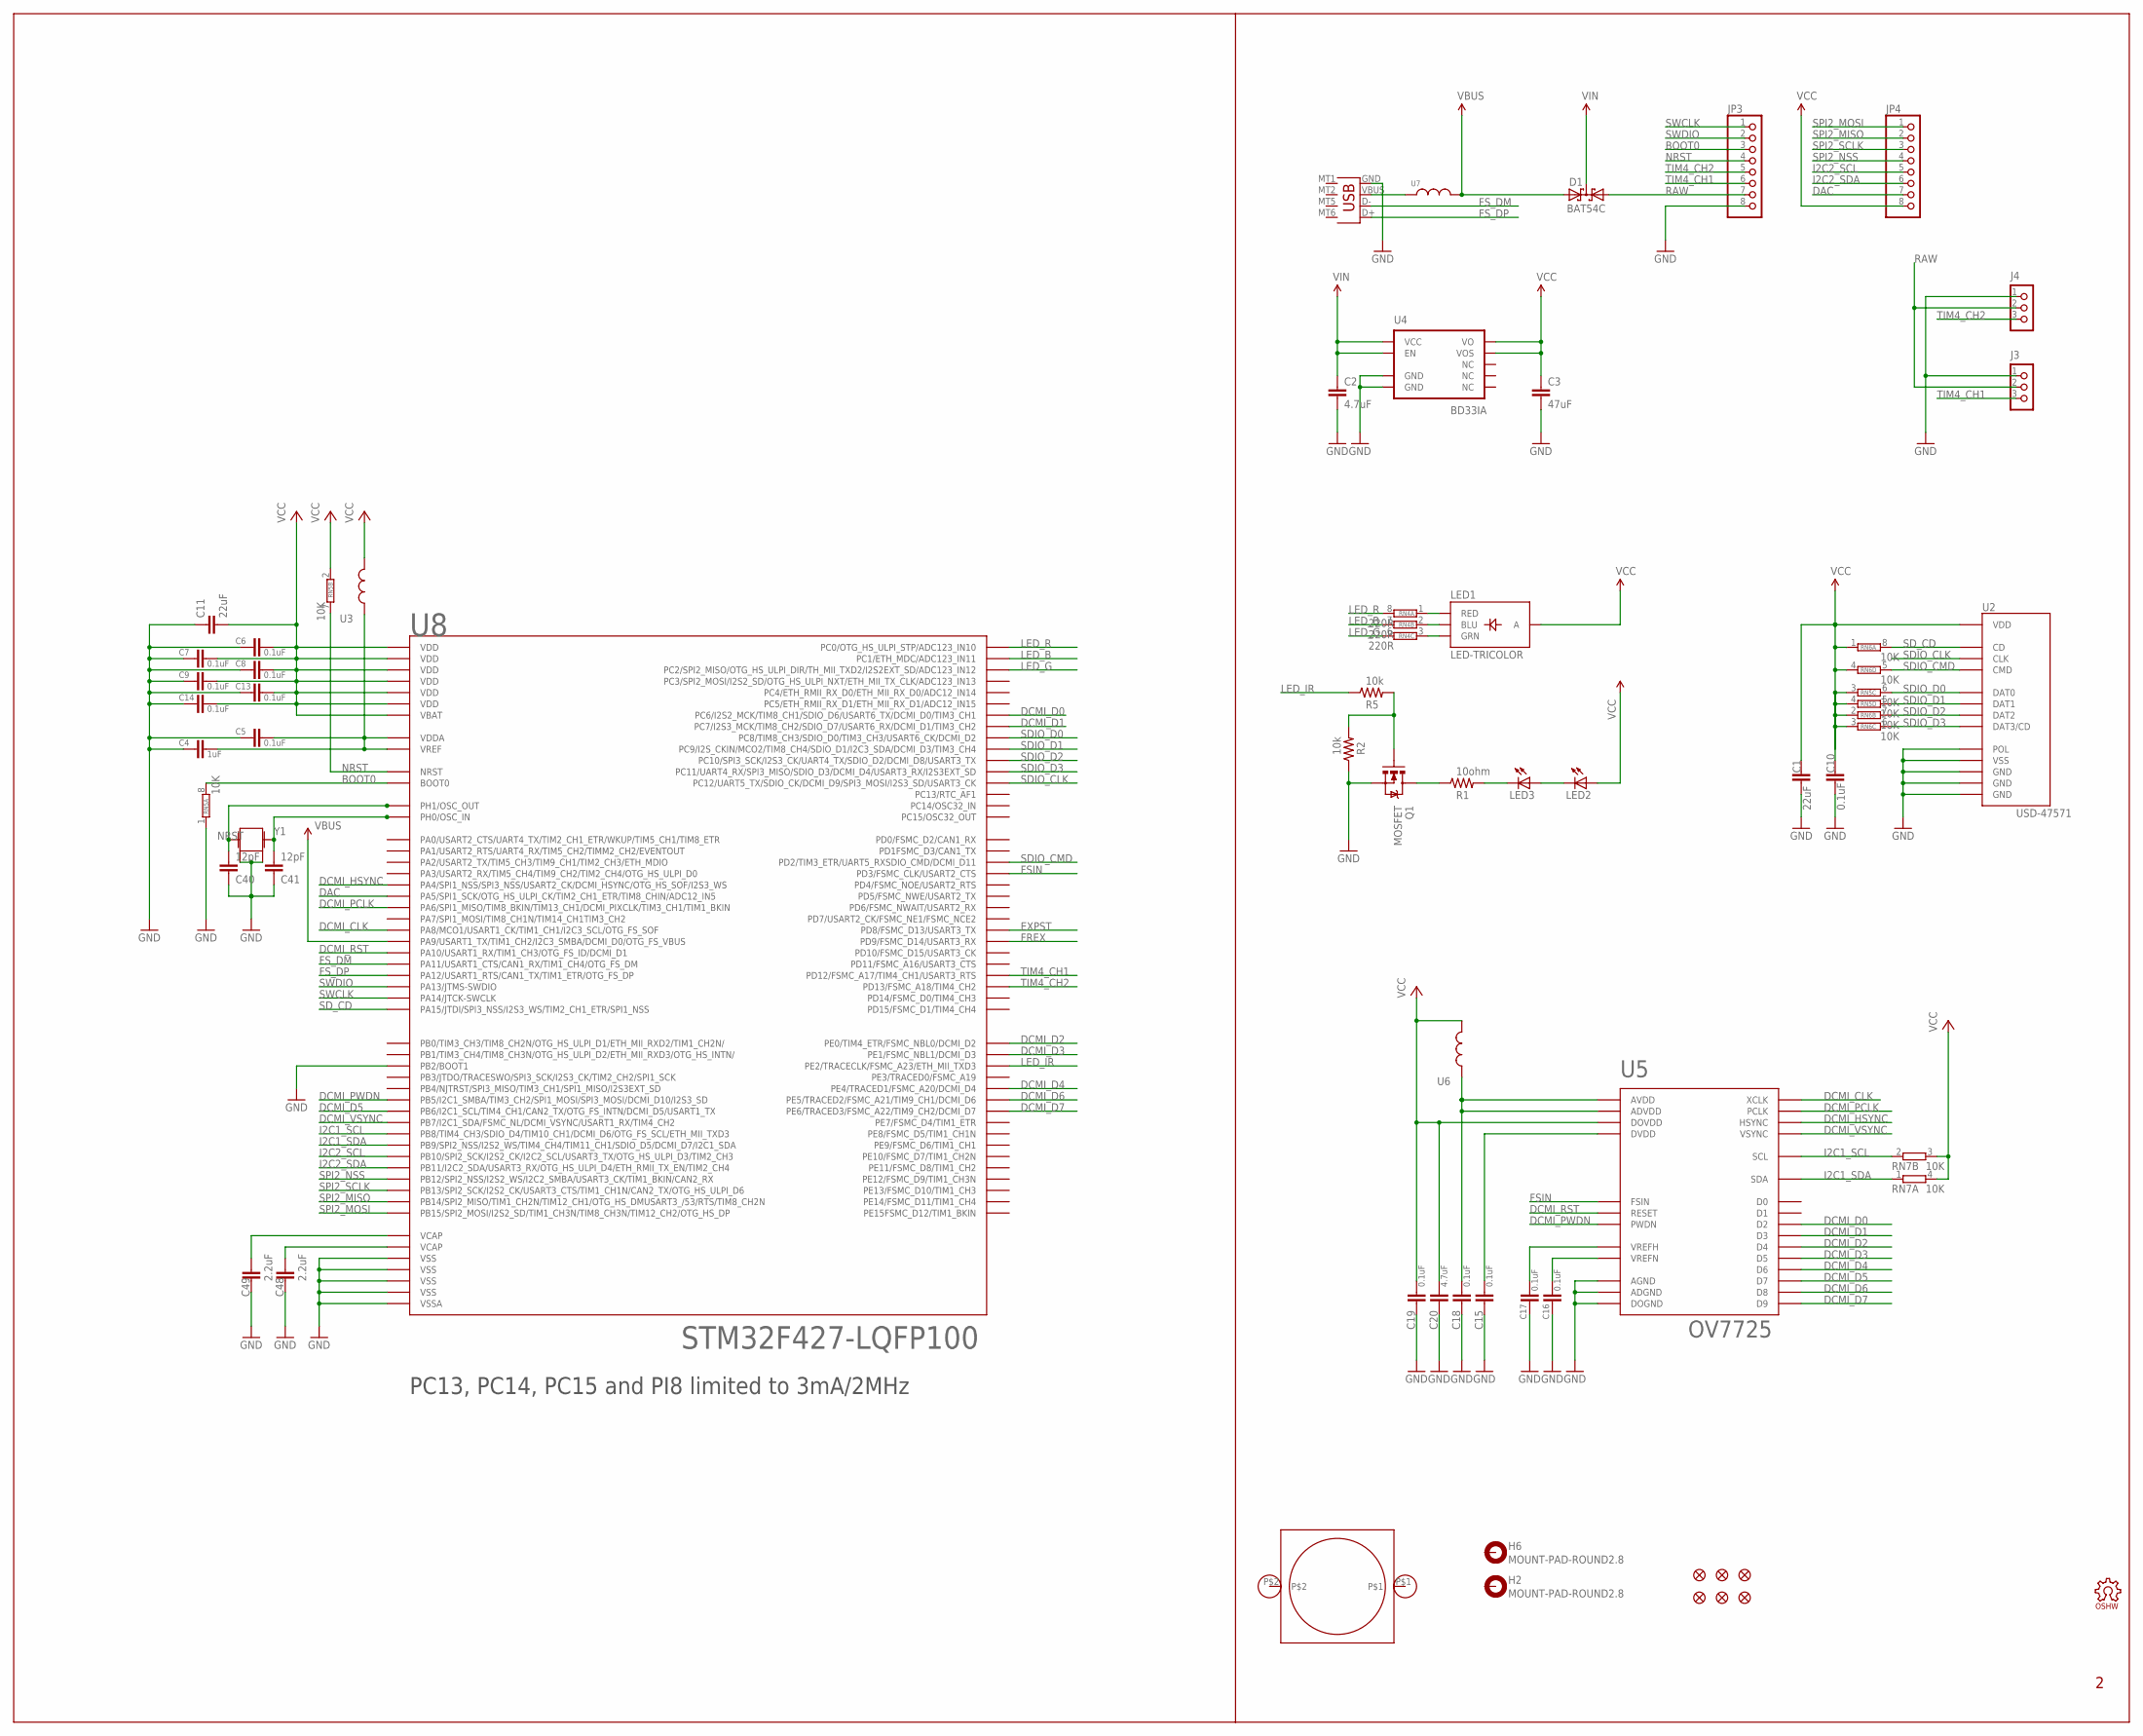
[picture p167: schematic openmv2.sch]

Parts:
C1, C11: 22uF; 0805
C2, C20: 4.7uF; 0603-CAP
C3: 47uF; 1206
C4: 1uF; 0603-CAP
C5, C6, C7, C8, C9, C10, C13, C14, C15, C16, C17, C18, C19: 0.1uF; 0603-CAP
C40, C41: 12pF; 0603-CAP
C48, C49: 2.2uF; 0603-CAP
D1: BAT54C; SOT23
H2, H6: MOUNT-PAD-ROUND2.8; 2,8-PAD
J3, J4: CON_HEADER_1X03; M1X3_SMD
JP1, JP2, JP5, JP6, JP7, JP8: FIDUCIAL1X2; FIDUCIAL-1X2
JP3, JP4: PINHD-1X8; 1X08
LED1: LED-TRICOLOR; LED-TRICOLOR-SMD
LED2, LED3: LED3MM
LOGO1: OSHW_LOGO_FILLX0150-NT; OSHW_FILLX150_NOTEXT
Q1: MOSFET; SOT23-3
R1: 10ohm; 0603-RES
R2, R5: 10k; 0603-RES
RN4: 220R; EXBV8V
RN5, RN6: 10K; EXBV8V
RN7: 10K; EXBV4V
U1: LENSMOUNT20MM; LENSMOUNT-20MM
U2: USD-47571
U3, U6, U7: INDUCTOR0603; 0603
U4: BD33IA; HTSOP-J8
U5: OV7725; CSP2-28
U8: STM32F427-LQFP100; LQFP100
X2: USB-MICROB
Y1: CRYSTAL2.5X2.0; CRYSTAL-2.5X2.0

Connections:
BOOT0: JP3.3, RN5.8 (2), U8.94 (BOOT0)
DAC: JP4.7, U8.30 (PA5/SPI1_SCK/OTG_HS_ULPI_CK/TIM2_CH1_ET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)
DCMI_CLK: U5.F3 (XCLK), U8.67 (PA8/MCO1/USART1_CK/TIM1_CH1/I2C3_SCL/OT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)
DCMI_D0: U5.F5 (D2), U8.63 (PC6/I2S2_MCK/TIM8_CH1/SDIO_D6/USART6_TX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)
DCMI_D1: U5.F2 (D3), U8.64 (PC7/I2S3_MCK/TIM8_CH2/SDIO_D7/USART6_RX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)
DCMI_D2: U5.D6 (D4), U8.97 (PE0/TIM4_ETR/FSMC_NBL0/DCMI_D2)
DCMI_D3: U5.D1 (D5), U8.98 (PE1/FSMC_NBL1/DCMI_D3)
DCMI_D4: U5.E6 (D6), U8.3 (PE4/TRACED1/FSMC_A20/DCMI_D4)
DCMI_D5: U5.E1 (D7), U8.92 (PB6/I2C1_SCL/TIM4_CH1/CAN2_TX/OTG_FS_IN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)
DCMI_D6: U5.F6 (D8), U8.4 (PE5/TRACED2/FSMC_A21/TIM9_CH1/DCMI_D6)
DCMI_D7: U5.F1 (D9), U8.5 (PE6/TRACED3/FSMC_A22/TIM9_CH2/DCMI_D7)
DCMI_HSYNC: U5.B6 (HSYNC), U8.29 (PA4/SPI1_NSS/SPI3_NSS/USART2_CK/DCMI_HS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)
DCMI_PCLK: U5.E4 (PCLK), U8.31 (PA6/SPI1_MISO/TIM8_BKIN/TIM13_CH1/DCMI_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)
DCMI_PWDN: U5.C1 (PWDN), U8.91 (PB5/I2C1_SMBA/TIM3_CH2/SPI1_MOSI/SPI3_M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)
DCMI_RST: U5.A2 (RESET), U8.69 (PA10/USART1_RX/TIM1_CH3/OTG_FS_ID/DCMI_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)
DCMI_VSYNC: U5.C6 (VSYNC), U8.93 (PB7/I2C1_SDA/FSMC_NL/DCMI_VSYNC/USART1_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)
EXPST: U8.55 (PD8/FSMC_D13/USART3_TX)
FREX: U8.56 (PD9/FSMC_D14/USART3_RX)
FSIN: U5.A4 (FSIN), U8.84 (PD3/FSMC_CLK/USART2_CTS)
FS_DM: U8.70 (PA11/USART1_CTS/CAN1_RX/TIM1_CH4/OTG_FS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), X2.D-
FS_DP: U8.71 (PA12/USART1_RTS/CAN1_TX/TIM1_ETR/OTG_FS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), X2.D+
GND: C1.2, C2.2, C3.2, C4.2, C5.2, C6.2, C7.2, C8.2, C9.2, C10.2, C11.1, C13.2, C14.2, C15.2, C16.2, C17.2, C18.2, C19.2, C20.2, C40.1, C41.1, C48.2, C49.2, J3.1, J4.1, JP3.8, Q1.2 (S), R2.1, RN5.1, U2.G$1 (GND), U2.G$2 (GND), U2.G$3 (GND), U2.G$4 (POL), U2.P$6 (VSS), U4.3 (GND), U4.P$1 (GND), U5.B1 (ADGND), U5.B4 (AGND), U5.F4 (DOGND), U8.10 (VSS), U8.20 (VSSA), U8.27 (VSS), U8.37 (PB2/BOOT1), U8.74 (VSS), U8.99 (VSS), X2.GND, Y1.2, Y1.4
I2C1_SCL: RN7.2 (1), U5.A5 (SCL), U8.95 (PB8/TIM4_CH3/SDIO_D4/TIM10_CH1/DCMI_D6/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)
I2C1_SDA: RN7.1, U5.B5 (SDA), U8.96 (PB9/SPI2_NSS/I2S2_WS/TIM4_CH4/TIM11_CH1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)
I2C2_SCL: JP4.5, U8.47 (PB10/SPI2_SCK/I2S2_CK/I2C2_SCL/USART3_T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)
I2C2_SDA: JP4.6, U8.48 (PB11/I2C2_SDA/USART3_RX/OTG_HS_ULPI_D4/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)
LED_B: RN4.7 (2), U8.16 (PC1/ETH_MDC/ADC123_IN11)
LED_G: RN4.6 (2), U8.17 (PC2/SPI2_MISO/OTG_HS_ULPI_DIR/TH_MII_TX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)
LED_IR: R5.1, U8.1 (PE2/TRACECLK/FSMC_A23/ETH_MII_TXD3)
LED_R: RN4.8 (2), U8.15 (PC0/OTG_HS_ULPI_STP/ADC123_IN10)
unnamed: C17.1, U5.A3 (VREFH)
unnamed: C40.2, U8.13 (PH1/OSC_OUT), Y1.3 (2)
unnamed: C16.1, U5.B2 (VREFN)
unnamed: C41.2, U8.12 (PH0/OSC_IN), Y1.1
unnamed: Q1.1 (G), R2.2, R5.2
unnamed: U7.1, X2.VBUS
unnamed: LED1.R (RED), RN4.1
unnamed: LED1.G (GRN), RN4.3 (1)
unnamed: LED3.K (C), R1.2
unnamed: LED1.B (BLU), RN4.2 (1)
unnamed: C4.1, C5.1, U3.1, U8.21 (VREF), U8.22 (VDDA)
unnamed: C18.1, U5.A1 (ADVDD), U5.B3 (AVDD), U6.1
unnamed: Q1.3 (D), R1.1
unnamed: C15.1, U5.E3 (DVDD)
unnamed: LED2.K (C), LED3.A
NRST: JP3.4, RN5.7 (2), U8.14 (NRST)
RAW: D1.1 (A1), J3.2, J4.2, JP3.7
SDIO_CLK: U2.P$5 (CLK), U8.80 (PC12/UART5_TX/SDIO_CK/DCMI_D9/SPI3_MOSI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)
SDIO_CMD: RN6.5 (2), U2.P$3 (CMD), U8.83 (PD2/TIM3_ETR/UART5_RXSDIO_CMD/DCMI_D11)
SDIO_D0: RN5.6 (2), U2.P$7 (DAT0), U8.65 (PC8/TIM8_CH3/SDIO_D0/TIM3_CH3/USART6_CK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)
SDIO_D1: RN5.5 (2), U2.P$8 (DAT1), U8.66 (PC9/I2S_CKIN/MCO2/TIM8_CH4/SDIO_D1/I2C3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)
SDIO_D2: RN6.7 (2), U2.P$1 (DAT2), U8.78 (PC10/SPI3_SCK/I2S3_CK/UART4_TX/SDIO_D2/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)
SDIO_D3: RN6.6 (2), U2.P$2 (DAT3/CD), U8.79 (PC11/UART4_RX/SPI3_MISO/SDIO_D3/DCMI_D4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)
SD_CD: RN6.8 (2), U2.G$5 (CD), U8.77 (PA15/JTDI/SPI3_NSS/I2S3_WS/TIM2_CH1_ETR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)
SPI2_MISO: JP4.2, U8.53 (PB14/SPI2_MISO/TIM1_CH2N/TIM12_CH1/OTG_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)
SPI2_MOSI: JP4.1, U8.54 (PB15/SPI2_MOSI/I2S2_SD/TIM1_CH3N/TIM8_C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)
SPI2_NSS: JP4.4, U8.51 (PB12/SPI2_NSS/I2S2_WS/I2C2_SMBA/USART3_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)
SPI2_SCLK: JP4.3, U8.52 (PB13/SPI2_SCK/I2S2_CK/USART3_CTS/TIM1_C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)
SWCLK: JP3.1, U8.76 (PA14/JTCK-SWCLK)
SWDIO: JP3.2, U8.72 (PA13/JTMS-SWDIO)
TIM4_CH1: J3.3, JP3.6, U8.59 (PD12/FSMC_A17/TIM4_CH1/USART3_RTS)
TIM4_CH2: J4.3, JP3.5, U8.60 (PD13/FSMC_A18/TIM4_CH2)
VBUS: D1.2 (A2), U7.2, U8.68 (PA9/USART1_TX/TIM1_CH2/I2C3_SMBA/DCMI_D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)
VCAP1: C49.1, U8.49 (VCAP)
VCAP2: C48.1, U8.73 (VCAP)
VCC: C1.1, C3.1, C6.1, C7.1, C8.1, C9.1, C10.1, C11.2, C13.1, C14.1, C19.1, C20.1, JP4.8, LED1.A, LED2.A, RN5.2 (1), RN5.3 (1), RN5.4 (1), RN6.1, RN6.2 (1), RN6.3 (1), RN6.4 (1), RN7.3 (2), RN7.4 (2), U2.P$4 (VDD), U3.2, U4.1 (VO), U4.2 (VOS), U5.E5 (DOVDD), U6.2, U8.6 (VBAT), U8.11 (VDD), U8.19 (VDD), U8.28 (VDD), U8.50 (VDD), U8.75 (VDD), U8.100 (VDD)
VIN: C2.1, D1.3 (CC), U4.5 (EN), U4.8 (VCC)

Notes on the sheet:
PC13, PC14, PC15 and PI8 limited to 3mA/2MHz

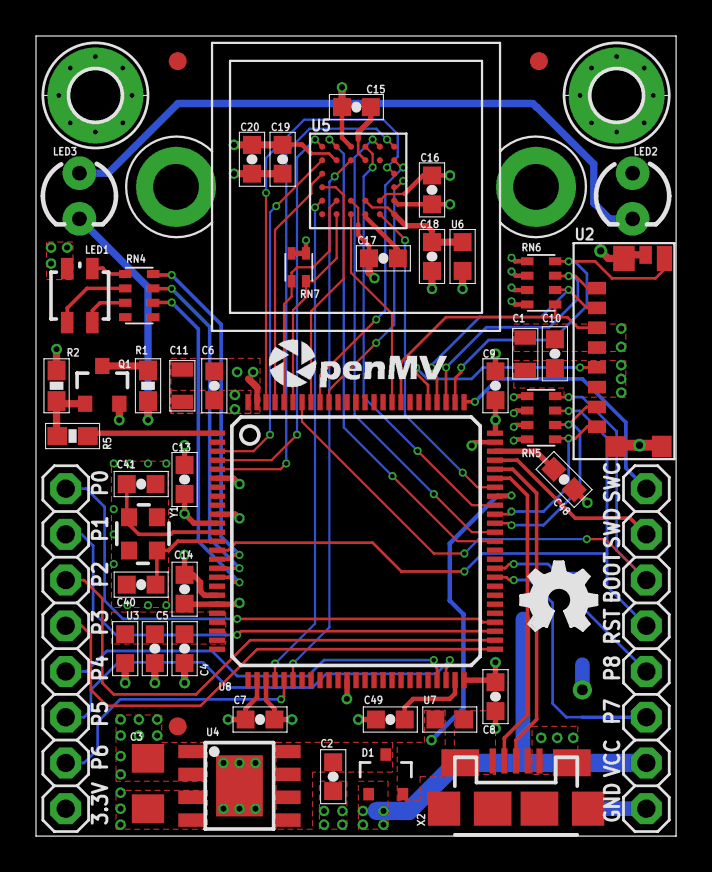
[picture p168: board openmv2.brd from above]

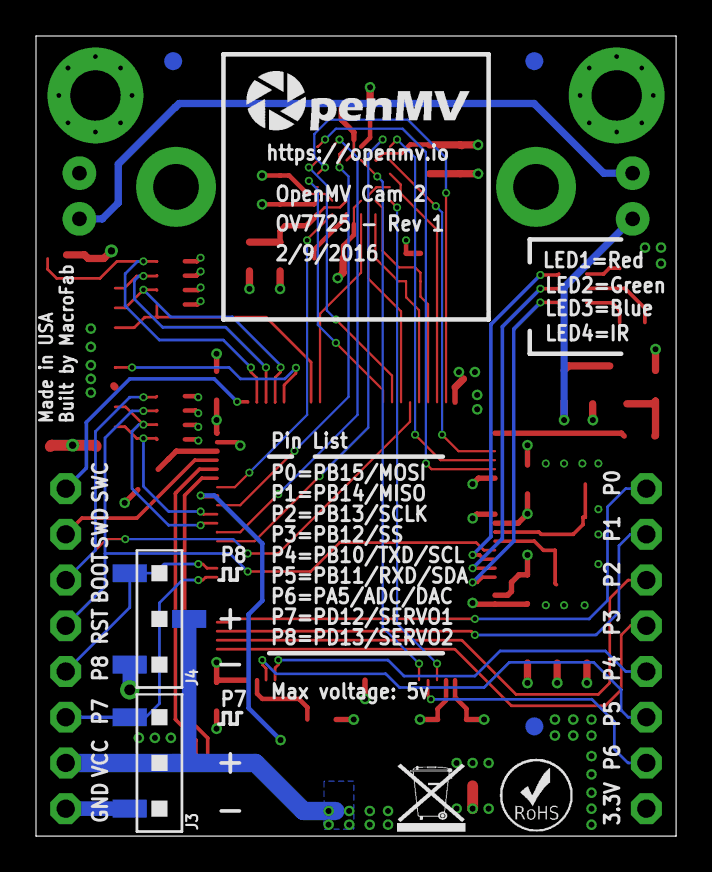
[picture p169: board openmv2.brd from below]

Board: 4 copper layers, 35.6 x 44.5 mm, 62 parts (8 on the bottom side), 65 nets.

Other parts of the board:
U$1: WEEE
U$2: ROHS
U$3: OMV-LOGO
U$4: OMV-LOGO-SMALL
