PyCubed-Mini/OpenMV_Camera/openmv-official-repo-for-reference/shields/thermal/thermal.brd

## EAGLE design openmv-official-repo-for-reference/shields/thermal/thermal.brd (2019-10-06)

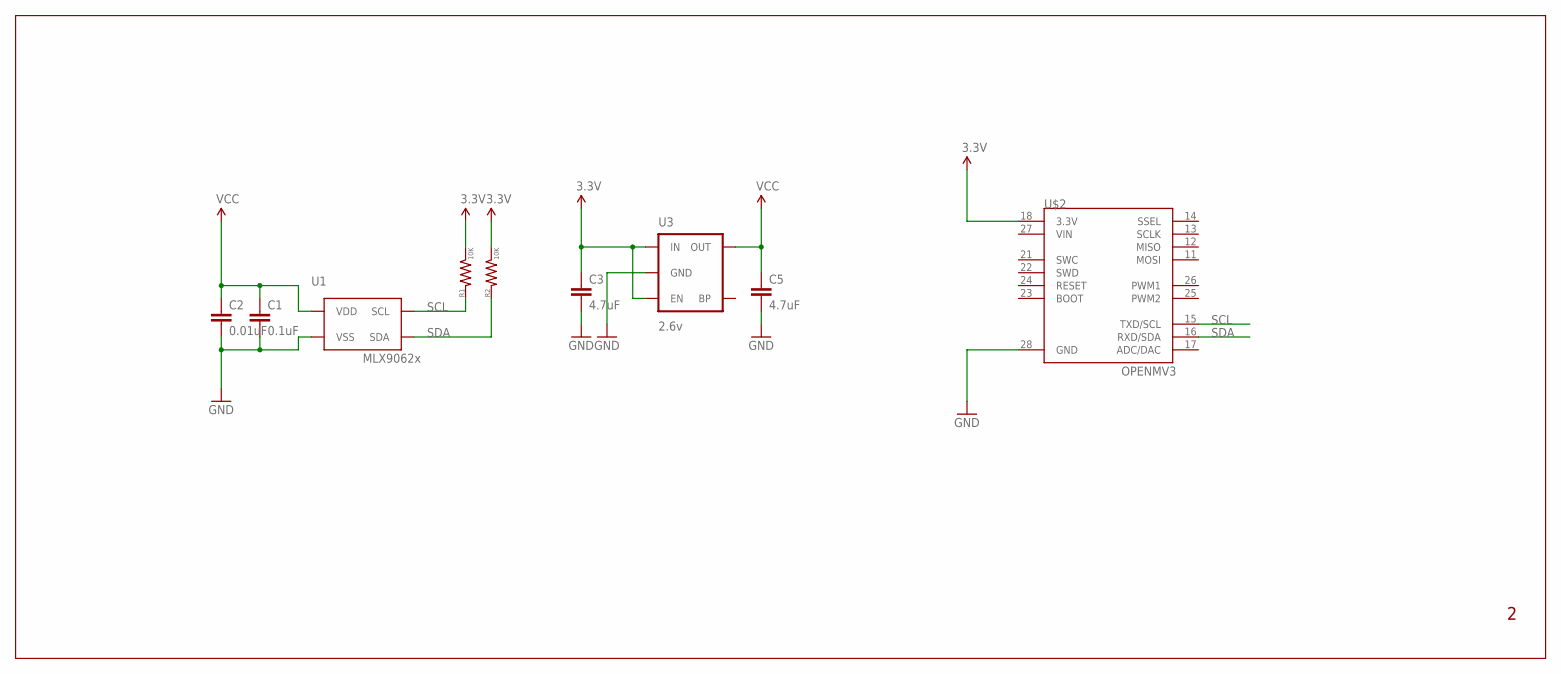
[picture p170: schematic thermal.sch]

Parts:
C1: 0.1uF; 0603-CAP
C2: 0.01uF; 0603-CAP
C3, C5: 4.7uF; 0603-CAP
R1, R2: 10K; 0603-RES
U1: MLX9062x; TO39/4
U3: 2.6v; SOT23-5
U$2: OPENMV3

Connections:
3.3V: C3.1, R1.1, R2.1, U3.1 (IN), U3.3 (EN), U$2.18 (3.3V)
GND: C1.2, C2.2, C3.2, C5.2, U1.4 (VSS), U3.2 (GND), U$2.28 (GND)
SCL: R1.2, U1.1 (SCL), U$2.15 (TXD/SCL)
SDA: R2.2, U1.2 (SDA), U$2.16 (RXD/SDA)
VCC: C1.1, C2.1, C5.1, U1.3 (VDD), U3.5 (OUT)
VIN: U$2.27 (VIN)

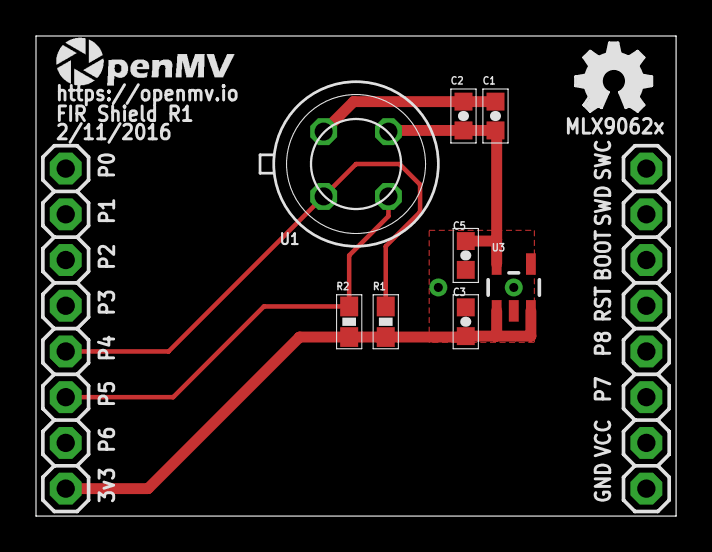
[picture p171: board thermal.brd from above]

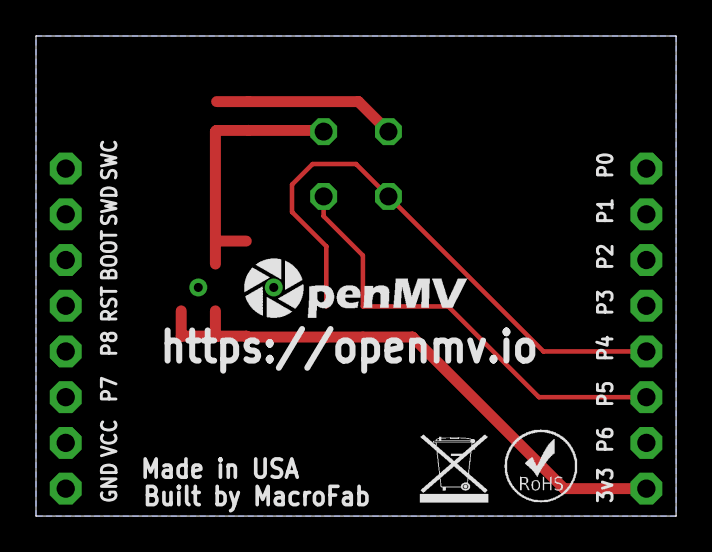
[picture p172: board thermal.brd from below]

Board: 2 copper layers, 35.6 x 26.7 mm, 14 parts (3 on the bottom side), 5 nets.

Other parts of the board:
U$3: OMV-LOGO
U$5: ROHS
U$6: WEEE
U$7: OSHW_FILLX150_NOTEXT
U$10: OMV-LOGO-SMALL
