PyCubed-Mini/OpenMV_Camera/openmv-official-repo-for-reference/openmv1/openmv.brd

## EAGLE design openmv-official-repo-for-reference/openmv1/openmv.brd (2019-10-06)

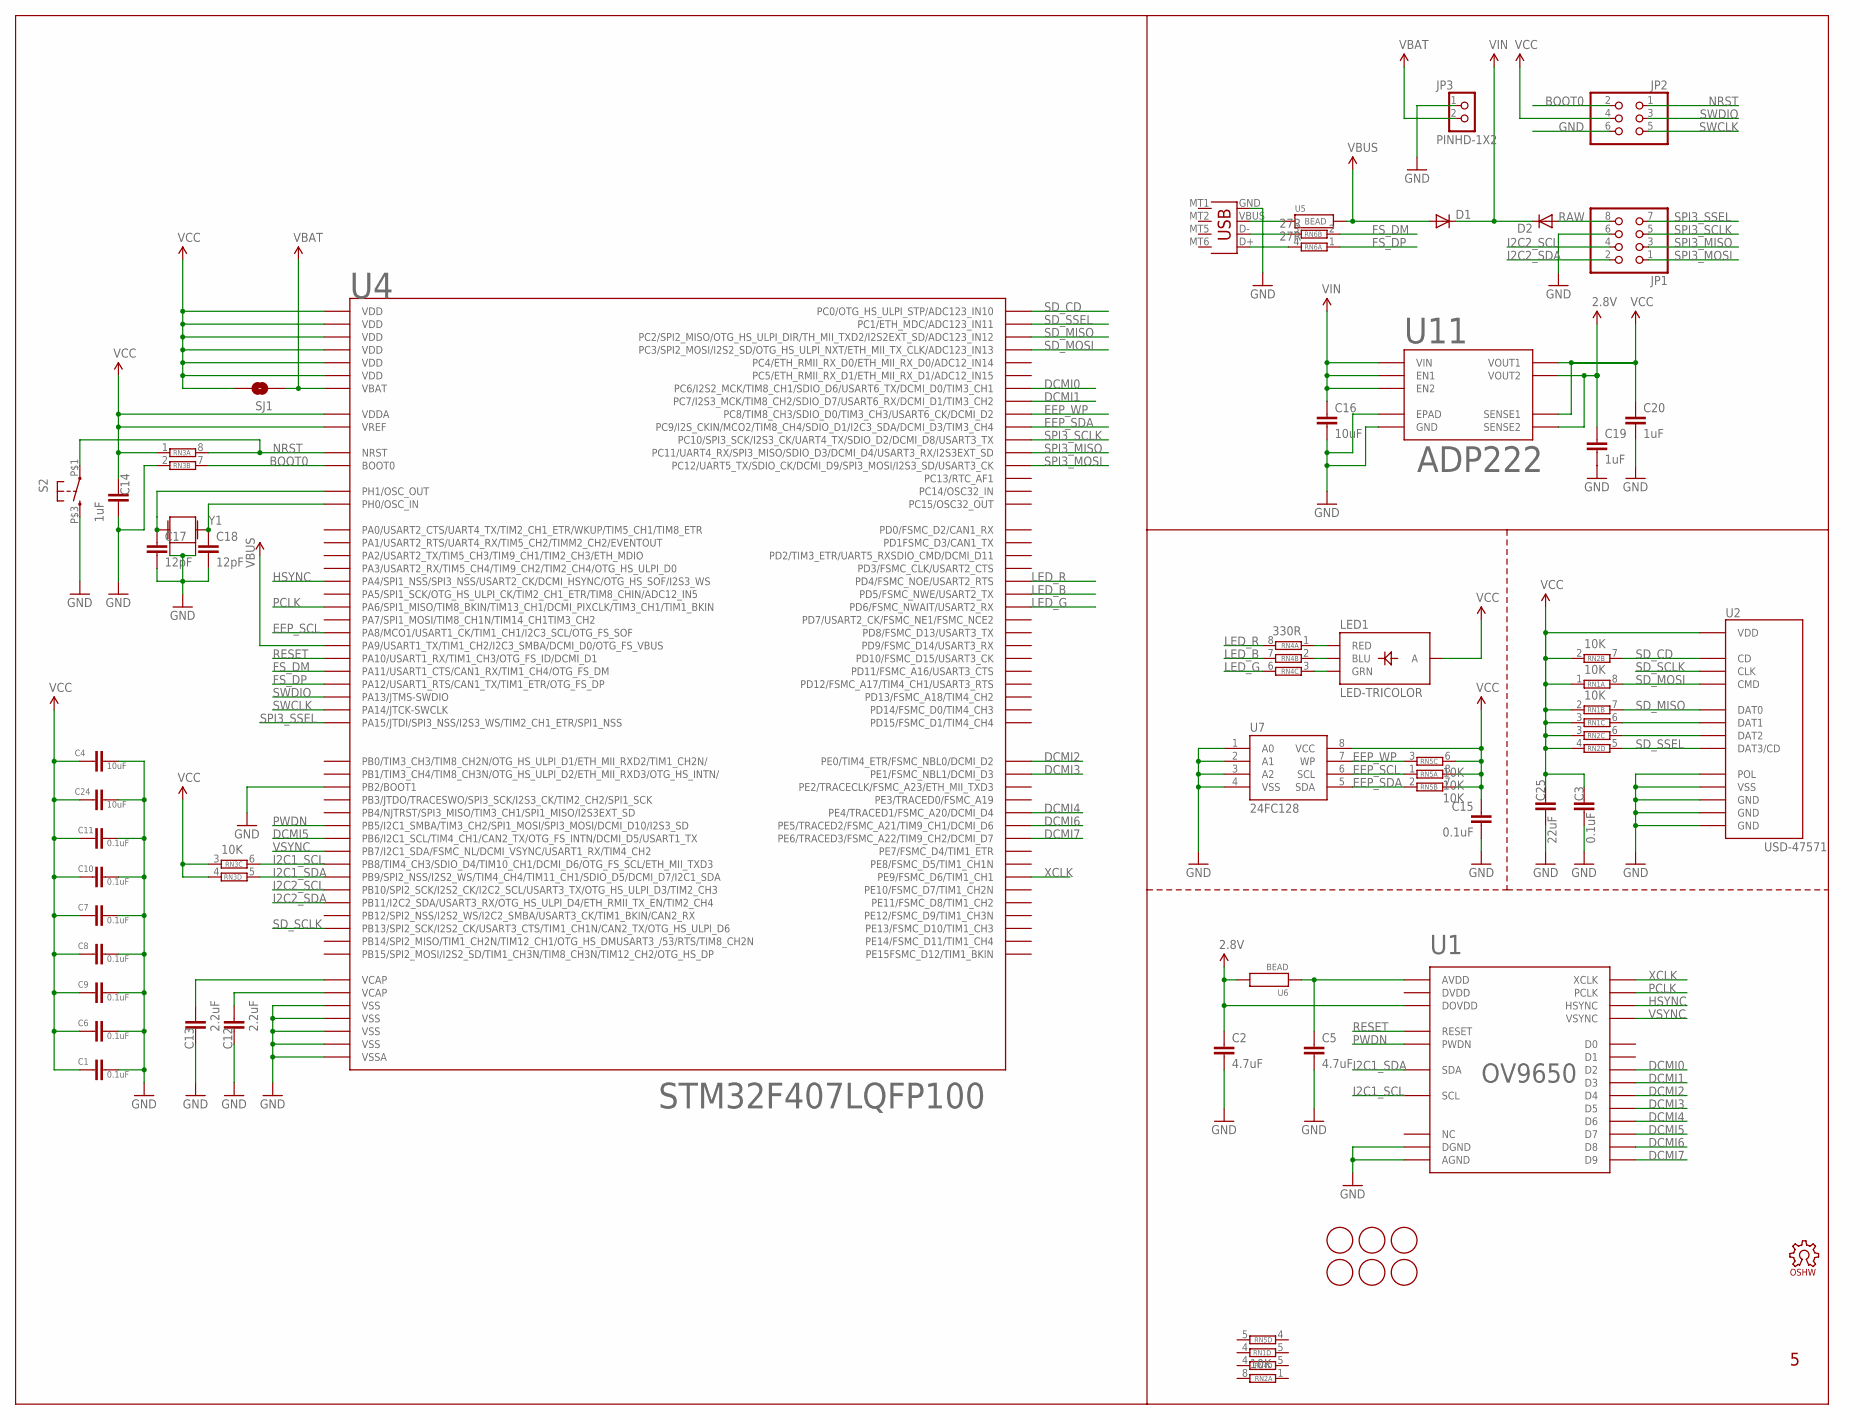
[picture p173: schematic openmv.sch]

Parts:
C1, C3, C6, C7, C8, C9, C10, C11, C15: 0.1uF; 0402-CAP
C2, C5: 4.7uF; 0402-CAP
C4, C16, C24: 10uF; 0805
C12, C13: 2.2uF; 0402-CAP
C14, C19, C20: 1uF; 0402-CAP
C17, C18: 12pF; 0402-CAP
C25: 22uF; 0805
D1, D2: DIODESOD; SOD-323
JP1: PINHD-2X4; 2X04
JP2: PINHD-2X3; 2X03
JP3: PINHD-1X2; 1X2
LED1: LED-TRICOLOR; LED-TRICOLOR-SMD
LOGO1: OSHW_LOGO_FILLX0150-NT; OSHW_FILLX150_NOTEXT
RN1, RN2, RN3, RN5: 10K; CAT16
RN4: 330R; CAT16
RN6: 27R; EXBV4V
S2: SWITCHKMR442G; KMR442G
SJ1: SOLDERJUMPERTRACE; SJ_2S-TRACE
U1: OV9650
U2: USD-47571
U4: STM32F407LQFP100; LQFP100
U5, U6: BEAD; 0402-CAP
U7: 24FC128; MSOP8
U11: ADP222; LFCSP8
U$3, U$4, U$5, U$7, U$9, U$10: FIDUCIAL; FIDUCIAL_1MM
X1: USB-MICROB
Y1: CRYSTAL2.5X2.0; CRYSTAL-2.5X2.0

Connections:
2.8V: C2.1, C19.1, U1.P$11 (DOVDD), U6.2, U11.4 (SENSE2), U11.5 (VOUT2)
BOOT0: JP2.2, RN3.7 (2), U4.94 (BOOT0)
DCMI0: U1.P$19 (D2), U4.63 (PC6/I2S2_MCK/TIM8_CH1/SDIO_D6/USART6_TX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)
DCMI1: U1.P$21 (D3), U4.64 (PC7/I2S3_MCK/TIM8_CH2/SDIO_D7/USART6_RX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)
DCMI2: U1.P$22 (D4), U4.97 (PE0/TIM4_ETR/FSMC_NBL0/DCMI_D2)
DCMI3: U1.P$20 (D5), U4.98 (PE1/FSMC_NBL1/DCMI_D3)
DCMI4: U1.P$18 (D6), U4.3 (PE4/TRACED1/FSMC_A20/DCMI_D4)
DCMI5: U1.P$16 (D7), U4.92 (PB6/I2C1_SCL/TIM4_CH1/CAN2_TX/OTG_FS_IN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)
DCMI6: U1.P$14 (D8), U4.4 (PE5/TRACED2/FSMC_A21/TIM9_CH1/DCMI_D6)
DCMI7: U1.P$12 (D9), U4.5 (PE6/TRACED3/FSMC_A22/TIM9_CH2/DCMI_D7)
EEP_SCL: RN5.1, U4.67 (PA8/MCO1/USART1_CK/TIM1_CH1/I2C3_SCL/OT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), U7.6 (SCL)
EEP_SDA: RN5.2 (1), U4.66 (PC9/I2S_CKIN/MCO2/TIM8_CH4/SDIO_D1/I2C3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), U7.5 (SDA)
EEP_WP: RN5.3 (1), U4.65 (PC8/TIM8_CH3/SDIO_D0/TIM3_CH3/USART6_CK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), U7.7 (WP)
FS_DM: RN6.2 (1), U4.70 (PA11/USART1_CTS/CAN1_RX/TIM1_CH4/OTG_FS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)
FS_DP: RN6.1, U4.71 (PA12/USART1_RTS/CAN1_TX/TIM1_ETR/OTG_FS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)
GND: C1.1, C2.2, C3.2, C4.1, C5.2, C6.1, C7.2, C8.1, C9.1, C10.2, C11.2, C12.2, C13.2, C14.1, C15.2, C16.2, C17.2, C18.2, C19.2, C20.2, C24.1, C25.2, JP1.6, JP2.6, JP3.1, RN3.2 (1), S2.P$3 (2), U1.P$2 (AGND), U1.P$15 (DGND), U2.G$1 (GND), U2.G$2 (GND), U2.G$3 (GND), U2.G$4 (POL), U2.P$6 (VSS), U4.10 (VSS), U4.20 (VSSA), U4.27 (VSS), U4.37 (PB2/BOOT1), U4.74 (VSS), U4.99 (VSS), U7.1 (A0), U7.2 (A1), U7.3 (A2), U7.4 (VSS), U11.3 (GND), U11.EXP (EPAD), X1.GND, Y1.2, Y1.4
HSYNC: U1.P$9 (HSYNC), U4.29 (PA4/SPI1_NSS/SPI3_NSS/USART2_CK/DCMI_HS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)
I2C1_SCL: RN3.6 (2), U1.P$5 (SCL), U4.95 (PB8/TIM4_CH3/SDIO_D4/TIM10_CH1/DCMI_D6/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)
I2C1_SDA: RN3.5 (2), U1.P$3 (SDA), U4.96 (PB9/SPI2_NSS/I2S2_WS/TIM4_CH4/TIM11_CH1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)
I2C2_SCL: JP1.4, U4.47 (PB10/SPI2_SCK/I2S2_CK/I2C2_SCL/USART3_T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)
I2C2_SDA: JP1.2, U4.48 (PB11/I2C2_SDA/USART3_RX/OTG_HS_ULPI_D4/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)
LED_B: RN4.7 (2), U4.86 (PD5/FSMC_NWE/USART2_TX)
LED_G: RN4.6 (2), U4.87 (PD6/FSMC_NWAIT/USART2_RX)
LED_R: RN4.8 (2), U4.85 (PD4/FSMC_NOE/USART2_RTS)
unnamed: RN1.6 (2), U2.P$8 (DAT1)
unnamed: RN2.6 (2), U2.P$1 (DAT2)
unnamed: LED1.R (RED), RN4.1
unnamed: LED1.G (GRN), RN4.3 (1)
unnamed: LED1.B (BLU), RN4.2 (1)
unnamed: C17.1, U4.13 (PH1/OSC_OUT), Y1.3 (2)
unnamed: RN6.3 (2), X1.D-
unnamed: C18.1, U4.12 (PH0/OSC_IN), Y1.1
unnamed: C5.1, U1.P$4 (AVDD), U6.1
unnamed: RN6.4 (2), X1.D+
unnamed: U5.1, X1.VBUS
NRST: JP2.1, RN3.8 (2), S2.P$1 (1), U4.14 (NRST)
PCLK: U1.P$17 (PCLK), U4.31 (PA6/SPI1_MISO/TIM8_BKIN/TIM13_CH1/DCMI_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)
PWDN: U1.P$8 (PWDN), U4.91 (PB5/I2C1_SMBA/TIM3_CH2/SPI1_MOSI/SPI3_M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)
RAW: D2.2 (A), JP1.8
RESET: U1.P$6 (RESET), U4.69 (PA10/USART1_RX/TIM1_CH3/OTG_FS_ID/DCMI_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)
SD_CD: RN2.7 (2), U2.G$5 (CD), U4.15 (PC0/OTG_HS_ULPI_STP/ADC123_IN10)
SD_MISO: RN1.7 (2), U2.P$7 (DAT0), U4.17 (PC2/SPI2_MISO/OTG_HS_ULPI_DIR/TH_MII_TX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)
SD_MOSI: RN1.8 (2), U2.P$3 (CMD), U4.18 (PC3/SPI2_MOSI/I2S2_SD/OTG_HS_ULPI_NXT/E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)
SD_SCLK: U2.P$5 (CLK), U4.52 (PB13/SPI2_SCK/I2S2_CK/USART3_CTS/TIM1_C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)
SD_SSEL: RN2.5 (2), U2.P$2 (DAT3/CD), U4.16 (PC1/ETH_MDC/ADC123_IN11)
SPI3_MISO: JP1.3, U4.79 (PC11/UART4_RX/SPI3_MISO/SDIO_D3/DCMI_D4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)
SPI3_MOSI: JP1.1, U4.80 (PC12/UART5_TX/SDIO_CK/DCMI_D9/SPI3_MOSI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)
SPI3_SCLK: JP1.5, U4.78 (PC10/SPI3_SCK/I2S3_CK/UART4_TX/SDIO_D2/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)
SPI3_SSEL: JP1.7, U4.77 (PA15/JTDI/SPI3_NSS/I2S3_WS/TIM2_CH1_ETR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)
SWCLK: JP2.5, U4.76 (PA14/JTCK-SWCLK)
SWDIO: JP2.3, U4.72 (PA13/JTMS-SWDIO)
VBAT: JP3.2, SJ1.1, U4.6 (VBAT)
VBUS: D1.2 (A), U4.68 (PA9/USART1_TX/TIM1_CH2/I2C3_SMBA/DCMI_D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), U5.2
VCAP1: C13.1, U4.49 (VCAP)
VCAP2: C12.1, U4.73 (VCAP)
VCC: C1.2, C3.1, C4.2, C6.2, C7.1, C8.2, C9.2, C10.1, C11.1, C14.2, C15.1, C20.1, C24.2, C25.1, JP2.4, LED1.A, RN1.1, RN1.2 (1), RN1.3 (1), RN2.2 (1), RN2.3 (1), RN2.4 (1), RN3.1, RN3.3 (1), RN3.4 (1), RN5.6 (2), RN5.7 (2), RN5.8 (2), SJ1.2, U2.P$4 (VDD), U4.11 (VDD), U4.19 (VDD), U4.21 (VREF), U4.22 (VDDA), U4.28 (VDD), U4.50 (VDD), U4.75 (VDD), U4.100 (VDD), U7.8 (VCC), U11.7 (VOUT1), U11.8 (SENSE1)
VIN: C16.1, D1.1 (C), D2.1 (C), U11.1 (EN1), U11.2 (EN2), U11.6 (VIN)
VSYNC: U1.P$7 (VSYNC), U4.93 (PB7/I2C1_SDA/FSMC_NL/DCMI_VSYNC/USART1_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)
XCLK: U1.P$13 (XCLK), U4.40 (PE9/FSMC_D6/TIM1_CH1)

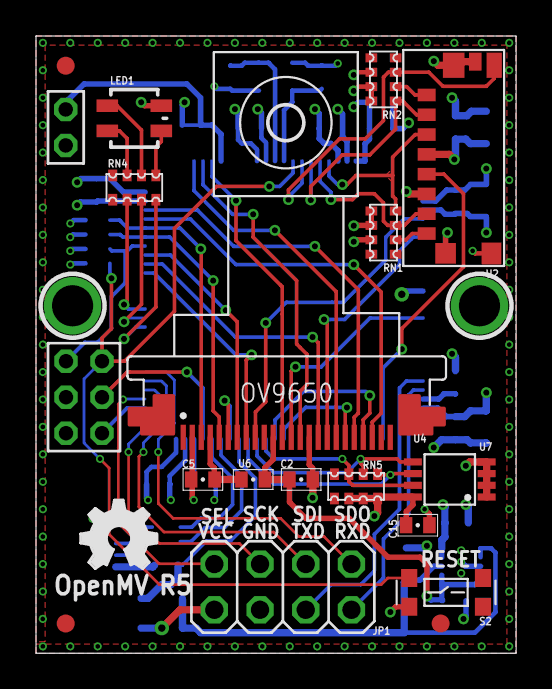
[picture p174: board openmv.brd from above]

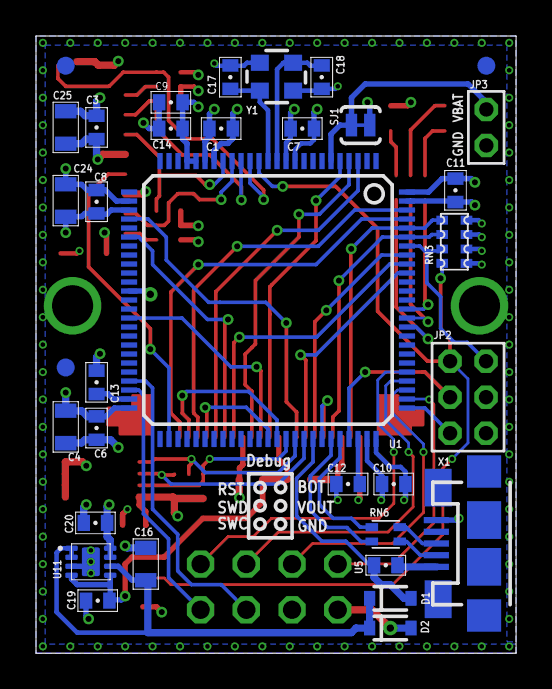
[picture p175: board openmv.brd from below]

Board: 4 copper layers, 26.7 x 34.3 mm, 52 parts (34 on the bottom side), 59 nets.
