PyCubed-Mini/OpenMV_Camera/openmv-official-repo-for-reference/shields/servo/servo.brd

## EAGLE design openmv-official-repo-for-reference/shields/servo/servo.brd (2019-10-06)

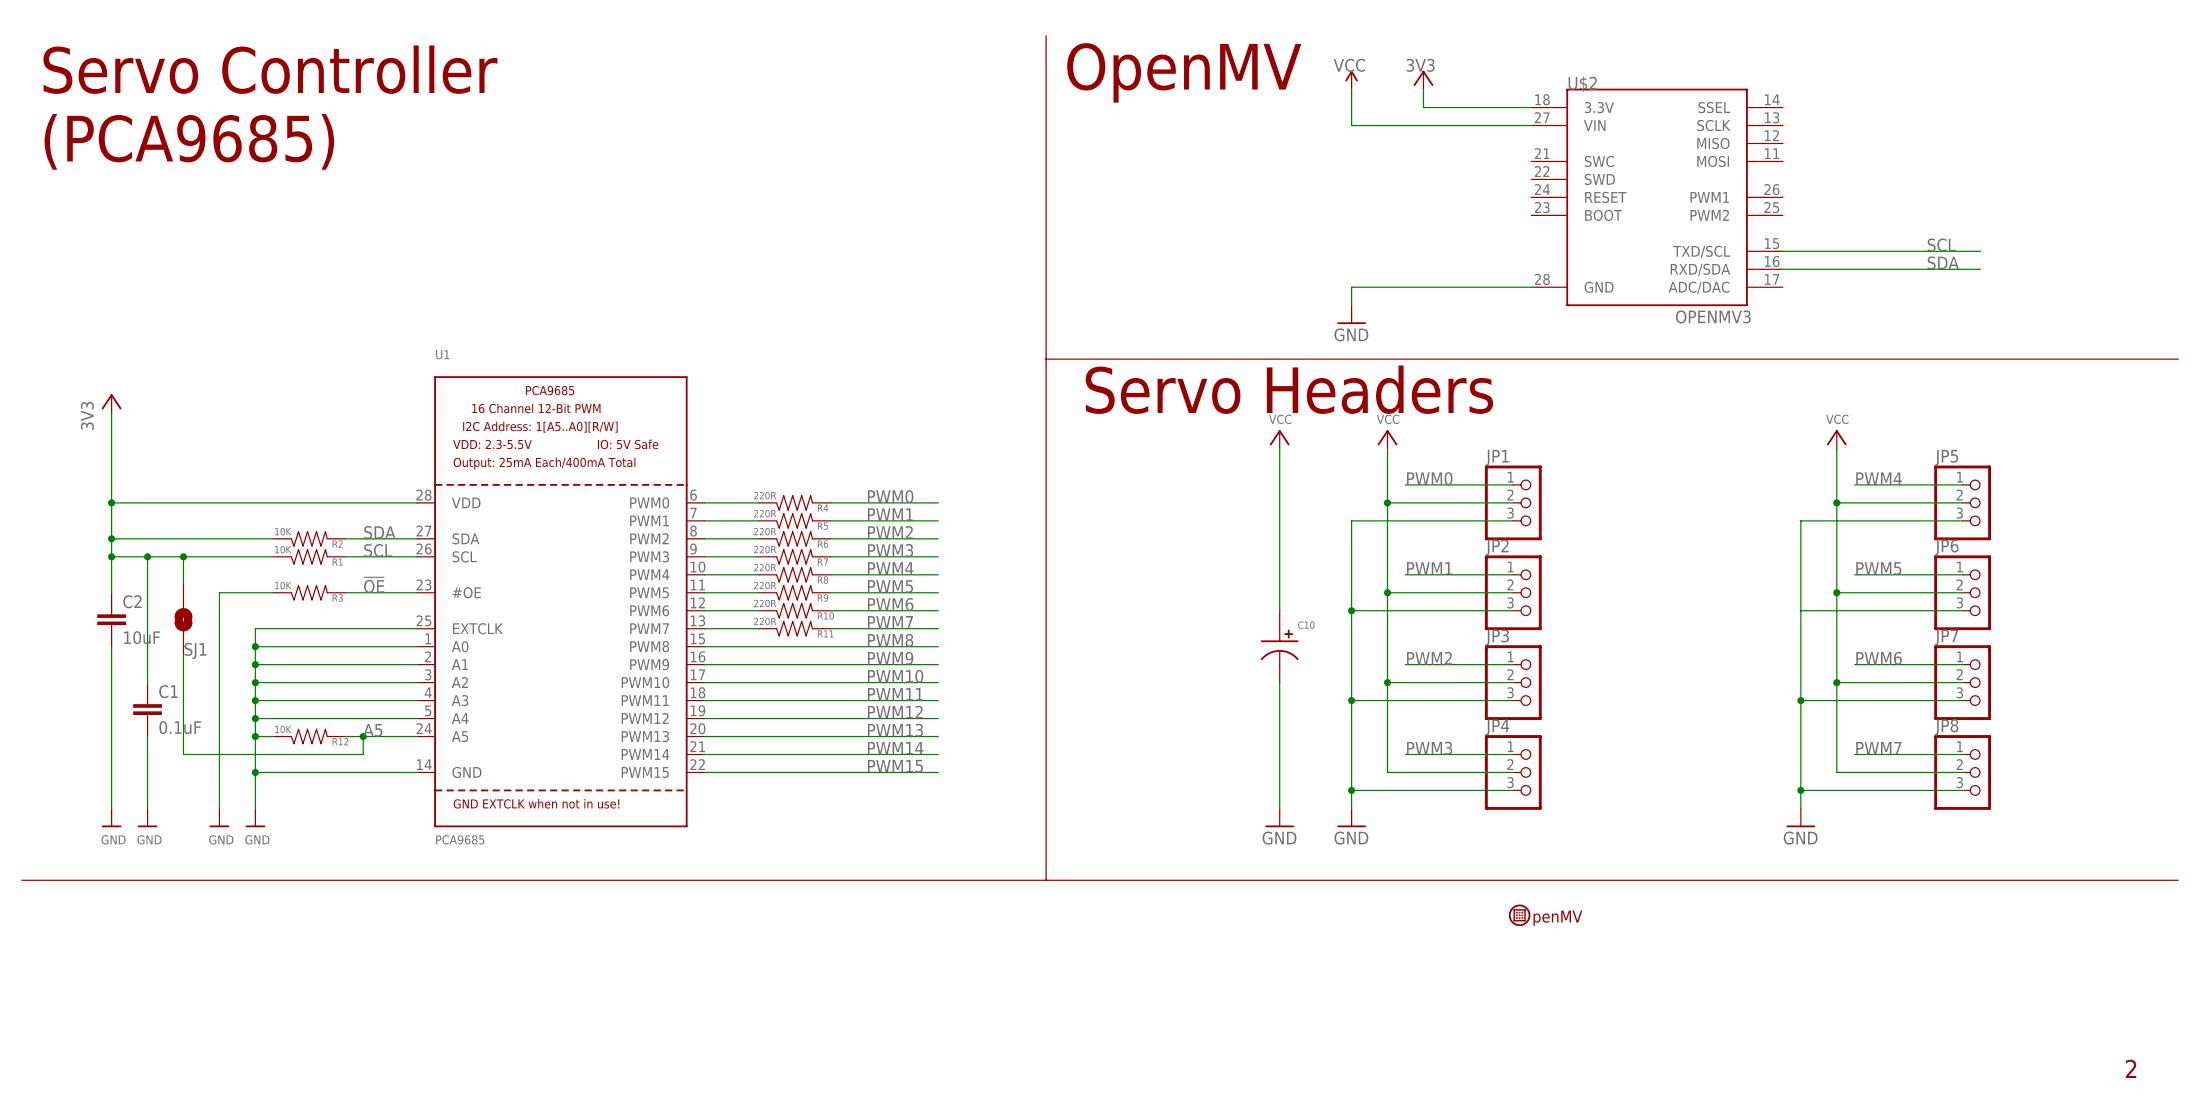
[picture p176: schematic servo.sch]

Parts:
C1: 0.1uF; 0603-CAP
C2: 10uF; 0805
C10: CAPACITOR_P_10MM; CP10MM
JP1, JP2, JP3, JP4, JP5, JP6, JP7, JP8: PINHD-1X3; 1X03
R1, R2, R3, R12: 10K; 0603-RES
R4, R5, R6, R7, R8, R9, R10, R11: 220R; 0603-RES
SJ1: SOLDERJUMPERNO; SJ_2S-NO
U1: PCA9685; TSSOP28
U$2: OPENMV3
U$9: OPENMV-LOGO

Connections:
3V3: C1.1, C2.1, R1.1, R2.1, SJ1.2, U1.28 (VDD), U$2.18 (3.3V)
!OE: R3.2, U1.23 (#OE)
A5: R12.2, SJ1.1, U1.24 (A5)
C3: R11.1, U1.13 (PWM7)
GND: C1.2, C2.2, C10.P$2, JP1.3, JP2.3, JP3.3, JP4.3, JP5.3, JP6.3, JP7.3, JP8.3, R3.1, R12.1, U1.1 (A0), U1.2 (A1), U1.3 (A2), U1.4 (A3), U1.5 (A4), U1.14 (GND), U1.25 (EXTCLK), U$2.28 (GND)
unnamed: R4.1, U1.6 (PWM0)
unnamed: R5.1, U1.7 (PWM1)
unnamed: R6.1, U1.8 (PWM2)
unnamed: R7.1, U1.9 (PWM3)
unnamed: R8.1, U1.10 (PWM4)
unnamed: R9.1, U1.11 (PWM5)
unnamed: R10.1, U1.12 (PWM6)
PWM0: JP1.1, R4.2
PWM1: JP2.1, R5.2
PWM2: JP3.1, R6.2
PWM3: JP4.1, R7.2
PWM4: JP5.1, R8.2
PWM5: JP6.1, R9.2
PWM6: JP7.1, R10.2
PWM7: JP8.1, R11.2
PWM8: U1.15 (PWM8)
PWM9: U1.16 (PWM9)
PWM10: U1.17 (PWM10)
PWM11: U1.18 (PWM11)
PWM12: U1.19 (PWM12)
PWM13: U1.20 (PWM13)
PWM14: U1.21 (PWM14)
PWM15: U1.22 (PWM15)
SCL: R1.2, U1.26 (SCL), U$2.15 (TXD/SCL)
SDA: R2.2, U1.27 (SDA), U$2.16 (RXD/SDA)
VCC: C10.P$1, JP1.2, JP2.2, JP3.2, JP4.2, JP5.2, JP6.2, JP7.2, JP8.2, U$2.27 (VIN)

Notes on the sheet:
Servo Controller (PCA9685)
Servo Headers
OpenMV

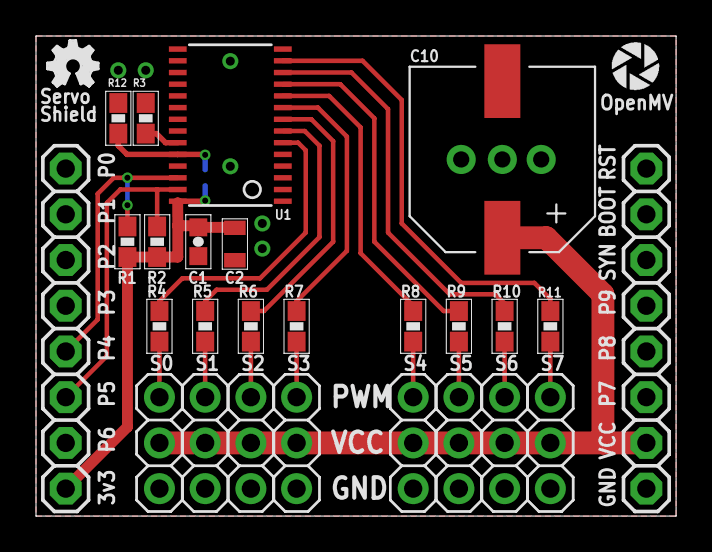
[picture p177: board servo.brd from above]

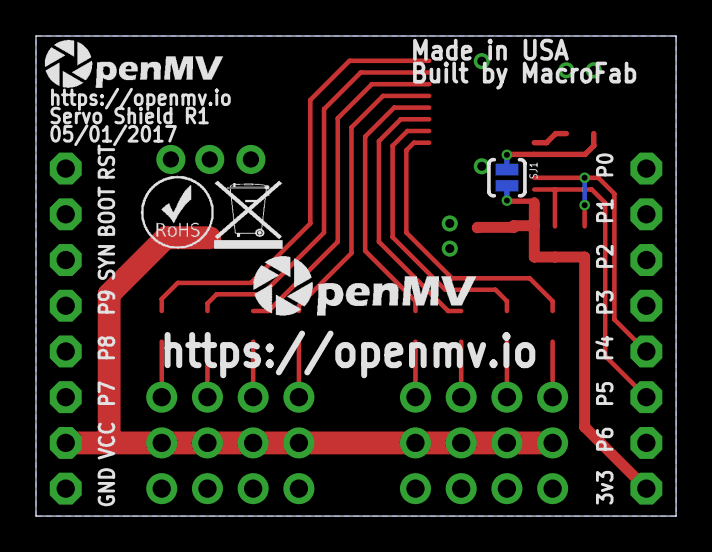
[picture p178: board servo.brd from below]

Board: 2 copper layers, 35.6 x 26.7 mm, 32 parts (5 on the bottom side), 23 nets.

Other parts of the board:
U$3: OMV-LOGO
U$5: ROHS
U$6: WEEE
U$10: OMV-LOGO-SMALL
U$11: OSHW_FILLX100_NOTEXT
