PyCubed-Mini/OpenMV_Camera/openmv-official-repo-for-reference/shields/ble/ble.brd

## EAGLE design openmv-official-repo-for-reference/shields/ble/ble.brd (2019-10-06)

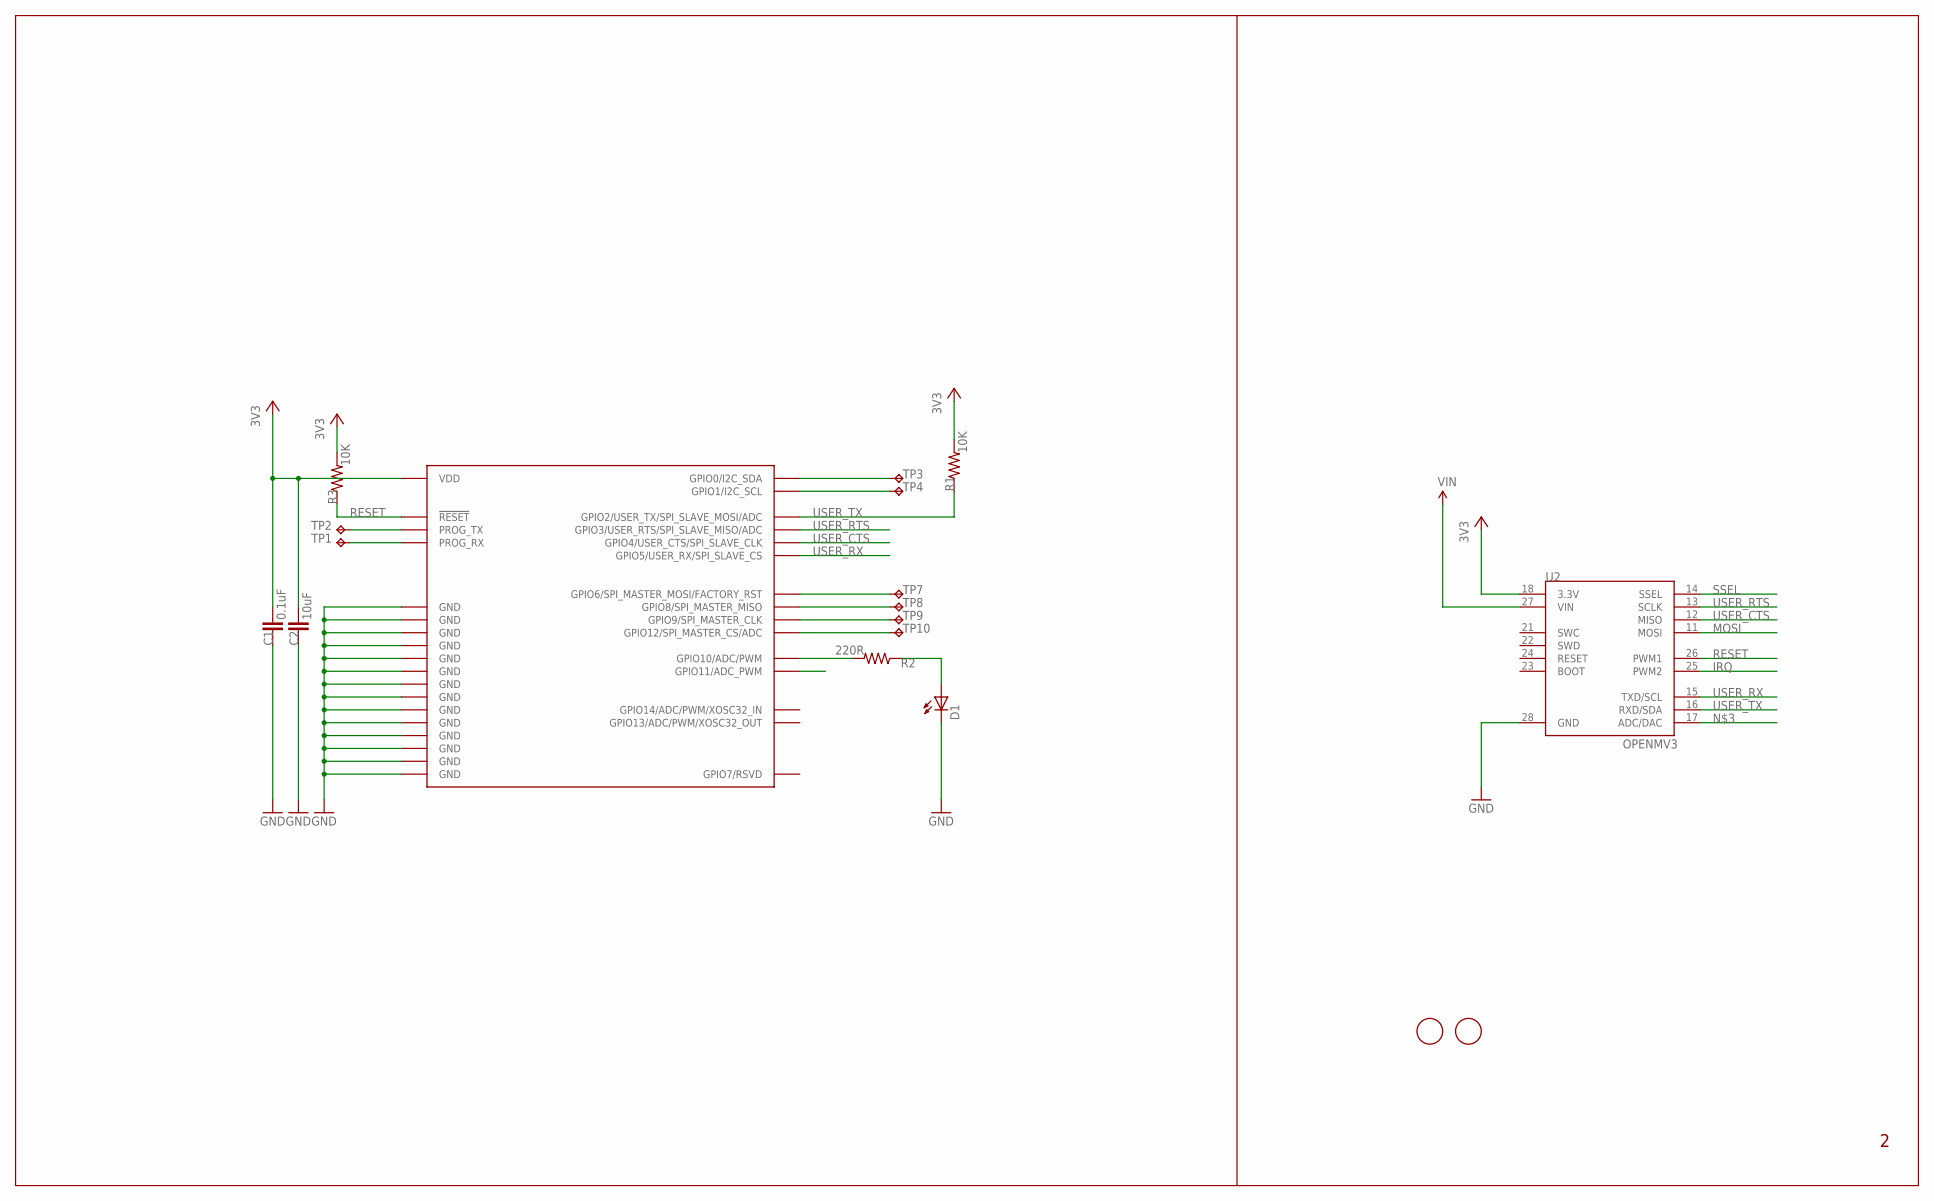
[picture p179: schematic ble.sch]

Parts:
C1: 0.1uF; 0603-CAP
C2: 10uF; 0805
D1: LED0603; LED-0603
R1, R3: 10K; 0603-RES
R2: 220R; 0603-RES
TP1, TP2, TP3, TP4, TP7, TP8, TP9, TP10: TPTP12R; TP12R
U2: OPENMV3
U$1, U$2: FIDUCIAL; FIDUCIAL_1MM
U$3: AMS00X

Connections:
3V3: C1.2, C2.2, R1.2, R3.2, U2.18 (3.3V), U$3.P$21 (VDD)
GND: C1.1, C2.1, D1.C, U2.28 (GND), U$3.P$1 (GND), U$3.P$19 (GND), U$3.P$22 (GND), U$3.P$23 (GND), U$3.P$24 (GND), U$3.P$25 (GND), U$3.P$26 (GND), U$3.P$27 (GND), U$3.P$28 (GND), U$3.P$29 (GND), U$3.P$30 (GND), U$3.P$31 (GND), U$3.P$32 (GND), U$3.P$33 (GND)
IRQ: U2.25 (PWM2)
MOSI: U2.11 (MOSI)
unnamed: TP7.TP, U$3.P$11 (GPIO6/SPI_MASTER_MOSI/FACTORY_RST)
unnamed: TP3.TP, U$3.P$4 (GPIO0/I2C_SDA)
unnamed: TP4.TP, U$3.P$5 (GPIO1/I2C_SCL)
unnamed: TP2.TP, U$3.P$3 (PROG_TX)
unnamed: TP1.TP, U$3.P$2 (PROG_RX)
unnamed: TP8.TP, U$3.P$13 (GPIO8/SPI_MASTER_MISO)
unnamed: TP9.TP, U$3.P$14 (GPIO9/SPI_MASTER_CLK)
unnamed: TP10.TP, U$3.P$17 (GPIO12/SPI_MASTER_CS/ADC)
unnamed: D1.A, R2.1
unnamed: R2.2, U$3.P$15 (GPIO10/ADC/PWM)
RESET: R3.1, U2.26 (PWM1), U$3.P$8 (!RESET)
SSEL: U2.14 (SSEL)
USER_CTS: U2.12 (MISO), U$3.P$9 (GPIO4/USER_CTS/SPI_SLAVE_CLK)
USER_RTS: U2.13 (SCLK), U$3.P$7 (GPIO3/USER_RTS/SPI_SLAVE_MISO/ADC)
USER_RX: U2.15 (TXD/SCL), U$3.P$10 (GPIO5/USER_RX/SPI_SLAVE_CS)
USER_TX: R1.1, U2.16 (RXD/SDA), U$3.P$6 (GPIO2/USER_TX/SPI_SLAVE_MOSI/ADC)
VIN: U2.27 (VIN)

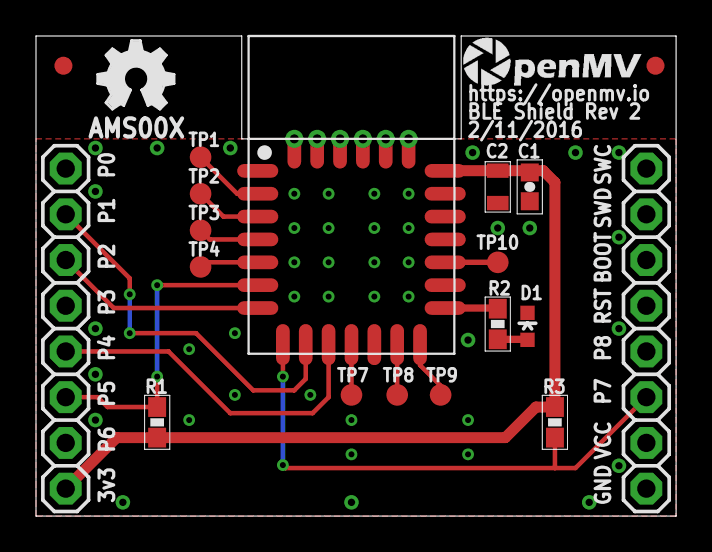
[picture p180: board ble.brd from above]

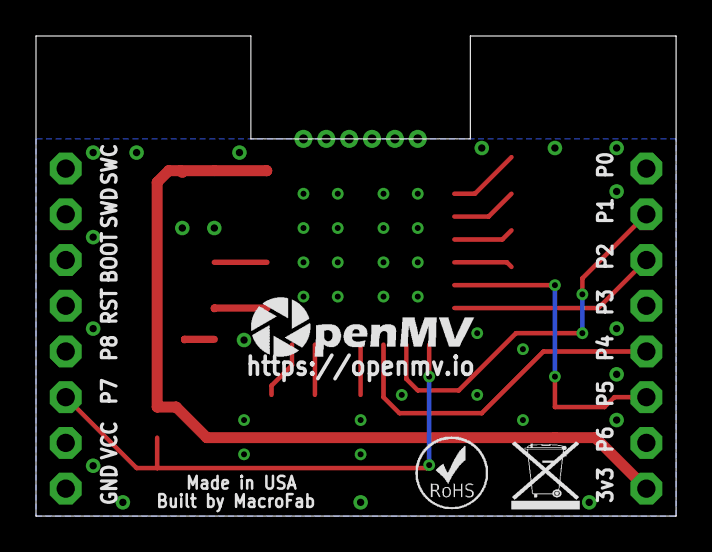
[picture p181: board ble.brd from below]

Board: 2 copper layers, 35.6 x 26.7 mm, 23 parts (3 on the bottom side), 17 nets.

Other parts of the board:
U$4: OMV-LOGO
U$5: OSHW_FILLX150_NOTEXT
U$7: OMV-LOGO-SMALL
U$8: WEEE
U$9: ROHS
