PyCubed-Mini/OpenMV_Camera/openmv-official-repo-for-reference/openmv-sdr/openmv-sdr.brd

## EAGLE design openmv-official-repo-for-reference/openmv-sdr/openmv-sdr.brd (2019-10-06)

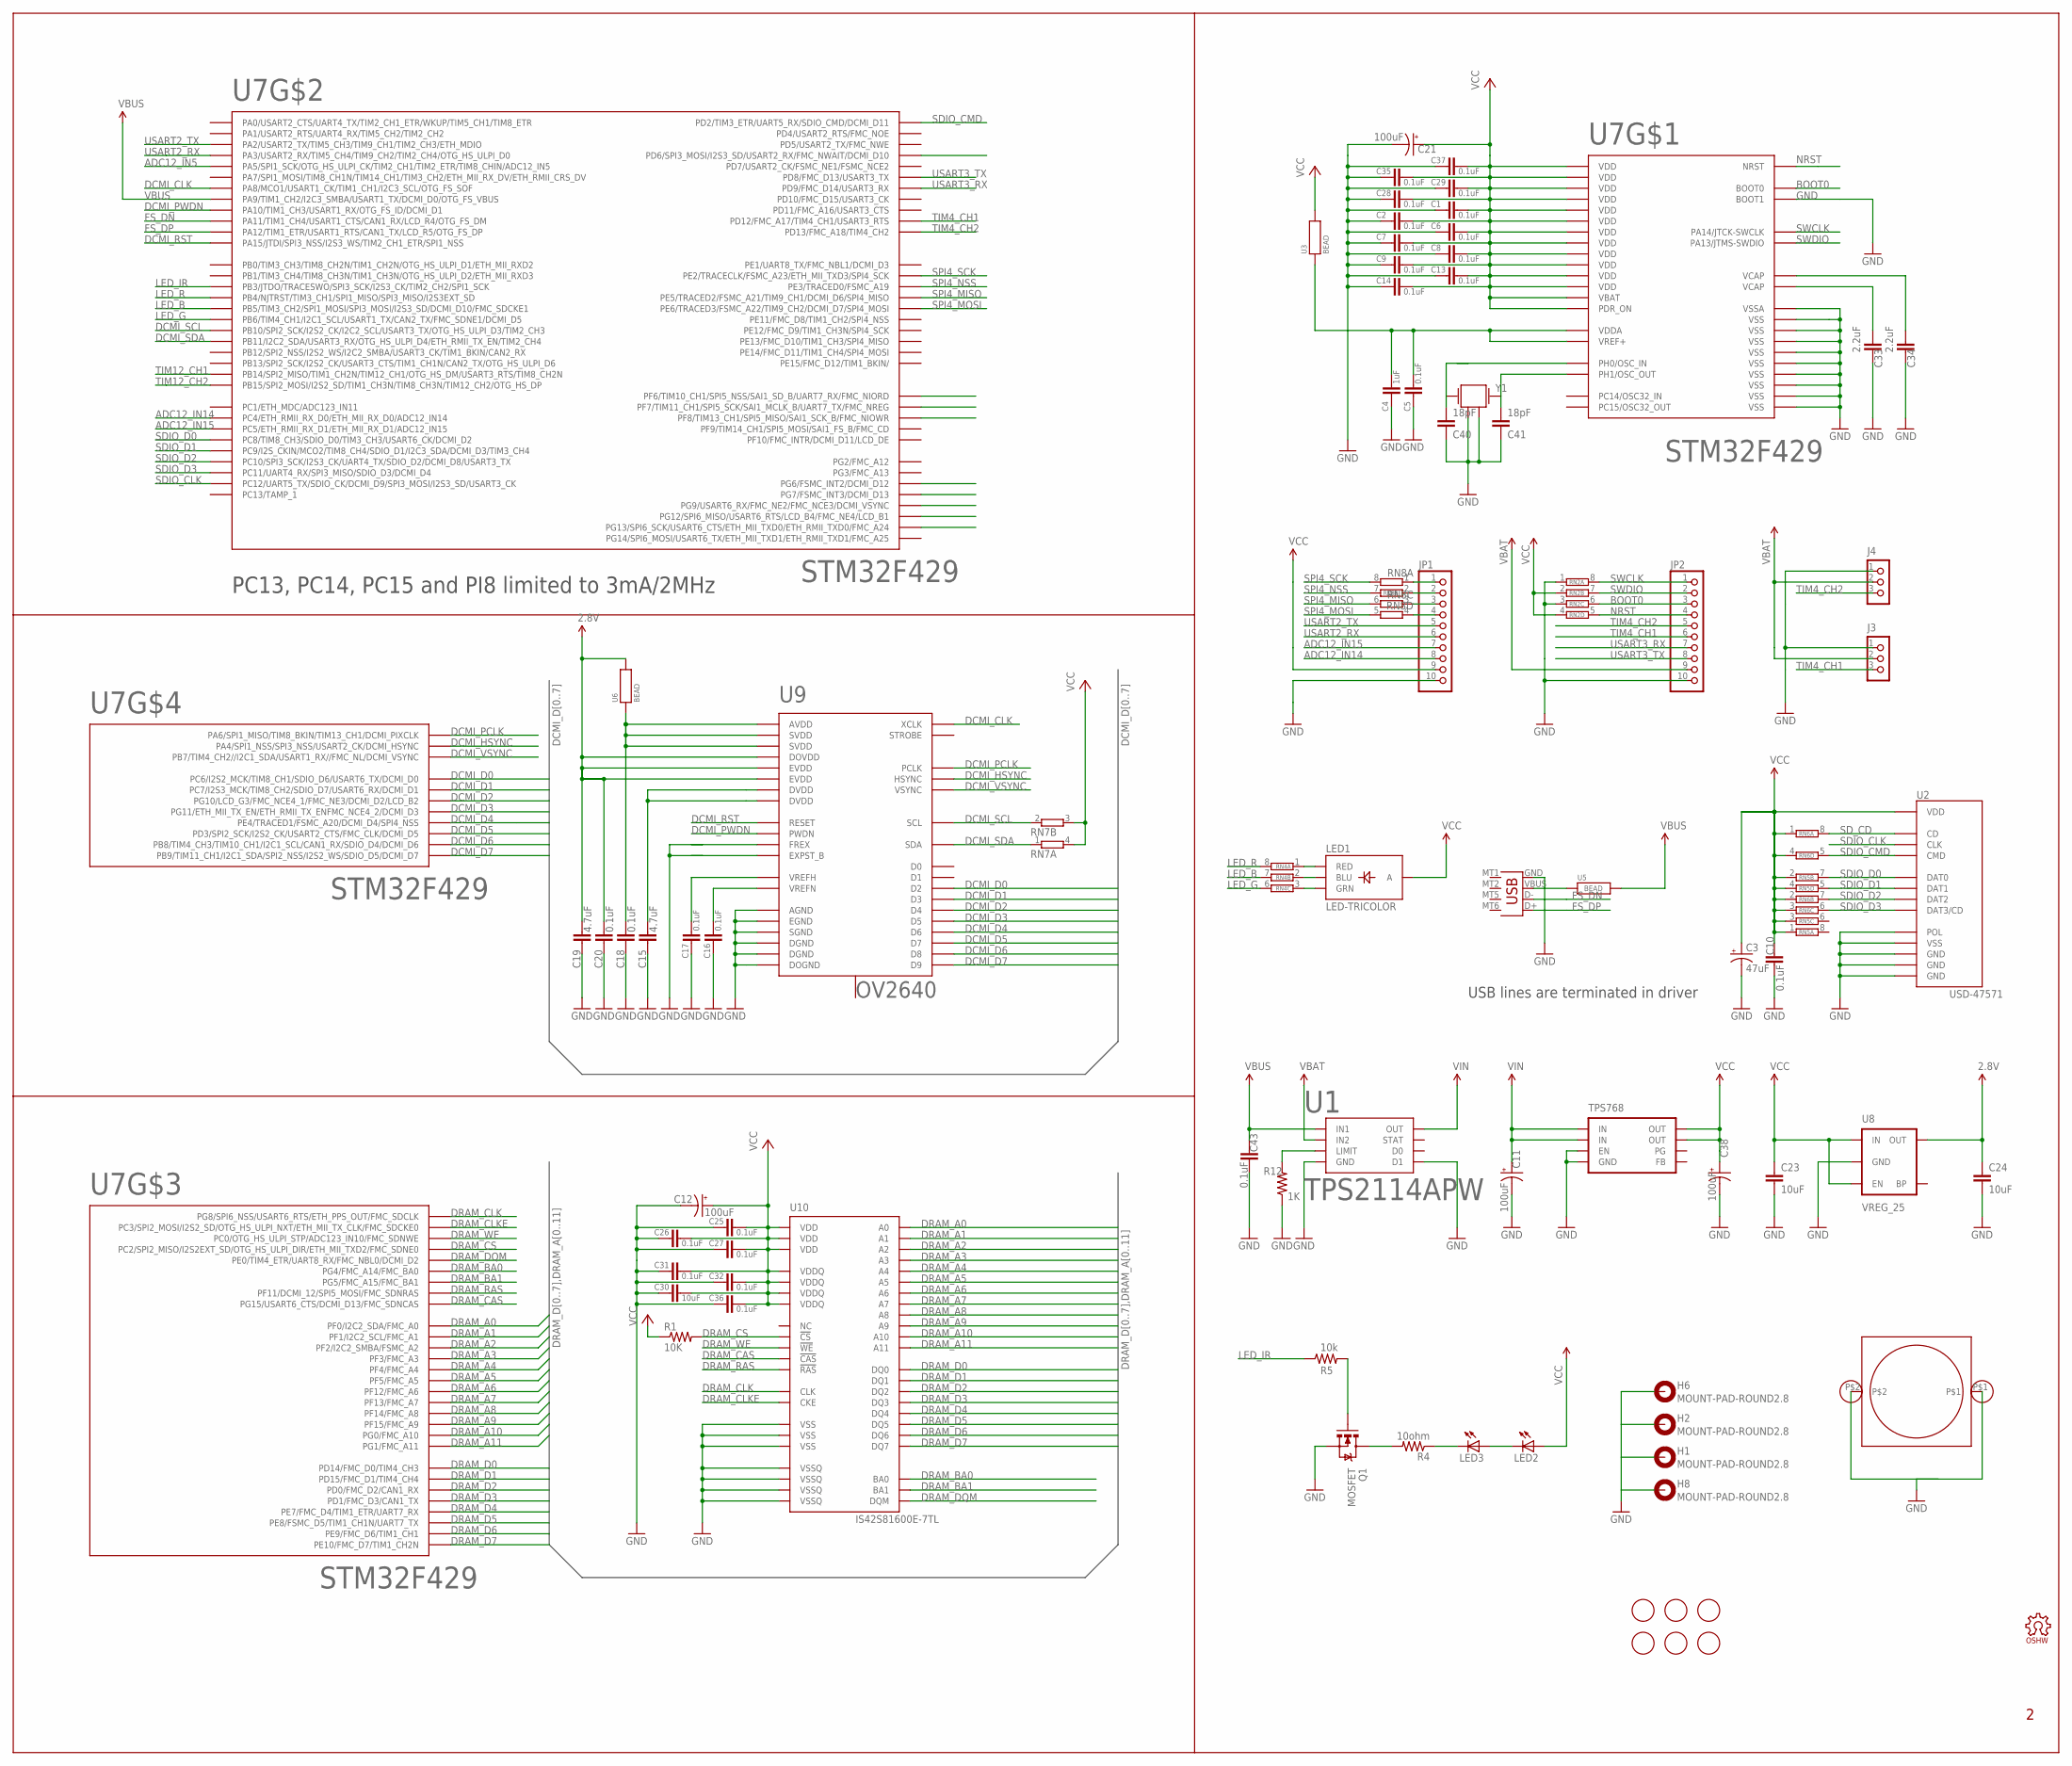
[picture p182: schematic openmv-sdr.sch]

Parts:
C1, C2, C5, C6, C7, C8, C9, C10, C13, C14, C16, C17, C18, C20, C25, C26, C27, C28, C29, C31, C32, C35, C36, C37, C43: 0.1uF; 0402-CAP
C3: 47uF; EIA3216
C4: 1uF; 0402-CAP
C11, C38: 100uF; EIA3528
C12, C21: 100uF; EIA3216
C15, C19: 4.7uF; 0402-CAP
C23, C24: 10uF; 0402-CAP
C30: 10uF; 0805
C33, C34: 2.2uF; 0402-CAP
C40, C41: 18pF; 0402-CAP
H1, H2, H6, H8: MOUNT-PAD-ROUND2.8; 2,8-PAD
J3, J4: CON_HEADER_1X03; M1X3_SMD
JP1, JP2: PINHD-1X10; 1X10
LED1: LED-TRICOLOR; LED-TRICOLOR-SMD
LED2, LED3: LED3MM
LOGO1: OSHW_LOGO_FILLX0200-NT; OSHW_FILLX200_NOTEXT
Q1: MOSFET; SOT23-3
R1: 10K; 0402-RES
R4: 10ohm; 0402-RES
R5: 10k; 0402-RES
R12: 1K; 0402-RES
RN2, RN4, RN5, RN6, RN8: 4R-NCAT16; CAT16
RN7: 2R-NEXBV4V; EXBV4V
U1: TPS2114APW; TSSOP8
U2: USD-47571
U3, U5, U6: BEAD; 0402-CAP
U4: TPS768; SOIC8
U7: STM32F429; LQFP144
U8: VREG_25; SOT23-5
U9: OV2640; CSP2
U10: IS42S81600E-7TL; TSOPII-54
U$1: LENSMOUNT
U$14, U$15, U$16, U$17, U$19, U$20: FIDUCIAL; FIDUCIAL_1MM
X1: USB-MICROB
Y1: CRYSTAL; CRYSTAL3.2X2.5

Connections:
2.8V: C19.1, C20.1, C24.1, U6.2, U8.5 (OUT), U9.B1 (DOVDD), U9.F1 (EVDD), U9.G1 (EVDD)
ADC12_IN5: U7.41 (PA5/SPI1_SCK/OTG_HS_ULPI_CK/TIM2_CH1/TI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)
ADC12_IN14: JP1.8, U7.44 (PC4/ETH_RMII_RX_D0/ETH_MII_RX_D0/ADC12_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)
ADC12_IN15: JP1.7, U7.45 (PC5/ETH_RMII_RX_D1/ETH_MII_RX_D1/ADC12_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)
BOOT0: JP2.3, RN2.6 (2), U7.138 (BOOT0)
DCMI_CLK: U7.100 (PA8/MCO1/USART1_CK/TIM1_CH1/I2C3_SCL/OT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), U9.C4 (XCLK)
DCMI_D0: U7.96 (PC6/I2S2_MCK/TIM8_CH1/SDIO_D6/USART6_TX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), U9.F3 (D2)
DCMI_D1: U7.97 (PC7/I2S3_MCK/TIM8_CH2/SDIO_D7/USART6_RX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), U9.G3 (D3)
DCMI_D2: U7.125 (PG10/LCD_G3/FMC_NCE4_1/FMC_NE3/DCMI_D2/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), U9.F4 (D4)
DCMI_D3: U7.126 (PG11/ETH_MII_TX_EN/ETH_RMII_TX_ENFMC_NC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), U9.G4 (D5)
DCMI_D4: U7.3 (PE4/TRACED1/FSMC_A20/DCMI_D4/SPI4_NSS), U9.E5 (D6)
DCMI_D5: U7.117 (PD3/SPI2_SCK/I2S2_CK/USART2_CTS/FMC_CLK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), U9.G5 (D7)
DCMI_D6: U7.139 (PB8/TIM4_CH3/TIM10_CH1/I2C1_SCL/CAN1_RX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), U9.F5 (D8)
DCMI_D7: U7.140 (PB9/TIM11_CH1/I2C1_SDA/SPI2_NSS/I2S2_WS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), U9.G6 (D9)
DCMI_HSYNC: U7.40 (PA4/SPI1_NSS/SPI3_NSS/USART2_CK/DCMI_HS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), U9.C3 (HSYNC)
DCMI_PCLK: U7.42 (PA6/SPI1_MISO/TIM8_BKIN/TIM13_CH1/DCMI_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), U9.E3 (PCLK)
DCMI_PWDN: U7.102 (PA10/TIM1_CH3/USART1_RX/OTG_FS_ID/DCMI_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), U9.B6 (PWDN)
DCMI_RST: U7.110 (PA15/JTDI/SPI3_NSS/I2S3_WS/TIM2_CH1_ETR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), U9.C6 (RESET)
DCMI_SCL: RN7.2 (1), U7.69 (PB10/SPI2_SCK/I2S2_CK/I2C2_SCL/USART3_T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), U9.C2 (SCL)
DCMI_SDA: RN7.1, U7.70 (PB11/I2C2_SDA/USART3_RX/OTG_HS_ULPI_D4/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), U9.C1 (SDA)
DCMI_VSYNC: U7.137 (PB7/TIM4_CH2//I2C1_SDA/USART1_RX//FMC_N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), U9.D2 (VSYNC)
DRAM_A0: U7.10 (PF0/I2C2_SDA/FMC_A0), U10.23 (A0)
DRAM_A1: U7.11 (PF1/I2C2_SCL/FMC_A1), U10.24 (A1)
DRAM_A2: U7.12 (PF2/I2C2_SMBA/FSMC_A2), U10.25 (A2)
DRAM_A3: U7.13 (PF3/FMC_A3), U10.26 (A3)
DRAM_A4: U7.14 (PF4/FMC_A4), U10.29 (A4)
DRAM_A5: U7.15 (PF5/FMC_A5), U10.30 (A5)
DRAM_A6: U7.50 (PF12/FMC_A6), U10.31 (A6)
DRAM_A7: U7.53 (PF13/FMC_A7), U10.32 (A7)
DRAM_A8: U7.54 (PF14/FMC_A8), U10.33 (A8)
DRAM_A9: U7.55 (PF15/FMC_A9), U10.34 (A9)
DRAM_A10: U7.56 (PG0/FMC_A10), U10.22 (A10)
DRAM_A11: U7.57 (PG1/FMC_A11), U10.35 (A11)
DRAM_BA0: U7.89 (PG4/FMC_A14/FMC_BA0), U10.20 (BA0)
DRAM_BA1: U7.90 (PG5/FMC_A15/FMC_BA1), U10.21 (BA1)
DRAM_CAS: U7.132 (PG15/USART6_CTS/DCMI_D13/FMC_SDNCAS), U10.17 (!CAS)
DRAM_CLK: U7.93 (PG8/SPI6_NSS/USART6_RTS/ETH_PPS_OUT/FMC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), U10.38 (CLK)
DRAM_CLKE: U7.29 (PC3/SPI2_MOSI/I2S2_SD/OTG_HS_ULPI_NXT/E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), U10.37 (CKE)
DRAM_CS: R1.2, U7.28 (PC2/SPI2_MISO/I2S2EXT_SD/OTG_HS_ULPI_DI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), U10.19 (!CS)
DRAM_D0: U7.85 (PD14/FMC_D0/TIM4_CH3), U10.2 (DQ0)
DRAM_D1: U7.86 (PD15/FMC_D1/TIM4_CH4), U10.5 (DQ1)
DRAM_D2: U7.114 (PD0/FMC_D2/CAN1_RX), U10.8 (DQ2)
DRAM_D3: U7.115 (PD1/FMC_D3/CAN1_TX), U10.11 (DQ3)
DRAM_D4: U7.58 (PE7/FMC_D4/TIM1_ETR/UART7_RX), U10.44 (DQ4)
DRAM_D5: U7.59 (PE8/FSMC_D5/TIM1_CH1N/UART7_TX), U10.47 (DQ5)
DRAM_D6: U7.60 (PE9/FMC_D6/TIM1_CH1), U10.50 (DQ6)
DRAM_D7: U7.63 (PE10/FMC_D7/TIM1_CH2N), U10.53 (DQ7)
DRAM_DQM: U7.141 (PE0/TIM4_ETR/UART8_RX/FMC_NBL0/DCMI_D2), U10.39 (DQM)
DRAM_RAS: U7.49 (PF11/DCMI_12/SPI5_MOSI/FMC_SDNRAS), U10.18 (!RAS)
DRAM_WE: U7.26 (PC0/OTG_HS_ULPI_STP/ADC123_IN10/FMC_SDN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), U10.16 (!WE)
FS_DN: U7.103 (PA11/TIM1_CH4/USART1_CTS/CAN1_RX/LCD_R4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), X1.D-
FS_DP: U7.104 (PA12/TIM1_ETR/USART1_RTS/CAN1_TX/LCD_R5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), X1.D+
GND: C1.2, C2.2, C3.C (-), C4.2, C5.2, C6.2, C7.2, C8.2, C9.2, C10.2, C11.C (-), C12.C (-), C13.2, C14.2, C15.2, C16.2, C17.2, C18.2, C19.2, C20.2, C21.C (-), C23.2, C24.2, C25.2, C26.2, C27.2, C28.1, C29.2, C30.2, C31.2, C32.2, C33.2, C34.2, C35.2, C36.2, C37.2, C38.C (-), C40.1, C41.1, C43.2, H1.B2,8, H2.B2,8, H6.B2,8, H8.B2,8, J3.1, J4.1, JP1.10, JP2.10, Q1.2 (S), R12.1, RN2.1, RN2.3 (1), U1.3 (D1), U1.5 (GND), U2.G$1 (GND), U2.G$2 (GND), U2.G$3 (GND), U2.G$4 (POL), U2.P$6 (VSS), U4.1 (GND), U4.2 (EN), U7.16 (VSS), U7.31 (VSSA), U7.38 (VSS), U7.48 (BOOT1), U7.51 (VSS), U7.61 (VSS), U7.83 (VSS), U7.94 (VSS), U7.107 (VSS), U7.120 (VSS), U7.130 (VSS), U8.2 (GND), U9.A1 (DOGND), U9.A2 (EXPST_B), U9.A3 (AGND), U9.A4 (SGND), U9.B2 (FREX), U9.E4 (EGND), U9.E6 (DGND), U9.G2 (DGND), U10.6 (VSSQ), U10.12 (VSSQ), U10.28 (VSS), U10.41 (VSS), U10.46 (VSSQ), U10.52 (VSSQ), U10.54 (VSS), U$1.P$1, U$1.P$2, X1.GND, Y1.2, Y1.4
LED_B: RN4.7 (2), U7.135 (PB5/TIM3_CH2/SPI1_MOSI/SPI3_MOSI/I2S3_S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)
LED_G: RN4.6 (2), U7.136 (PB6/TIM4_CH1/I2C1_SCL/USART1_TX/CAN2_TX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)
LED_IR: R5.1, U7.133 (PB3/JTDO/TRACESWO/SPI3_SCK/I2S3_CK/TIM2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)
LED_R: RN4.8 (2), U7.134 (PB4/NJTRST/TIM3_CH1/SPI1_MISO/SPI3_MISO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)
unnamed: C17.1, U9.C5 (VREFH)
unnamed: C40.2, U7.23 (PH0/OSC_IN), Y1.3 (2)
unnamed: C16.1, U9.A5 (VREFN)
unnamed: C41.2, U7.24 (PH1/OSC_OUT), Y1.1
unnamed: Q1.1 (G), R5.2
unnamed: C15.1, U9.F2 (DVDD), U9.F6 (DVDD)
unnamed: C4.1, C5.1, U3.1, U7.32 (VREF+), U7.33 (VDDA)
unnamed: LED1.R (RED), RN4.1
unnamed: LED1.G (GRN), RN4.3 (1)
unnamed: LED3.K (C), R4.1
unnamed: LED1.B (BLU), RN4.2 (1)
unnamed: C18.1, U6.1, U9.B3 (AVDD), U9.B4 (SVDD), U9.B5 (SVDD)
unnamed: Q1.3 (D), R4.2
unnamed: LED2.K (C), LED3.A
unnamed: JP1.1, RN8.1
unnamed: JP1.2, RN8.2 (1)
unnamed: U5.1, X1.VBUS
unnamed: JP1.3, RN8.3 (1)
unnamed: JP1.4, RN8.4 (1)
unnamed: R12.2, U1.4 (LIMIT)
NRST: JP2.4, RN2.5 (2), U7.25 (NRST)
SDIO_CLK: U2.P$5 (CLK), U7.113 (PC12/UART5_TX/SDIO_CK/DCMI_D9/SPI3_MOSI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)
SDIO_CMD: RN6.5 (2), U2.P$3 (CMD), U7.116 (PD2/TIM3_ETR/UART5_RX/SDIO_CMD/DCMI_D11)
SDIO_D0: RN5.7 (2), U2.P$7 (DAT0), U7.98 (PC8/TIM8_CH3/SDIO_D0/TIM3_CH3/USART6_CK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)
SDIO_D1: RN5.5 (2), U2.P$8 (DAT1), U7.99 (PC9/I2S_CKIN/MCO2/TIM8_CH4/SDIO_D1/I2C3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)
SDIO_D2: RN6.7 (2), U2.P$1 (DAT2), U7.111 (PC10/SPI3_SCK/I2S3_CK/UART4_TX/SDIO_D2/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)
SDIO_D3: RN6.6 (2), U2.P$2 (DAT3/CD), U7.112 (PC11/UART4_RX/SPI3_MISO/SDIO_D3/DCMI_D4)
SD_CD: RN6.8 (2), U2.G$5 (CD), U7.124 (PG9/USART6_RX/FMC_NE2/FMC_NCE3/DCMI_VSY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)
SPI4_MISO: RN8.6 (2), U7.4 (PE5/TRACED2/FSMC_A21/TIM9_CH1/DCMI_D6/S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)
SPI4_MOSI: RN8.5 (2), U7.5 (PE6/TRACED3/FSMC_A22/TIM9_CH2/DCMI_D7/S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)
SPI4_NSS: RN8.7 (2), U7.2 (PE3/TRACED0/FSMC_A19)
SPI4_SCK: RN8.8 (2), U7.1 (PE2/TRACECLK/FSMC_A23/ETH_MII_TXD3/SPI4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)
SWCLK: JP2.1, RN2.8 (2), U7.109 (PA14/JTCK-SWCLK)
SWDIO: JP2.2, RN2.7 (2), U7.105 (PA13/JTMS-SWDIO)
TIM4_CH1: J3.3, JP2.6, U7.81 (PD12/FMC_A17/TIM4_CH1/USART3_RTS)
TIM4_CH2: J4.3, JP2.5, U7.82 (PD13/FMC_A18/TIM4_CH2)
TIM12_CH1: U7.75 (PB14/SPI2_MISO/TIM1_CH2N/TIM12_CH1/OTG_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)
TIM12_CH2: U7.76 (PB15/SPI2_MOSI/I2S2_SD/TIM1_CH3N/TIM8_C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)
USART2_RX: JP1.6, U7.37 (PA3/USART2_RX/TIM5_CH4/TIM9_CH2/TIM2_CH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)
USART2_TX: JP1.5, U7.36 (PA2/USART2_TX/TIM5_CH3/TIM9_CH1/TIM2_CH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)
USART3_RX: JP2.7, U7.78 (PD9/FMC_D14/USART3_RX)
USART3_TX: JP2.8, U7.77 (PD8/FMC_D13/USART3_TX)
VBAT: J3.2, J4.2, JP2.9, U1.6 (IN2)
VBUS: C43.1, U1.8 (IN1), U5.2, U7.101 (PA9/TIM1_CH2/I2C3_SMBA/USART1_TX/DCMI_D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)
VCAP1: C34.1, U7.71 (VCAP)
VCAP2: C33.1, U7.106 (VCAP)
VCC: C1.1, C2.1, C3.A (+), C6.1, C7.1, C8.1, C9.1, C10.1, C12.A (+), C13.1, C14.1, C21.A (+), C23.1, C25.1, C26.1, C27.1, C28.2, C29.1, C30.1, C31.1, C32.1, C35.1, C36.1, C37.1, C38.A (+), JP1.9, LED1.A, LED2.A, R1.1, RN2.2 (1), RN2.4 (1), RN5.1, RN5.2 (1), RN5.3 (1), RN5.4 (1), RN6.1, RN6.2 (1), RN6.3 (1), RN6.4 (1), RN7.3 (2), RN7.4 (2), U2.P$4 (VDD), U3.2, U4.5 (OUT), U4.6 (OUT), U7.6 (VBAT), U7.17 (VDD), U7.30 (VDD), U7.39 (VDD), U7.52 (VDD), U7.62 (VDD), U7.72 (VDD), U7.84 (VDD), U7.95 (VDD), U7.108 (VDD), U7.121 (VDD), U7.131 (VDD), U7.143 (PDR_ON), U7.144 (VDD), U8.1 (IN), U8.3 (EN), U10.1 (VDD), U10.3 (VDDQ), U10.9 (VDDQ), U10.14 (VDD), U10.27 (VDD), U10.43 (VDDQ), U10.49 (VDDQ)
VIN: C11.A (+), U1.7 (OUT), U4.3 (IN), U4.4 (IN)

Notes on the sheet:
PC13, PC14, PC15 and PI8 limited to 3mA/2MHz
USB lines are terminated in driver

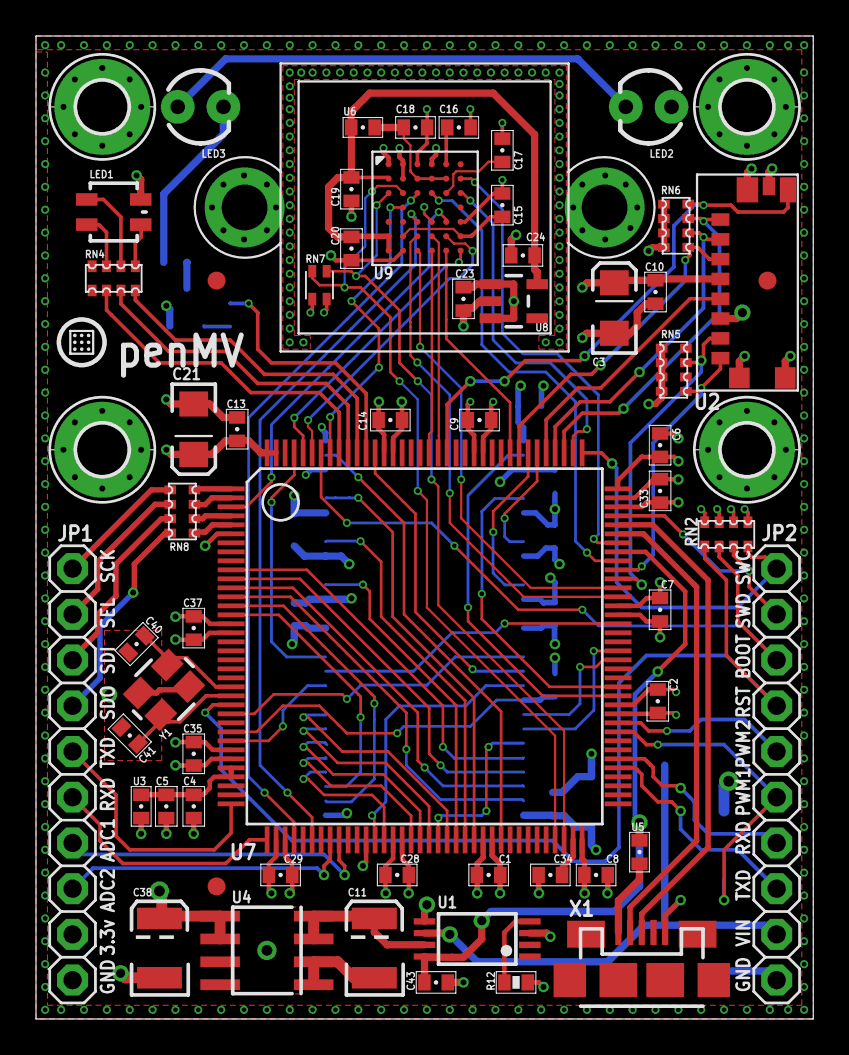
[picture p183: board openmv-sdr.brd from above]

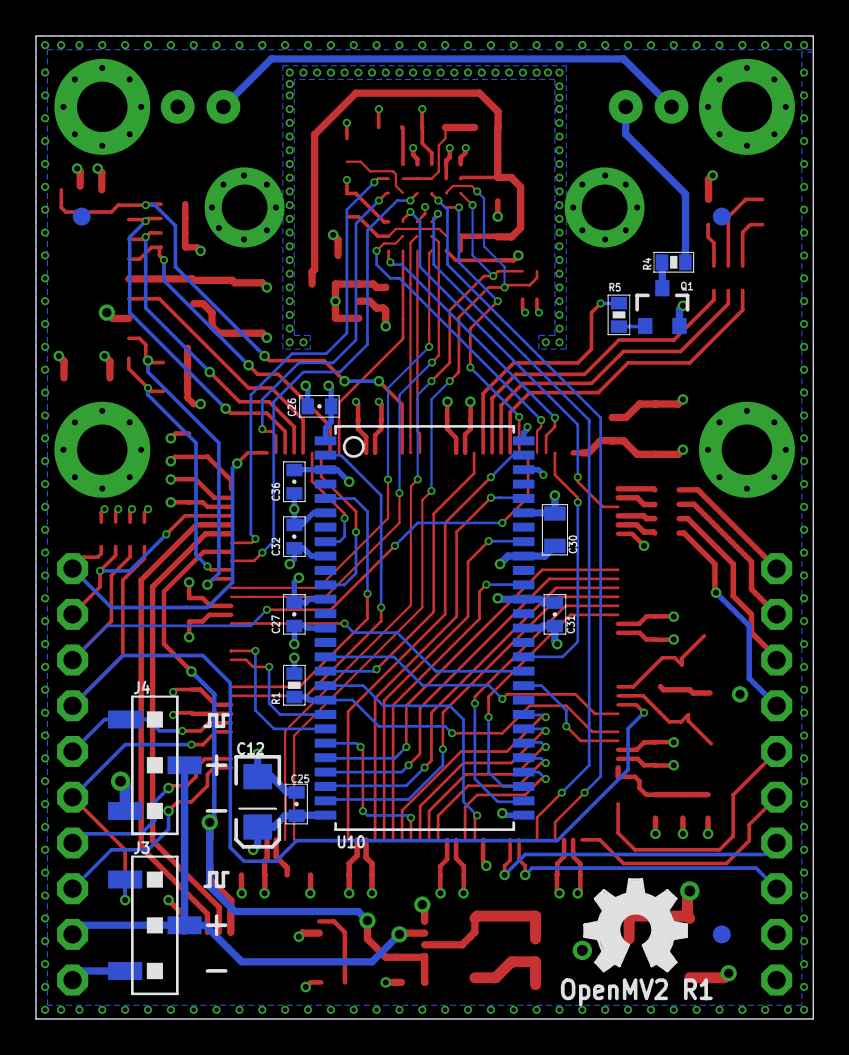
[picture p184: board openmv-sdr.brd from below]

Board: 4 copper layers, 43.2 x 54.6 mm, 82 parts (19 on the bottom side), 102 nets.
