PyCubed-Mini/OpenMV_Camera/(commit log)

2019-10-07 Imported into KiCAD
    [LEPTON.sch, OpenMV4_Layout1.kicad_pcb, OpenMV4_Layout1.sch, base.sch]
2019-10-07 Swapped image sensor connector to opposite side
    [base.kicad_pcb]
2019-10-07 Deleted connections, moved camera
2019-10-11 Added current version of main camera code
    This is the third draft of the code, which:
    - Uses a red light to indicate an attempted SPI connection to the MCU
    - Treats the camera as a SLAVE to the MCU, making it wait for an input from its MASTER before continuing
    - Times out if it does not receive an input in five seconds
    - Uses a blue light to simulate a camera flash
    - Take a snapshot at the end, if all above conditions are satisfied
    This code runs once per call from the MCU.
2019-10-11 Added main and original Trinket M0 MCU codes
    - Main code is current MASTER to camera SLAVE
    - Features color rotation as an indicator that the code is working
    - Original trinket code to be used to determine if the board needs to be reset
    [trinket_m0_main.py, trinket_m0_original.py]
2019-10-11 Created trinket_m0_backup folder and README.txt
    This folder is a backup of the default Trinket M0 software package, to be used if the board needs to be reset.
2019-10-11 Added "images" folder and its contents
    Contains sample images taken by the camera
2019-10-11 Added "references" folder and documentation
    Currently only contains the documentation for the Trinket M0, which is the only resource to trust for the pin allocations on that particular MCU
2019-10-13 Found diffs MV3 to MV4 for direct mount
    [base.kicad_pcb, base.sch, openmv3.kicad_pcb, openmv3.sch]
2019-10-14 Added OV775 symbol to global lib
    [LEPTON.sch, OpenMV4_Camera_direct_mount.kicad_pcb, OpenMV4_Camera_direct_mount.sch, base.kicad_pcb, base.sch]
2019-10-14 put ov775 into v4, started connections
    [OpenMV4_Camera_direct_mount.kicad_pcb, OpenMV4_Camera_direct_mount.sch, base.kicad_pcb, base.sch]
2019-10-14 More changes to direct mount schem
    [base.sch]
2019-10-14 Listed more differences v3 to v4
    [base.sch]
2019-10-15 Updated snap_on_trigger.py
    This version is capable of receiving communication from the microcontroller, communicating back to the microcontroller, and taking a snapshot on command.
    [snap_on_trigger.py]
2019-10-15 Updated trinket_mo_main.py
    This version is better at communicating to and from the OpenMV camera.
2019-10-16 Added Photo Series: Calibration
    Three folders in this commit:
    - Actual Photos is the one you probably care about
    - Calibration features some calibration pictures and the spectrum I defined to calibrate the camera focus
    - Focus play just has some snapshots of the camera at different focus settings
2019-10-16 Fixed camera mount hole links
    [base.kicad_pcb]
2019-10-17 Changes to KiCAD
    [base.kicad_pcb, base.sch, basev2.kicad_pcb]
2019-10-17 Fixed cam position
    [base.kicad_pcb, base.sch]
2019-10-21 Connecting key components
    [base.kicad_pcb, base.sch]
2019-10-22 Added current main Feather M4 Express MCU code
    Highly derivative of Trinket M0 MCU code, but with modified CS, featuring:
    - Rainbow light show
    - Camera as only SLAVE
2019-10-22 Connected LED's
    [base.kicad_pcb]
2019-10-22 Made several connects
    [base.kicad_pcb]
2019-10-22 Added Time Delay Trade Images
    This folder currently includes:
    1) A preparation delay trade, which seeks to identify the smallest amount of time the camera needs to prepare to take pictures
    2) A processing delay trade, which seeks to identify the smallest amount of time the camera needs to process pictures
2019-10-22 Added QVGA Suffix Trade Study
    The goal of this study was to identify which image file suffix could maximize the image quality. However, it was determined the the OpenMV camera is incapable of saving VGA images with any suffix other than JPG. Hence, this trade study only includes suffices for QVGA images.
2019-10-22 Added connector to schematic
    [base.kicad_pcb, base.sch]
2019-10-23 Finished connecting main components
    [base.kicad_pcb, base.sch]
2019-10-23 Added connector
    [LEPTON.sch, base.kicad_pcb, base.sch]
2019-10-23 Made basev2 with more clearance for camera to SD card
    [base.kicad_pcb]
2019-10-23 Cleaned up snap_on_trigger.py
    Added comments and increased readability of module
    Content did not change significantly
    [snap_on_trigger.py]
2019-10-23 Enabled Multi-SPI Comms; Cleaned Up Code
    Modified SPI software to accommodate overhaul to hardware interfacing.
    The MCU can now accommodate both the camera and an SD card breakout board.
    Remember to rename this file to main.py if you're using it on an actual Feather M4 Express.
2019-10-23 Added spi_troubleshooter.py
    This code, a descendant of snap_on_trigger.py, contains an infinite loop to enable continued communication with the MCU. Very useful for debugging and analyzing if and how the SPI messages change over time. I recommend keeping this on while testing with the MCU, if possible.
    [spi_troubleshooter.py]
2019-10-24 Added pwr enable, fixed reg
    [base.kicad_pcb, base.sch]
2019-10-25 Fixed clearance issue
    [base.kicad_pcb, base.sch]
2019-10-28 Added Manual Blindness Trade
    This blindness trade completes the series of trade studies for the first OpenMV camera.
    "Blindness" is defined as the time required for the camera to "open its eye"—that is, how much time is alloted for new settings to take place after the camera resets. With insufficient "blindness" time, the images may become dark or corrupted. With too much "blindness" time, the Qube wastes power. An optimum must be found to trade security of image saving and power consumption.
    Findings:
    - Below 1000 ms of "blindness," the image files corrupt and cannot save properly
    - Below 3000 ms of "blindness," the camera has insufficient heap memory to take quality=90 JPEG images,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
2019-10-28 Reorganized Some Folders
    Most important folders are now top-level; less important folders have been demoted to lower levels.
    "Calibration" and "Calibrated Pics" have been consolidated into one folder.
2019-10-30 Tidied folder
    [base-B_Mask.gbr, base-B_Paste.gbr, base-B_SilkS.gbr, base-Bottom.gbr, base-Edge_Cuts.gbr, base-F_Mask.gbr, base-F_Paste.gbr, base-F_SilkS.gbr]
2019-10-30 Added more 3d models
    [base.kicad_pcb]
2019-10-30 Added MCU and other CAD models
    [base.kicad_pcb]
2019-10-31 Folder Tidy
    [BOM.ods, LEPTON.brd, LEPTON.sch, MT9V034.brd, MT9V034.sch, OV7725.brd, OV7725.sch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]
2019-10-31 Added "Save to SD Experiments"
    This chronicles each stage of the suffering process involved in getting the camera to take a picture and send it to the MCU so that the MCU could save it to the SD card. Provided for reference.
2019-10-31 Updated Camera and Feather M4 main.py Files
    New features in the latest software update:
    1) Upon activation, the camera takes a picture
    2) The MCU asks the camera if it's ready to send the picture
    3) The Camera replies with the size of the picture
    4) The MCU prepares to receive the picture
    5) The camera sends the picture
    6) The MCU receives it and saves it to the SD card
    Other features are present but are commented out.
2019-11-01 Catching remote up
    [473521001_microSD.stp, base.kicad_pcb]
2019-11-05 Updated to do list
    [basev2.kicad_pcb]
2019-11-15 catch up
    [base-B_Mask.gbr, base-B_Paste.gbr, base-B_SilkS.gbr, base-Bottom.gbr, base-Edge_Cuts.gbr, base-F_Mask.gbr, base-F_Paste.gbr, base-F_SilkS.gbr]
2019-11-15 Dxf file of the internal board cutout.
    [11-14-19 Internal boards.dxf]
2019-11-17 Added new outline, working on layout issues
    [Board Dims V1.dxf, Board Dims V2.dxf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]
2019-11-17 Tidy up of files
    [Board Dims V1.dxf, Internal boards.dxf]
2019-11-17 Moved SD card
    [11-14-19 Internal boards.dxf, Board Outline.dxf, base.kicad_pcb]
2019-11-17 Move USB to cam side, more SD card changes
    [base.kicad_pcb]
2019-11-17 Fixed connections to debug headers
    [base.kicad_pcb]
2019-11-17 flat flex moved
    [base.kicad_pcb]
2019-11-17 Fixed Silk
    [base.kicad_pcb]
2019-12-02 Starting V3 (using MV4 style connector)
    [base-B_Mask.gbr, base-B_Paste.gbr, base-B_SilkS.gbr, base-Bottom.gbr, base-Edge_Cuts.gbr, base-F_Mask.gbr, base-F_Paste.gbr, base-F_SilkS.gbr]
2019-12-02 Switched shcematic to have connector
    [base.kicad_pcb, base.sch]
2019-12-02 Tidying tracks and fixing routing issues
    [base.kicad_pcb]
2019-12-02 Connections fixed
    [base.kicad_pcb]
2019-12-05 Added Electrical Configuration
    This folder contains images that should be helpful for replicating the electrical configuration used to connect the OpenMV camera, the Feather M4 Express MCU, and the mSD card breakout board.
2019-12-05 Created README.txt
    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
2019-12-09 Moved the flat flex connector to suit main board design
    [base.kicad_pcb, base.sch, basev2.kicad_pcb, temp_img_connector.sch]
2019-12-09 Slight tidy up of traces
    [base.kicad_pcb]
2019-12-10 connector location and board clean up
    [base.kicad_pcb]
2019-12-10 more clean up
    [base.kicad_pcb]
2019-12-12 changed board outline per design session with @ellised
    [base.kicad_pcb, base.step]
2019-12-12 3D models and board thickness
    [base.kicad_pcb]
2020-01-19 v01 design files
    [base-B_Mask.gbr, base-B_Paste.gbr, base-B_SilkS.gbr, base-Bottom.gbr, base-Edge_Cuts.gbr, base-F_Mask.gbr, base-F_Paste.gbr, base-F_SilkS.gbr]
2020-02-18 Added images of camera focusing test
2020-02-26 moved camera connector and rerouted PCB
    [base.kicad_pcb]
2020-03-01 added fiducials, regenerated 3d model and gerbers
    [base-B.Mask.gbr, base-B.Paste.gbr, base-B.SilkS.gbr, base-B_Mask.gbr, base-B_Paste.gbr, base-B_SilkS.gbr, base-Bottom.gbr, base-Edge.Cuts.gbr]
