PyCubed-Mini/OpenMV_Camera/(notices)

Notices in the files:
openmv-official-repo-for-reference/shields/servo/servo.sch:
Copyright (c) 2017 OpenMV LLC
This work is licensed under the Creative Commons Attribution-ShareAlike 4.0 License.
To view a copy of this license, visit http://creativecommons.org/licenses/by-sa/4.0
openmv-official-repo-for-reference/shields/can/can.sch:
Copyright (c) 2019 OpenMV LLC
openmv-official-repo-for-reference/openmv4/sensors/MT9V034/MT9V034.sch:
Copyright (c) 2018 OpenMV
openmv-official-repo-for-reference/shields/tv/tv.sch:
Copyright (c) 2019 kaizhi
parts and their libraries:
SparkFun-PowerIC: Licensing: Creative Commons ShareAlike 4.0 International - https://creativecommons.org/licenses/by-sa/4.0
sfe: Licensing: CC v3.0 Share-Alike You are welcome to use this library for commercial purposes.
